NewEconoLab/NeoDun/驱动程序与钱包/neoHardWallet/driver_win/res/back.jpg

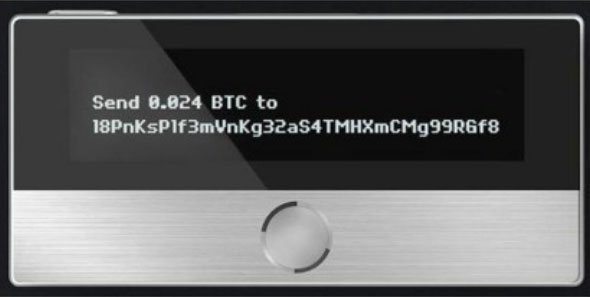
驱动程序与钱包/neoHardWallet/driver_win/res/back.jpg
