NewEconoLab/NeoDun/单片机程序/COIN/NEO/ATSHA204/readme.txt

/****************************************Copyright (c)**************************************************
**文   件   名: readme.txt
**创   建   人: hkh
**最后修改日期: 2018年01月29日
**要点记录：		

		***** 这个工程实现该芯片的普通读写，由于库版本不同，加密读写未实现 *****

一 调试
	①	调试IIC
	②	唤醒设备
	③	设置配置区
	④	写入和读取数据，看是否一致
二 芯片说明
	1  芯片有16个slot，每个slot存放32字节；在config区lock之后，data区（slot区和OTP区）lock之前，
	只能写slot区而不能读。在config区和data区都lock之后，按照config区对于slot区的访问权限进行读写。
	2  wake up成功会收到 04 11 33 43
		其它操作成功会收到 04 00 03 40
	3  锁定后，可以读取Config的0x15区(User Extra)，锁定的值会由0x55变成0x00，表示该区被锁定
	4  config配置区如下:
			0-5  0xCF4F  存放用户私钥和一个PIN码和标识共存的槽
			6-14 0x0000  随意读写区域
			15   0x8F8F  存放加密读写用的私钥			
**修改记录：	
	1、修改software_i2c_quarter_period的实际延时时间为4us
	2、修改初始化函数，加入IIC地址的初始化

/*******************************************************************************************************

				***** 进行加密读写移植记录 *****
时间：2018 03 04
记录：
	1 修改IIC

********************************************************************************************************/
