NewEconoLab/NeoDun/驱动程序与钱包/驱动接口文档.docx

host：127.0.0.1

port:50288

查询硬件钱包是否连接：

地址：http://127.0.0.1:50288/_api/state

请求方式：get

入参：无

出参：{tag:int,count:int,type:string}

tag是回复的消息码

count是连接上的钱包的个数

type是连接上的钱包的类型（现在固定为“hid”）

获取钱包地址列表：

地址：http://127.0.0.1:50288/_api/ HYPERLINK "http://127.0.0.1:50288/_api/listaddress"listaddress

请求方式：get

入参：无

出参：{tag:int,addresses:Array<{type:string,address:string}>}

参数说明： addresses是地址列表 是一个jsonArray

增加地址：

地址：http://127.0.0.1:50288/_api/ HYPERLINK "http://127.0.0.1:50288/_api/addaddress"addaddress

请求方式：post||get

入参：wif:string

出参：{tag:int,msg:string}

参数说明：wif是要加的地址的wif码 KyKvWLZsNwBJx5j9nurHYRwhYfdQUu9tTEDsLCUHDbYBL8cHxMiG

msg是回复的成功还是失败

删除地址：

地址：http://127.0.0.1:50288/_api/ HYPERLINK "http://127.0.0.1:50288/_api/deladdress"deladdress

请求方式：post||get

入参：addresstext:string

出参：{tag:int,msg:string}

参数说明：addresstext是要添加的地址 AVf4UGKevVrMR1j3UkPsuoYKSC4ocoAkKx

msg是回复的成功还是失败

~~获取地址的私钥：~~

~~地址：~~~~http://127.0.0.1:50288/_api/~~ ~~HYPERLINK "http://127.0.0.1:5028~~~~8/_api/addressinfo"add~~ ~~HYPERLINK "http://127.0.0.1:50288/_api/addressinfo"ressinfo~~

~~请求方式：~~~~post||get~~

~~入参：~~~~addresstext:string~~

~~出参：~~~~{tag:int,prikey:string}~~

~~参数说明：~~~~prikey~~~~是返回的私钥~~

签名：

地址：http://127.0.0.1:50288/_api/ HYPERLINK "http://127.0.0.1:50288/_api/sign"sign

请求方式：post||get

入参：data:string ； source:string

出参：{tag:int,srchash:string,signdata:string,pubkey:string}

参数说明：data是交易数据 source是交易发起的地址

srchash是hash过后的交易数据 signdata是签名后的数据

pubkey是公钥

~~密码验证：~~

~~地址：~~~~http://127.0.0.1:50288/_api/comfirmpassword~~

~~请求方式：~~~~post||get~~

~~入参：~~~~password:string~~

~~出参：~~~~{tag:int,msg:string}~~

~~参数说明：~~~~password:~~~~长度为~~~~6~~~~的密码位置~~ ~~msg~~~~是回复的成功还是失败~~

地址命名（暂时仅限英文）
