NewEconoLab/NeoDun/硬件设计/电路设计概览.docx

此文件夹中内容为电路设计与结构设计工程文件。专业性较强，请电子工程师与结构工程师阅读。

以下是一些重要部件型号：

电能计量芯片：CW2015

触摸按键：DS_AW9136

加密芯片：ATSHA204A
