NewEconoLab/NeoDun/硬件设计/电池/252038.pdf

252038

设备 | 1 | 通道 | 4
起始检测时间 | 2017.10.23 11:14:42 | 结束检测时间
检测数据文件名 | E:\分容数据\252038-150_0000_07_4.nda

单位方案
电流 | 电压 | 容量 | 比容量 | 能量 | 比能量 | 内阻 | 温度 | 时间
mA | mV | mAh | mAh/g | mWh | mWh/g | mΩ | ℃ | AUTO

测试信息
起始工步 | 1 上限电压 | - | 电池批号 | - 循环总数 | - | 下限电压 | - | 创建者 | - 记录条件 | 5sec / 0.上限电流 | - | 备注信息
电压量程 | 5V | 下限电流 | - | 上限温度 | - 电流量程 | +3000/-3000mA

工步方案
工步号 | 工步类型 时间(mm:s电压(V) 电流(mA) 容量(mAh)—△V(mV)功率(mW) 负载(mΩ)
1 搁置 | 1:00
2 恒流恒压充电 | 4.2 | 150
3 搁置 | 5:00
4 恒流放电 | 3 | 75
5 搁置 | 10:00
6 恒流恒压充电 | 4 | 150
7 停止

截止电流(mA)

3

3

Cycle
循环序号 | 充电容量 | 放电容量 | 充电比容量 | 放电比容量 | 效率
1 | 18.3 | 160.6 | 18331.6 | 160565.4 | 875.89
2 | 120 | 0 | 120025.3 | 0 | 0

充电能量 | 放电能量 | 中值电压 | 放电电容
76.9 | 610.8 | 3780 | 0
466.4 | 0 | 0 | 0

Step 循环序号 工步序号 工步类型 | 工步时间(H:M:容量 | 比容量 | 能量 1 | 1 搁置 | 0:01:00:000 | 0 | 0 | 0 1 | 2 恒流恒压充电 0:38:16:000 | 18.3 | 18331.6 | 76.9 1 | 3 搁置 | 0:05:00:000 | 0 | 0 | 0 1 | 4 恒流放电 | 2:08:41:000 | 160.6 | 160565.4 | 610.8 1 | 5 搁置 | 0:10:00:000 | 0 | 0 | 0 2 | 6 恒流恒压充电 1:24:13:000 | 120 | 120025.3 | 466.4

比能量 | 充电电容 | 起始电压 | 终止电压 | 起始温度 终止温度
0 | 0 | 4090.4 | 4090.4 | 0 | 0
76895.4 | 18.3 | 4141.5 | 4192 | 0 | 0
0 | 0 | 4191.7 | 4189.9 | 0 | 0
610752.2 | 160.6 | 4165.7 | 2994.7 | 0 | 0
0 | 0 | 3045.3 | 3301 | 0 | 0
466372.2 | 120 | 3365.5 | 3992.1 | 0 | 0

Record
循环序号 工步序号 记录序号 时间(H:M:S:ms) 电压 | 电流 | 温度 | 容量 | 比容量
1 | 1 | 1 0:00:00:000 | 4090.4 | 0 | 0 | 0 | 0
1 | 1 | 2 0:00:05:000 | 4090.4 | 0 | 0 | 0 | 0
1 | 1 | 3 0:00:10:000 | 4090.4 | 0 | 0 | 0 | 0
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
0:000 | 4100.3 | -74.9 | 0 | 7.7 | 7694.1

1 | 4 | 611 0:06:15:000 | 4100 | -74.7 | 0 | 7.8 | 7798.1 1 | 4 | 612 0:06:20:000 | 4099 | -74.9 | 0 | 7.9 | 7902.1 1 | 4 | 613 0:06:25:000 | 4098.7 | -74.9 | 0 | 8 | 8006 1 | 4 | 614 0:06:30:000 | 4098.1 | -74.9 | 0 | 8.1 | 8110.1 1 | 4 | 615 0:06:35:000 | 4097.5 | -74.9 | 0 | 8.2 | 8214 1 | 4 | 616 0:06:40:000 | 4096.9 | -74.9 | 0 | 8.3 | 8318 1 | 4 | 617 0:06:45:000 | 4096.2 | -74.9 | 0 | 8.4 | 8422 1 | 4 | 618 0:06:50:000 | 4095.6 | -74.7 | 0 | 8.5 | 8525.8 1 | 4 | 619 0:06:55:000 | 4095 | -74.9 | 0 | 8.6 | 8629.9 1 | 4 | 620 0:07:00:000 | 4094.4 | -74.9 | 0 | 8.7 | 8733.9 1 | 4 | 621 0:07:05:000 | 4093.8 | -74.9 | 0 | 8.8 | 8837.9 1 | 4 | 622 0:07:10:000 | 4093.1 | -74.9 | 0 | 8.9 | 8941.9 1 | 4 | 623 0:07:15:000 | 4092.5 | -74.9 | 0 | 9 | 9045.9 1 | 4 | 624 0:07:20:000 | 4091.9 | -74.7 | 0 | 9.1 | 9149.7 1 | 4 | 625 0:07:25:000 | 4091 | -74.9 | 0 | 9.3 | 9253.8 1 | 4 | 626 0:07:30:000 | 4090.4 | -74.9 | 0 | 9.4 | 9357.7 1 | 4 | 627 0:07:35:000 | 4090 | -74.9 | 0 | 9.5 | 9461.8 1 | 4 | 628 0:07:40:000 | 4089.1 | -74.9 | 0 | 9.6 | 9565.8 1 | 4 | 629 0:07:45:000 | 4088.5 | -74.7 | 0 | 9.7 | 9669.7 1 | 4 | 630 0:07:50:000 | 4087.9 | -74.9 | 0 | 9.8 | 9773.8 1 | 4 | 631 0:07:55:000 | 4087.6 | -74.9 | 0 | 9.9 | 9877.8 1 | 4 | 632 0:08:00:000 | 4086.9 | -74.9 | 0 | 10 | 9981.8 1 | 4 | 633 0:08:05:000 | 4086.3 | -74.9 | 0 | 10.1 10085.8 1 | 4 | 634 0:08:10:000 | 4085.7 | -74.7 | 0 | 10.2 10189.8 1 | 4 | 635 0:08:15:000 | 4085.1 | -74.9 | 0 | 10.3 10293.7 1 | 4 | 636 0:08:20:000 | 4084.5 | -74.9 | 0 | 10.4 10397.7 1 | 4 | 637 0:08:25:000 | 4084.2 | -74.9 | 0 | 10.5 10501.8 1 | 4 | 638 0:08:30:000 | 4083.5 | -74.9 | 0 | 10.6 10605.7 1 | 4 | 639 0:08:35:000 | 4082.9 | -74.9 | 0 | 10.7 10709.7 1 | 4 | 640 0:08:40:000 | 4082.3 | -74.7 | 0 | 10.8 10813.6 1 | 4 | 641 0:08:45:000 | 4081.7 | -74.9 | 0 | 10.9 10917.6 1 | 4 | 642 0:08:50:000 | 4081.1 | -74.9 | 0 | 11 11021.6 1 | 4 | 643 0:08:55:000 | 4080.4 | -74.9 | 0 | 11.1 11125.6 1 | 4 | 644 0:09:00:000 | 4079.8 | -74.9 | 0 | 11.2 11229.6 1 | 4 | 645 0:09:05:000 | 4079.5 | -74.9 | 0 | 11.3 11333.6 1 | 4 | 646 0:09:10:000 | 4078.9 | -74.7 | 0 | 11.4 11437.5 1 | 4 | 647 0:09:15:000 | 4078.3 | -74.7 | 0 | 11.5 11541.4 1 | 4 | 648 0:09:20:000 | 4077.6 | -74.9 | 0 | 11.6 11645.4 1 | 4 | 649 0:09:25:000 | 4077 | -74.9 | 0 | 11.7 11749.5 1 | 4 | 650 0:09:30:000 | 4076.4 | -74.7 | 0 | 11.9 11853.4 1 | 4 | 651 0:09:35:000 | 4076.1 | -74.7 | 0 | 12 11957.3 1 | 4 | 652 0:09:40:000 | 4075.2 | -74.9 | 0 | 12.1 12061.3 1 | 4 | 653 0:09:45:000 | 4074.5 | -74.9 | 0 | 12.2 12165.2 1 | 4 | 654 0:09:50:000 | 4074.2 | -74.9 | 0 | 12.3 12269.2 1 | 4 | 655 0:09:55:000 | 4073.6 | -74.9 | 0 | 12.4 12373.2 1 | 4 | 656 0:10:00:000 | 4073 | -74.9 | 0 | 12.5 12477.1 1 | 4 | 657 0:10:05:000 | 4072.4 | -74.9 | 0 | 12.6 | 12581 1 | 4 | 658 0:10:10:000 | 4071.4 | -74.9 | 0 | 12.7 12685.1 1 | 4 | 659 0:10:15:000 | 4070.8 | -74.9 | 0 | 12.8 12789.1 1 | 4 | 660 0:10:20:000 | 4070.2 | -74.9 | 0 | 12.9 12892.9 1 | 4 | 661 0:10:25:000 | 4069.6 | -74.9 | 0 | 13 | 12997

1 | 4 | 662 0:10:30:000 | 4069 | -74.7 | 0 | 13.1 13100.9 1 | 4 | 663 0:10:35:000 | 4068.7 | -74.9 | 0 | 13.2 13204.9 1 | 4 | 664 0:10:40:000 | 4068 | -74.9 | 0 | 13.3 13308.9 1 | 4 | 665 0:10:45:000 | 4067.4 | -74.9 | 0 | 13.4 13412.9 1 | 4 | 666 0:10:50:000 | 4066.8 | -74.9 | 0 | 13.5 13516.9 1 | 4 | 667 0:10:55:000 | 4066.2 | -74.7 | 0 | 13.6 13620.8 1 | 4 | 668 0:11:00:000 | 4065.6 | -74.9 | 0 | 13.7 13724.8 1 | 4 | 669 0:11:05:000 | 4065.2 | -74.7 | 0 | 13.8 13828.8 1 | 4 | 670 0:11:10:000 | 4064.6 | -74.9 | 0 | 13.9 13932.8 1 | 4 | 671 0:11:15:000 | 4064 | -74.9 | 0 | 14 14036.8 1 | 4 | 672 0:11:20:000 | 4063.4 | -74.9 | 0 | 14.1 14140.8 1 | 4 | 673 0:11:25:000 | 4062.8 | -74.9 | 0 | 14.2 14244.9 1 | 4 | 674 0:11:30:000 | 4062.1 | -74.9 | 0 | 14.3 14348.9 1 | 4 | 675 0:11:35:000 | 4061.5 | -74.7 | 0 | 14.5 14452.8 1 | 4 | 676 0:11:40:000 | 4060.9 | -74.9 | 0 | 14.6 14556.8 1 | 4 | 677 0:11:45:000 | 4060.6 | -74.9 | 0 | 14.7 14660.8 1 | 4 | 678 0:11:50:000 | 4060 | -74.9 | 0 | 14.8 14764.8 1 | 4 | 679 0:11:55:000 | 4059.3 | -74.9 | 0 | 14.9 14868.9 1 | 4 | 680 0:12:00:000 | 4058.7 | -74.9 | 0 | 15 14972.9 1 | 4 | 681 0:12:05:000 | 4058.1 | -74.9 | 0 | 15.1 15076.9 1 | 4 | 682 0:12:10:000 | 4057.5 | -74.9 | 0 | 15.2 15180.9 1 | 4 | 683 0:12:15:000 | 4057.2 | -74.9 | 0 | 15.3 15284.9 1 | 4 | 684 0:12:20:000 | 4056.6 | -74.9 | 0 | 15.4 15388.9 1 | 4 | 685 0:12:25:000 | 4055.9 | -74.9 | 0 | 15.5 15492.8 1 | 4 | 686 0:12:30:000 | 4055.3 | -74.9 | 0 | 15.6 15596.8 1 | 4 | 687 0:12:35:000 | 4054.7 | -74.9 | 0 | 15.7 15700.8 1 | 4 | 688 0:12:40:000 | 4054.1 | -74.9 | 0 | 15.8 15804.8 1 | 4 | 689 0:12:45:000 | 4053.5 | -74.7 | 0 | 15.9 15908.8 1 | 4 | 690 0:12:50:000 | 4052.8 | -74.9 | 0 | 16 16012.7 1 | 4 | 691 0:12:55:000 | 4052.5 | -74.9 | 0 | 16.1 16116.6 1 | 4 | 692 0:13:00:000 | 4051.6 | -74.7 | 0 | 16.2 16220.6 1 | 4 | 693 0:13:05:000 | 4051 | -74.9 | 0 | 16.3 16324.6 1 | 4 | 694 0:13:10:000 | 4050.4 | -74.9 | 0 | 16.4 16428.7 1 | 4 | 695 0:13:15:000 | 4050 | -74.9 | 0 | 16.5 16532.7 1 | 4 | 696 0:13:20:000 | 4049.4 | -74.9 | 0 | 16.6 16636.6 1 | 4 | 697 0:13:25:000 | 4048.8 | -74.9 | 0 | 16.7 16740.6 1 | 4 | 698 0:13:30:000 | 4048.2 | -74.9 | 0 | 16.8 16844.5 1 | 4 | 699 0:13:35:000 | 4047.6 | -74.7 | 0 | 16.9 16948.4 1 | 4 | 700 0:13:40:000 | 4046.9 | -74.9 | 0 | 17.1 17052.4 1 | 4 | 701 0:13:45:000 | 4046.3 | -74.9 | 0 | 17.2 17156.4 1 | 4 | 702 0:13:50:000 | 4045.7 | -74.9 | 0 | 17.3 17260.4 1 | 4 | 703 0:13:55:000 | 4045.4 | -74.9 | 0 | 17.4 17364.3 1 | 4 | 704 0:14:00:000 | 4044.8 | -74.7 | 0 | 17.5 17468.2 1 | 4 | 705 0:14:05:000 | 4044.2 | -74.9 | 0 | 17.6 17572.1 1 | 4 | 706 0:14:10:000 | 4043.5 | -74.7 | 0 | 17.7 | 17676 1 | 4 | 707 0:14:15:000 | 4042.9 | -74.9 | 0 | 17.8 | 17780 1 | 4 | 708 0:14:20:000 | 4042.6 | -74.9 | 0 | 17.9 | 17884 1 | 4 | 709 0:14:25:000 | 4042 | -74.9 | 0 | 18 17987.9 1 | 4 | 710 0:14:30:000 | 4041.4 | -74.9 | 0 | 18.1 18091.8 1 | 4 | 711 0:14:35:000 | 4040.7 | -74.9 | 0 | 18.2 18195.8 1 | 4 | 712 0:14:40:000 | 4040.1 | -74.9 | 0 | 18.3 18299.7

1 | 4 | 713 0:14:45:000 | 4039.5 | -74.9 | 0 | 18.4 18403.7 1 | 4 | 714 0:14:50:000 | 4039.2 | -74.7 | 0 | 18.5 18507.6 1 | 4 | 715 0:14:55:000 | 4038.6 | -74.7 | 0 | 18.6 18611.6 1 | 4 | 716 0:15:00:000 | 4038 | -74.9 | 0 | 18.7 18715.6 1 | 4 | 717 0:15:05:000 | 4037.3 | -74.9 | 0 | 18.8 18819.6 1 | 4 | 718 0:15:10:000 | 4036.7 | -74.7 | 0 | 18.9 18923.5 1 | 4 | 719 0:15:15:000 | 4036.4 | -74.7 | 0 | 19 19027.3 1 | 4 | 720 0:15:20:000 | 4035.8 | -74.9 | 0 | 19.1 19131.3 1 | 4 | 721 0:15:25:000 | 4035.2 | -74.9 | 0 | 19.2 19235.2 1 | 4 | 722 0:15:30:000 | 4034.5 | -74.9 | 0 | 19.3 19339.3 1 | 4 | 723 0:15:35:000 | 4033.9 | -74.9 | 0 | 19.4 19443.3 1 | 4 | 724 0:15:40:000 | 4033.3 | -74.9 | 0 | 19.5 19547.3 1 | 4 | 725 0:15:45:000 | 4033 | -74.9 | 0 | 19.7 19651.4 1 | 4 | 726 0:15:50:000 | 4032.4 | -74.9 | 0 | 19.8 19755.4 1 | 4 | 727 0:15:55:000 | 4031.8 | -74.9 | 0 | 19.9 19859.3 1 | 4 | 728 0:16:00:000 | 4031.1 | -74.9 | 0 | 20 19963.3 1 | 4 | 729 0:16:05:000 | 4030.5 | -74.9 | 0 | 20.1 20067.3 1 | 4 | 730 0:16:10:000 | 4029.9 | -74.7 | 0 | 20.2 20171.2 1 | 4 | 731 0:16:15:000 | 4029.6 | -74.7 | 0 | 20.3 20274.9 1 | 4 | 732 0:16:20:000 | 4029 | -74.9 | 0 | 20.4 20378.9 1 | 4 | 733 0:16:25:000 | 4028.3 | -74.9 | 0 | 20.5 20482.8 1 | 4 | 734 0:16:30:000 | 4027.7 | -74.7 | 0 | 20.6 20586.7 1 | 4 | 735 0:16:35:000 | 4027.4 | -74.7 | 0 | 20.7 20690.6 1 | 4 | 736 0:16:40:000 | 4026.8 | -74.9 | 0 | 20.8 20794.6 1 | 4 | 737 0:16:45:000 | 4026.2 | -74.9 | 0 | 20.9 20898.5 1 | 4 | 738 0:16:50:000 | 4025.6 | -74.9 | 0 | 21 21002.4 1 | 4 | 739 0:16:55:000 | 4025.2 | -74.9 | 0 | 21.1 21106.4 1 | 4 | 740 0:17:00:000 | 4024.9 | -74.9 | 0 | 21.2 21210.4 1 | 4 | 741 0:17:05:000 | 4024.3 | -74.9 | 0 | 21.3 21314.4 1 | 4 | 742 0:17:10:000 | 4023.7 | -74.9 | 0 | 21.4 21418.3 1 | 4 | 743 0:17:15:000 | 4023.1 | -74.9 | 0 | 21.5 21522.3 1 | 4 | 744 0:17:20:000 | 4022.8 | -74.9 | 0 | 21.6 21626.3 1 | 4 | 745 0:17:25:000 | 4022.1 | -74.9 | 0 | 21.7 21730.2 1 | 4 | 746 0:17:30:000 | 4021.8 | -74.9 | 0 | 21.8 21834.2 1 | 4 | 747 0:17:35:000 | 4021.2 | -74.9 | 0 | 21.9 21938.2 1 | 4 | 748 0:17:40:000 | 4020.6 | -74.9 | 0 | 22 22042.1 1 | 4 | 749 0:17:45:000 | 4020 | -74.7 | 0 | 22.1 22145.9 1 | 4 | 750 0:17:50:000 | 4019.7 | -74.9 | 0 | 22.2 22249.9 1 | 4 | 751 0:17:55:000 | 4019 | -74.7 | 0 | 22.4 22353.7 1 | 4 | 752 0:18:00:000 | 4018.7 | -74.9 | 0 | 22.5 22457.7 1 | 4 | 753 0:18:05:000 | 4018.1 | -74.9 | 0 | 22.6 22561.6 1 | 4 | 754 0:18:10:000 | 4017.5 | -74.9 | 0 | 22.7 22665.5 1 | 4 | 755 0:18:15:000 | 4017.2 | -74.7 | 0 | 22.8 22769.3 1 | 4 | 756 0:18:20:000 | 4016.6 | -74.9 | 0 | 22.9 22873.3 1 | 4 | 757 0:18:25:000 | 4016.3 | -74.7 | 0 | 23 22977.2 1 | 4 | 758 0:18:30:000 | 4015.6 | -74.9 | 0 | 23.1 23081.2 1 | 4 | 759 0:18:35:000 | 4015 | -74.9 | 0 | 23.2 23185.1 1 | 4 | 760 0:18:40:000 | 4014.4 | -74.9 | 0 | 23.3 23289.1 1 | 4 | 761 0:18:45:000 | 4014.1 | -74.9 | 0 | 23.4 | 23393 1 | 4 | 762 0:18:50:000 | 4013.5 | -74.9 | 0 | 23.5 23497.1 1 | 4 | 763 0:18:55:000 | 4013.2 | -74.9 | 0 | 23.6 23600.9

1 | 4 | 764 0:19:00:000 | 4012.5 | -74.7 | 0 | 23.7 23704.8 1 | 4 | 765 0:19:05:000 | 4011.6 | -74.9 | 0 | 23.8 23808.9 1 | 4 | 766 0:19:10:000 | 4011 | -74.9 | 0 | 23.9 23912.9 1 | 4 | 767 0:19:15:000 | 4010.7 | -74.9 | 0 | 24 24016.9 1 | 4 | 768 0:19:20:000 | 4010.1 | -74.7 | 0 | 24.1 24120.9 1 | 4 | 769 0:19:25:000 | 4009.7 | -74.9 | 0 | 24.2 24224.9 1 | 4 | 770 0:19:30:000 | 4009.1 | -74.9 | 0 | 24.3 24328.8 1 | 4 | 771 0:19:35:000 | 4008.5 | -74.9 | 0 | 24.4 24432.8 1 | 4 | 772 0:19:40:000 | 4007.9 | -74.9 | 0 | 24.5 24536.7 1 | 4 | 773 0:19:45:000 | 4007.6 | -74.9 | 0 | 24.6 24640.7 1 | 4 | 774 0:19:50:000 | 4007 | -74.7 | 0 | 24.7 24744.6 1 | 4 | 775 0:19:55:000 | 4006.3 | -74.9 | 0 | 24.8 24848.6 1 | 4 | 776 0:20:00:000 | 4006 | -74.9 | 0 | 25 24952.6 1 | 4 | 777 0:20:05:000 | 4005.4 | -74.9 | 0 | 25.1 25056.6 1 | 4 | 778 0:20:10:000 | 4004.8 | -74.9 | 0 | 25.2 25160.6 1 | 4 | 779 0:20:15:000 | 4004.2 | -74.9 | 0 | 25.3 25264.6 1 | 4 | 780 0:20:20:000 | 4003.5 | -74.7 | 0 | 25.4 25368.5 1 | 4 | 781 0:20:25:000 | 4002.9 | -74.7 | 0 | 25.5 25472.5 1 | 4 | 782 0:20:30:000 | 4002.6 | -74.9 | 0 | 25.6 25576.4 1 | 4 | 783 0:20:35:000 | 4002 | -74.9 | 0 | 25.7 25680.5 1 | 4 | 784 0:20:40:000 | 4001.4 | -74.9 | 0 | 25.8 25784.4 1 | 4 | 785 0:20:45:000 | 4000.8 | -74.9 | 0 | 25.9 25888.4 1 | 4 | 786 0:20:50:000 | 4000.1 | -74.7 | 0 | 26 25992.3 1 | 4 | 787 0:20:55:000 | 3999.8 | -74.7 | 0 | 26.1 26096.2 1 | 4 | 788 0:21:00:000 | 3999.2 | -74.7 | 0 | 26.2 | 26200 1 | 4 | 789 0:21:05:000 | 3998.6 | -74.9 | 0 | 26.3 | 26304 1 | 4 | 790 0:21:10:000 | 3998 | -74.9 | 0 | 26.4 | 26408 1 | 4 | 791 0:21:15:000 | 3997.3 | -74.7 | 0 | 26.5 26511.9 1 | 4 | 792 0:21:20:000 | 3996.7 | -74.9 | 0 | 26.6 26615.9 1 | 4 | 793 0:21:25:000 | 3996.1 | -74.9 | 0 | 26.7 26719.8 1 | 4 | 794 0:21:30:000 | 3995.5 | -74.9 | 0 | 26.8 26823.8 1 | 4 | 795 0:21:35:000 | 3994.9 | -74.9 | 0 | 26.9 26927.8 1 | 4 | 796 0:21:40:000 | 3994.2 | -74.7 | 0 | 27 27031.7 1 | 4 | 797 0:21:45:000 | 3993.6 | -74.9 | 0 | 27.1 27135.7 1 | 4 | 798 0:21:50:000 | 3993 | -74.9 | 0 | 27.2 27239.7 1 | 4 | 799 0:21:55:000 | 3992.1 | -74.9 | 0 | 27.3 27343.7 1 | 4 | 800 0:22:00:000 | 3991.5 | -74.9 | 0 | 27.4 27447.7 1 | 4 | 801 0:22:05:000 | 3990.8 | -74.9 | 0 | 27.6 27551.6 1 | 4 | 802 0:22:10:000 | 3990.5 | -74.9 | 0 | 27.7 27655.7 1 | 4 | 803 0:22:15:000 | 3989.9 | -74.9 | 0 | 27.8 27759.6 1 | 4 | 804 0:22:20:000 | 3989 | -74.9 | 0 | 27.9 27863.7 1 | 4 | 805 0:22:25:000 | 3988.4 | -74.7 | 0 | 28 27967.5 1 | 4 | 806 0:22:30:000 | 3987.7 | -74.7 | 0 | 28.1 28071.4 1 | 4 | 807 0:22:35:000 | 3987.4 | -74.9 | 0 | 28.2 28175.4 1 | 4 | 808 0:22:40:000 | 3986.5 | -74.9 | 0 | 28.3 28279.3 1 | 4 | 809 0:22:45:000 | 3985.9 | -74.9 | 0 | 28.4 28383.3 1 | 4 | 810 0:22:50:000 | 3985.6 | -74.9 | 0 | 28.5 28487.3 1 | 4 | 811 0:22:55:000 | 3984.9 | -74.7 | 0 | 28.6 28591.1 1 | 4 | 812 0:23:00:000 | 3984 | -74.9 | 0 | 28.7 28695.2 1 | 4 | 813 0:23:05:000 | 3983.4 | -74.9 | 0 | 28.8 28799.2 1 | 4 | 814 0:23:10:000 | 3982.8 | -74.9 | 0 | 28.9 28903.2

1 | 4 | 815 0:23:15:000 | 3982.5 | -74.9 | 0 | 29 29007.3 1 | 4 | 816 0:23:20:000 | 3981.5 | -74.9 | 0 | 29.1 29111.3 1 | 4 | 817 0:23:25:000 | 3980.9 | -74.9 | 0 | 29.2 29215.3 1 | 4 | 818 0:23:30:000 | 3980.3 | -74.9 | 0 | 29.3 29319.2 1 | 4 | 819 0:23:35:000 | 3979.7 | -74.9 | 0 | 29.4 29423.2 1 | 4 | 820 0:23:40:000 | 3979.1 | -74.7 | 0 | 29.5 29526.9 1 | 4 | 821 0:23:45:000 | 3978.4 | -74.7 | 0 | 29.6 29630.9 1 | 4 | 822 0:23:50:000 | 3977.8 | -74.7 | 0 | 29.7 29734.8 1 | 4 | 823 0:23:55:000 | 3977.2 | -74.7 | 0 | 29.8 29838.8 1 | 4 | 824 0:24:00:000 | 3976.6 | -74.7 | 0 | 29.9 29942.6 1 | 4 | 825 0:24:05:000 | 3976 | -74.9 | 0 | 30 30046.6 1 | 4 | 826 0:24:10:000 | 3975.3 | -74.7 | 0 | 30.2 30150.4 1 | 4 | 827 0:24:15:000 | 3974.7 | -74.9 | 0 | 30.3 30254.4 1 | 4 | 828 0:24:20:000 | 3974.1 | -74.7 | 0 | 30.4 30358.3 1 | 4 | 829 0:24:25:000 | 3973.5 | -74.9 | 0 | 30.5 30462.3 1 | 4 | 830 0:24:30:000 | 3973.2 | -74.7 | 0 | 30.6 30566.2 1 | 4 | 831 0:24:35:000 | 3971.9 | -74.7 | 0 | 30.7 30670.1 1 | 4 | 832 0:24:40:000 | 3971.3 | -74.7 | 0 | 30.8 30774.1 1 | 4 | 833 0:24:45:000 | 3971 | -74.9 | 0 | 30.9 30878.1 1 | 4 | 834 0:24:50:000 | 3970.4 | -74.9 | 0 | 31 30982.1 1 | 4 | 835 0:24:55:000 | 3969.8 | -74.9 | 0 | 31.1 | 31086 1 | 4 | 836 0:25:00:000 | 3968.8 | -74.9 | 0 | 31.2 31189.9 1 | 4 | 837 0:25:05:000 | 3968.5 | -74.9 | 0 | 31.3 31293.8 1 | 4 | 838 0:25:10:000 | 3967.9 | -74.9 | 0 | 31.4 31397.8 1 | 4 | 839 0:25:15:000 | 3967.3 | -74.9 | 0 | 31.5 31501.8 1 | 4 | 840 0:25:20:000 | 3966.7 | -74.7 | 0 | 31.6 31605.7 1 | 4 | 841 0:25:25:000 | 3966 | -74.9 | 0 | 31.7 31709.6 1 | 4 | 842 0:25:30:000 | 3965.7 | -74.9 | 0 | 31.8 31813.7 1 | 4 | 843 0:25:35:000 | 3965.1 | -74.9 | 0 | 31.9 31917.7 1 | 4 | 844 0:25:40:000 | 3964.5 | -74.9 | 0 | 32 32021.7 1 | 4 | 845 0:25:45:000 | 3963.9 | -74.9 | 0 | 32.1 32125.7 1 | 4 | 846 0:25:50:000 | 3963.2 | -74.9 | 0 | 32.2 32229.8 1 | 4 | 847 0:25:55:000 | 3962.6 | -74.7 | 0 | 32.3 32333.6 1 | 4 | 848 0:26:00:000 | 3962 | -74.9 | 0 | 32.4 32437.6 1 | 4 | 849 0:26:05:000 | 3961.4 | -74.7 | 0 | 32.5 32541.5 1 | 4 | 850 0:26:10:000 | 3961.1 | -74.7 | 0 | 32.6 32645.4 1 | 4 | 851 0:26:15:000 | 3960.5 | -74.7 | 0 | 32.7 32749.3 1 | 4 | 852 0:26:20:000 | 3959.8 | -74.7 | 0 | 32.9 32853.1 1 | 4 | 853 0:26:25:000 | 3959.2 | -74.9 | 0 | 33 32956.9 1 | 4 | 854 0:26:30:000 | 3958.6 | -74.9 | 0 | 33.1 33060.9 1 | 4 | 855 0:26:35:000 | 3958.3 | -74.7 | 0 | 33.2 33164.8 1 | 4 | 856 0:26:40:000 | 3957.7 | -74.7 | 0 | 33.3 33268.6 1 | 4 | 857 0:26:45:000 | 3957 | -74.9 | 0 | 33.4 33372.4 1 | 4 | 858 0:26:50:000 | 3956.4 | -74.9 | 0 | 33.5 33476.3 1 | 4 | 859 0:26:55:000 | 3956.1 | -74.7 | 0 | 33.6 33580.3 1 | 4 | 860 0:27:00:000 | 3955.5 | -74.9 | 0 | 33.7 33684.3 1 | 4 | 861 0:27:05:000 | 3954.9 | -74.9 | 0 | 33.8 33788.2 1 | 4 | 862 0:27:10:000 | 3954.3 | -74.7 | 0 | 33.9 | 33892 1 | 4 | 863 0:27:15:000 | 3953.9 | -74.7 | 0 | 34 33995.9 1 | 4 | 864 0:27:20:000 | 3953.3 | -74.7 | 0 | 34.1 34099.8 1 | 4 | 865 0:27:25:000 | 3952.4 | -74.9 | 0 | 34.2 34203.8

1 | 4 | 866 0:27:30:000 | 3951.8 | -74.7 | 0 | 34.3 34307.7 1 | 4 | 867 0:27:35:000 | 3951.2 | -74.9 | 0 | 34.4 34411.6 1 | 4 | 868 0:27:40:000 | 3951.2 | -74.7 | 0 | 34.5 34515.4 1 | 4 | 869 0:27:45:000 | 3950.5 | -74.9 | 0 | 34.6 34619.4 1 | 4 | 870 0:27:50:000 | 3949.9 | -74.9 | 0 | 34.7 34723.3 1 | 4 | 871 0:27:55:000 | 3949.3 | -74.9 | 0 | 34.8 34827.3 1 | 4 | 872 0:28:00:000 | 3949 | -74.7 | 0 | 34.9 34931.2 1 | 4 | 873 0:28:05:000 | 3948.4 | -74.9 | 0 | 35 35035.3 1 | 4 | 874 0:28:10:000 | 3948.1 | -74.7 | 0 | 35.1 35139.2 1 | 4 | 875 0:28:15:000 | 3947.4 | -74.9 | 0 | 35.2 35243.1 1 | 4 | 876 0:28:20:000 | 3946.8 | -74.9 | 0 | 35.3 35347.1 1 | 4 | 877 0:28:25:000 | 3946.5 | -74.7 | 0 | 35.5 | 35451 1 | 4 | 878 0:28:30:000 | 3945.9 | -74.7 | 0 | 35.6 35554.8 1 | 4 | 879 0:28:35:000 | 3945.6 | -74.7 | 0 | 35.7 35658.7 1 | 4 | 880 0:28:40:000 | 3945 | -74.9 | 0 | 35.8 35762.7 1 | 4 | 881 0:28:45:000 | 3944.6 | -74.9 | 0 | 35.9 35866.5 1 | 4 | 882 0:28:50:000 | 3943.7 | -74.7 | 0 | 36 35970.4 1 | 4 | 883 0:28:55:000 | 3943.4 | -74.9 | 0 | 36.1 36074.3 1 | 4 | 884 0:29:00:000 | 3943.1 | -74.7 | 0 | 36.2 36178.2 1 | 4 | 885 0:29:05:000 | 3942.5 | -74.9 | 0 | 36.3 36282.2 1 | 4 | 886 0:29:10:000 | 3941.9 | -74.9 | 0 | 36.4 36386.2 1 | 4 | 887 0:29:15:000 | 3941.5 | -74.9 | 0 | 36.5 36490.2 1 | 4 | 888 0:29:20:000 | 3941.2 | -74.9 | 0 | 36.6 36594.1 1 | 4 | 889 0:29:25:000 | 3940.6 | -74.7 | 0 | 36.7 | 36698 1 | 4 | 890 0:29:30:000 | 3940 | -74.9 | 0 | 36.8 | 36802 1 | 4 | 891 0:29:35:000 | 3939.7 | -74.9 | 0 | 36.9 | 36906 1 | 4 | 892 0:29:40:000 | 3939.4 | -74.9 | 0 | 37 | 37010 1 | 4 | 893 0:29:45:000 | 3938.8 | -74.9 | 0 | 37.1 37113.9 1 | 4 | 894 0:29:50:000 | 3938.1 | -74.9 | 0 | 37.2 37217.9 1 | 4 | 895 0:29:55:000 | 3937.8 | -74.9 | 0 | 37.3 37321.9 1 | 4 | 896 0:30:00:000 | 3937.5 | -74.9 | 0 | 37.4 37425.9 1 | 4 | 897 0:30:05:000 | 3936.9 | -74.9 | 0 | 37.5 | 37530 1 | 4 | 898 0:30:10:000 | 3936.3 | -74.9 | 0 | 37.6 37633.9 1 | 4 | 899 0:30:15:000 | 3935.7 | -74.9 | 0 | 37.7 | 37738 1 | 4 | 900 0:30:20:000 | 3935.3 | -74.7 | 0 | 37.8 37841.9 1 | 4 | 901 0:30:25:000 | 3935 | -74.9 | 0 | 37.9 37945.9 1 | 4 | 902 0:30:30:000 | 3934.4 | -74.7 | 0 | 38 38049.9 1 | 4 | 903 0:30:35:000 | 3933.8 | -74.9 | 0 | 38.2 38153.9 1 | 4 | 904 0:30:40:000 | 3933.5 | -74.9 | 0 | 38.3 38257.8 1 | 4 | 905 0:30:45:000 | 3932.9 | -74.9 | 0 | 38.4 38361.9 1 | 4 | 906 0:30:50:000 | 3932.2 | -74.9 | 0 | 38.5 38465.8 1 | 4 | 907 0:30:55:000 | 3931.6 | -74.9 | 0 | 38.6 38569.8 1 | 4 | 908 0:31:00:000 | 3931.3 | -74.7 | 0 | 38.7 38673.7 1 | 4 | 909 0:31:05:000 | 3931 | -74.9 | 0 | 38.8 38777.8 1 | 4 | 910 0:31:10:000 | 3930.4 | -74.7 | 0 | 38.9 38881.7 1 | 4 | 911 0:31:15:000 | 3929.8 | -74.9 | 0 | 39 38985.7 1 | 4 | 912 0:31:20:000 | 3929.5 | -74.9 | 0 | 39.1 39089.7 1 | 4 | 913 0:31:25:000 | 3929.1 | -74.9 | 0 | 39.2 39193.7 1 | 4 | 914 0:31:30:000 | 3928.5 | -74.9 | 0 | 39.3 39297.7 1 | 4 | 915 0:31:35:000 | 3927.9 | -74.9 | 0 | 39.4 39401.7 1 | 4 | 916 0:31:40:000 | 3927.6 | -74.9 | 0 | 39.5 39505.7

1 | 4 | 917 0:31:45:000 | 3927.3 | -74.9 | 0 | 39.6 39609.7 1 | 4 | 918 0:31:50:000 | 3926.7 | -74.9 | 0 | 39.7 39713.7 1 | 4 | 919 0:31:55:000 | 3926 | -74.9 | 0 | 39.8 39817.6 1 | 4 | 920 0:32:00:000 | 3925.7 | -74.9 | 0 | 39.9 39921.6 1 | 4 | 921 0:32:05:000 | 3925.4 | -74.9 | 0 | 40 40025.6 1 | 4 | 922 0:32:10:000 | 3924.8 | -74.9 | 0 | 40.1 40129.6 1 | 4 | 923 0:32:15:000 | 3924.5 | -74.9 | 0 | 40.2 40233.6 1 | 4 | 924 0:32:20:000 | 3923.9 | -74.9 | 0 | 40.3 40337.6 1 | 4 | 925 0:32:25:000 | 3923.3 | -74.9 | 0 | 40.4 40441.6 1 | 4 | 926 0:32:30:000 | 3922.9 | -74.9 | 0 | 40.5 40545.6 1 | 4 | 927 0:32:35:000 | 3922.3 | -74.9 | 0 | 40.6 40649.6 1 | 4 | 928 0:32:40:000 | 3922 | -74.7 | 0 | 40.8 40753.4 1 | 4 | 929 0:32:45:000 | 3921.4 | -74.9 | 0 | 40.9 40857.5 1 | 4 | 930 0:32:50:000 | 3921.1 | -74.9 | 0 | 41 40961.5 1 | 4 | 931 0:32:55:000 | 3920.5 | -74.9 | 0 | 41.1 41065.5 1 | 4 | 932 0:33:00:000 | 3920.2 | -74.9 | 0 | 41.2 41169.4 1 | 4 | 933 0:33:05:000 | 3919.8 | -74.9 | 0 | 41.3 41273.5 1 | 4 | 934 0:33:10:000 | 3919.2 | -74.9 | 0 | 41.4 41377.5 1 | 4 | 935 0:33:15:000 | 3918.9 | -74.7 | 0 | 41.5 41481.4 1 | 4 | 936 0:33:20:000 | 3918.3 | -74.9 | 0 | 41.6 41585.4 1 | 4 | 937 0:33:25:000 | 3918 | -74.9 | 0 | 41.7 41689.5 1 | 4 | 938 0:33:30:000 | 3917.4 | -74.9 | 0 | 41.8 41793.5 1 | 4 | 939 0:33:35:000 | 3916.7 | -74.9 | 0 | 41.9 41897.5 1 | 4 | 940 0:33:40:000 | 3916.1 | -74.9 | 0 | 42 42001.5 1 | 4 | 941 0:33:45:000 | 3915.8 | -74.9 | 0 | 42.1 42105.5 1 | 4 | 942 0:33:50:000 | 3915.5 | -74.9 | 0 | 42.2 42209.6 1 | 4 | 943 0:33:55:000 | 3914.9 | -74.9 | 0 | 42.3 42313.5 1 | 4 | 944 0:34:00:000 | 3914.6 | -74.7 | 0 | 42.4 42417.4 1 | 4 | 945 0:34:05:000 | 3914 | -74.9 | 0 | 42.5 42521.5 1 | 4 | 946 0:34:10:000 | 3913.6 | -74.9 | 0 | 42.6 42625.5 1 | 4 | 947 0:34:15:000 | 3912.7 | -74.9 | 0 | 42.7 42729.5 1 | 4 | 948 0:34:20:000 | 3912.4 | -74.9 | 0 | 42.8 42833.6 1 | 4 | 949 0:34:25:000 | 3911.8 | -74.9 | 0 | 42.9 42937.5 1 | 4 | 950 0:34:30:000 | 3911.5 | -74.9 | 0 | 43 43041.6 1 | 4 | 951 0:34:35:000 | 3910.9 | -74.7 | 0 | 43.1 43145.5 1 | 4 | 952 0:34:40:000 | 3910.2 | -74.9 | 0 | 43.2 43249.4 1 | 4 | 953 0:34:45:000 | 3910.2 | -74.9 | 0 | 43.4 43353.4 1 | 4 | 954 0:34:50:000 | 3909.6 | -74.9 | 0 | 43.5 43457.4 1 | 4 | 955 0:34:55:000 | 3909 | -74.7 | 0 | 43.6 43561.4 1 | 4 | 956 0:35:00:000 | 3908.7 | -74.9 | 0 | 43.7 43665.4 1 | 4 | 957 0:35:05:000 | 3908.1 | -74.9 | 0 | 43.8 43769.4 1 | 4 | 958 0:35:10:000 | 3907.8 | -74.9 | 0 | 43.9 43873.4 1 | 4 | 959 0:35:15:000 | 3907.1 | -74.9 | 0 | 44 43977.4 1 | 4 | 960 0:35:20:000 | 3906.8 | -74.9 | 0 | 44.1 44081.4 1 | 4 | 961 0:35:25:000 | 3906.2 | -74.9 | 0 | 44.2 44185.4 1 | 4 | 962 0:35:30:000 | 3905.9 | -74.9 | 0 | 44.3 44289.3 1 | 4 | 963 0:35:35:000 | 3905.3 | -74.9 | 0 | 44.4 44393.3 1 | 4 | 964 0:35:40:000 | 3905 | -74.9 | 0 | 44.5 44497.3 1 | 4 | 965 0:35:45:000 | 3904.3 | -74.7 | 0 | 44.6 44601.2 1 | 4 | 966 0:35:50:000 | 3904 | -74.9 | 0 | 44.7 44705.2 1 | 4 | 967 0:35:55:000 | 3903.4 | -74.7 | 0 | 44.8 44809.1

1 | 4 | 968 0:36:00:000 | 3903.1 | -74.9 | 0 | 44.9 44913.1 1 | 4 | 969 0:36:05:000 | 3902.8 | -74.9 | 0 | 45 45016.9 1 | 4 | 970 0:36:10:000 | 3902.2 | -74.7 | 0 | 45.1 45120.8 1 | 4 | 971 0:36:15:000 | 3901.5 | -74.9 | 0 | 45.2 45224.8 1 | 4 | 972 0:36:20:000 | 3901.2 | -74.9 | 0 | 45.3 45328.8 1 | 4 | 973 0:36:25:000 | 3900.6 | -74.9 | 0 | 45.4 45432.7 1 | 4 | 974 0:36:30:000 | 3900.3 | -74.9 | 0 | 45.5 45536.7 1 | 4 | 975 0:36:35:000 | 3899.7 | -74.9 | 0 | 45.6 45640.7 1 | 4 | 976 0:36:40:000 | 3899.4 | -74.9 | 0 | 45.7 45744.6 1 | 4 | 977 0:36:45:000 | 3898.8 | -74.7 | 0 | 45.8 45848.6 1 | 4 | 978 0:36:50:000 | 3898.4 | -74.9 | 0 | 46 45952.6 1 | 4 | 979 0:36:55:000 | 3897.8 | -74.9 | 0 | 46.1 46056.5 1 | 4 | 980 0:37:00:000 | 3897.5 | -74.9 | 0 | 46.2 46160.6 1 | 4 | 981 0:37:05:000 | 3897.2 | -74.9 | 0 | 46.3 46264.6 1 | 4 | 982 0:37:10:000 | 3896.6 | -74.9 | 0 | 46.4 46368.6 1 | 4 | 983 0:37:15:000 | 3896 | -74.9 | 0 | 46.5 46472.5 1 | 4 | 984 0:37:20:000 | 3895.7 | -74.9 | 0 | 46.6 46576.6 1 | 4 | 985 0:37:25:000 | 3895.3 | -74.9 | 0 | 46.7 46680.6 1 | 4 | 986 0:37:30:000 | 3894.7 | -74.9 | 0 | 46.8 46784.6 1 | 4 | 987 0:37:35:000 | 3894.1 | -74.9 | 0 | 46.9 46888.5 1 | 4 | 988 0:37:40:000 | 3893.8 | -74.9 | 0 | 47 46992.4 1 | 4 | 989 0:37:45:000 | 3893.2 | -74.9 | 0 | 47.1 47096.4 1 | 4 | 990 0:37:50:000 | 3892.6 | -74.7 | 0 | 47.2 47200.3 1 | 4 | 991 0:37:55:000 | 3891.9 | -74.9 | 0 | 47.3 47304.2 1 | 4 | 992 0:38:00:000 | 3891.6 | -74.9 | 0 | 47.4 47408.1 1 | 4 | 993 0:38:05:000 | 3891.3 | -74.9 | 0 | 47.5 47512.1 1 | 4 | 994 0:38:10:000 | 3890.7 | -74.9 | 0 | 47.6 47616.1 1 | 4 | 995 0:38:15:000 | 3890.1 | -74.9 | 0 | 47.7 | 47720 1 | 4 | 996 0:38:20:000 | 3889.8 | -74.7 | 0 | 47.8 47823.9 1 | 4 | 997 0:38:25:000 | 3889.5 | -74.9 | 0 | 47.9 47927.9 1 | 4 | 998 0:38:30:000 | 3888.8 | -74.7 | 0 | 48 48031.8 1 | 4 | 999 0:38:35:000 | 3888.5 | -74.9 | 0 | 48.1 48135.8 1 | 4 | 1000 0:38:40:000 | 3888.2 | -74.9 | 0 | 48.2 48239.7 1 | 4 | 1001 0:38:45:000 | 3887.6 | -74.9 | 0 | 48.3 48343.6 1 | 4 | 1002 0:38:50:000 | 3887.3 | -74.9 | 0 | 48.4 48447.6 1 | 4 | 1003 0:38:55:000 | 3886.7 | -74.9 | 0 | 48.6 48551.5 1 | 4 | 1004 0:39:00:000 | 3886.4 | -74.9 | 0 | 48.7 48655.3 1 | 4 | 1005 0:39:05:000 | 3885.7 | -74.7 | 0 | 48.8 48759.2 1 | 4 | 1006 0:39:10:000 | 3885.4 | -74.9 | 0 | 48.9 48863.2 1 | 4 | 1007 0:39:15:000 | 3885.1 | -74.9 | 0 | 49 48967.2 1 | 4 | 1008 0:39:20:000 | 3884.5 | -74.9 | 0 | 49.1 49071.2 1 | 4 | 1009 0:39:25:000 | 3884.2 | -74.9 | 0 | 49.2 49175.1 1 | 4 | 1010 0:39:30:000 | 3883.6 | -74.7 | 0 | 49.3 | 49279 1 | 4 | 1011 0:39:35:000 | 3883.3 | -74.9 | 0 | 49.4 49382.9 1 | 4 | 1012 0:39:40:000 | 3882.6 | -74.9 | 0 | 49.5 49486.9 1 | 4 | 1013 0:39:45:000 | 3882.3 | -74.9 | 0 | 49.6 49590.9 1 | 4 | 1014 0:39:50:000 | 3882 | -74.9 | 0 | 49.7 49694.8 1 | 4 | 1015 0:39:55:000 | 3881.4 | -74.7 | 0 | 49.8 49798.6 1 | 4 | 1016 0:40:00:000 | 3881.1 | -74.9 | 0 | 49.9 49902.6 1 | 4 | 1017 0:40:05:000 | 3880.8 | -74.9 | 0 | 50 50006.6 1 | 4 | 1018 0:40:10:000 | 3880.2 | -74.7 | 0 | 50.1 50110.4

1 | 4 | 1019 0:40:15:000 | 3879.8 | -74.9 | 0 | 50.2 50214.5 1 | 4 | 1020 0:40:20:000 | 3879.2 | -74.9 | 0 | 50.3 50318.4 1 | 4 | 1021 0:40:25:000 | 3878.9 | -74.9 | 0 | 50.4 50422.4 1 | 4 | 1022 0:40:30:000 | 3878.3 | -74.7 | 0 | 50.5 50526.2 1 | 4 | 1023 0:40:35:000 | 3878 | -74.9 | 0 | 50.6 50630.3 1 | 4 | 1024 0:40:40:000 | 3877.7 | -74.7 | 0 | 50.7 50734.1 1 | 4 | 1025 0:40:45:000 | 3877.1 | -74.9 | 0 | 50.8 50838.1 1 | 4 | 1026 0:40:50:000 | 3876.7 | -74.9 | 0 | 50.9 50942.1 1 | 4 | 1027 0:40:55:000 | 3876.4 | -74.9 | 0 | 51 51046.1 1 | 4 | 1028 0:41:00:000 | 3875.8 | -74.9 | 0 | 51.2 51150.1 1 | 4 | 1029 0:41:05:000 | 3875.5 | -74.9 | 0 | 51.3 51254.1 1 | 4 | 1030 0:41:10:000 | 3874.9 | -74.9 | 0 | 51.4 51358.1 1 | 4 | 1031 0:41:15:000 | 3874.6 | -74.9 | 0 | 51.5 51462.1 1 | 4 | 1032 0:41:20:000 | 3874.3 | -74.9 | 0 | 51.6 | 51566 1 | 4 | 1033 0:41:25:000 | 3874 | -74.9 | 0 | 51.7 | 51670 1 | 4 | 1034 0:41:30:000 | 3873 | -74.9 | 0 | 51.8 51773.9 1 | 4 | 1035 0:41:35:000 | 3872.4 | -74.9 | 0 | 51.9 | 51878 1 | 4 | 1036 0:41:40:000 | 3872.1 | -74.9 | 0 | 52 | 51982 1 | 4 | 1037 0:41:45:000 | 3871.8 | -74.9 | 0 | 52.1 | 52086 1 | 4 | 1038 0:41:50:000 | 3871.5 | -74.9 | 0 | 52.2 52190.1 1 | 4 | 1039 0:41:55:000 | 3870.9 | -74.7 | 0 | 52.3 | 52294 1 | 4 | 1040 0:42:00:000 | 3870.5 | -74.7 | 0 | 52.4 52397.9 1 | 4 | 1041 0:42:05:000 | 3869.9 | -74.9 | 0 | 52.5 52501.9 1 | 4 | 1042 0:42:10:000 | 3869.6 | -74.7 | 0 | 52.6 52605.8 1 | 4 | 1043 0:42:15:000 | 3869.3 | -74.9 | 0 | 52.7 52709.7 1 | 4 | 1044 0:42:20:000 | 3868.7 | -74.9 | 0 | 52.8 52813.7 1 | 4 | 1045 0:42:25:000 | 3868.4 | -74.9 | 0 | 52.9 52917.7 1 | 4 | 1046 0:42:30:000 | 3868.1 | -74.9 | 0 | 53 53021.7 1 | 4 | 1047 0:42:35:000 | 3867.4 | -74.7 | 0 | 53.1 53125.6 1 | 4 | 1048 0:42:40:000 | 3867.1 | -74.9 | 0 | 53.2 53229.7 1 | 4 | 1049 0:42:45:000 | 3866.8 | -74.9 | 0 | 53.3 53333.7 1 | 4 | 1050 0:42:50:000 | 3866.2 | -74.9 | 0 | 53.4 53437.7 1 | 4 | 1051 0:42:55:000 | 3865.9 | -74.9 | 0 | 53.5 53541.6 1 | 4 | 1052 0:43:00:000 | 3865.6 | -74.7 | 0 | 53.6 53645.5 1 | 4 | 1053 0:43:05:000 | 3865 | -74.9 | 0 | 53.7 53749.5 1 | 4 | 1054 0:43:10:000 | 3864.7 | -74.9 | 0 | 53.9 53853.6 1 | 4 | 1055 0:43:15:000 | 3864.3 | -74.9 | 0 | 54 53957.5 1 | 4 | 1056 0:43:20:000 | 3864 | -74.9 | 0 | 54.1 54061.6 1 | 4 | 1057 0:43:25:000 | 3863.4 | -74.9 | 0 | 54.2 54165.5 1 | 4 | 1058 0:43:30:000 | 3863.1 | -74.7 | 0 | 54.3 54269.5 1 | 4 | 1059 0:43:35:000 | 3862.5 | -74.7 | 0 | 54.4 54373.5 1 | 4 | 1060 0:43:40:000 | 3862.2 | -74.7 | 0 | 54.5 54477.4 1 | 4 | 1061 0:43:45:000 | 3861.9 | -74.9 | 0 | 54.6 54581.3 1 | 4 | 1062 0:43:50:000 | 3861.6 | -74.7 | 0 | 54.7 54685.2 1 | 4 | 1063 0:43:55:000 | 3861.2 | -74.9 | 0 | 54.8 54789.2 1 | 4 | 1064 0:44:00:000 | 3860.6 | -74.9 | 0 | 54.9 54893.1 1 | 4 | 1065 0:44:05:000 | 3860.3 | -74.9 | 0 | 55 | 54997 1 | 4 | 1066 0:44:10:000 | 3860 | -74.9 | 0 | 55.1 | 55101 1 | 4 | 1067 0:44:15:000 | 3859.4 | -74.9 | 0 | 55.2 | 55205 1 | 4 | 1068 0:44:20:000 | 3859.1 | -74.7 | 0 | 55.3 55308.8 1 | 4 | 1069 0:44:25:000 | 3858.8 | -74.9 | 0 | 55.4 55412.7

1 | 4 | 1070 0:44:30:000 | 3858.5 | -74.9 | 0 | 55.5 55516.7 1 | 4 | 1071 0:44:35:000 | 3858.1 | -74.9 | 0 | 55.6 55620.8 1 | 4 | 1072 0:44:40:000 | 3857.5 | -74.9 | 0 | 55.7 55724.7 1 | 4 | 1073 0:44:45:000 | 3857.2 | -74.9 | 0 | 55.8 55828.7 1 | 4 | 1074 0:44:50:000 | 3856.9 | -74.9 | 0 | 55.9 55932.7 1 | 4 | 1075 0:44:55:000 | 3856.3 | -74.7 | 0 | 56 56036.6 1 | 4 | 1076 0:45:00:000 | 3856 | -74.7 | 0 | 56.1 56140.4 1 | 4 | 1077 0:45:05:000 | 3855.7 | -74.9 | 0 | 56.2 56244.4 1 | 4 | 1078 0:45:10:000 | 3855.4 | -74.9 | 0 | 56.3 56348.3 1 | 4 | 1079 0:45:15:000 | 3854.7 | -74.9 | 0 | 56.5 56452.3 1 | 4 | 1080 0:45:20:000 | 3854.4 | -74.9 | 0 | 56.6 56556.3 1 | 4 | 1081 0:45:25:000 | 3854.1 | -74.7 | 0 | 56.7 56660.3 1 | 4 | 1082 0:45:30:000 | 3853.5 | -74.9 | 0 | 56.8 56764.2 1 | 4 | 1083 0:45:35:000 | 3852.9 | -74.7 | 0 | 56.9 56868.1 1 | 4 | 1084 0:45:40:000 | 3852.6 | -74.9 | 0 | 57 56972.2 1 | 4 | 1085 0:45:45:000 | 3852.3 | -74.7 | 0 | 57.1 57076.1 1 | 4 | 1086 0:45:50:000 | 3851.9 | -74.7 | 0 | 57.2 | 57180 1 | 4 | 1087 0:45:55:000 | 3851.6 | -74.9 | 0 | 57.3 | 57284 1 | 4 | 1088 0:46:00:000 | 3851 | -74.7 | 0 | 57.4 57387.9 1 | 4 | 1089 0:46:05:000 | 3850.7 | -74.9 | 0 | 57.5 57491.9 1 | 4 | 1090 0:46:10:000 | 3850.4 | -74.7 | 0 | 57.6 57595.9 1 | 4 | 1091 0:46:15:000 | 3850.1 | -74.7 | 0 | 57.7 57699.7 1 | 4 | 1092 0:46:20:000 | 3849.5 | -74.9 | 0 | 57.8 57803.7 1 | 4 | 1093 0:46:25:000 | 3849.2 | -74.9 | 0 | 57.9 57907.6 1 | 4 | 1094 0:46:30:000 | 3848.8 | -74.9 | 0 | 58 58011.6 1 | 4 | 1095 0:46:35:000 | 3848.5 | -74.9 | 0 | 58.1 58115.6 1 | 4 | 1096 0:46:40:000 | 3847.9 | -74.9 | 0 | 58.2 58219.5 1 | 4 | 1097 0:46:45:000 | 3847.6 | -74.9 | 0 | 58.3 58323.5 1 | 4 | 1098 0:46:50:000 | 3847.3 | -74.9 | 0 | 58.4 58427.4 1 | 4 | 1099 0:46:55:000 | 3847 | -74.9 | 0 | 58.5 58531.4 1 | 4 | 1100 0:47:00:000 | 3846.7 | -74.9 | 0 | 58.6 58635.4 1 | 4 | 1101 0:47:05:000 | 3846.1 | -74.9 | 0 | 58.7 58739.4 1 | 4 | 1102 0:47:10:000 | 3845.7 | -74.9 | 0 | 58.8 58843.2 1 | 4 | 1103 0:47:15:000 | 3845.4 | -74.7 | 0 | 58.9 58947.1 1 | 4 | 1104 0:47:20:000 | 3845.1 | -74.9 | 0 | 59.1 | 59051 1 | 4 | 1105 0:47:25:000 | 3844.8 | -74.9 | 0 | 59.2 | 59155 1 | 4 | 1106 0:47:30:000 | 3844.2 | -74.7 | 0 | 59.3 59258.9 1 | 4 | 1107 0:47:35:000 | 3844.2 | -74.9 | 0 | 59.4 59362.9 1 | 4 | 1108 0:47:40:000 | 3843.6 | -74.7 | 0 | 59.5 59466.8 1 | 4 | 1109 0:47:45:000 | 3843.3 | -74.9 | 0 | 59.6 59570.8 1 | 4 | 1110 0:47:50:000 | 3843 | -74.7 | 0 | 59.7 59674.6 1 | 4 | 1111 0:47:55:000 | 3842.3 | -74.7 | 0 | 59.8 59778.5 1 | 4 | 1112 0:48:00:000 | 3842 | -74.7 | 0 | 59.9 59882.4 1 | 4 | 1113 0:48:05:000 | 3841.7 | -74.9 | 0 | 60 59986.4 1 | 4 | 1114 0:48:10:000 | 3841.4 | -74.9 | 0 | 60.1 60090.3 1 | 4 | 1115 0:48:15:000 | 3841.1 | -74.9 | 0 | 60.2 60194.3 1 | 4 | 1116 0:48:20:000 | 3840.8 | -74.9 | 0 | 60.3 60298.2 1 | 4 | 1117 0:48:25:000 | 3840.5 | -74.9 | 0 | 60.4 60402.1 1 | 4 | 1118 0:48:30:000 | 3839.9 | -74.9 | 0 | 60.5 60506.2 1 | 4 | 1119 0:48:35:000 | 3839.5 | -74.9 | 0 | 60.6 60610.2 1 | 4 | 1120 0:48:40:000 | 3839.2 | -74.9 | 0 | 60.7 60714.2

1 | 4 | 1121 0:48:45:000 | 3838.9 | -74.7 | 0 | 60.8 60818.1 1 | 4 | 1122 0:48:50:000 | 3838.6 | -74.9 | 0 | 60.9 60922.1 1 | 4 | 1123 0:48:55:000 | 3838.3 | -74.9 | 0 | 61 61026.1 1 | 4 | 1124 0:49:00:000 | 3838 | -74.9 | 0 | 61.1 61130.1 1 | 4 | 1125 0:49:05:000 | 3837.4 | -74.9 | 0 | 61.2 61234.1 1 | 4 | 1126 0:49:10:000 | 3837.1 | -74.9 | 0 | 61.3 61338.1 1 | 4 | 1127 0:49:15:000 | 3836.8 | -74.9 | 0 | 61.4 61442.1 1 | 4 | 1128 0:49:20:000 | 3836.4 | -74.9 | 0 | 61.5 61546.1 1 | 4 | 1129 0:49:25:000 | 3836.1 | -74.7 | 0 | 61.7 | 61650 1 | 4 | 1130 0:49:30:000 | 3835.5 | -74.9 | 0 | 61.8 61753.9 1 | 4 | 1131 0:49:35:000 | 3835.5 | -74.9 | 0 | 61.9 61857.9 1 | 4 | 1132 0:49:40:000 | 3834.9 | -74.9 | 0 | 62 61961.9 1 | 4 | 1133 0:49:45:000 | 3834.9 | -74.9 | 0 | 62.1 62065.8 1 | 4 | 1134 0:49:50:000 | 3834.3 | -74.9 | 0 | 62.2 62169.8 1 | 4 | 1135 0:49:55:000 | 3833.7 | -74.9 | 0 | 62.3 62273.8 1 | 4 | 1136 0:50:00:000 | 3833.3 | -74.9 | 0 | 62.4 62377.7 1 | 4 | 1137 0:50:05:000 | 3833 | -74.9 | 0 | 62.5 62481.8 1 | 4 | 1138 0:50:10:000 | 3832.7 | -74.9 | 0 | 62.6 62585.8 1 | 4 | 1139 0:50:15:000 | 3832.1 | -74.7 | 0 | 62.7 62689.6 1 | 4 | 1140 0:50:20:000 | 3832.1 | -74.9 | 0 | 62.8 62793.7 1 | 4 | 1141 0:50:25:000 | 3831.5 | -74.9 | 0 | 62.9 62897.6 1 | 4 | 1142 0:50:30:000 | 3831.2 | -74.9 | 0 | 63 63001.7 1 | 4 | 1143 0:50:35:000 | 3830.9 | -74.9 | 0 | 63.1 63105.5 1 | 4 | 1144 0:50:40:000 | 3830.6 | -74.9 | 0 | 63.2 63209.4 1 | 4 | 1145 0:50:45:000 | 3830.2 | -74.9 | 0 | 63.3 63313.4 1 | 4 | 1146 0:50:50:000 | 3829.9 | -74.7 | 0 | 63.4 63417.3 1 | 4 | 1147 0:50:55:000 | 3829.6 | -74.7 | 0 | 63.5 63521.2 1 | 4 | 1148 0:51:00:000 | 3829 | -74.9 | 0 | 63.6 63625.2 1 | 4 | 1149 0:51:05:000 | 3829 | -74.9 | 0 | 63.7 63729.1 1 | 4 | 1150 0:51:10:000 | 3828.4 | -74.9 | 0 | 63.8 63833.1 1 | 4 | 1151 0:51:15:000 | 3828.4 | -74.7 | 0 | 63.9 | 63937 1 | 4 | 1152 0:51:20:000 | 3827.8 | -74.7 | 0 | 64 64040.9 1 | 4 | 1153 0:51:25:000 | 3827.5 | -74.9 | 0 | 64.1 64144.8 1 | 4 | 1154 0:51:30:000 | 3827.1 | -74.9 | 0 | 64.2 64248.8 1 | 4 | 1155 0:51:35:000 | 3826.8 | -74.7 | 0 | 64.4 64352.8 1 | 4 | 1156 0:51:40:000 | 3826.5 | -74.9 | 0 | 64.5 64456.7 1 | 4 | 1157 0:51:45:000 | 3826.2 | -74.7 | 0 | 64.6 64560.6 1 | 4 | 1158 0:51:50:000 | 3825.9 | -74.7 | 0 | 64.7 64664.4 1 | 4 | 1159 0:51:55:000 | 3825.3 | -74.9 | 0 | 64.8 64768.4 1 | 4 | 1160 0:52:00:000 | 3825.3 | -74.9 | 0 | 64.9 64872.4 1 | 4 | 1161 0:52:05:000 | 3824.7 | -74.7 | 0 | 65 64976.2 1 | 4 | 1162 0:52:10:000 | 3824.4 | -74.7 | 0 | 65.1 65080.1 1 | 4 | 1163 0:52:15:000 | 3824 | -74.9 | 0 | 65.2 65184.1 1 | 4 | 1164 0:52:20:000 | 3823.7 | -74.7 | 0 | 65.3 65287.9 1 | 4 | 1165 0:52:25:000 | 3823.4 | -74.9 | 0 | 65.4 65391.9 1 | 4 | 1166 0:52:30:000 | 3823.1 | -74.9 | 0 | 65.5 65495.8 1 | 4 | 1167 0:52:35:000 | 3822.8 | -74.7 | 0 | 65.6 65599.8 1 | 4 | 1168 0:52:40:000 | 3822.5 | -74.9 | 0 | 65.7 65703.7 1 | 4 | 1169 0:52:45:000 | 3822.2 | -74.9 | 0 | 65.8 65807.6 1 | 4 | 1170 0:52:50:000 | 3821.9 | -74.9 | 0 | 65.9 65911.6 1 | 4 | 1171 0:52:55:000 | 3821.6 | -74.7 | 0 | 66 66015.6

1 | 4 | 1172 0:53:00:000 | 3820.9 | -74.9 | 0 | 66.1 66119.6 1 | 4 | 1173 0:53:05:000 | 3820.9 | -74.9 | 0 | 66.2 66223.6 1 | 4 | 1174 0:53:10:000 | 3820.3 | -74.9 | 0 | 66.3 66327.6 1 | 4 | 1175 0:53:15:000 | 3820.3 | -74.7 | 0 | 66.4 66431.5 1 | 4 | 1176 0:53:20:000 | 3819.7 | -74.9 | 0 | 66.5 66535.4 1 | 4 | 1177 0:53:25:000 | 3819.7 | -74.9 | 0 | 66.6 66639.5 1 | 4 | 1178 0:53:30:000 | 3819.1 | -74.9 | 0 | 66.7 66743.5 1 | 4 | 1179 0:53:35:000 | 3818.8 | -74.9 | 0 | 66.8 66847.4 1 | 4 | 1180 0:53:40:000 | 3818.5 | -74.7 | 0 | 67 66951.3 1 | 4 | 1181 0:53:45:000 | 3818.2 | -74.9 | 0 | 67.1 67055.3 1 | 4 | 1182 0:53:50:000 | 3817.8 | -74.9 | 0 | 67.2 67159.3 1 | 4 | 1183 0:53:55:000 | 3817.5 | -74.9 | 0 | 67.3 67263.2 1 | 4 | 1184 0:54:00:000 | 3817.2 | -74.9 | 0 | 67.4 67367.1 1 | 4 | 1185 0:54:05:000 | 3816.9 | -74.9 | 0 | 67.5 67471.1 1 | 4 | 1186 0:54:10:000 | 3816.6 | -74.9 | 0 | 67.6 67575.1 1 | 4 | 1187 0:54:15:000 | 3816.3 | -74.9 | 0 | 67.7 67679.1 1 | 4 | 1188 0:54:20:000 | 3816 | -74.9 | 0 | 67.8 67783.1 1 | 4 | 1189 0:54:25:000 | 3815.7 | -74.7 | 0 | 67.9 67887.1 1 | 4 | 1190 0:54:30:000 | 3815.4 | -74.9 | 0 | 68 67991.1 1 | 4 | 1191 0:54:35:000 | 3815.1 | -74.9 | 0 | 68.1 | 68095 1 | 4 | 1192 0:54:40:000 | 3814.7 | -74.7 | 0 | 68.2 68198.9 1 | 4 | 1193 0:54:45:000 | 3813.8 | -74.9 | 0 | 68.3 | 68303 1 | 4 | 1194 0:54:50:000 | 3813.8 | -74.9 | 0 | 68.4 68406.9 1 | 4 | 1195 0:54:55:000 | 3813.2 | -74.9 | 0 | 68.5 | 68511 1 | 4 | 1196 0:55:00:000 | 3813.2 | -74.7 | 0 | 68.6 68614.9 1 | 4 | 1197 0:55:05:000 | 3812.9 | -74.7 | 0 | 68.7 68718.8 1 | 4 | 1198 0:55:10:000 | 3812.6 | -74.9 | 0 | 68.8 68822.7 1 | 4 | 1199 0:55:15:000 | 3812 | -74.7 | 0 | 68.9 68926.6 1 | 4 | 1200 0:55:20:000 | 3812 | -74.7 | 0 | 69 69030.6 1 | 4 | 1201 0:55:25:000 | 3811.6 | -74.9 | 0 | 69.1 69134.5 1 | 4 | 1202 0:55:30:000 | 3811.3 | -74.7 | 0 | 69.2 69238.4 1 | 4 | 1203 0:55:35:000 | 3811 | -74.9 | 0 | 69.3 69342.4 1 | 4 | 1204 0:55:40:000 | 3810.7 | -74.9 | 0 | 69.4 69446.3 1 | 4 | 1205 0:55:45:000 | 3810.4 | -74.7 | 0 | 69.6 69550.1 1 | 4 | 1206 0:55:50:000 | 3810.1 | -74.9 | 0 | 69.7 69654.2 1 | 4 | 1207 0:55:55:000 | 3809.5 | -74.9 | 0 | 69.8 69758.1 1 | 4 | 1208 0:56:00:000 | 3809.5 | -74.7 | 0 | 69.9 | 69862 1 | 4 | 1209 0:56:05:000 | 3809.2 | -74.9 | 0 | 70 | 69966 1 | 4 | 1210 0:56:10:000 | 3808.9 | -74.7 | 0 | 70.1 70069.9 1 | 4 | 1211 0:56:15:000 | 3808.5 | -74.9 | 0 | 70.2 70173.9 1 | 4 | 1212 0:56:20:000 | 3808.2 | -74.9 | 0 | 70.3 70277.9 1 | 4 | 1213 0:56:25:000 | 3807.6 | -74.9 | 0 | 70.4 70381.9 1 | 4 | 1214 0:56:30:000 | 3807.6 | -74.7 | 0 | 70.5 70485.8 1 | 4 | 1215 0:56:35:000 | 3807 | -74.9 | 0 | 70.6 70589.8 1 | 4 | 1216 0:56:40:000 | 3807 | -74.9 | 0 | 70.7 70693.7 1 | 4 | 1217 0:56:45:000 | 3806.7 | -74.7 | 0 | 70.8 70797.5 1 | 4 | 1218 0:56:50:000 | 3806.4 | -74.9 | 0 | 70.9 70901.5 1 | 4 | 1219 0:56:55:000 | 3806.1 | -74.9 | 0 | 71 71005.4 1 | 4 | 1220 0:57:00:000 | 3805.8 | -74.9 | 0 | 71.1 71109.4 1 | 4 | 1221 0:57:05:000 | 3805.4 | -74.9 | 0 | 71.2 71213.4 1 | 4 | 1222 0:57:10:000 | 3805.1 | -74.9 | 0 | 71.3 71317.4

1 | 4 | 1223 0:57:15:000 | 3804.8 | -74.9 | 0 | 71.4 71421.4 1 | 4 | 1224 0:57:20:000 | 3804.5 | -74.9 | 0 | 71.5 71525.3 1 | 4 | 1225 0:57:25:000 | 3804.2 | -74.7 | 0 | 71.6 71629.2 1 | 4 | 1226 0:57:30:000 | 3803.9 | -74.9 | 0 | 71.7 71733.2 1 | 4 | 1227 0:57:35:000 | 3803.6 | -74.7 | 0 | 71.8 71837.1 1 | 4 | 1228 0:57:40:000 | 3803.3 | -74.9 | 0 | 71.9 | 71941 1 | 4 | 1229 0:57:45:000 | 3803 | -74.7 | 0 | 72 | 72045 1 | 4 | 1230 0:57:50:000 | 3802.7 | -74.9 | 0 | 72.1 | 72149 1 | 4 | 1231 0:57:55:000 | 3802.3 | -74.9 | 0 | 72.3 | 72253 1 | 4 | 1232 0:58:00:000 | 3802 | -74.9 | 0 | 72.4 72356.9 1 | 4 | 1233 0:58:05:000 | 3801.7 | -74.9 | 0 | 72.5 | 72461 1 | 4 | 1234 0:58:10:000 | 3801.4 | -74.9 | 0 | 72.6 72564.9 1 | 4 | 1235 0:58:15:000 | 3801.1 | -74.7 | 0 | 72.7 72668.8 1 | 4 | 1236 0:58:20:000 | 3800.8 | -74.9 | 0 | 72.8 72772.8 1 | 4 | 1237 0:58:25:000 | 3800.5 | -74.7 | 0 | 72.9 72876.7 1 | 4 | 1238 0:58:30:000 | 3800.2 | -74.9 | 0 | 73 72980.7 1 | 4 | 1239 0:58:35:000 | 3800.2 | -74.9 | 0 | 73.1 73084.8 1 | 4 | 1240 0:58:40:000 | 3799.6 | -74.7 | 0 | 73.2 73188.6 1 | 4 | 1241 0:58:45:000 | 3799.6 | -74.9 | 0 | 73.3 73292.6 1 | 4 | 1242 0:58:50:000 | 3798.9 | -74.9 | 0 | 73.4 73396.6 1 | 4 | 1243 0:58:55:000 | 3798.9 | -74.9 | 0 | 73.5 73500.5 1 | 4 | 1244 0:59:00:000 | 3798.3 | -74.9 | 0 | 73.6 73604.6 1 | 4 | 1245 0:59:05:000 | 3798.3 | -74.9 | 0 | 73.7 73708.6 1 | 4 | 1246 0:59:10:000 | 3798 | -74.9 | 0 | 73.8 73812.5 1 | 4 | 1247 0:59:15:000 | 3797.7 | -74.9 | 0 | 73.9 73916.5 1 | 4 | 1248 0:59:20:000 | 3797.4 | -74.9 | 0 | 74 74020.4 1 | 4 | 1249 0:59:25:000 | 3797.1 | -74.9 | 0 | 74.1 74124.4 1 | 4 | 1250 0:59:30:000 | 3796.8 | -74.9 | 0 | 74.2 74228.4 1 | 4 | 1251 0:59:35:000 | 3796.5 | -74.9 | 0 | 74.3 74332.4 1 | 4 | 1252 0:59:40:000 | 3796.1 | -74.9 | 0 | 74.4 74436.4 1 | 4 | 1253 0:59:45:000 | 3795.8 | -74.9 | 0 | 74.5 74540.4 1 | 4 | 1254 0:59:50:000 | 3795.5 | -74.9 | 0 | 74.6 74644.4 1 | 4 | 1255 0:59:55:000 | 3795.2 | -74.9 | 0 | 74.7 74748.4 1 | 4 | 1256 1:00:00:000 | 3794.9 | -74.9 | 0 | 74.9 74852.3 1 | 4 | 1257 1:00:05:000 | 3794.3 | -74.9 | 0 | 75 74956.3 1 | 4 | 1258 1:00:10:000 | 3794.3 | -74.7 | 0 | 75.1 75060.2 1 | 4 | 1259 1:00:15:000 | 3793.7 | -74.7 | 0 | 75.2 75164.1 1 | 4 | 1260 1:00:20:000 | 3793.7 | -74.7 | 0 | 75.3 75268.1 1 | 4 | 1261 1:00:25:000 | 3793 | -74.9 | 0 | 75.4 75372.1 1 | 4 | 1262 1:00:30:000 | 3793 | -74.9 | 0 | 75.5 75476.2 1 | 4 | 1263 1:00:35:000 | 3792.7 | -74.9 | 0 | 75.6 75580.2 1 | 4 | 1264 1:00:40:000 | 3792.4 | -74.9 | 0 | 75.7 75684.2 1 | 4 | 1265 1:00:45:000 | 3792.1 | -74.9 | 0 | 75.8 75788.1 1 | 4 | 1266 1:00:50:000 | 3791.8 | -74.7 | 0 | 75.9 75891.9 1 | 4 | 1267 1:00:55:000 | 3791.5 | -74.9 | 0 | 76 75995.9 1 | 4 | 1268 1:01:00:000 | 3791.2 | -74.9 | 0 | 76.1 76099.9 1 | 4 | 1269 1:01:05:000 | 3790.9 | -74.9 | 0 | 76.2 76203.9 1 | 4 | 1270 1:01:10:000 | 3790.6 | -74.7 | 0 | 76.3 76307.8 1 | 4 | 1271 1:01:15:000 | 3790.6 | -74.7 | 0 | 76.4 76411.6 1 | 4 | 1272 1:01:20:000 | 3789.9 | -74.9 | 0 | 76.5 76515.6 1 | 4 | 1273 1:01:25:000 | 3789.9 | -74.7 | 0 | 76.6 76619.5

1 | 4 | 1274 1:01:30:000 | 3789.3 | -74.7 | 0 | 76.7 76723.4 1 | 4 | 1275 1:01:35:000 | 3789.3 | -74.9 | 0 | 76.8 76827.3 1 | 4 | 1276 1:01:40:000 | 3789 | -74.9 | 0 | 76.9 76931.3 1 | 4 | 1277 1:01:45:000 | 3788.7 | -74.9 | 0 | 77 77035.3 1 | 4 | 1278 1:01:50:000 | 3788.4 | -74.9 | 0 | 77.1 77139.2 1 | 4 | 1279 1:01:55:000 | 3788.1 | -74.9 | 0 | 77.2 77243.1 1 | 4 | 1280 1:02:00:000 | 3788.1 | -74.9 | 0 | 77.3 77347.1 1 | 4 | 1281 1:02:05:000 | 3787.5 | -74.9 | 0 | 77.5 | 77451 1 | 4 | 1282 1:02:10:000 | 3787.2 | -74.7 | 0 | 77.6 77554.9 1 | 4 | 1283 1:02:15:000 | 3786.8 | -74.7 | 0 | 77.7 77658.8 1 | 4 | 1284 1:02:20:000 | 3786.8 | -74.9 | 0 | 77.8 77762.8 1 | 4 | 1285 1:02:25:000 | 3786.5 | -74.9 | 0 | 77.9 77866.8 1 | 4 | 1286 1:02:30:000 | 3786.2 | -74.7 | 0 | 78 77970.7 1 | 4 | 1287 1:02:35:000 | 3785.9 | -74.9 | 0 | 78.1 78074.7 1 | 4 | 1288 1:02:40:000 | 3785.6 | -74.9 | 0 | 78.2 78178.7 1 | 4 | 1289 1:02:45:000 | 3785.6 | -74.9 | 0 | 78.3 78282.6 1 | 4 | 1290 1:02:50:000 | 3785 | -74.9 | 0 | 78.4 78386.6 1 | 4 | 1291 1:02:55:000 | 3784.7 | -74.9 | 0 | 78.5 78490.5 1 | 4 | 1292 1:03:00:000 | 3784.4 | -74.9 | 0 | 78.6 78594.5 1 | 4 | 1293 1:03:05:000 | 3784.4 | -74.9 | 0 | 78.7 78698.5 1 | 4 | 1294 1:03:10:000 | 3783.7 | -74.9 | 0 | 78.8 78802.5 1 | 4 | 1295 1:03:15:000 | 3783.7 | -74.9 | 0 | 78.9 78906.4 1 | 4 | 1296 1:03:20:000 | 3783.4 | -74.9 | 0 | 79 79010.4 1 | 4 | 1297 1:03:25:000 | 3783.1 | -74.9 | 0 | 79.1 79114.5 1 | 4 | 1298 1:03:30:000 | 3782.8 | -74.9 | 0 | 79.2 79218.5 1 | 4 | 1299 1:03:35:000 | 3782.5 | -74.7 | 0 | 79.3 79322.4 1 | 4 | 1300 1:03:40:000 | 3782.2 | -74.9 | 0 | 79.4 79426.4 1 | 4 | 1301 1:03:45:000 | 3781.9 | -74.9 | 0 | 79.5 79530.5 1 | 4 | 1302 1:03:50:000 | 3781.9 | -74.9 | 0 | 79.6 79634.5 1 | 4 | 1303 1:03:55:000 | 3781.6 | -74.7 | 0 | 79.7 79738.4 1 | 4 | 1304 1:04:00:000 | 3781.3 | -74.9 | 0 | 79.8 79842.4 1 | 4 | 1305 1:04:05:000 | 3781 | -74.9 | 0 | 79.9 79946.4 1 | 4 | 1306 1:04:10:000 | 3780.6 | -74.7 | 0 | 80.1 80050.3 1 | 4 | 1307 1:04:15:000 | 3780.3 | -74.9 | 0 | 80.2 80154.3 1 | 4 | 1308 1:04:20:000 | 3780 | -74.9 | 0 | 80.3 80258.3 1 | 4 | 1309 1:04:25:000 | 3780 | -74.9 | 0 | 80.4 80362.2 1 | 4 | 1310 1:04:30:000 | 3779.7 | -74.9 | 0 | 80.5 80466.3 1 | 4 | 1311 1:04:35:000 | 3779.4 | -74.9 | 0 | 80.6 80570.3 1 | 4 | 1312 1:04:40:000 | 3779.1 | -74.9 | 0 | 80.7 80674.2 1 | 4 | 1313 1:04:45:000 | 3778.8 | -74.7 | 0 | 80.8 80778.1 1 | 4 | 1314 1:04:50:000 | 3778.5 | -74.9 | 0 | 80.9 80882.1 1 | 4 | 1315 1:04:55:000 | 3778.2 | -74.9 | 0 | 81 80986.1 1 | 4 | 1316 1:05:00:000 | 3778.2 | -74.9 | 0 | 81.1 81090.1 1 | 4 | 1317 1:05:05:000 | 3777.9 | -74.9 | 0 | 81.2 81194.1 1 | 4 | 1318 1:05:10:000 | 3777.5 | -74.9 | 0 | 81.3 81298.1 1 | 4 | 1319 1:05:15:000 | 3777.2 | -74.9 | 0 | 81.4 81402.1 1 | 4 | 1320 1:05:20:000 | 3776.9 | -74.7 | 0 | 81.5 | 81506 1 | 4 | 1321 1:05:25:000 | 3776.9 | -74.9 | 0 | 81.6 | 81610 1 | 4 | 1322 1:05:30:000 | 3776.3 | -74.9 | 0 | 81.7 81713.9 1 | 4 | 1323 1:05:35:000 | 3776.3 | -74.9 | 0 | 81.8 81817.9 1 | 4 | 1324 1:05:40:000 | 3775.7 | -74.7 | 0 | 81.9 81921.8

1 | 4 | 1325 1:05:45:000 | 3775.7 | -74.7 | 0 | 82 82025.7 1 | 4 | 1326 1:05:50:000 | 3775.4 | -74.9 | 0 | 82.1 82129.7 1 | 4 | 1327 1:05:55:000 | 3775.1 | -74.9 | 0 | 82.2 82233.6 1 | 4 | 1328 1:06:00:000 | 3774.4 | -74.9 | 0 | 82.3 82337.6 1 | 4 | 1329 1:06:05:000 | 3774.1 | -74.9 | 0 | 82.4 82441.5 1 | 4 | 1330 1:06:10:000 | 3774.1 | -74.9 | 0 | 82.5 82545.6 1 | 4 | 1331 1:06:15:000 | 3773.8 | -74.9 | 0 | 82.6 82649.5 1 | 4 | 1332 1:06:20:000 | 3773.5 | -74.9 | 0 | 82.8 82753.5 1 | 4 | 1333 1:06:25:000 | 3773.2 | -74.9 | 0 | 82.9 82857.4 1 | 4 | 1334 1:06:30:000 | 3772.9 | -74.9 | 0 | 83 82961.4 1 | 4 | 1335 1:06:35:000 | 3772.6 | -74.9 | 0 | 83.1 83065.4 1 | 4 | 1336 1:06:40:000 | 3772.3 | -74.7 | 0 | 83.2 83169.3 1 | 4 | 1337 1:06:45:000 | 3772.3 | -74.9 | 0 | 83.3 83273.3 1 | 4 | 1338 1:06:50:000 | 3772 | -74.7 | 0 | 83.4 83377.2 1 | 4 | 1339 1:06:55:000 | 3771.7 | -74.9 | 0 | 83.5 83481.1 1 | 4 | 1340 1:07:00:000 | 3771.3 | -74.9 | 0 | 83.6 83585.2 1 | 4 | 1341 1:07:05:000 | 3771 | -74.9 | 0 | 83.7 83689.2 1 | 4 | 1342 1:07:10:000 | 3771 | -74.9 | 0 | 83.8 83793.2 1 | 4 | 1343 1:07:15:000 | 3770.7 | -74.9 | 0 | 83.9 | 83897 1 | 4 | 1344 1:07:20:000 | 3770.4 | -74.7 | 0 | 84 84000.9 1 | 4 | 1345 1:07:25:000 | 3770.1 | -74.9 | 0 | 84.1 84104.9 1 | 4 | 1346 1:07:30:000 | 3769.8 | -74.7 | 0 | 84.2 84208.8 1 | 4 | 1347 1:07:35:000 | 3769.8 | -74.9 | 0 | 84.3 84312.9 1 | 4 | 1348 1:07:40:000 | 3769.2 | -74.9 | 0 | 84.4 84416.9 1 | 4 | 1349 1:07:45:000 | 3769.2 | -74.9 | 0 | 84.5 84520.9 1 | 4 | 1350 1:07:50:000 | 3768.9 | -74.9 | 0 | 84.6 84624.9 1 | 4 | 1351 1:07:55:000 | 3768.6 | -74.9 | 0 | 84.7 84728.9 1 | 4 | 1352 1:08:00:000 | 3768.6 | -74.9 | 0 | 84.8 84832.9 1 | 4 | 1353 1:08:05:000 | 3767.9 | -74.9 | 0 | 84.9 | 84937 1 | 4 | 1354 1:08:10:000 | 3767.9 | -74.9 | 0 | 85 85040.9 1 | 4 | 1355 1:08:15:000 | 3767.3 | -74.7 | 0 | 85.1 85144.9 1 | 4 | 1356 1:08:20:000 | 3767.3 | -74.9 | 0 | 85.2 85248.9 1 | 4 | 1357 1:08:25:000 | 3767 | -74.9 | 0 | 85.4 85352.9 1 | 4 | 1358 1:08:30:000 | 3766.7 | -74.9 | 0 | 85.5 85456.9 1 | 4 | 1359 1:08:35:000 | 3766.7 | -74.9 | 0 | 85.6 | 85561 1 | 4 | 1360 1:08:40:000 | 3766.1 | -74.9 | 0 | 85.7 | 85665 1 | 4 | 1361 1:08:45:000 | 3766.1 | -74.9 | 0 | 85.8 | 85769 1 | 4 | 1362 1:08:50:000 | 3765.8 | -74.9 | 0 | 85.9 85873.1 1 | 4 | 1363 1:08:55:000 | 3765.5 | -74.9 | 0 | 86 | 85977 1 | 4 | 1364 1:09:00:000 | 3765.5 | -74.9 | 0 | 86.1 86081.1 1 | 4 | 1365 1:09:05:000 | 3765.1 | -74.9 | 0 | 86.2 86185.1 1 | 4 | 1366 1:09:10:000 | 3764.8 | -74.9 | 0 | 86.3 86289.1 1 | 4 | 1367 1:09:15:000 | 3764.5 | -74.7 | 0 | 86.4 | 86393 1 | 4 | 1368 1:09:20:000 | 3764.2 | -74.7 | 0 | 86.5 | 86497 1 | 4 | 1369 1:09:25:000 | 3764.2 | -74.9 | 0 | 86.6 | 86601 1 | 4 | 1370 1:09:30:000 | 3763.9 | -74.9 | 0 | 86.7 86705.1 1 | 4 | 1371 1:09:35:000 | 3763.6 | -74.9 | 0 | 86.8 | 86809 1 | 4 | 1372 1:09:40:000 | 3763.3 | -74.9 | 0 | 86.9 86913.1 1 | 4 | 1373 1:09:45:000 | 3763 | -74.9 | 0 | 87 87017.1 1 | 4 | 1374 1:09:50:000 | 3763 | -74.9 | 0 | 87.1 87121.1 1 | 4 | 1375 1:09:55:000 | 3762.4 | -74.9 | 0 | 87.2 87225.1

1 | 4 | 1376 1:10:00:000 | 3762.4 | -74.9 | 0 | 87.3 87329.2 1 | 4 | 1377 1:10:05:000 | 3762 | -74.9 | 0 | 87.4 87433.2 1 | 4 | 1378 1:10:10:000 | 3761.7 | -74.9 | 0 | 87.5 87537.2 1 | 4 | 1379 1:10:15:000 | 3761.7 | -74.9 | 0 | 87.6 87641.3 1 | 4 | 1380 1:10:20:000 | 3761.1 | -74.9 | 0 | 87.7 87745.3 1 | 4 | 1381 1:10:25:000 | 3761.1 | -74.9 | 0 | 87.8 87849.3 1 | 4 | 1382 1:10:30:000 | 3760.8 | -74.7 | 0 | 88 87953.2 1 | 4 | 1383 1:10:35:000 | 3760.5 | -74.9 | 0 | 88.1 88057.2 1 | 4 | 1384 1:10:40:000 | 3760.2 | -74.7 | 0 | 88.2 88161.1 1 | 4 | 1385 1:10:45:000 | 3760.2 | -74.9 | 0 | 88.3 88264.9 1 | 4 | 1386 1:10:50:000 | 3759.9 | -74.9 | 0 | 88.4 88368.9 1 | 4 | 1387 1:10:55:000 | 3759.6 | -74.7 | 0 | 88.5 88472.9 1 | 4 | 1388 1:11:00:000 | 3759.3 | -74.7 | 0 | 88.6 88576.8 1 | 4 | 1389 1:11:05:000 | 3758.9 | -74.9 | 0 | 88.7 88680.8 1 | 4 | 1390 1:11:10:000 | 3758.9 | -74.9 | 0 | 88.8 88784.7 1 | 4 | 1391 1:11:15:000 | 3758.6 | -74.9 | 0 | 88.9 88888.8 1 | 4 | 1392 1:11:20:000 | 3758.3 | -74.9 | 0 | 89 88992.8 1 | 4 | 1393 1:11:25:000 | 3758 | -74.7 | 0 | 89.1 89096.7 1 | 4 | 1394 1:11:30:000 | 3758 | -74.9 | 0 | 89.2 89200.7 1 | 4 | 1395 1:11:35:000 | 3757.7 | -74.9 | 0 | 89.3 89304.8 1 | 4 | 1396 1:11:40:000 | 3757.4 | -74.9 | 0 | 89.4 89408.8 1 | 4 | 1397 1:11:45:000 | 3757.1 | -74.9 | 0 | 89.5 89512.8 1 | 4 | 1398 1:11:50:000 | 3756.8 | -74.9 | 0 | 89.6 89616.8 1 | 4 | 1399 1:11:55:000 | 3756.8 | -74.9 | 0 | 89.7 89720.9 1 | 4 | 1400 1:12:00:000 | 3756.5 | -74.9 | 0 | 89.8 89824.9 1 | 4 | 1401 1:12:05:000 | 3756.2 | -74.9 | 0 | 89.9 89928.9 1 | 4 | 1402 1:12:10:000 | 3755.8 | -74.9 | 0 | 90 90032.9 1 | 4 | 1403 1:12:15:000 | 3755.5 | -74.9 | 0 | 90.1 90136.9 1 | 4 | 1404 1:12:20:000 | 3755.5 | -74.9 | 0 | 90.2 90240.9 1 | 4 | 1405 1:12:25:000 | 3755.2 | -74.9 | 0 | 90.3 90344.9 1 | 4 | 1406 1:12:30:000 | 3754.6 | -74.9 | 0 | 90.4 90448.9 1 | 4 | 1407 1:12:35:000 | 3754.6 | -74.9 | 0 | 90.6 90552.9 1 | 4 | 1408 1:12:40:000 | 3754.3 | -74.9 | 0 | 90.7 90656.9 1 | 4 | 1409 1:12:45:000 | 3754 | -74.9 | 0 | 90.8 90760.9 1 | 4 | 1410 1:12:50:000 | 3753.7 | -74.9 | 0 | 90.9 90864.9 1 | 4 | 1411 1:12:55:000 | 3753.4 | -74.9 | 0 | 91 | 90969 1 | 4 | 1412 1:13:00:000 | 3753.4 | -74.9 | 0 | 91.1 | 91073 1 | 4 | 1413 1:13:05:000 | 3753.1 | -74.9 | 0 | 91.2 | 91177 1 | 4 | 1414 1:13:10:000 | 3752.7 | -74.9 | 0 | 91.3 91281.1 1 | 4 | 1415 1:13:15:000 | 3752.4 | -74.7 | 0 | 91.4 | 91385 1 | 4 | 1416 1:13:20:000 | 3752.4 | -74.9 | 0 | 91.5 | 91489 1 | 4 | 1417 1:13:25:000 | 3752.1 | -74.9 | 0 | 91.6 91592.9 1 | 4 | 1418 1:13:30:000 | 3751.8 | -74.9 | 0 | 91.7 91696.9 1 | 4 | 1419 1:13:35:000 | 3751.5 | -74.9 | 0 | 91.8 91800.9 1 | 4 | 1420 1:13:40:000 | 3751.5 | -74.9 | 0 | 91.9 91904.9 1 | 4 | 1421 1:13:45:000 | 3751.2 | -74.9 | 0 | 92 92008.9 1 | 4 | 1422 1:13:50:000 | 3750.9 | -74.9 | 0 | 92.1 92112.9 1 | 4 | 1423 1:13:55:000 | 3750.9 | -74.7 | 0 | 92.2 92216.9 1 | 4 | 1424 1:14:00:000 | 3750.3 | -74.9 | 0 | 92.3 92320.9 1 | 4 | 1425 1:14:05:000 | 3750.3 | -74.9 | 0 | 92.4 92424.9 1 | 4 | 1426 1:14:10:000 | 3750 | -74.9 | 0 | 92.5 92528.8

1 | 4 | 1427 1:14:15:000 | 3749.6 | -74.7 | 0 | 92.6 92632.7 1 | 4 | 1428 1:14:20:000 | 3749.6 | -74.9 | 0 | 92.7 92736.7 1 | 4 | 1429 1:14:25:000 | 3749.3 | -74.9 | 0 | 92.8 92840.7 1 | 4 | 1430 1:14:30:000 | 3749 | -74.9 | 0 | 92.9 92944.7 1 | 4 | 1431 1:14:35:000 | 3748.7 | -74.7 | 0 | 93 93048.6 1 | 4 | 1432 1:14:40:000 | 3748.4 | -74.9 | 0 | 93.2 93152.6 1 | 4 | 1433 1:14:45:000 | 3748.4 | -74.9 | 0 | 93.3 93256.6 1 | 4 | 1434 1:14:50:000 | 3748.1 | -74.9 | 0 | 93.4 93360.7 1 | 4 | 1435 1:14:55:000 | 3747.8 | -74.9 | 0 | 93.5 93464.7 1 | 4 | 1436 1:15:00:000 | 3747.8 | -74.9 | 0 | 93.6 93568.6 1 | 4 | 1437 1:15:05:000 | 3747.5 | -74.9 | 0 | 93.7 93672.6 1 | 4 | 1438 1:15:10:000 | 3747.2 | -74.9 | 0 | 93.8 93776.7 1 | 4 | 1439 1:15:15:000 | 3746.8 | -74.9 | 0 | 93.9 93880.7 1 | 4 | 1440 1:15:20:000 | 3746.5 | -74.9 | 0 | 94 93984.7 1 | 4 | 1441 1:15:25:000 | 3746.5 | -74.9 | 0 | 94.1 94088.8 1 | 4 | 1442 1:15:30:000 | 3746.2 | -74.9 | 0 | 94.2 94192.8 1 | 4 | 1443 1:15:35:000 | 3745.9 | -74.9 | 0 | 94.3 94296.8 1 | 4 | 1444 1:15:40:000 | 3745.9 | -74.9 | 0 | 94.4 94400.8 1 | 4 | 1445 1:15:45:000 | 3745.6 | -74.9 | 0 | 94.5 94504.8 1 | 4 | 1446 1:15:50:000 | 3745.3 | -74.9 | 0 | 94.6 94608.8 1 | 4 | 1447 1:15:55:000 | 3745 | -74.9 | 0 | 94.7 94712.8 1 | 4 | 1448 1:16:00:000 | 3744.7 | -74.9 | 0 | 94.8 94816.8 1 | 4 | 1449 1:16:05:000 | 3744.7 | -74.9 | 0 | 94.9 94920.9 1 | 4 | 1450 1:16:10:000 | 3744.4 | -74.9 | 0 | 95 95024.9 1 | 4 | 1451 1:16:15:000 | 3744.1 | -74.9 | 0 | 95.1 95128.9 1 | 4 | 1452 1:16:20:000 | 3744.1 | -74.7 | 0 | 95.2 95232.9 1 | 4 | 1453 1:16:25:000 | 3743.7 | -74.9 | 0 | 95.3 95336.9 1 | 4 | 1454 1:16:30:000 | 3743.4 | -74.9 | 0 | 95.4 95440.9 1 | 4 | 1455 1:16:35:000 | 3743.1 | -74.9 | 0 | 95.5 95544.9 1 | 4 | 1456 1:16:40:000 | 3743.1 | -74.9 | 0 | 95.6 95648.8 1 | 4 | 1457 1:16:45:000 | 3742.8 | -74.9 | 0 | 95.8 95752.7 1 | 4 | 1458 1:16:50:000 | 3742.5 | -74.7 | 0 | 95.9 95856.7 1 | 4 | 1459 1:16:55:000 | 3742.2 | -74.9 | 0 | 96 95960.7 1 | 4 | 1460 1:17:00:000 | 3742.2 | -74.9 | 0 | 96.1 96064.7 1 | 4 | 1461 1:17:05:000 | 3741.9 | -74.9 | 0 | 96.2 96168.6 1 | 4 | 1462 1:17:10:000 | 3741.6 | -74.9 | 0 | 96.3 96272.7 1 | 4 | 1463 1:17:15:000 | 3741.6 | -74.9 | 0 | 96.4 96376.7 1 | 4 | 1464 1:17:20:000 | 3741.3 | -74.9 | 0 | 96.5 96480.7 1 | 4 | 1465 1:17:25:000 | 3741 | -74.9 | 0 | 96.6 96584.7 1 | 4 | 1466 1:17:30:000 | 3741 | -74.9 | 0 | 96.7 96688.7 1 | 4 | 1467 1:17:35:000 | 3740.6 | -74.9 | 0 | 96.8 96792.7 1 | 4 | 1468 1:17:40:000 | 3740.3 | -74.9 | 0 | 96.9 96896.7 1 | 4 | 1469 1:17:45:000 | 3740 | -74.9 | 0 | 97 97000.6 1 | 4 | 1470 1:17:50:000 | 3740 | -74.9 | 0 | 97.1 97104.6 1 | 4 | 1471 1:17:55:000 | 3739.7 | -74.7 | 0 | 97.2 97208.5 1 | 4 | 1472 1:18:00:000 | 3739.4 | -74.9 | 0 | 97.3 97312.4 1 | 4 | 1473 1:18:05:000 | 3739.1 | -74.9 | 0 | 97.4 97416.3 1 | 4 | 1474 1:18:10:000 | 3739.1 | -74.9 | 0 | 97.5 97520.3 1 | 4 | 1475 1:18:15:000 | 3738.8 | -74.9 | 0 | 97.6 97624.4 1 | 4 | 1476 1:18:20:000 | 3738.5 | -74.9 | 0 | 97.7 97728.3 1 | 4 | 1477 1:18:25:000 | 3738.5 | -74.9 | 0 | 97.8 97832.3

1 | 4 | 1478 1:18:30:000 | 3738.2 | -74.7 | 0 | 97.9 97936.2 1 | 4 | 1479 1:18:35:000 | 3737.9 | -74.9 | 0 | 98 98040.2 1 | 4 | 1480 1:18:40:000 | 3737.5 | -74.9 | 0 | 98.1 98144.2 1 | 4 | 1481 1:18:45:000 | 3737.5 | -74.9 | 0 | 98.2 98248.2 1 | 4 | 1482 1:18:50:000 | 3737.2 | -74.9 | 0 | 98.4 98352.2 1 | 4 | 1483 1:18:55:000 | 3736.9 | -74.9 | 0 | 98.5 98456.2 1 | 4 | 1484 1:19:00:000 | 3736.6 | -74.9 | 0 | 98.6 98560.1 1 | 4 | 1485 1:19:05:000 | 3736.6 | -74.7 | 0 | 98.7 | 98664 1 | 4 | 1486 1:19:10:000 | 3736.3 | -74.9 | 0 | 98.8 | 98768 1 | 4 | 1487 1:19:15:000 | 3736 | -74.9 | 0 | 98.9 | 98872 1 | 4 | 1488 1:19:20:000 | 3736 | -74.9 | 0 | 99 98975.9 1 | 4 | 1489 1:19:25:000 | 3735.7 | -74.7 | 0 | 99.1 99079.8 1 | 4 | 1490 1:19:30:000 | 3735.4 | -74.9 | 0 | 99.2 99183.8 1 | 4 | 1491 1:19:35:000 | 3735.4 | -74.9 | 0 | 99.3 99287.8 1 | 4 | 1492 1:19:40:000 | 3734.8 | -74.9 | 0 | 99.4 99391.8 1 | 4 | 1493 1:19:45:000 | 3734.4 | -74.9 | 0 | 99.5 99495.9 1 | 4 | 1494 1:19:50:000 | 3734.1 | -74.9 | 0 | 99.6 99599.7 1 | 4 | 1495 1:19:55:000 | 3734.1 | -74.9 | 0 | 99.7 99703.8 1 | 4 | 1496 1:20:00:000 | 3733.8 | -74.9 | 0 | 99.8 99807.8 1 | 4 | 1497 1:20:05:000 | 3733.5 | -74.9 | 0 | 99.9 99911.8 1 | 4 | 1498 1:20:10:000 | 3733.5 | -74.9 | 0 | 100 | 100016 1 | 4 | 1499 1:20:15:000 | 3733.2 | -74.7 | 0 | 100.1 | 100120 1 | 4 | 1500 1:20:20:000 | 3732.9 | -74.9 | 0 | 100.2 | 100224 1 | 4 | 1501 1:20:25:000 | 3732.6 | -74.9 | 0 | 100.3 | 100328 1 | 4 | 1502 1:20:30:000 | 3732.6 | -74.9 | 0 | 100.4 | 100432 1 | 4 | 1503 1:20:35:000 | 3732.3 | -74.9 | 0 | 100.5 | 100536 1 | 4 | 1504 1:20:40:000 | 3732 | -74.9 | 0 | 100.6 | 100640 1 | 4 | 1505 1:20:45:000 | 3731.7 | -74.9 | 0 | 100.7 | 100744 1 | 4 | 1506 1:20:50:000 | 3731.7 | -74.9 | 0 | 100.8 | 100848 1 | 4 | 1507 1:20:55:000 | 3731.3 | -74.9 | 0 | 101 | 100952 1 | 4 | 1508 1:21:00:000 | 3731.3 | -74.9 | 0 | 101.1 | 101056 1 | 4 | 1509 1:21:05:000 | 3731 | -74.9 | 0 | 101.2 | 101160 1 | 4 | 1510 1:21:10:000 | 3730.7 | -74.9 | 0 | 101.3 | 101264 1 | 4 | 1511 1:21:15:000 | 3730.7 | -74.9 | 0 | 101.4 | 101368 1 | 4 | 1512 1:21:20:000 | 3730.4 | -74.9 | 0 | 101.5 | 101472 1 | 4 | 1513 1:21:25:000 | 3730.1 | -74.9 | 0 | 101.6 | 101576 1 | 4 | 1514 1:21:30:000 | 3729.8 | -74.9 | 0 | 101.7 | 101680 1 | 4 | 1515 1:21:35:000 | 3729.8 | -74.9 | 0 | 101.8 | 101784 1 | 4 | 1516 1:21:40:000 | 3729.5 | -74.9 | 0 | 101.9 | 101888 1 | 4 | 1517 1:21:45:000 | 3729.5 | -74.9 | 0 | 102 | 101992 1 | 4 | 1518 1:21:50:000 | 3728.9 | -74.9 | 0 | 102.1 | 102096 1 | 4 | 1519 1:21:55:000 | 3728.9 | -74.9 | 0 | 102.2 | 102200 1 | 4 | 1520 1:22:00:000 | 3728.6 | -74.9 | 0 | 102.3 | 102304 1 | 4 | 1521 1:22:05:000 | 3728.6 | -74.9 | 0 | 102.4 | 102408 1 | 4 | 1522 1:22:10:000 | 3728.2 | -74.9 | 0 | 102.5 | 102512 1 | 4 | 1523 1:22:15:000 | 3728.2 | -74.9 | 0 | 102.6 | 102616 1 | 4 | 1524 1:22:20:000 | 3727.6 | -74.9 | 0 | 102.7 | 102720 1 | 4 | 1525 1:22:25:000 | 3727.6 | -74.9 | 0 | 102.8 | 102824 1 | 4 | 1526 1:22:30:000 | 3727.3 | -74.9 | 0 | 102.9 | 102928 1 | 4 | 1527 1:22:35:000 | 3727 | -74.9 | 0 | 103 | 103032 1 | 4 | 1528 1:22:40:000 | 3727 | -74.9 | 0 | 103.1 | 103136

1 | 4 | 1529 1:22:45:000 | 3726.7 | -74.9 | 0 | 103.2 | 103240 1 | 4 | 1530 1:22:50:000 | 3726.4 | -74.9 | 0 | 103.3 | 103344 1 | 4 | 1531 1:22:55:000 | 3726.4 | -74.9 | 0 | 103.4 | 103448 1 | 4 | 1532 1:23:00:000 | 3726.1 | -74.9 | 0 | 103.6 | 103552 1 | 4 | 1533 1:23:05:000 | 3725.8 | -74.9 | 0 | 103.7 | 103656 1 | 4 | 1534 1:23:10:000 | 3725.5 | -74.9 | 0 | 103.8 | 103760 1 | 4 | 1535 1:23:15:000 | 3725.5 | -74.9 | 0 | 103.9 | 103864 1 | 4 | 1536 1:23:20:000 | 3725.5 | -74.9 | 0 | 104 | 103968 1 | 4 | 1537 1:23:25:000 | 3725.1 | -74.9 | 0 | 104.1 | 104072 1 | 4 | 1538 1:23:30:000 | 3724.8 | -74.9 | 0 | 104.2 | 104176 1 | 4 | 1539 1:23:35:000 | 3724.5 | -74.9 | 0 | 104.3 | 104280 1 | 4 | 1540 1:23:40:000 | 3724.5 | -74.9 | 0 | 104.4 | 104384 1 | 4 | 1541 1:23:45:000 | 3723.9 | -74.9 | 0 | 104.5 | 104488 1 | 4 | 1542 1:23:50:000 | 3723.9 | -74.9 | 0 | 104.6 | 104592 1 | 4 | 1543 1:23:55:000 | 3723.9 | -74.9 | 0 | 104.7 | 104696 1 | 4 | 1544 1:24:00:000 | 3723.6 | -74.9 | 0 | 104.8 | 104800 1 | 4 | 1545 1:24:05:000 | 3723.3 | -74.9 | 0 | 104.9 | 104904 1 | 4 | 1546 1:24:10:000 | 3723.3 | -74.9 | 0 | 105 | 105008 1 | 4 | 1547 1:24:15:000 | 3723 | -74.9 | 0 | 105.1 | 105112 1 | 4 | 1548 1:24:20:000 | 3722.7 | -74.9 | 0 | 105.2 | 105216 1 | 4 | 1549 1:24:25:000 | 3722.7 | -74.9 | 0 | 105.3 | 105320 1 | 4 | 1550 1:24:30:000 | 3722.4 | -74.7 | 0 | 105.4 | 105424 1 | 4 | 1551 1:24:35:000 | 3722 | -74.9 | 0 | 105.5 | 105528 1 | 4 | 1552 1:24:40:000 | 3722 | -74.9 | 0 | 105.6 | 105632 1 | 4 | 1553 1:24:45:000 | 3721.7 | -74.7 | 0 | 105.7 | 105736 1 | 4 | 1554 1:24:50:000 | 3721.4 | -74.7 | 0 | 105.8 | 105840 1 | 4 | 1555 1:24:55:000 | 3721.1 | -74.9 | 0 | 105.9 | 105944 1 | 4 | 1556 1:25:00:000 | 3721.1 | -74.9 | 0 | 106 | 106048 1 | 4 | 1557 1:25:05:000 | 3720.8 | -74.9 | 0 | 106.2 | 106152 1 | 4 | 1558 1:25:10:000 | 3720.8 | -74.9 | 0 | 106.3 | 106256 1 | 4 | 1559 1:25:15:000 | 3720.5 | -74.9 | 0 | 106.4 | 106360 1 | 4 | 1560 1:25:20:000 | 3720.2 | -74.9 | 0 | 106.5 | 106464 1 | 4 | 1561 1:25:25:000 | 3720.2 | -74.9 | 0 | 106.6 | 106568 1 | 4 | 1562 1:25:30:000 | 3719.9 | -74.9 | 0 | 106.7 | 106672 1 | 4 | 1563 1:25:35:000 | 3719.6 | -74.9 | 0 | 106.8 | 106776 1 | 4 | 1564 1:25:40:000 | 3719.6 | -74.9 | 0 | 106.9 | 106880 1 | 4 | 1565 1:25:45:000 | 3719.3 | -74.9 | 0 | 107 | 106984 1 | 4 | 1566 1:25:50:000 | 3718.9 | -74.9 | 0 | 107.1 | 107088 1 | 4 | 1567 1:25:55:000 | 3718.9 | -74.9 | 0 | 107.2 | 107192 1 | 4 | 1568 1:26:00:000 | 3718.6 | -74.9 | 0 | 107.3 | 107296 1 | 4 | 1569 1:26:05:000 | 3718.3 | -74.9 | 0 | 107.4 | 107400 1 | 4 | 1570 1:26:10:000 | 3718.3 | -74.9 | 0 | 107.5 | 107504 1 | 4 | 1571 1:26:15:000 | 3718 | -74.9 | 0 | 107.6 | 107608 1 | 4 | 1572 1:26:20:000 | 3717.7 | -74.9 | 0 | 107.7 | 107712 1 | 4 | 1573 1:26:25:000 | 3717.7 | -74.9 | 0 | 107.8 | 107816 1 | 4 | 1574 1:26:30:000 | 3717.4 | -74.9 | 0 | 107.9 | 107920 1 | 4 | 1575 1:26:35:000 | 3717.1 | -74.9 | 0 | 108 | 108024 1 | 4 | 1576 1:26:40:000 | 3717.1 | -74.9 | 0 | 108.1 | 108128 1 | 4 | 1577 1:26:45:000 | 3716.8 | -74.9 | 0 | 108.2 | 108232 1 | 4 | 1578 1:26:50:000 | 3716.5 | -74.9 | 0 | 108.3 | 108336 1 | 4 | 1579 1:26:55:000 | 3716.5 | -74.9 | 0 | 108.4 | 108440

1 | 4 | 1580 1:27:00:000 | 3716.2 | -74.9 | 0 | 108.5 | 108544 1 | 4 | 1581 1:27:05:000 | 3715.8 | -74.9 | 0 | 108.6 | 108648 1 | 4 | 1582 1:27:10:000 | 3715.8 | -74.9 | 0 | 108.8 | 108752 1 | 4 | 1583 1:27:15:000 | 3715.5 | -74.9 | 0 | 108.9 | 108856 1 | 4 | 1584 1:27:20:000 | 3714.9 | -74.9 | 0 | 109 | 108960 1 | 4 | 1585 1:27:25:000 | 3714.9 | -74.9 | 0 | 109.1 | 109064 1 | 4 | 1586 1:27:30:000 | 3714.6 | -74.9 | 0 | 109.2 | 109168 1 | 4 | 1587 1:27:35:000 | 3714.3 | -74.9 | 0 | 109.3 | 109272 1 | 4 | 1588 1:27:40:000 | 3714.3 | -74.9 | 0 | 109.4 | 109376 1 | 4 | 1589 1:27:45:000 | 3714 | -74.9 | 0 | 109.5 | 109480 1 | 4 | 1590 1:27:50:000 | 3713.7 | -74.9 | 0 | 109.6 | 109584 1 | 4 | 1591 1:27:55:000 | 3713.7 | -74.9 | 0 | 109.7 | 109688 1 | 4 | 1592 1:28:00:000 | 3713.4 | -74.9 | 0 | 109.8 | 109792 1 | 4 | 1593 1:28:05:000 | 3713.1 | -74.9 | 0 | 109.9 | 109896 1 | 4 | 1594 1:28:10:000 | 3713.1 | -74.9 | 0 | 110 | 110000 1 | 4 | 1595 1:28:15:000 | 3712.7 | -74.9 | 0 | 110.1 | 110104 1 | 4 | 1596 1:28:20:000 | 3712.4 | -74.9 | 0 | 110.2 | 110208 1 | 4 | 1597 1:28:25:000 | 3712.4 | -74.9 | 0 | 110.3 | 110312 1 | 4 | 1598 1:28:30:000 | 3712.1 | -74.7 | 0 | 110.4 | 110416 1 | 4 | 1599 1:28:35:000 | 3712.1 | -74.9 | 0 | 110.5 | 110520 1 | 4 | 1600 1:28:40:000 | 3711.8 | -74.9 | 0 | 110.6 | 110624 1 | 4 | 1601 1:28:45:000 | 3711.5 | -74.9 | 0 | 110.7 | 110728 1 | 4 | 1602 1:28:50:000 | 3711.2 | -74.9 | 0 | 110.8 | 110832 1 | 4 | 1603 1:28:55:000 | 3711.2 | -74.9 | 0 | 110.9 | 110936 1 | 4 | 1604 1:29:00:000 | 3710.9 | -74.9 | 0 | 111 | 111040 1 | 4 | 1605 1:29:05:000 | 3710.9 | -74.9 | 0 | 111.1 | 111144 1 | 4 | 1606 1:29:10:000 | 3710.6 | -74.9 | 0 | 111.2 | 111248 1 | 4 | 1607 1:29:15:000 | 3710.3 | -74.9 | 0 | 111.4 | 111352 1 | 4 | 1608 1:29:20:000 | 3710 | -74.9 | 0 | 111.5 | 111456 1 | 4 | 1609 1:29:25:000 | 3710 | -74.9 | 0 | 111.6 | 111560 1 | 4 | 1610 1:29:30:000 | 3709.6 | -74.7 | 0 | 111.7 | 111664 1 | 4 | 1611 1:29:35:000 | 3709.3 | -74.9 | 0 | 111.8 | 111768 1 | 4 | 1612 1:29:40:000 | 3709.3 | -74.9 | 0 | 111.9 | 111872 1 | 4 | 1613 1:29:45:000 | 3709 | -74.7 | 0 | 112 | 111976 1 | 4 | 1614 1:29:50:000 | 3708.7 | -74.9 | 0 | 112.1 | 112080 1 | 4 | 1615 1:29:55:000 | 3708.7 | -74.9 | 0 | 112.2 | 112184 1 | 4 | 1616 1:30:00:000 | 3708.7 | -74.9 | 0 | 112.3 | 112288 1 | 4 | 1617 1:30:05:000 | 3708.4 | -74.9 | 0 | 112.4 | 112392 1 | 4 | 1618 1:30:10:000 | 3708.1 | -74.9 | 0 | 112.5 | 112496 1 | 4 | 1619 1:30:15:000 | 3708.1 | -74.7 | 0 | 112.6 | 112600 1 | 4 | 1620 1:30:20:000 | 3707.8 | -74.9 | 0 | 112.7 | 112704 1 | 4 | 1621 1:30:25:000 | 3707.5 | -74.9 | 0 | 112.8 | 112808 1 | 4 | 1622 1:30:30:000 | 3707.5 | -74.9 | 0 | 112.9 | 112912 1 | 4 | 1623 1:30:35:000 | 3707.2 | -74.9 | 0 | 113 | 113016 1 | 4 | 1624 1:30:40:000 | 3706.9 | -74.7 | 0 | 113.1 | 113120 1 | 4 | 1625 1:30:45:000 | 3706.9 | -74.9 | 0 | 113.2 | 113224 1 | 4 | 1626 1:30:50:000 | 3706.5 | -74.9 | 0 | 113.3 | 113328 1 | 4 | 1627 1:30:55:000 | 3706.2 | -74.9 | 0 | 113.4 | 113432 1 | 4 | 1628 1:31:00:000 | 3706.2 | -74.7 | 0 | 113.5 | 113536 1 | 4 | 1629 1:31:05:000 | 3705.9 | -74.9 | 0 | 113.6 | 113640 1 | 4 | 1630 1:31:10:000 | 3705.6 | -74.9 | 0 | 113.7 | 113744

1 | 4 | 1631 1:31:15:000 | 3705.6 | -74.7 | 0 | 113.8 | 113847 1 | 4 | 1632 1:31:20:000 | 3705.3 | -74.7 | 0 | 114 | 113951 1 | 4 | 1633 1:31:25:000 | 3705 | -74.9 | 0 | 114.1 | 114055 1 | 4 | 1634 1:31:30:000 | 3705 | -74.9 | 0 | 114.2 | 114159 1 | 4 | 1635 1:31:35:000 | 3705 | -74.9 | 0 | 114.3 | 114264 1 | 4 | 1636 1:31:40:000 | 3704.7 | -74.9 | 0 | 114.4 | 114368 1 | 4 | 1637 1:31:45:000 | 3704.4 | -74.7 | 0 | 114.5 | 114471 1 | 4 | 1638 1:31:50:000 | 3704.4 | -74.9 | 0 | 114.6 | 114575 1 | 4 | 1639 1:31:55:000 | 3704.1 | -74.9 | 0 | 114.7 | 114679 1 | 4 | 1640 1:32:00:000 | 3703.8 | -74.7 | 0 | 114.8 | 114783 1 | 4 | 1641 1:32:05:000 | 3703.8 | -74.9 | 0 | 114.9 | 114887 1 | 4 | 1642 1:32:10:000 | 3703.4 | -74.9 | 0 | 115 | 114991 1 | 4 | 1643 1:32:15:000 | 3703.1 | -74.7 | 0 | 115.1 | 115095 1 | 4 | 1644 1:32:20:000 | 3703.1 | -74.9 | 0 | 115.2 | 115199 1 | 4 | 1645 1:32:25:000 | 3702.8 | -74.9 | 0 | 115.3 | 115303 1 | 4 | 1646 1:32:30:000 | 3702.5 | -74.7 | 0 | 115.4 | 115407 1 | 4 | 1647 1:32:35:000 | 3702.5 | -74.7 | 0 | 115.5 | 115511 1 | 4 | 1648 1:32:40:000 | 3702.2 | -74.9 | 0 | 115.6 | 115615 1 | 4 | 1649 1:32:45:000 | 3701.9 | -74.9 | 0 | 115.7 | 115719 1 | 4 | 1650 1:32:50:000 | 3701.9 | -74.9 | 0 | 115.8 | 115823 1 | 4 | 1651 1:32:55:000 | 3701.6 | -74.9 | 0 | 115.9 | 115927 1 | 4 | 1652 1:33:00:000 | 3701.3 | -74.9 | 0 | 116 | 116031 1 | 4 | 1653 1:33:05:000 | 3701.3 | -74.9 | 0 | 116.1 | 116135 1 | 4 | 1654 1:33:10:000 | 3701 | -74.9 | 0 | 116.2 | 116239 1 | 4 | 1655 1:33:15:000 | 3700.7 | -74.7 | 0 | 116.3 | 116343 1 | 4 | 1656 1:33:20:000 | 3700.7 | -74.9 | 0 | 116.4 | 116447 1 | 4 | 1657 1:33:25:000 | 3700.3 | -74.9 | 0 | 116.6 | 116551 1 | 4 | 1658 1:33:30:000 | 3700 | -74.9 | 0 | 116.7 | 116655 1 | 4 | 1659 1:33:35:000 | 3700 | -74.7 | 0 | 116.8 | 116759 1 | 4 | 1660 1:33:40:000 | 3699.7 | -74.9 | 0 | 116.9 | 116863 1 | 4 | 1661 1:33:45:000 | 3699.7 | -74.9 | 0 | 117 | 116967 1 | 4 | 1662 1:33:50:000 | 3699.4 | -74.9 | 0 | 117.1 | 117071 1 | 4 | 1663 1:33:55:000 | 3699.4 | -74.9 | 0 | 117.2 | 117175 1 | 4 | 1664 1:34:00:000 | 3699.1 | -74.9 | 0 | 117.3 | 117279 1 | 4 | 1665 1:34:05:000 | 3698.8 | -74.9 | 0 | 117.4 | 117383 1 | 4 | 1666 1:34:10:000 | 3698.8 | -74.9 | 0 | 117.5 | 117487 1 | 4 | 1667 1:34:15:000 | 3698.5 | -74.9 | 0 | 117.6 | 117591 1 | 4 | 1668 1:34:20:000 | 3698.2 | -74.9 | 0 | 117.7 | 117695 1 | 4 | 1669 1:34:25:000 | 3697.9 | -74.9 | 0 | 117.8 | 117799 1 | 4 | 1670 1:34:30:000 | 3697.9 | -74.9 | 0 | 117.9 | 117903 1 | 4 | 1671 1:34:35:000 | 3697.6 | -74.9 | 0 | 118 | 118007 1 | 4 | 1672 1:34:40:000 | 3697.6 | -74.7 | 0 | 118.1 | 118111 1 | 4 | 1673 1:34:45:000 | 3697.2 | -74.9 | 0 | 118.2 | 118215 1 | 4 | 1674 1:34:50:000 | 3696.9 | -74.9 | 0 | 118.3 | 118319 1 | 4 | 1675 1:34:55:000 | 3696.9 | -74.9 | 0 | 118.4 | 118423 1 | 4 | 1676 1:35:00:000 | 3696.6 | -74.9 | 0 | 118.5 | 118527 1 | 4 | 1677 1:35:05:000 | 3696.3 | -74.9 | 0 | 118.6 | 118631 1 | 4 | 1678 1:35:10:000 | 3696.3 | -74.9 | 0 | 118.7 | 118735 1 | 4 | 1679 1:35:15:000 | 3696 | -74.9 | 0 | 118.8 | 118839 1 | 4 | 1680 1:35:20:000 | 3695.7 | -74.9 | 0 | 118.9 | 118943 1 | 4 | 1681 1:35:25:000 | 3695.7 | -74.9 | 0 | 119 | 119047

1 | 4 | 1682 1:35:30:000 | 3695.1 | -74.9 | 0 | 119.2 | 119151 1 | 4 | 1683 1:35:35:000 | 3694.8 | -74.9 | 0 | 119.3 | 119255 1 | 4 | 1684 1:35:40:000 | 3694.5 | -74.9 | 0 | 119.4 | 119359 1 | 4 | 1685 1:35:45:000 | 3694.5 | -74.9 | 0 | 119.5 | 119463 1 | 4 | 1686 1:35:50:000 | 3694.1 | -74.9 | 0 | 119.6 | 119567 1 | 4 | 1687 1:35:55:000 | 3693.8 | -74.9 | 0 | 119.7 | 119671 1 | 4 | 1688 1:36:00:000 | 3693.8 | -74.7 | 0 | 119.8 | 119775 1 | 4 | 1689 1:36:05:000 | 3693.5 | -74.9 | 0 | 119.9 | 119879 1 | 4 | 1690 1:36:10:000 | 3693.2 | -74.9 | 0 | 120 | 119983 1 | 4 | 1691 1:36:15:000 | 3692.9 | -74.7 | 0 | 120.1 | 120087 1 | 4 | 1692 1:36:20:000 | 3692.9 | -74.9 | 0 | 120.2 | 120191 1 | 4 | 1693 1:36:25:000 | 3692.6 | -74.9 | 0 | 120.3 | 120295 1 | 4 | 1694 1:36:30:000 | 3692.3 | -74.9 | 0 | 120.4 | 120399 1 | 4 | 1695 1:36:35:000 | 3692.3 | -74.7 | 0 | 120.5 | 120503 1 | 4 | 1696 1:36:40:000 | 3692 | -74.9 | 0 | 120.6 | 120607 1 | 4 | 1697 1:36:45:000 | 3691.7 | -74.9 | 0 | 120.7 | 120711 1 | 4 | 1698 1:36:50:000 | 3691.7 | -74.9 | 0 | 120.8 | 120815 1 | 4 | 1699 1:36:55:000 | 3691.4 | -74.9 | 0 | 120.9 | 120919 1 | 4 | 1700 1:37:00:000 | 3691 | -74.9 | 0 | 121 | 121023 1 | 4 | 1701 1:37:05:000 | 3691 | -74.9 | 0 | 121.1 | 121127 1 | 4 | 1702 1:37:10:000 | 3690.7 | -74.7 | 0 | 121.2 | 121231 1 | 4 | 1703 1:37:15:000 | 3690.4 | -74.7 | 0 | 121.3 | 121335 1 | 4 | 1704 1:37:20:000 | 3690.4 | -74.7 | 0 | 121.4 | 121439 1 | 4 | 1705 1:37:25:000 | 3690.1 | -74.9 | 0 | 121.5 | 121543 1 | 4 | 1706 1:37:30:000 | 3689.8 | -74.9 | 0 | 121.6 | 121647 1 | 4 | 1707 1:37:35:000 | 3689.5 | -74.9 | 0 | 121.8 | 121751 1 | 4 | 1708 1:37:40:000 | 3689.2 | -74.9 | 0 | 121.9 | 121855 1 | 4 | 1709 1:37:45:000 | 3689.2 | -74.9 | 0 | 122 | 121959 1 | 4 | 1710 1:37:50:000 | 3688.9 | -74.9 | 0 | 122.1 | 122063 1 | 4 | 1711 1:37:55:000 | 3688.6 | -74.9 | 0 | 122.2 | 122167 1 | 4 | 1712 1:38:00:000 | 3688.6 | -74.9 | 0 | 122.3 | 122271 1 | 4 | 1713 1:38:05:000 | 3688.3 | -74.9 | 0 | 122.4 | 122375 1 | 4 | 1714 1:38:10:000 | 3687.9 | -74.9 | 0 | 122.5 | 122479 1 | 4 | 1715 1:38:15:000 | 3687.9 | -74.9 | 0 | 122.6 | 122583 1 | 4 | 1716 1:38:20:000 | 3687.6 | -74.9 | 0 | 122.7 | 122687 1 | 4 | 1717 1:38:25:000 | 3687.3 | -74.9 | 0 | 122.8 | 122791 1 | 4 | 1718 1:38:30:000 | 3687.3 | -74.9 | 0 | 122.9 | 122895 1 | 4 | 1719 1:38:35:000 | 3686.7 | -74.9 | 0 | 123 | 122999 1 | 4 | 1720 1:38:40:000 | 3686.7 | -74.9 | 0 | 123.1 | 123103 1 | 4 | 1721 1:38:45:000 | 3686.4 | -74.9 | 0 | 123.2 | 123207 1 | 4 | 1722 1:38:50:000 | 3686.1 | -74.9 | 0 | 123.3 | 123311 1 | 4 | 1723 1:38:55:000 | 3686.1 | -74.9 | 0 | 123.4 | 123415 1 | 4 | 1724 1:39:00:000 | 3685.8 | -74.9 | 0 | 123.5 | 123519 1 | 4 | 1725 1:39:05:000 | 3685.5 | -74.7 | 0 | 123.6 | 123623 1 | 4 | 1726 1:39:10:000 | 3685.5 | -74.7 | 0 | 123.7 | 123727 1 | 4 | 1727 1:39:15:000 | 3684.8 | -74.9 | 0 | 123.8 | 123831 1 | 4 | 1728 1:39:20:000 | 3684.8 | -74.9 | 0 | 123.9 | 123935 1 | 4 | 1729 1:39:25:000 | 3684.5 | -74.9 | 0 | 124 | 124039 1 | 4 | 1730 1:39:30:000 | 3684.2 | -74.9 | 0 | 124.1 | 124143 1 | 4 | 1731 1:39:35:000 | 3684.2 | -74.9 | 0 | 124.2 | 124247 1 | 4 | 1732 1:39:40:000 | 3683.9 | -74.9 | 0 | 124.4 | 124351

1 | 4 | 1733 1:39:45:000 | 3683.6 | -74.9 | 0 | 124.5 | 124455 1 | 4 | 1734 1:39:50:000 | 3683.3 | -74.9 | 0 | 124.6 | 124559 1 | 4 | 1735 1:39:55:000 | 3683.3 | -74.9 | 0 | 124.7 | 124663 1 | 4 | 1736 1:40:00:000 | 3683 | -74.9 | 0 | 124.8 | 124767 1 | 4 | 1737 1:40:05:000 | 3682.7 | -74.9 | 0 | 124.9 | 124871 1 | 4 | 1738 1:40:10:000 | 3682.4 | -74.9 | 0 | 125 | 124975 1 | 4 | 1739 1:40:15:000 | 3682.4 | -74.9 | 0 | 125.1 | 125079 1 | 4 | 1740 1:40:20:000 | 3681.7 | -74.9 | 0 | 125.2 | 125183 1 | 4 | 1741 1:40:25:000 | 3681.7 | -74.9 | 0 | 125.3 | 125287 1 | 4 | 1742 1:40:30:000 | 3681.4 | -74.9 | 0 | 125.4 | 125391 1 | 4 | 1743 1:40:35:000 | 3681.1 | -74.9 | 0 | 125.5 | 125495 1 | 4 | 1744 1:40:40:000 | 3680.8 | -74.9 | 0 | 125.6 | 125599 1 | 4 | 1745 1:40:45:000 | 3680.8 | -74.9 | 0 | 125.7 | 125703 1 | 4 | 1746 1:40:50:000 | 3680.5 | -74.9 | 0 | 125.8 | 125807 1 | 4 | 1747 1:40:55:000 | 3680.2 | -74.9 | 0 | 125.9 | 125911 1 | 4 | 1748 1:41:00:000 | 3679.9 | -74.9 | 0 | 126 | 126015 1 | 4 | 1749 1:41:05:000 | 3679.9 | -74.9 | 0 | 126.1 | 126119 1 | 4 | 1750 1:41:10:000 | 3679.6 | -74.9 | 0 | 126.2 | 126223 1 | 4 | 1751 1:41:15:000 | 3679.3 | -74.9 | 0 | 126.3 | 126327 1 | 4 | 1752 1:41:20:000 | 3679 | -74.9 | 0 | 126.4 | 126431 1 | 4 | 1753 1:41:25:000 | 3678.6 | -74.9 | 0 | 126.5 | 126535 1 | 4 | 1754 1:41:30:000 | 3678.6 | -74.9 | 0 | 126.6 | 126639 1 | 4 | 1755 1:41:35:000 | 3678.3 | -74.9 | 0 | 126.7 | 126743 1 | 4 | 1756 1:41:40:000 | 3678 | -74.7 | 0 | 126.8 | 126847 1 | 4 | 1757 1:41:45:000 | 3677.7 | -74.9 | 0 | 127 | 126951 1 | 4 | 1758 1:41:50:000 | 3677.4 | -74.9 | 0 | 127.1 | 127055 1 | 4 | 1759 1:41:55:000 | 3677.4 | -74.9 | 0 | 127.2 | 127159 1 | 4 | 1760 1:42:00:000 | 3676.8 | -74.7 | 0 | 127.3 | 127263 1 | 4 | 1761 1:42:05:000 | 3676.8 | -74.9 | 0 | 127.4 | 127367 1 | 4 | 1762 1:42:10:000 | 3676.5 | -74.9 | 0 | 127.5 | 127471 1 | 4 | 1763 1:42:15:000 | 3676.2 | -74.7 | 0 | 127.6 | 127575 1 | 4 | 1764 1:42:20:000 | 3675.9 | -74.9 | 0 | 127.7 | 127679 1 | 4 | 1765 1:42:25:000 | 3675.2 | -74.9 | 0 | 127.8 | 127783 1 | 4 | 1766 1:42:30:000 | 3674.9 | -74.9 | 0 | 127.9 | 127887 1 | 4 | 1767 1:42:35:000 | 3674.6 | -74.9 | 0 | 128 | 127991 1 | 4 | 1768 1:42:40:000 | 3674.6 | -74.9 | 0 | 128.1 | 128095 1 | 4 | 1769 1:42:45:000 | 3674.3 | -74.9 | 0 | 128.2 | 128199 1 | 4 | 1770 1:42:50:000 | 3674 | -74.9 | 0 | 128.3 | 128303 1 | 4 | 1771 1:42:55:000 | 3673.7 | -74.9 | 0 | 128.4 | 128407 1 | 4 | 1772 1:43:00:000 | 3673.4 | -74.9 | 0 | 128.5 | 128511 1 | 4 | 1773 1:43:05:000 | 3673.1 | -74.9 | 0 | 128.6 | 128615 1 | 4 | 1774 1:43:10:000 | 3672.8 | -74.9 | 0 | 128.7 | 128719 1 | 4 | 1775 1:43:15:000 | 3672.8 | -74.9 | 0 | 128.8 | 128823 1 | 4 | 1776 1:43:20:000 | 3672.1 | -74.9 | 0 | 128.9 | 128927 1 | 4 | 1777 1:43:25:000 | 3672.1 | -74.7 | 0 | 129 | 129031 1 | 4 | 1778 1:43:30:000 | 3671.8 | -74.9 | 0 | 129.1 | 129135 1 | 4 | 1779 1:43:35:000 | 3671.5 | -74.9 | 0 | 129.2 | 129239 1 | 4 | 1780 1:43:40:000 | 3671.2 | -74.9 | 0 | 129.3 | 129343 1 | 4 | 1781 1:43:45:000 | 3670.9 | -74.9 | 0 | 129.4 | 129447 1 | 4 | 1782 1:43:50:000 | 3670.6 | -74.9 | 0 | 129.6 | 129551 1 | 4 | 1783 1:43:55:000 | 3670.3 | -74.7 | 0 | 129.7 | 129655

1 | 4 | 1784 1:44:00:000 | 3670 | -74.9 | 0 | 129.8 | 129759 1 | 4 | 1785 1:44:05:000 | 3669.7 | -74.9 | 0 | 129.9 | 129863 1 | 4 | 1786 1:44:10:000 | 3669.3 | -74.9 | 0 | 130 | 129967 1 | 4 | 1787 1:44:15:000 | 3669 | -74.9 | 0 | 130.1 | 130071 1 | 4 | 1788 1:44:20:000 | 3668.7 | -74.9 | 0 | 130.2 | 130175 1 | 4 | 1789 1:44:25:000 | 3668.4 | -74.7 | 0 | 130.3 | 130279 1 | 4 | 1790 1:44:30:000 | 3668.4 | -74.9 | 0 | 130.4 | 130383 1 | 4 | 1791 1:44:35:000 | 3668.1 | -74.9 | 0 | 130.5 | 130487 1 | 4 | 1792 1:44:40:000 | 3667.8 | -74.9 | 0 | 130.6 | 130591 1 | 4 | 1793 1:44:45:000 | 3667.5 | -74.9 | 0 | 130.7 | 130695 1 | 4 | 1794 1:44:50:000 | 3667.2 | -74.7 | 0 | 130.8 | 130799 1 | 4 | 1795 1:44:55:000 | 3666.6 | -74.9 | 0 | 130.9 | 130903 1 | 4 | 1796 1:45:00:000 | 3666.6 | -74.7 | 0 | 131 | 131006 1 | 4 | 1797 1:45:05:000 | 3666.2 | -74.9 | 0 | 131.1 | 131111 1 | 4 | 1798 1:45:10:000 | 3665.9 | -74.9 | 0 | 131.2 | 131215 1 | 4 | 1799 1:45:15:000 | 3665.6 | -74.9 | 0 | 131.3 | 131319 1 | 4 | 1800 1:45:20:000 | 3665.3 | -74.9 | 0 | 131.4 | 131422 1 | 4 | 1801 1:45:25:000 | 3665 | -74.9 | 0 | 131.5 | 131527 1 | 4 | 1802 1:45:30:000 | 3664.7 | -74.9 | 0 | 131.6 | 131631 1 | 4 | 1803 1:45:35:000 | 3664.4 | -74.9 | 0 | 131.7 | 131735 1 | 4 | 1804 1:45:40:000 | 3664.1 | -74.9 | 0 | 131.8 | 131839 1 | 4 | 1805 1:45:45:000 | 3663.8 | -74.7 | 0 | 131.9 | 131942 1 | 4 | 1806 1:45:50:000 | 3663.5 | -74.7 | 0 | 132 | 132046 1 | 4 | 1807 1:45:55:000 | 3663.1 | -74.9 | 0 | 132.2 | 132150 1 | 4 | 1808 1:46:00:000 | 3662.8 | -74.7 | 0 | 132.3 | 132254 1 | 4 | 1809 1:46:05:000 | 3662.5 | -74.9 | 0 | 132.4 | 132358 1 | 4 | 1810 1:46:10:000 | 3662.2 | -74.9 | 0 | 132.5 | 132462 1 | 4 | 1811 1:46:15:000 | 3661.9 | -74.9 | 0 | 132.6 | 132566 1 | 4 | 1812 1:46:20:000 | 3661.6 | -74.9 | 0 | 132.7 | 132670 1 | 4 | 1813 1:46:25:000 | 3661.6 | -74.9 | 0 | 132.8 | 132774 1 | 4 | 1814 1:46:30:000 | 3661 | -74.9 | 0 | 132.9 | 132878 1 | 4 | 1815 1:46:35:000 | 3660.7 | -74.9 | 0 | 133 | 132982 1 | 4 | 1816 1:46:40:000 | 3660.4 | -74.9 | 0 | 133.1 | 133086 1 | 4 | 1817 1:46:45:000 | 3660.4 | -74.9 | 0 | 133.2 | 133190 1 | 4 | 1818 1:46:50:000 | 3659.7 | -74.9 | 0 | 133.3 | 133294 1 | 4 | 1819 1:46:55:000 | 3659.7 | -74.9 | 0 | 133.4 | 133398 1 | 4 | 1820 1:47:00:000 | 3659.4 | -74.9 | 0 | 133.5 | 133502 1 | 4 | 1821 1:47:05:000 | 3659.1 | -74.9 | 0 | 133.6 | 133606 1 | 4 | 1822 1:47:10:000 | 3658.8 | -74.9 | 0 | 133.7 | 133710 1 | 4 | 1823 1:47:15:000 | 3658.5 | -74.9 | 0 | 133.8 | 133814 1 | 4 | 1824 1:47:20:000 | 3658.2 | -74.9 | 0 | 133.9 | 133918 1 | 4 | 1825 1:47:25:000 | 3657.9 | -74.9 | 0 | 134 | 134022 1 | 4 | 1826 1:47:30:000 | 3657.9 | -74.9 | 0 | 134.1 | 134126 1 | 4 | 1827 1:47:35:000 | 3657.6 | -74.9 | 0 | 134.2 | 134231 1 | 4 | 1828 1:47:40:000 | 3657.3 | -74.9 | 0 | 134.3 | 134335 1 | 4 | 1829 1:47:45:000 | 3656.9 | -74.9 | 0 | 134.4 | 134439 1 | 4 | 1830 1:47:50:000 | 3656.6 | -74.9 | 0 | 134.5 | 134543 1 | 4 | 1831 1:47:55:000 | 3656.6 | -74.9 | 0 | 134.6 | 134647 1 | 4 | 1832 1:48:00:000 | 3656.3 | -74.9 | 0 | 134.8 | 134751 1 | 4 | 1833 1:48:05:000 | 3655.7 | -74.9 | 0 | 134.9 | 134855 1 | 4 | 1834 1:48:10:000 | 3655.4 | -74.9 | 0 | 135 | 134958

1 | 4 | 1835 1:48:15:000 | 3655.4 | -74.9 | 0 | 135.1 | 135063 1 | 4 | 1836 1:48:20:000 | 3655.1 | -74.9 | 0 | 135.2 | 135167 1 | 4 | 1837 1:48:25:000 | 3654.8 | -74.9 | 0 | 135.3 | 135271 1 | 4 | 1838 1:48:30:000 | 3654.5 | -74.9 | 0 | 135.4 | 135375 1 | 4 | 1839 1:48:35:000 | 3654.5 | -74.9 | 0 | 135.5 | 135479 1 | 4 | 1840 1:48:40:000 | 3654.2 | -74.9 | 0 | 135.6 | 135583 1 | 4 | 1841 1:48:45:000 | 3653.8 | -74.9 | 0 | 135.7 | 135687 1 | 4 | 1842 1:48:50:000 | 3653.8 | -74.9 | 0 | 135.8 | 135791 1 | 4 | 1843 1:48:55:000 | 3653.5 | -74.9 | 0 | 135.9 | 135895 1 | 4 | 1844 1:49:00:000 | 3653.2 | -74.9 | 0 | 136 | 135999 1 | 4 | 1845 1:49:05:000 | 3653.2 | -74.9 | 0 | 136.1 | 136103 1 | 4 | 1846 1:49:10:000 | 3652.9 | -74.9 | 0 | 136.2 | 136207 1 | 4 | 1847 1:49:15:000 | 3652.6 | -74.9 | 0 | 136.3 | 136311 1 | 4 | 1848 1:49:20:000 | 3652.6 | -74.9 | 0 | 136.4 | 136415 1 | 4 | 1849 1:49:25:000 | 3652.3 | -74.9 | 0 | 136.5 | 136519 1 | 4 | 1850 1:49:30:000 | 3652 | -74.9 | 0 | 136.6 | 136623 1 | 4 | 1851 1:49:35:000 | 3651.7 | -74.9 | 0 | 136.7 | 136727 1 | 4 | 1852 1:49:40:000 | 3651.7 | -74.9 | 0 | 136.8 | 136831 1 | 4 | 1853 1:49:45:000 | 3651.4 | -74.9 | 0 | 136.9 | 136935 1 | 4 | 1854 1:49:50:000 | 3651.1 | -74.9 | 0 | 137 | 137039 1 | 4 | 1855 1:49:55:000 | 3651.1 | -74.9 | 0 | 137.1 | 137143 1 | 4 | 1856 1:50:00:000 | 3650.7 | -74.9 | 0 | 137.2 | 137247 1 | 4 | 1857 1:50:05:000 | 3650.7 | -74.9 | 0 | 137.4 | 137351 1 | 4 | 1858 1:50:10:000 | 3650.4 | -74.9 | 0 | 137.5 | 137455 1 | 4 | 1859 1:50:15:000 | 3650.1 | -74.9 | 0 | 137.6 | 137559 1 | 4 | 1860 1:50:20:000 | 3650.1 | -74.9 | 0 | 137.7 | 137663 1 | 4 | 1861 1:50:25:000 | 3649.8 | -74.9 | 0 | 137.8 | 137767 1 | 4 | 1862 1:50:30:000 | 3649.5 | -74.9 | 0 | 137.9 | 137871 1 | 4 | 1863 1:50:35:000 | 3649.5 | -74.7 | 0 | 138 | 137975 1 | 4 | 1864 1:50:40:000 | 3649.2 | -74.9 | 0 | 138.1 | 138079 1 | 4 | 1865 1:50:45:000 | 3648.9 | -74.7 | 0 | 138.2 | 138183 1 | 4 | 1866 1:50:50:000 | 3648.9 | -74.9 | 0 | 138.3 | 138287 1 | 4 | 1867 1:50:55:000 | 3648.6 | -74.7 | 0 | 138.4 | 138391 1 | 4 | 1868 1:51:00:000 | 3648.3 | -74.9 | 0 | 138.5 | 138495 1 | 4 | 1869 1:51:05:000 | 3648.3 | -74.9 | 0 | 138.6 | 138599 1 | 4 | 1870 1:51:10:000 | 3648 | -74.9 | 0 | 138.7 | 138703 1 | 4 | 1871 1:51:15:000 | 3647.6 | -74.9 | 0 | 138.8 | 138807 1 | 4 | 1872 1:51:20:000 | 3647.6 | -74.9 | 0 | 138.9 | 138911 1 | 4 | 1873 1:51:25:000 | 3647.3 | -74.9 | 0 | 139 | 139015 1 | 4 | 1874 1:51:30:000 | 3647 | -74.9 | 0 | 139.1 | 139119 1 | 4 | 1875 1:51:35:000 | 3647 | -74.9 | 0 | 139.2 | 139223 1 | 4 | 1876 1:51:40:000 | 3646.7 | -74.9 | 0 | 139.3 | 139327 1 | 4 | 1877 1:51:45:000 | 3646.4 | -74.9 | 0 | 139.4 | 139431 1 | 4 | 1878 1:51:50:000 | 3646.4 | -74.9 | 0 | 139.5 | 139535 1 | 4 | 1879 1:51:55:000 | 3646.1 | -74.9 | 0 | 139.6 | 139639 1 | 4 | 1880 1:52:00:000 | 3645.8 | -74.9 | 0 | 139.7 | 139743 1 | 4 | 1881 1:52:05:000 | 3645.8 | -74.7 | 0 | 139.8 | 139847 1 | 4 | 1882 1:52:10:000 | 3645.5 | -74.9 | 0 | 140 | 139951 1 | 4 | 1883 1:52:15:000 | 3645.2 | -74.9 | 0 | 140.1 | 140055 1 | 4 | 1884 1:52:20:000 | 3645.2 | -74.7 | 0 | 140.2 | 140159 1 | 4 | 1885 1:52:25:000 | 3644.9 | -74.9 | 0 | 140.3 | 140263

1 | 4 | 1886 1:52:30:000 | 3644.5 | -74.9 | 0 | 140.4 | 140367 1 | 4 | 1887 1:52:35:000 | 3644.5 | -74.9 | 0 | 140.5 | 140471 1 | 4 | 1888 1:52:40:000 | 3644.2 | -74.9 | 0 | 140.6 | 140575 1 | 4 | 1889 1:52:45:000 | 3643.9 | -74.9 | 0 | 140.7 | 140679 1 | 4 | 1890 1:52:50:000 | 3643.9 | -74.9 | 0 | 140.8 | 140783 1 | 4 | 1891 1:52:55:000 | 3643.6 | -74.7 | 0 | 140.9 | 140887 1 | 4 | 1892 1:53:00:000 | 3643.3 | -74.9 | 0 | 141 | 140991 1 | 4 | 1893 1:53:05:000 | 3643 | -74.9 | 0 | 141.1 | 141095 1 | 4 | 1894 1:53:10:000 | 3642.7 | -74.9 | 0 | 141.2 | 141199 1 | 4 | 1895 1:53:15:000 | 3642.7 | -74.9 | 0 | 141.3 | 141303 1 | 4 | 1896 1:53:20:000 | 3642.4 | -74.7 | 0 | 141.4 | 141407 1 | 4 | 1897 1:53:25:000 | 3642.1 | -74.9 | 0 | 141.5 | 141511 1 | 4 | 1898 1:53:30:000 | 3641.8 | -74.9 | 0 | 141.6 | 141615 1 | 4 | 1899 1:53:35:000 | 3641.4 | -74.9 | 0 | 141.7 | 141719 1 | 4 | 1900 1:53:40:000 | 3641.4 | -74.9 | 0 | 141.8 | 141823 1 | 4 | 1901 1:53:45:000 | 3641.1 | -74.9 | 0 | 141.9 | 141927 1 | 4 | 1902 1:53:50:000 | 3640.8 | -74.9 | 0 | 142 | 142031 1 | 4 | 1903 1:53:55:000 | 3640.5 | -74.9 | 0 | 142.1 | 142135 1 | 4 | 1904 1:54:00:000 | 3640.2 | -74.9 | 0 | 142.2 | 142239 1 | 4 | 1905 1:54:05:000 | 3640.2 | -74.9 | 0 | 142.3 | 142343 1 | 4 | 1906 1:54:10:000 | 3639.6 | -74.9 | 0 | 142.4 | 142447 1 | 4 | 1907 1:54:15:000 | 3639.6 | -74.7 | 0 | 142.6 | 142551 1 | 4 | 1908 1:54:20:000 | 3639.3 | -74.9 | 0 | 142.7 | 142655 1 | 4 | 1909 1:54:25:000 | 3639 | -74.9 | 0 | 142.8 | 142759 1 | 4 | 1910 1:54:30:000 | 3638.7 | -74.9 | 0 | 142.9 | 142863 1 | 4 | 1911 1:54:35:000 | 3638.3 | -74.9 | 0 | 143 | 142967 1 | 4 | 1912 1:54:40:000 | 3638 | -74.9 | 0 | 143.1 | 143071 1 | 4 | 1913 1:54:45:000 | 3637.7 | -74.9 | 0 | 143.2 | 143175 1 | 4 | 1914 1:54:50:000 | 3637.1 | -74.9 | 0 | 143.3 | 143279 1 | 4 | 1915 1:54:55:000 | 3637.1 | -74.9 | 0 | 143.4 | 143383 1 | 4 | 1916 1:55:00:000 | 3636.5 | -74.9 | 0 | 143.5 | 143487 1 | 4 | 1917 1:55:05:000 | 3636.5 | -74.9 | 0 | 143.6 | 143591 1 | 4 | 1918 1:55:10:000 | 3635.6 | -74.9 | 0 | 143.7 | 143695 1 | 4 | 1919 1:55:15:000 | 3635.2 | -74.9 | 0 | 143.8 | 143799 1 | 4 | 1920 1:55:20:000 | 3634.9 | -74.9 | 0 | 143.9 | 143903 1 | 4 | 1921 1:55:25:000 | 3634.6 | -74.9 | 0 | 144 | 144007 1 | 4 | 1922 1:55:30:000 | 3634.3 | -74.9 | 0 | 144.1 | 144111 1 | 4 | 1923 1:55:35:000 | 3633.7 | -74.9 | 0 | 144.2 | 144215 1 | 4 | 1924 1:55:40:000 | 3633.7 | -74.9 | 0 | 144.3 | 144319 1 | 4 | 1925 1:55:45:000 | 3633.1 | -74.9 | 0 | 144.4 | 144423 1 | 4 | 1926 1:55:50:000 | 3632.8 | -74.9 | 0 | 144.5 | 144527 1 | 4 | 1927 1:55:55:000 | 3632.5 | -74.9 | 0 | 144.6 | 144631 1 | 4 | 1928 1:56:00:000 | 3631.8 | -74.9 | 0 | 144.7 | 144735 1 | 4 | 1929 1:56:05:000 | 3631.5 | -74.9 | 0 | 144.8 | 144839 1 | 4 | 1930 1:56:10:000 | 3631.2 | -74.9 | 0 | 144.9 | 144943 1 | 4 | 1931 1:56:15:000 | 3630.6 | -74.9 | 0 | 145 | 145047 1 | 4 | 1932 1:56:20:000 | 3630.3 | -74.9 | 0 | 145.2 | 145151 1 | 4 | 1933 1:56:25:000 | 3629.7 | -74.9 | 0 | 145.3 | 145255 1 | 4 | 1934 1:56:30:000 | 3629.4 | -74.9 | 0 | 145.4 | 145359 1 | 4 | 1935 1:56:35:000 | 3628.7 | -74.9 | 0 | 145.5 | 145463 1 | 4 | 1936 1:56:40:000 | 3628.1 | -74.9 | 0 | 145.6 | 145567

1 | 4 | 1937 1:56:45:000 | 3627.8 | -74.9 | 0 | 145.7 | 145671 1 | 4 | 1938 1:56:50:000 | 3627.2 | -74.9 | 0 | 145.8 | 145775 1 | 4 | 1939 1:56:55:000 | 3626.6 | -74.9 | 0 | 145.9 | 145879 1 | 4 | 1940 1:57:00:000 | 3626.3 | -74.9 | 0 | 146 | 145983 1 | 4 | 1941 1:57:05:000 | 3625.6 | -74.9 | 0 | 146.1 | 146087 1 | 4 | 1942 1:57:10:000 | 3625 | -74.9 | 0 | 146.2 | 146191 1 | 4 | 1943 1:57:15:000 | 3624.4 | -74.9 | 0 | 146.3 | 146295 1 | 4 | 1944 1:57:20:000 | 3623.8 | -74.9 | 0 | 146.4 | 146399 1 | 4 | 1945 1:57:25:000 | 3623.2 | -74.9 | 0 | 146.5 | 146503 1 | 4 | 1946 1:57:30:000 | 3622.5 | -74.9 | 0 | 146.6 | 146607 1 | 4 | 1947 1:57:35:000 | 3621.9 | -74.9 | 0 | 146.7 | 146711 1 | 4 | 1948 1:57:40:000 | 3621.3 | -74.9 | 0 | 146.8 | 146815 1 | 4 | 1949 1:57:45:000 | 3620.7 | -74.9 | 0 | 146.9 | 146919 1 | 4 | 1950 1:57:50:000 | 3619.7 | -74.9 | 0 | 147 | 147023 1 | 4 | 1951 1:57:55:000 | 3619.1 | -74.9 | 0 | 147.1 | 147127 1 | 4 | 1952 1:58:00:000 | 3618.2 | -74.9 | 0 | 147.2 | 147231 1 | 4 | 1953 1:58:05:000 | 3617.6 | -74.9 | 0 | 147.3 | 147335 1 | 4 | 1954 1:58:10:000 | 3617 | -74.9 | 0 | 147.4 | 147439 1 | 4 | 1955 1:58:15:000 | 3615.7 | -74.9 | 0 | 147.5 | 147543 1 | 4 | 1956 1:58:20:000 | 3614.8 | -74.9 | 0 | 147.6 | 147647 1 | 4 | 1957 1:58:25:000 | 3613.9 | -74.9 | 0 | 147.8 | 147751 1 | 4 | 1958 1:58:30:000 | 3613.2 | -74.9 | 0 | 147.9 | 147855 1 | 4 | 1959 1:58:35:000 | 3612.3 | -74.9 | 0 | 148 | 147960 1 | 4 | 1960 1:58:40:000 | 3611.1 | -74.9 | 0 | 148.1 | 148063 1 | 4 | 1961 1:58:45:000 | 3610.1 | -74.9 | 0 | 148.2 | 148167 1 | 4 | 1962 1:58:50:000 | 3609.2 | -74.9 | 0 | 148.3 | 148271 1 | 4 | 1963 1:58:55:000 | 3608.3 | -74.9 | 0 | 148.4 | 148375 1 | 4 | 1964 1:59:00:000 | 3607.3 | -74.9 | 0 | 148.5 | 148479 1 | 4 | 1965 1:59:05:000 | 3606.1 | -74.9 | 0 | 148.6 | 148584 1 | 4 | 1966 1:59:10:000 | 3604.9 | -74.9 | 0 | 148.7 | 148688 1 | 4 | 1967 1:59:15:000 | 3604.2 | -74.9 | 0 | 148.8 | 148792 1 | 4 | 1968 1:59:20:000 | 3602.7 | -74.9 | 0 | 148.9 | 148896 1 | 4 | 1969 1:59:25:000 | 3601.8 | -74.9 | 0 | 149 | 149000 1 | 4 | 1970 1:59:30:000 | 3600.2 | -74.9 | 0 | 149.1 | 149104 1 | 4 | 1971 1:59:35:000 | 3599.3 | -74.9 | 0 | 149.2 | 149208 1 | 4 | 1972 1:59:40:000 | 3598 | -74.9 | 0 | 149.3 | 149312 1 | 4 | 1973 1:59:45:000 | 3596.2 | -74.9 | 0 | 149.4 | 149416 1 | 4 | 1974 1:59:50:000 | 3594.9 | -74.9 | 0 | 149.5 | 149520 1 | 4 | 1975 1:59:55:000 | 3593.7 | -74.9 | 0 | 149.6 | 149624 1 | 4 | 1976 2:00:00:000 | 3592.5 | -74.9 | 0 | 149.7 | 149728 1 | 4 | 1977 2:00:05:000 | 3590.9 | -74.9 | 0 | 149.8 | 149832 1 | 4 | 1978 2:00:10:000 | 3589.4 | -74.7 | 0 | 149.9 | 149936 1 | 4 | 1979 2:00:15:000 | 3587.8 | -74.9 | 0 | 150 | 150040 1 | 4 | 1980 2:00:20:000 | 3586.6 | -74.9 | 0 | 150.1 | 150144 1 | 4 | 1981 2:00:25:000 | 3585 | -74.9 | 0 | 150.2 | 150248 1 | 4 | 1982 2:00:30:000 | 3583.5 | -74.7 | 0 | 150.4 | 150352 1 | 4 | 1983 2:00:35:000 | 3581.6 | -74.9 | 0 | 150.5 | 150456 1 | 4 | 1984 2:00:40:000 | 3580.1 | -74.9 | 0 | 150.6 | 150560 1 | 4 | 1985 2:00:45:000 | 3578.5 | -74.9 | 0 | 150.7 | 150664 1 | 4 | 1986 2:00:50:000 | 3576.3 | -74.9 | 0 | 150.8 | 150768 1 | 4 | 1987 2:00:55:000 | 3574.8 | -74.9 | 0 | 150.9 | 150872

1 | 4 | 1988 2:01:00:000 | 3572.9 | -74.9 | 0 | 151 | 150976 1 | 4 | 1989 2:01:05:000 | 3571.4 | -74.9 | 0 | 151.1 | 151080 1 | 4 | 1990 2:01:10:000 | 3569.5 | -74.9 | 0 | 151.2 | 151184 1 | 4 | 1991 2:01:15:000 | 3567.3 | -74.9 | 0 | 151.3 | 151288 1 | 4 | 1992 2:01:20:000 | 3565.5 | -74.9 | 0 | 151.4 | 151392 1 | 4 | 1993 2:01:25:000 | 3563.3 | -74.9 | 0 | 151.5 | 151496 1 | 4 | 1994 2:01:30:000 | 3561.8 | -74.9 | 0 | 151.6 | 151600 1 | 4 | 1995 2:01:35:000 | 3559.6 | -74.9 | 0 | 151.7 | 151704 1 | 4 | 1996 2:01:40:000 | 3557.7 | -74.9 | 0 | 151.8 | 151808 1 | 4 | 1997 2:01:45:000 | 3554.9 | -74.9 | 0 | 151.9 | 151912 1 | 4 | 1998 2:01:50:000 | 3553.1 | -74.9 | 0 | 152 | 152016 1 | 4 | 1999 2:01:55:000 | 3550.9 | -74.9 | 0 | 152.1 | 152120 1 | 4 | 2000 2:02:00:000 | 3548.7 | -74.9 | 0 | 152.2 | 152224 1 | 4 | 2001 2:02:05:000 | 3546.3 | -74.9 | 0 | 152.3 | 152328 1 | 4 | 2002 2:02:10:000 | 3544.1 | -74.9 | 0 | 152.4 | 152432 1 | 4 | 2003 2:02:15:000 | 3541.9 | -74.9 | 0 | 152.5 | 152536 1 | 4 | 2004 2:02:20:000 | 3539.4 | -74.9 | 0 | 152.6 | 152640 1 | 4 | 2005 2:02:25:000 | 3536.7 | -74.9 | 0 | 152.7 | 152744 1 | 4 | 2006 2:02:30:000 | 3534.2 | -74.9 | 0 | 152.8 | 152848 1 | 4 | 2007 2:02:35:000 | 3532 | -74.9 | 0 | 153 | 152952 1 | 4 | 2008 2:02:40:000 | 3529.5 | -74.9 | 0 | 153.1 | 153056 1 | 4 | 2009 2:02:45:000 | 3526.7 | -74.9 | 0 | 153.2 | 153160 1 | 4 | 2010 2:02:50:000 | 3524.3 | -74.9 | 0 | 153.3 | 153264 1 | 4 | 2011 2:02:55:000 | 3521.2 | -74.9 | 0 | 153.4 | 153368 1 | 4 | 2012 2:03:00:000 | 3518.7 | -74.9 | 0 | 153.5 | 153472 1 | 4 | 2013 2:03:05:000 | 3515.9 | -74.7 | 0 | 153.6 | 153576 1 | 4 | 2014 2:03:10:000 | 3512.8 | -74.9 | 0 | 153.7 | 153680 1 | 4 | 2015 2:03:15:000 | 3510 | -74.9 | 0 | 153.8 | 153784 1 | 4 | 2016 2:03:20:000 | 3507.2 | -74.9 | 0 | 153.9 | 153888 1 | 4 | 2017 2:03:25:000 | 3504.4 | -74.9 | 0 | 154 | 153992 1 | 4 | 2018 2:03:30:000 | 3501 | -74.9 | 0 | 154.1 | 154096 1 | 4 | 2019 2:03:35:000 | 3498.2 | -74.9 | 0 | 154.2 | 154200 1 | 4 | 2020 2:03:40:000 | 3494.5 | -74.9 | 0 | 154.3 | 154304 1 | 4 | 2021 2:03:45:000 | 3491.7 | -74.9 | 0 | 154.4 | 154408 1 | 4 | 2022 2:03:50:000 | 3488.3 | -74.9 | 0 | 154.5 | 154512 1 | 4 | 2023 2:03:55:000 | 3485.2 | -74.9 | 0 | 154.6 | 154616 1 | 4 | 2024 2:04:00:000 | 3481.5 | -74.9 | 0 | 154.7 | 154720 1 | 4 | 2025 2:04:05:000 | 3478.4 | -74.9 | 0 | 154.8 | 154824 1 | 4 | 2026 2:04:10:000 | 3474.7 | -74.9 | 0 | 154.9 | 154928 1 | 4 | 2027 2:04:15:000 | 3471.2 | -74.9 | 0 | 155 | 155032 1 | 4 | 2028 2:04:20:000 | 3467.5 | -74.9 | 0 | 155.1 | 155136 1 | 4 | 2029 2:04:25:000 | 3463.8 | -74.9 | 0 | 155.2 | 155240 1 | 4 | 2030 2:04:30:000 | 3460.4 | -74.9 | 0 | 155.3 | 155344 1 | 4 | 2031 2:04:35:000 | 3456.1 | -74.9 | 0 | 155.4 | 155448 1 | 4 | 2032 2:04:40:000 | 3452.3 | -74.9 | 0 | 155.6 | 155552 1 | 4 | 2033 2:04:45:000 | 3448 | -74.9 | 0 | 155.7 | 155656 1 | 4 | 2034 2:04:50:000 | 3444.6 | -74.9 | 0 | 155.8 | 155760 1 | 4 | 2035 2:04:55:000 | 3440.6 | -74.9 | 0 | 155.9 | 155864 1 | 4 | 2036 2:05:00:000 | 3435.9 | -74.9 | 0 | 156 | 155968 1 | 4 | 2037 2:05:05:000 | 3431.6 | -74.9 | 0 | 156.1 | 156072 1 | 4 | 2038 2:05:10:000 | 3427.2 | -74.9 | 0 | 156.2 | 156176

1 | 4 | 2039 2:05:15:000 | 3423.2 | -74.7 | 0 | 156.3 | 156280 1 | 4 | 2040 2:05:20:000 | 3418.5 | -74.9 | 0 | 156.4 | 156384 1 | 4 | 2041 2:05:25:000 | 3413.9 | -74.9 | 0 | 156.5 | 156488 1 | 4 | 2042 2:05:30:000 | 3408.9 | -74.9 | 0 | 156.6 | 156592 1 | 4 | 2043 2:05:35:000 | 3404.6 | -74.9 | 0 | 156.7 | 156696 1 | 4 | 2044 2:05:40:000 | 3399.6 | -74.9 | 0 | 156.8 | 156800 1 | 4 | 2045 2:05:45:000 | 3394.4 | -74.9 | 0 | 156.9 | 156904 1 | 4 | 2046 2:05:50:000 | 3388.8 | -74.9 | 0 | 157 | 157008 1 | 4 | 2047 2:05:55:000 | 3383.8 | -74.9 | 0 | 157.1 | 157112 1 | 4 | 2048 2:06:00:000 | 3378.5 | -74.9 | 0 | 157.2 | 157216 1 | 4 | 2049 2:06:05:000 | 3373 | -74.9 | 0 | 157.3 | 157320 1 | 4 | 2050 2:06:10:000 | 3367.4 | -74.9 | 0 | 157.4 | 157424 1 | 4 | 2051 2:06:15:000 | 3361.2 | -74.9 | 0 | 157.5 | 157528 1 | 4 | 2052 2:06:20:000 | 3355.9 | -74.9 | 0 | 157.6 | 157632 1 | 4 | 2053 2:06:25:000 | 3349.7 | -74.9 | 0 | 157.7 | 157736 1 | 4 | 2054 2:06:30:000 | 3343.2 | -74.9 | 0 | 157.8 | 157840 1 | 4 | 2055 2:06:35:000 | 3336.1 | -74.9 | 0 | 157.9 | 157944 1 | 4 | 2056 2:06:40:000 | 3329.6 | -74.9 | 0 | 158 | 158048 1 | 4 | 2057 2:06:45:000 | 3323.4 | -74.9 | 0 | 158.2 | 158152 1 | 4 | 2058 2:06:50:000 | 3315.9 | -74.9 | 0 | 158.3 | 158256 1 | 4 | 2059 2:06:55:000 | 3308.5 | -74.9 | 0 | 158.4 | 158360 1 | 4 | 2060 2:07:00:000 | 3300.7 | -74.9 | 0 | 158.5 | 158464 1 | 4 | 2061 2:07:05:000 | 3294.5 | -74.9 | 0 | 158.6 | 158568 1 | 4 | 2062 2:07:10:000 | 3285.9 | -74.9 | 0 | 158.7 | 1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
2.7 | 149.9 | 0 | 18.5 18528.1 2 | 6 | 2293 0:07:30:000 | 3793.7 | 149.9 | 0 | 18.7 18736.3

2 | 6 | 2294 0:07:35:000 | 3794.3 | 149.9 | 0 | 18.9 18944.4 2 | 6 | 2295 0:07:40:000 | 3795.2 | 149.9 | 0 | 19.2 19152.6 2 | 6 | 2296 0:07:45:000 | 3795.8 | 149.9 | 0 | 19.4 19360.8 2 | 6 | 2297 0:07:50:000 | 3796.5 | 149.9 | 0 | 19.6 | 19569 2 | 6 | 2298 0:07:55:000 | 3797.4 | 149.9 | 0 | 19.8 19777.1 2 | 6 | 2299 0:08:00:000 | 3798 | 149.9 | 0 | 20 19985.2 2 | 6 | 2300 0:08:05:000 | 3798.9 | 149.9 | 0 | 20.2 20193.4 2 | 6 | 2301 0:08:10:000 | 3799.6 | 149.9 | 0 | 20.4 20401.6 2 | 6 | 2302 0:08:15:000 | 3800.5 | 149.9 | 0 | 20.6 20609.8 2 | 6 | 2303 0:08:20:000 | 3801.1 | 149.9 | 0 | 20.8 | 20818 2 | 6 | 2304 0:08:25:000 | 3802 | 149.9 | 0 | 21 21026.2 2 | 6 | 2305 0:08:30:000 | 3802.7 | 149.9 | 0 | 21.2 21234.4 2 | 6 | 2306 0:08:35:000 | 3803.3 | 149.7 | 0 | 21.4 21442.6 2 | 6 | 2307 0:08:40:000 | 3804.2 | 149.9 | 0 | 21.7 21650.8 2 | 6 | 2308 0:08:45:000 | 3805.4 | 149.9 | 0 | 21.9 21858.9 2 | 6 | 2309 0:08:50:000 | 3806.1 | 149.7 | 0 | 22.1 | 22067 2 | 6 | 2310 0:08:55:000 | 3806.7 | 149.9 | 0 | 22.3 22275.2 2 | 6 | 2311 0:09:00:000 | 3807.6 | 149.9 | 0 | 22.5 22483.4 2 | 6 | 2312 0:09:05:000 | 3808.5 | 149.9 | 0 | 22.7 22691.5 2 | 6 | 2313 0:09:10:000 | 3809.2 | 149.9 | 0 | 22.9 22899.6 2 | 6 | 2314 0:09:15:000 | 3809.8 | 149.9 | 0 | 23.1 23107.8 2 | 6 | 2315 0:09:20:000 | 3810.7 | 149.9 | 0 | 23.3 | 23316 2 | 6 | 2316 0:09:25:000 | 3811.6 | 149.9 | 0 | 23.5 23524.2 2 | 6 | 2317 0:09:30:000 | 3812.3 | 149.9 | 0 | 23.7 23732.4 2 | 6 | 2318 0:09:35:000 | 3812.9 | 149.9 | 0 | 23.9 23940.6 2 | 6 | 2319 0:09:40:000 | 3813.8 | 149.9 | 0 | 24.1 24148.8 2 | 6 | 2320 0:09:45:000 | 3814.4 | 149.9 | 0 | 24.4 24356.9 2 | 6 | 2321 0:09:50:000 | 3815.4 | 149.9 | 0 | 24.6 24565.1 2 | 6 | 2322 0:09:55:000 | 3816 | 149.9 | 0 | 24.8 24773.3 2 | 6 | 2323 0:10:00:000 | 3816.6 | 149.7 | 0 | 25 24981.4 2 | 6 | 2324 0:10:05:000 | 3817.5 | 149.9 | 0 | 25.2 25189.5 2 | 6 | 2325 0:10:10:000 | 3818.5 | 149.9 | 0 | 25.4 25397.6 2 | 6 | 2326 0:10:15:000 | 3819.1 | 149.9 | 0 | 25.6 25605.8 2 | 6 | 2327 0:10:20:000 | 3819.7 | 149.9 | 0 | 25.8 | 25814 2 | 6 | 2328 0:10:25:000 | 3820.6 | 149.7 | 0 | 26 26022.2 2 | 6 | 2329 0:10:30:000 | 3821.6 | 149.9 | 0 | 26.2 26230.2 2 | 6 | 2330 0:10:35:000 | 3822.2 | 149.9 | 0 | 26.4 26438.4 2 | 6 | 2331 0:10:40:000 | 3822.8 | 149.7 | 0 | 26.6 26646.5 2 | 6 | 2332 0:10:45:000 | 3823.4 | 149.9 | 0 | 26.9 26854.7 2 | 6 | 2333 0:10:50:000 | 3824.4 | 149.9 | 0 | 27.1 27062.9 2 | 6 | 2334 0:10:55:000 | 3825.6 | 149.9 | 0 | 27.3 | 27271 2 | 6 | 2335 0:11:00:000 | 3826.2 | 149.9 | 0 | 27.5 27479.2 2 | 6 | 2336 0:11:05:000 | 3826.8 | 149.9 | 0 | 27.7 27687.3 2 | 6 | 2337 0:11:10:000 | 3827.5 | 149.9 | 0 | 27.9 27895.5 2 | 6 | 2338 0:11:15:000 | 3828.4 | 149.7 | 0 | 28.1 28103.5 2 | 6 | 2339 0:11:20:000 | 3829.3 | 149.9 | 0 | 28.3 28311.6 2 | 6 | 2340 0:11:25:000 | 3829.9 | 149.7 | 0 | 28.5 28519.7 2 | 6 | 2341 0:11:30:000 | 3830.6 | 149.9 | 0 | 28.7 28727.8 2 | 6 | 2342 0:11:35:000 | 3831.2 | 149.7 | 0 | 28.9 28935.8 2 | 6 | 2343 0:11:40:000 | 3831.8 | 149.9 | 0 | 29.1 29143.9 2 | 6 | 2344 0:11:45:000 | 3832.4 | 149.7 | 0 | 29.4 29351.9

2 | 6 | 2345 0:11:50:000 | 3833.3 | 149.9 | 0 | 29.6 | 29560 2 | 6 | 2346 0:11:55:000 | 3834 | 149.7 | 0 | 29.8 29767.9 2 | 6 | 2347 0:12:00:000 | 3834.9 | 149.9 | 0 | 30 | 29976 2 | 6 | 2348 0:12:05:000 | 3835.5 | 149.9 | 0 | 30.2 | 30184 2 | 6 | 2349 0:12:10:000 | 3836.1 | 149.9 | 0 | 30.4 30392.1 2 | 6 | 2350 0:12:15:000 | 3836.8 | 149.9 | 0 | 30.6 30600.3 2 | 6 | 2351 0:12:20:000 | 3837.4 | 149.7 | 0 | 30.8 30808.3 2 | 6 | 2352 0:12:25:000 | 3838 | 149.9 | 0 | 31 31016.3 2 | 6 | 2353 0:12:30:000 | 3838.6 | 149.7 | 0 | 31.2 31224.2 2 | 6 | 2354 0:12:35:000 | 3839.5 | 149.3 | 0 | 31.4 31431.7 2 | 6 | 2355 0:12:40:000 | 3839.9 | 149.7 | 0 | 31.6 31639.7 2 | 6 | 2356 0:12:45:000 | 3840.8 | 149.7 | 0 | 31.8 31847.2 2 | 6 | 2357 0:12:50:000 | 3841.4 | 149.5 | 0 | 32.1 32054.7 2 | 6 | 2358 0:12:55:000 | 3842 | 149.3 | 0 | 32.3 32262.1 2 | 6 | 2359 0:13:00:000 | 3842.6 | 149.7 | 0 | 32.5 32469.8 2 | 6 | 2360 0:13:05:000 | 3843.3 | 149.7 | 0 | 32.7 32677.8 2 | 6 | 2361 0:13:10:000 | 3844.5 | 149.7 | 0 | 32.9 32885.8 2 | 6 | 2362 0:13:15:000 | 3844.8 | 149.3 | 0 | 33.1 33093.2 2 | 6 | 2363 0:13:20:000 | 3845.4 | 149.3 | 0 | 33.3 33300.6 2 | 6 | 2364 0:13:25:000 | 3846.1 | 149.5 | 0 | 33.5 33508.2 2 | 6 | 2365 0:13:30:000 | 3846.7 | 149.7 | 0 | 33.7 33716.1 2 | 6 | 2366 0:13:35:000 | 3847 | 149.5 | 0 | 33.9 33923.7 2 | 6 | 2367 0:13:40:000 | 3847.9 | 149.7 | 0 | 34.1 34131.5 2 | 6 | 2368 0:13:45:000 | 3848.2 | 149.5 | 0 | 34.3 34339.2 2 | 6 | 2369 0:13:50:000 | 3848.5 | 149.3 | 0 | 34.5 34546.6 2 | 6 | 2370 0:13:55:000 | 3849.5 | 149.7 | 0 | 34.8 34754.2 2 | 6 | 2371 0:14:00:000 | 3850.1 | 149.7 | 0 | 35 34961.8 2 | 6 | 2372 0:14:05:000 | 3850.4 | 149.3 | 0 | 35.2 35169.2 2 | 6 | 2373 0:14:10:000 | 3851 | 149.3 | 0 | 35.4 35376.6 2 | 6 | 2374 0:14:15:000 | 3851.3 | 149.7 | 0 | 35.6 35584.1 2 | 6 | 2375 0:14:20:000 | 3851.9 | 149.3 | 0 | 35.8 35791.5 2 | 6 | 2376 0:14:25:000 | 3852.6 | 149.3 | 0 | 36 35998.9 2 | 6 | 2377 0:14:30:000 | 3853.2 | 149.3 | 0 | 36.2 36206.4 2 | 6 | 2378 0:14:35:000 | 3853.8 | 149.3 | 0 | 36.4 36413.7 2 | 6 | 2379 0:14:40:000 | 3854.1 | 149.3 | 0 | 36.6 36621.1 2 | 6 | 2380 0:14:45:000 | 3854.7 | 149.5 | 0 | 36.8 36828.6 2 | 6 | 2381 0:14:50:000 | 3855 | 149.3 | 0 | 37 | 37036 2 | 6 | 2382 0:14:55:000 | 3855.7 | 149.7 | 0 | 37.2 37243.6 2 | 6 | 2383 0:15:00:000 | 3856 | 149.5 | 0 | 37.5 37451.1 2 | 6 | 2384 0:15:05:000 | 3856.6 | 149.3 | 0 | 37.7 37658.7 2 | 6 | 2385 0:15:10:000 | 3856.9 | 149.3 | 0 | 37.9 37866.3 2 | 6 | 2386 0:15:15:000 | 3857.2 | 149.3 | 0 | 38.1 38073.6 2 | 6 | 2387 0:15:20:000 | 3857.5 | 149.3 | 0 | 38.3 | 38281 2 | 6 | 2388 0:15:25:000 | 3857.2 | 149.5 | 0 | 38.5 38488.4 2 | 6 | 2389 0:15:30:000 | 3858.1 | 149.7 | 0 | 38.7 38696.2 2 | 6 | 2390 0:15:35:000 | 3858.8 | 149.5 | 0 | 38.9 38903.8 2 | 6 | 2391 0:15:40:000 | 3858.1 | 149.5 | 0 | 39.1 39111.5 2 | 6 | 2392 0:15:45:000 | 3858.8 | 149.7 | 0 | 39.3 39319.2 2 | 6 | 2393 0:15:50:000 | 3859.1 | 149.7 | 0 | 39.5 39526.9 2 | 6 | 2394 0:15:55:000 | 3859.1 | 149.7 | 0 | 39.7 | 39735 2 | 6 | 2395 0:16:00:000 | 3860.6 | 149.3 | 0 | 39.9 39942.7

2 | 6 | 2396 0:16:05:000 | 3860.9 | 149.5 | 0 | 40.2 40150.4 2 | 6 | 2397 0:16:10:000 | 3860.6 | 149.9 | 0 | 40.4 40358.3 2 | 6 | 2398 0:16:15:000 | 3862.2 | 149.7 | 0 | 40.6 40566.1 2 | 6 | 2399 0:16:20:000 | 3861.9 | 149.3 | 0 | 40.8 40773.8 2 | 6 | 2400 0:16:25:000 | 3861.2 | 149.5 | 0 | 41 40981.5 2 | 6 | 2401 0:16:30:000 | 3861.9 | 149.7 | 0 | 41.2 41189.4 2 | 6 | 2402 0:16:35:000 | 3863.1 | 149.5 | 0 | 41.4 41397.1 2 | 6 | 2403 0:16:40:000 | 3862.5 | 149.7 | 0 | 41.6 41605.1 2 | 6 | 2404 0:16:45:000 | 3863.4 | 149.5 | 0 | 41.8 41812.9 2 | 6 | 2405 0:16:50:000 | 3865 | 149.3 | 0 | 42 42020.5 2 | 6 | 2406 0:16:55:000 | 3864 | 149.3 | 0 | 42.2 42228.2 2 | 6 | 2407 0:17:00:000 | 3864 | 149.5 | 0 | 42.4 42435.9 2 | 6 | 2408 0:17:05:000 | 3864.7 | 149.7 | 0 | 42.6 42643.9 2 | 6 | 2409 0:17:10:000 | 3865 | 150.4 | 0 | 42.9 42852.6 2 | 6 | 2410 0:17:15:000 | 3865.6 | 150.2 | 0 | 43.1 43061.3 2 | 6 | 2411 0:17:20:000 | 3866.2 | 150.2 | 0 | 43.3 43269.9 2 | 6 | 2412 0:17:25:000 | 3866.5 | 150.4 | 0 | 43.5 43478.6 2 | 6 | 2413 0:17:30:000 | 3866.5 | 150.2 | 0 | 43.7 43687.3 2 | 6 | 2414 0:17:35:000 | 3866.5 | 150.2 | 0 | 43.9 | 43896 2 | 6 | 2415 0:17:40:000 | 3867.1 | 150.2 | 0 | 44.1 44104.6 2 | 6 | 2416 0:17:45:000 | 3867.4 | 150.4 | 0 | 44.3 44313.3 2 | 6 | 2417 0:17:50:000 | 3868.1 | 150.4 | 0 | 44.5 | 44522 2 | 6 | 2418 0:17:55:000 | 3868.1 | 150.2 | 0 | 44.7 44730.6 2 | 6 | 2419 0:18:00:000 | 3868.4 | 150.2 | 0 | 44.9 44939.3 2 | 6 | 2420 0:18:05:000 | 3868.7 | 150.4 | 0 | 45.1 45147.9 2 | 6 | 2421 0:18:10:000 | 3869.6 | 150.2 | 0 | 45.4 45356.6 2 | 6 | 2422 0:18:15:000 | 3869.3 | 150.4 | 0 | 45.6 45565.3 2 | 6 | 2423 0:18:20:000 | 3869.6 | 150.2 | 0 | 45.8 45773.9 2 | 6 | 2424 0:18:25:000 | 3870.2 | 150.2 | 0 | 46 45982.5 2 | 6 | 2425 0:18:30:000 | 3870.9 | 150.2 | 0 | 46.2 46191.2 2 | 6 | 2426 0:18:35:000 | 3871.2 | 150.2 | 0 | 46.4 46399.9 2 | 6 | 2427 0:18:40:000 | 3871.2 | 150.2 | 0 | 46.6 46608.5 2 | 6 | 2428 0:18:45:000 | 3872.1 | 150.2 | 0 | 46.8 46817.1 2 | 6 | 2429 0:18:50:000 | 3872.1 | 150.2 | 0 | 47 47025.7 2 | 6 | 2430 0:18:55:000 | 3872.1 | 150.2 | 0 | 47.2 47234.3 2 | 6 | 2431 0:19:00:000 | 3872.7 | 150.2 | 0 | 47.4 | 47443 2 | 6 | 2432 0:19:05:000 | 3873.3 | 150.2 | 0 | 47.7 47651.6 2 | 6 | 2433 0:19:10:000 | 3873.3 | 150.2 | 0 | 47.9 47860.1 2 | 6 | 2434 0:19:15:000 | 3873.6 | 150.2 | 0 | 48.1 48068.7 2 | 6 | 2435 0:19:20:000 | 3874 | 150.2 | 0 | 48.3 48277.1 2 | 6 | 2436 0:19:25:000 | 3874.6 | 150.2 | 0 | 48.5 48485.5 2 | 6 | 2437 0:19:30:000 | 3874.6 | 150.2 | 0 | 48.7 48693.9 2 | 6 | 2438 0:19:35:000 | 3874.9 | 150.2 | 0 | 48.9 48902.6 2 | 6 | 2439 0:19:40:000 | 3875.8 | 150.2 | 0 | 49.1 49111.1 2 | 6 | 2440 0:19:45:000 | 3875.2 | 150.2 | 0 | 49.3 49319.7 2 | 6 | 2441 0:19:50:000 | 3876.4 | 150.2 | 0 | 49.5 49528.3 2 | 6 | 2442 0:19:55:000 | 3877.4 | 149.9 | 0 | 49.7 49736.7 2 | 6 | 2443 0:20:00:000 | 3877.1 | 149.9 | 0 | 49.9 49945.2 2 | 6 | 2444 0:20:05:000 | 3877.1 | 150.2 | 0 | 50.2 50153.7 2 | 6 | 2445 0:20:10:000 | 3877.7 | 150.2 | 0 | 50.4 50362.3 2 | 6 | 2446 0:20:15:000 | 3878 | 149.9 | 0 | 50.6 50570.8

2 | 6 | 2447 0:20:20:000 | 3878.9 | 149.9 | 0 | 50.8 50779.3 2 | 6 | 2448 0:20:25:000 | 3878 | 150.2 | 0 | 51 50987.9 2 | 6 | 2449 0:20:30:000 | 3878.6 | 150.2 | 0 | 51.2 51196.4 2 | 6 | 2450 0:20:35:000 | 3878.9 | 150.2 | 0 | 51.4 51404.9 2 | 6 | 2451 0:20:40:000 | 3878.9 | 150.2 | 0 | 51.6 51613.4 2 | 6 | 2452 0:20:45:000 | 3880.2 | 149.9 | 0 | 51.8 51821.8 2 | 6 | 2453 0:20:50:000 | 3880.2 | 150.2 | 0 | 52 52030.4 2 | 6 | 2454 0:20:55:000 | 3880.2 | 150.2 | 0 | 52.2 52238.9 2 | 6 | 2455 0:21:00:000 | 3880.8 | 150.2 | 0 | 52.4 52447.5 2 | 6 | 2456 0:21:05:000 | 3881.7 | 149.9 | 0 | 52.7 52655.8 2 | 6 | 2457 0:21:10:000 | 3882 | 149.9 | 0 | 52.9 | 52864 2 | 6 | 2458 0:21:15:000 | 3882.3 | 149.9 | 0 | 53.1 53072.5 2 | 6 | 2459 0:21:20:000 | 3882.6 | 150.2 | 0 | 53.3 | 53281 2 | 6 | 2460 0:21:25:000 | 3883.3 | 149.9 | 0 | 53.5 53489.3 2 | 6 | 2461 0:21:30:000 | 3883.3 | 150.2 | 0 | 53.7 53697.6 2 | 6 | 2462 0:21:35:000 | 3883.9 | 149.9 | 0 | 53.9 | 53906 2 | 6 | 2463 0:21:40:000 | 3884.2 | 149.9 | 0 | 54.1 54114.4 2 | 6 | 2464 0:21:45:000 | 3884.8 | 149.9 | 0 | 54.3 54322.7 2 | 6 | 2465 0:21:50:000 | 3885.1 | 149.9 | 0 | 54.5 | 54531 2 | 6 | 2466 0:21:55:000 | 3885.4 | 149.9 | 0 | 54.7 54739.4 2 | 6 | 2467 0:22:00:000 | 3885.7 | 149.9 | 0 | 54.9 54947.8 2 | 6 | 2468 0:22:05:000 | 3885.4 | 149.9 | 0 | 55.2 55156.3 2 | 6 | 2469 0:22:10:000 | 3885.4 | 150.2 | 0 | 55.4 55364.9 2 | 6 | 2470 0:22:15:000 | 3886.4 | 150.2 | 0 | 55.6 55573.5 2 | 6 | 2471 0:22:20:000 | 3887.3 | 150.2 | 0 | 55.8 55782.1 2 | 6 | 2472 0:22:25:000 | 3887.3 | 149.9 | 0 | 56 55990.4 2 | 6 | 2473 0:22:30:000 | 3887.9 | 150.2 | 0 | 56.2 56198.9 2 | 6 | 2474 0:22:35:000 | 3888.2 | 149.9 | 0 | 56.4 56407.2 2 | 6 | 2475 0:22:40:000 | 3888.5 | 149.9 | 0 | 56.6 56615.4 2 | 6 | 2476 0:22:45:000 | 3888.8 | 150.2 | 0 | 56.8 56823.7 2 | 6 | 2477 0:22:50:000 | 3889.1 | 150.2 | 0 | 57 57032.2 2 | 6 | 2478 0:22:55:000 | 3889.8 | 150.2 | 0 | 57.2 57240.7 2 | 6 | 2479 0:23:00:000 | 3889.8 | 149.9 | 0 | 57.4 57448.9 2 | 6 | 2480 0:23:05:000 | 3890.4 | 149.9 | 0 | 57.7 57657.1 2 | 6 | 2481 0:23:10:000 | 3890.4 | 150.2 | 0 | 57.9 57865.4 2 | 6 | 2482 0:23:15:000 | 3891 | 150.2 | 0 | 58.1 58073.9 2 | 6 | 2483 0:23:20:000 | 3891.6 | 150.2 | 0 | 58.3 58282.3 2 | 6 | 2484 0:23:25:000 | 3891.6 | 149.9 | 0 | 58.5 58490.6 2 | 6 | 2485 0:23:30:000 | 3892.2 | 150.2 | 0 | 58.7 | 58699 2 | 6 | 2486 0:23:35:000 | 3892.6 | 149.9 | 0 | 58.9 58907.3 2 | 6 | 2487 0:23:40:000 | 3892.9 | 150.2 | 0 | 59.1 59115.8 2 | 6 | 2488 0:23:45:000 | 3893.5 | 150.2 | 0 | 59.3 59324.2 2 | 6 | 2489 0:23:50:000 | 3893.8 | 149.9 | 0 | 59.5 59532.5 2 | 6 | 2490 0:23:55:000 | 3894.1 | 149.9 | 0 | 59.7 59740.7 2 | 6 | 2491 0:24:00:000 | 3894.4 | 149.9 | 0 | 59.9 59949.1 2 | 6 | 2492 0:24:05:000 | 3894.7 | 150.2 | 0 | 60.2 60157.4 2 | 6 | 2493 0:24:10:000 | 3895.3 | 149.9 | 0 | 60.4 60365.6 2 | 6 | 2494 0:24:15:000 | 3895.7 | 149.9 | 0 | 60.6 60573.9 2 | 6 | 2495 0:24:20:000 | 3896 | 150.2 | 0 | 60.8 60782.3 2 | 6 | 2496 0:24:25:000 | 3896.6 | 149.9 | 0 | 61 60990.7 2 | 6 | 2497 0:24:30:000 | 3896.6 | 149.9 | 0 | 61.2 61198.9

2 | 6 | 2498 0:24:35:000 | 3897.2 | 149.9 | 0 | 61.4 61407.3 2 | 6 | 2499 0:24:40:000 | 3897.5 | 150.2 | 0 | 61.6 61615.6 2 | 6 | 2500 0:24:45:000 | 3898.1 | 150.2 | 0 | 61.8 61823.9 2 | 6 | 2501 0:24:50:000 | 3898.4 | 149.9 | 0 | 62 62032.3 2 | 6 | 2502 0:24:55:000 | 3898.8 | 149.9 | 0 | 62.2 62240.6 2 | 6 | 2503 0:25:00:000 | 3899.1 | 149.9 | 0 | 62.4 62448.9 2 | 6 | 2504 0:25:05:000 | 3899.7 | 149.9 | 0 | 62.7 62657.1 2 | 6 | 2505 0:25:10:000 | 3900 | 149.9 | 0 | 62.9 62865.5 2 | 6 | 2506 0:25:15:000 | 3900.3 | 149.9 | 0 | 63.1 63073.8 2 | 6 | 2507 0:25:20:000 | 3900.9 | 149.9 | 0 | 63.3 | 63282 2 | 6 | 2508 0:25:25:000 | 3901.2 | 149.9 | 0 | 63.5 63490.3 2 | 6 | 2509 0:25:30:000 | 3901.9 | 149.9 | 0 | 63.7 63698.6 2 | 6 | 2510 0:25:35:000 | 3902.2 | 149.9 | 0 | 63.9 63906.7 2 | 6 | 2511 0:25:40:000 | 3902.8 | 150.2 | 0 | 64.1 64115.2 2 | 6 | 2512 0:25:45:000 | 3903.4 | 149.9 | 0 | 64.3 64323.5 2 | 6 | 2513 0:25:50:000 | 3903.7 | 149.9 | 0 | 64.5 64531.8 2 | 6 | 2514 0:25:55:000 | 3904.3 | 149.9 | 0 | 64.7 64739.9 2 | 6 | 2515 0:26:00:000 | 3904.6 | 150.2 | 0 | 64.9 64948.3 2 | 6 | 2516 0:26:05:000 | 3905 | 149.9 | 0 | 65.2 65156.5 2 | 6 | 2517 0:26:10:000 | 3905.6 | 149.9 | 0 | 65.4 65364.7 2 | 6 | 2518 0:26:15:000 | 3905.9 | 149.9 | 0 | 65.6 65572.9 2 | 6 | 2519 0:26:20:000 | 3906.5 | 150.2 | 0 | 65.8 65781.3 2 | 6 | 2520 0:26:25:000 | 3906.8 | 150.2 | 0 | 66 65989.7 2 | 6 | 2521 0:26:30:000 | 3907.4 | 149.9 | 0 | 66.2 66197.9 2 | 6 | 2522 0:26:35:000 | 3907.8 | 149.9 | 0 | 66.4 66406.1 2 | 6 | 2523 0:26:40:000 | 3908.4 | 149.9 | 0 | 66.6 66614.3 2 | 6 | 2524 0:26:45:000 | 3908.7 | 149.9 | 0 | 66.8 66822.5 2 | 6 | 2525 0:26:50:000 | 3909 | 150.2 | 0 | 67 67030.9 2 | 6 | 2526 0:26:55:000 | 3909.6 | 149.9 | 0 | 67.2 67239.1 2 | 6 | 2527 0:27:00:000 | 3909.9 | 149.9 | 0 | 67.4 67447.6 2 | 6 | 2528 0:27:05:000 | 3910.5 | 149.9 | 0 | 67.7 67655.8 2 | 6 | 2529 0:27:10:000 | 3910.9 | 149.9 | 0 | 67.9 | 67864 2 | 6 | 2530 0:27:15:000 | 3911.5 | 150.2 | 0 | 68.1 68072.5 2 | 6 | 2531 0:27:20:000 | 3911.8 | 149.9 | 0 | 68.3 68280.8 2 | 6 | 2532 0:27:25:000 | 3912.4 | 149.9 | 0 | 68.5 68489.1 2 | 6 | 2533 0:27:30:000 | 3912.7 | 149.9 | 0 | 68.7 68697.3 2 | 6 | 2534 0:27:35:000 | 3913.3 | 149.9 | 0 | 68.9 68905.6 2 | 6 | 2535 0:27:40:000 | 3913.6 | 149.9 | 0 | 69.1 69113.8 2 | 6 | 2536 0:27:45:000 | 3914.3 | 149.9 | 0 | 69.3 | 69322 2 | 6 | 2537 0:27:50:000 | 3914.9 | 150.2 | 0 | 69.5 69530.5 2 | 6 | 2538 0:27:55:000 | 3915.2 | 149.9 | 0 | 69.7 69738.8 2 | 6 | 2539 0:28:00:000 | 3915.8 | 149.9 | 0 | 69.9 | 69947 2 | 6 | 2540 0:28:05:000 | 3916.1 | 150.2 | 0 | 70.2 70155.3 2 | 6 | 2541 0:28:10:000 | 3916.7 | 150.2 | 0 | 70.4 70363.9 2 | 6 | 2542 0:28:15:000 | 3917.4 | 150.2 | 0 | 70.6 70572.2 2 | 6 | 2543 0:28:20:000 | 3918 | 149.9 | 0 | 70.8 70780.5 2 | 6 | 2544 0:28:25:000 | 3918.3 | 149.9 | 0 | 71 70988.9 2 | 6 | 2545 0:28:30:000 | 3918.6 | 150.2 | 0 | 71.2 71197.1 2 | 6 | 2546 0:28:35:000 | 3919.2 | 149.9 | 0 | 71.4 71405.6 2 | 6 | 2547 0:28:40:000 | 3919.8 | 149.9 | 0 | 71.6 71613.9 2 | 6 | 2548 0:28:45:000 | 3920.5 | 149.9 | 0 | 71.8 71822.1

2 | 6 | 2549 0:28:50:000 | 3921.1 | 149.9 | 0 | 72 72030.3 2 | 6 | 2550 0:28:55:000 | 3921.4 | 150.2 | 0 | 72.2 72238.6 2 | 6 | 2551 0:29:00:000 | 3921.7 | 149.9 | 0 | 72.4 72446.8 2 | 6 | 2552 0:29:05:000 | 3922.6 | 149.9 | 0 | 72.7 72655.2 2 | 6 | 2553 0:29:10:000 | 3923.3 | 149.9 | 0 | 72.9 72863.4 2 | 6 | 2554 0:29:15:000 | 3923.9 | 149.9 | 0 | 73.1 73071.7 2 | 6 | 2555 0:29:20:000 | 3924.2 | 149.9 | 0 | 73.3 | 73280 2 | 6 | 2556 0:29:25:000 | 3924.8 | 149.9 | 0 | 73.5 73488.2 2 | 6 | 2557 0:29:30:000 | 3925.1 | 149.9 | 0 | 73.7 73696.4 2 | 6 | 2558 0:29:35:000 | 3926.4 | 149.9 | 0 | 73.9 73904.6 2 | 6 | 2559 0:29:40:000 | 3926.4 | 149.9 | 0 | 74.1 74112.9 2 | 6 | 2560 0:29:45:000 | 3927 | 149.9 | 0 | 74.3 74321.3 2 | 6 | 2561 0:29:50:000 | 3927.6 | 150.2 | 0 | 74.5 74529.8 2 | 6 | 2562 0:29:55:000 | 3928.2 | 150.2 | 0 | 74.7 74738.4 2 | 6 | 2563 0:30:00:000 | 3928.5 | 150.2 | 0 | 74.9 74946.9 2 | 6 | 2564 0:30:05:000 | 3929.1 | 149.9 | 0 | 75.2 75155.3 2 | 6 | 2565 0:30:10:000 | 3929.5 | 150.2 | 0 | 75.4 75363.6 2 | 6 | 2566 0:30:15:000 | 3930.1 | 149.9 | 0 | 75.6 75571.8 2 | 6 | 2567 0:30:20:000 | 3930.7 | 149.9 | 0 | 75.8 75780.3 2 | 6 | 2568 0:30:25:000 | 3931.3 | 150.2 | 0 | 76 75988.6 2 | 6 | 2569 0:30:30:000 | 3931.9 | 150.2 | 0 | 76.2 76197.1 2 | 6 | 2570 0:30:35:000 | 3932.6 | 149.9 | 0 | 76.4 76405.3 2 | 6 | 2571 0:30:40:000 | 3932.9 | 149.9 | 0 | 76.6 76613.7 2 | 6 | 2572 0:30:45:000 | 3933.8 | 149.9 | 0 | 76.8 76822.1 2 | 6 | 2573 0:30:50:000 | 3934.1 | 149.9 | 0 | 77 77030.3 2 | 6 | 2574 0:30:55:000 | 3934.7 | 149.9 | 0 | 77.2 77238.5 2 | 6 | 2575 0:31:00:000 | 3935.3 | 149.9 | 0 | 77.4 77446.7 2 | 6 | 2576 0:31:05:000 | 3935.7 | 149.9 | 0 | 77.7 77655.1 2 | 6 | 2577 0:31:10:000 | 3936.3 | 150.2 | 0 | 77.9 77863.4 2 | 6 | 2578 0:31:15:000 | 3936.9 | 149.9 | 0 | 78.1 78071.7 2 | 6 | 2579 0:31:20:000 | 3937.5 | 149.9 | 0 | 78.3 78279.9 2 | 6 | 2580 0:31:25:000 | 3938.1 | 149.9 | 0 | 78.5 78488.4 2 | 6 | 2581 0:31:30:000 | 3938.8 | 149.9 | 0 | 78.7 78696.7 2 | 6 | 2582 0:31:35:000 | 3939.4 | 149.9 | 0 | 78.9 | 78905 2 | 6 | 2583 0:31:40:000 | 3940 | 150.2 | 0 | 79.1 79113.4 2 | 6 | 2584 0:31:45:000 | 3940.3 | 149.9 | 0 | 79.3 79321.7 2 | 6 | 2585 0:31:50:000 | 3941.2 | 150.2 | 0 | 79.5 79530.3 2 | 6 | 2586 0:31:55:000 | 3940.6 | 150.2 | 0 | 79.7 79738.8 2 | 6 | 2587 0:32:00:000 | 3942.2 | 150.2 | 0 | 79.9 79947.3 2 | 6 | 2588 0:32:05:000 | 3942.2 | 150.2 | 0 | 80.2 80155.9 2 | 6 | 2589 0:32:10:000 | 3943.4 | 150.2 | 0 | 80.4 80364.4 2 | 6 | 2590 0:32:15:000 | 3943.1 | 150.2 | 0 | 80.6 80573.1 2 | 6 | 2591 0:32:20:000 | 3944.3 | 150.2 | 0 | 80.8 80781.7 2 | 6 | 2592 0:32:25:000 | 3945.3 | 150.2 | 0 | 81 80990.1 2 | 6 | 2593 0:32:30:000 | 3945.9 | 149.9 | 0 | 81.2 81198.6 2 | 6 | 2594 0:32:35:000 | 3946.5 | 150.2 | 0 | 81.4 81407.1 2 | 6 | 2595 0:32:40:000 | 3947.1 | 150.2 | 0 | 81.6 81615.5 2 | 6 | 2596 0:32:45:000 | 3947.1 | 150.2 | 0 | 81.8 81824.1 2 | 6 | 2597 0:32:50:000 | 3948.7 | 149.9 | 0 | 82 82032.5 2 | 6 | 2598 0:32:55:000 | 3948.7 | 150.2 | 0 | 82.2 82241.1 2 | 6 | 2599 0:33:00:000 | 3949.3 | 150.2 | 0 | 82.4 82449.8

2 | 6 | 2600 0:33:05:000 | 3949 | 150.2 | 0 | 82.7 82658.4 2 | 6 | 2601 0:33:10:000 | 3949.6 | 150.4 | 0 | 82.9 82867.1 2 | 6 | 2602 0:33:15:000 | 3951.2 | 150.2 | 0 | 83.1 83075.7 2 | 6 | 2603 0:33:20:000 | 3951.8 | 150.2 | 0 | 83.3 83284.3 2 | 6 | 2604 0:33:25:000 | 3952.7 | 150.2 | 0 | 83.5 83492.9 2 | 6 | 2605 0:33:30:000 | 3953.6 | 149.9 | 0 | 83.7 83701.2 2 | 6 | 2606 0:33:35:000 | 3953.9 | 149.9 | 0 | 83.9 83909.7 2 | 6 | 2607 0:33:40:000 | 3954.6 | 149.9 | 0 | 84.1 84118.1 2 | 6 | 2608 0:33:45:000 | 3955.2 | 149.9 | 0 | 84.3 84326.6 2 | 6 | 2609 0:33:50:000 | 3956.1 | 150.2 | 0 | 84.5 84535.3 2 | 6 | 2610 0:33:55:000 | 3956.7 | 150.2 | 0 | 84.7 84743.8 2 | 6 | 2611 0:34:00:000 | 3957 | 150.2 | 0 | 85 84952.3 2 | 6 | 2612 0:34:05:000 | 3957.7 | 150.2 | 0 | 85.2 85160.7 2 | 6 | 2613 0:34:10:000 | 3958.6 | 149.9 | 0 | 85.4 | 85369 2 | 6 | 2614 0:34:15:000 | 3959.2 | 149.9 | 0 | 85.6 85577.4 2 | 6 | 2615 0:34:20:000 | 3958.3 | 150.2 | 0 | 85.8 | 85786 2 | 6 | 2616 0:34:25:000 | 3959.2 | 150.4 | 0 | 86 85994.7 2 | 6 | 2617 0:34:30:000 | 3959.8 | 150.2 | 0 | 86.2 86203.3 2 | 6 | 2618 0:34:35:000 | 3961.4 | 150.2 | 0 | 86.4 86411.9 2 | 6 | 2619 0:34:40:000 | 3961.7 | 150.2 | 0 | 86.6 86620.5 2 | 6 | 2620 0:34:45:000 | 3962.3 | 150.2 | 0 | 86.8 86829.1 2 | 6 | 2621 0:34:50:000 | 3963.6 | 150.4 | 0 | 87 87037.8 2 | 6 | 2622 0:34:55:000 | 3964.8 | 150.2 | 0 | 87.2 87246.4 2 | 6 | 2623 0:35:00:000 | 3964.5 | 150.2 | 0 | 87.5 | 87455 2 | 6 | 2624 0:35:05:000 | 3964.5 | 150.2 | 0 | 87.7 87663.6 2 | 6 | 2625 0:35:10:000 | 3965.1 | 150.4 | 0 | 87.9 87872.4 2 | 6 | 2626 0:35:15:000 | 3966 | 150.2 | 0 | 88.1 88080.8 2 | 6 | 2627 0:35:20:000 | 3966.3 | 150.2 | 0 | 88.3 88289.4 2 | 6 | 2628 0:35:25:000 | 3966.7 | 150.4 | 0 | 88.5 | 88498 2 | 6 | 2629 0:35:30:000 | 3967.9 | 149.9 | 0 | 88.7 88706.3 2 | 6 | 2630 0:35:35:000 | 3968.2 | 150.2 | 0 | 88.9 88914.7 2 | 6 | 2631 0:35:40:000 | 3968.8 | 150.2 | 0 | 89.1 89123.3 2 | 6 | 2632 0:35:45:000 | 3969.4 | 150.2 | 0 | 89.3 89331.8 2 | 6 | 2633 0:35:50:000 | 3970.4 | 150.2 | 0 | 89.5 89540.3 2 | 6 | 2634 0:35:55:000 | 3971.3 | 150.2 | 0 | 89.7 89748.8 2 | 6 | 2635 0:36:00:000 | 3971.6 | 149.9 | 0 | 90 89956.8 2 | 6 | 2636 0:36:05:000 | 3972.5 | 150.2 | 0 | 90.2 90165.1 2 | 6 | 2637 0:36:10:000 | 3972.9 | 149.5 | 0 | 90.4 90372.9 2 | 6 | 2638 0:36:15:000 | 3973.8 | 149.5 | 0 | 90.6 90580.7 2 | 6 | 2639 0:36:20:000 | 3974.7 | 149.5 | 0 | 90.8 90788.7 2 | 6 | 2640 0:36:25:000 | 3975.6 | 149.7 | 0 | 91 90996.7 2 | 6 | 2641 0:36:30:000 | 3976.6 | 149.3 | 0 | 91.2 91204.2 2 | 6 | 2642 0:36:35:000 | 3977.5 | 149.5 | 0 | 91.4 91411.7 2 | 6 | 2643 0:36:40:000 | 3977.8 | 149.5 | 0 | 91.6 91619.4 2 | 6 | 2644 0:36:45:000 | 3977.8 | 149.7 | 0 | 91.8 91827.3 2 | 6 | 2645 0:36:50:000 | 3979.7 | 149.3 | 0 | 92 92034.8 2 | 6 | 2646 0:36:55:000 | 3980.6 | 149.5 | 0 | 92.2 92242.4 2 | 6 | 2647 0:37:00:000 | 3979.7 | 149.5 | 0 | 92.4 | 92450 2 | 6 | 2648 0:37:05:000 | 3980.6 | 149.5 | 0 | 92.7 92657.6 2 | 6 | 2649 0:37:10:000 | 3982.5 | 149.3 | 0 | 92.9 92865.2 2 | 6 | 2650 0:37:15:000 | 3982.2 | 149.3 | 0 | 93.1 93072.8

2 | 6 | 2651 0:37:20:000 | 3982.8 | 149.7 | 0 | 93.3 93280.9 2 | 6 | 2652 0:37:25:000 | 3984.3 | 150.2 | 0 | 93.5 | 93489 2 | 6 | 2653 0:37:30:000 | 3984.3 | 149.9 | 0 | 93.7 93696.9 2 | 6 | 2654 0:37:35:000 | 3985.9 | 149.5 | 0 | 93.9 | 93905 2 | 6 | 2655 0:37:40:000 | 3985.6 | 149.7 | 0 | 94.1 | 94113 2 | 6 | 2656 0:37:45:000 | 3987.1 | 149.7 | 0 | 94.3 94320.7 2 | 6 | 2657 0:37:50:000 | 3987.1 | 149.7 | 0 | 94.5 94528.6 2 | 6 | 2658 0:37:55:000 | 3988.4 | 149.7 | 0 | 94.7 94736.6 2 | 6 | 2659 0:38:00:000 | 3989.6 | 149.3 | 0 | 94.9 94944.3 2 | 6 | 2660 0:38:05:000 | 3989.9 | 149.9 | 0 | 95.2 95152.4 2 | 6 | 2661 0:38:10:000 | 3989.9 | 149.7 | 0 | 95.4 95360.2 2 | 6 | 2662 0:38:15:000 | 3990.5 | 149.7 | 0 | 95.6 | 95568 2 | 6 | 2663 0:38:20:000 | 3991.5 | 149.7 | 0 | 95.8 | 95776 2 | 6 | 2664 0:38:25:000 | 3990.5 | 145.4 | 0 | 96 95980.6 2 | 6 | 2665 0:38:30:000 | 3991.8 | 143.9 | 0 | 96.2 96181.1 2 | 6 | 2666 0:38:35:000 | 3990.5 | 142.8 | 0 | 96.4 96379.8 2 | 6 | 2667 0:38:40:000 | 3991.5 | 141.1 | 0 | 96.6 96576.2 2 | 6 | 2668 0:38:45:000 | 3991.1 | 140 | 0 | 96.8 96770.9 2 | 6 | 2669 0:38:50:000 | 3990.8 | 138.7 | 0 | 97 96963.9 2 | 6 | 2670 0:38:55:000 | 3992.1 | 137.2 | 0 | 97.2 97154.8 2 | 6 | 2671 0:39:00:000 | 3991.8 | 135.7 | 0 | 97.3 97343.8 2 | 6 | 2672 0:39:05:000 | 3991.5 | 134.6 | 0 | 97.5 97531.4 2 | 6 | 2673 0:39:10:000 | 3991.8 | 133.1 | 0 | 97.7 97716.9 2 | 6 | 2674 0:39:15:000 | 3991.8 | 132.4 | 0 | 97.9 | 97901 2 | 6 | 2675 0:39:20:000 | 3991.5 | 131.1 | 0 | 98.1 98083.5 2 | 6 | 2676 0:39:25:000 | 3991.8 | 129.4 | 0 | 98.3 98264.3 2 | 6 | 2677 0:39:30:000 | 3991.8 | 128.5 | 0 | 98.4 98443.2 2 | 6 | 2678 0:39:35:000 | 3991.8 | 127.6 | 0 | 98.6 98620.6 2 | 6 | 2679 0:39:40:000 | 3991.8 | 126.4 | 0 | 98.8 98796.9 2 | 6 | 2680 0:39:45:000 | 3991.1 | 125.1 | 0 | 99 98971.1 2 | 6 | 2681 0:39:50:000 | 3991.1 | 124.4 | 0 | 99.1 | 99144 2 | 6 | 2682 0:39:55:000 | 3991.8 | 122.9 | 0 | 99.3 99315.3 2 | 6 | 2683 0:40:00:000 | 3992.1 | 122 | 0 | 99.5 | 99485 2 | 6 | 2684 0:40:05:000 | 3992.1 | 120.7 | 0 | 99.7 99653.3 2 | 6 | 2685 0:40:10:000 | 3992.1 | 119.7 | 0 | 99.8 | 99820 2 | 6 | 2686 0:40:15:000 | 3992.1 | 118.8 | 0 | 100 99985.4 2 | 6 | 2687 0:40:20:000 | 3991.8 | 117.9 | 0 | 100.1 | 100150 2 | 6 | 2688 0:40:25:000 | 3992.1 | 116.8 | 0 | 100.3 | 100312 2 | 6 | 2689 0:40:30:000 | 3991.8 | 115.6 | 0 | 100.5 | 100473 2 | 6 | 2690 0:40:35:000 | 3992.1 | 114.7 | 0 | 100.6 | 100633 2 | 6 | 2691 0:40:40:000 | 3992.1 | 114 | 0 | 100.8 | 100791 2 | 6 | 2692 0:40:45:000 | 3992.1 | 112.7 | 0 | 100.9 | 100948 2 | 6 | 2693 0:40:50:000 | 3992.1 | 111.9 | 0 | 101.1 | 101104 2 | 6 | 2694 0:40:55:000 | 3992.1 | 110.8 | 0 | 101.3 | 101258 2 | 6 | 2695 0:41:00:000 | 3992.1 | 109.9 | 0 | 101.4 | 101411 2 | 6 | 2696 0:41:05:000 | 3992.1 | 108.8 | 0 | 101.6 | 101563 2 | 6 | 2697 0:41:10:000 | 3992.1 | 107.8 | 0 | 101.7 | 101713 2 | 6 | 2698 0:41:15:000 | 3991.8 | 107.1 | 0 | 101.9 | 101862 2 | 6 | 2699 0:41:20:000 | 3992.1 | 106 | 0 | 102 | 102009 2 | 6 | 2700 0:41:25:000 | 3992.1 | 105 | 0 | 102.2 | 102156 2 | 6 | 2701 0:41:30:000 | 3992.1 | 104.1 | 0 | 102.3 | 102301

2 | 6 | 2702 0:41:35:000 | 3992.1 | 103.4 | 0 | 102.4 | 102445 2 | 6 | 2703 0:41:40:000 | 3992.1 | 102.3 | 0 | 102.6 | 102587 2 | 6 | 2704 0:41:45:000 | 3992.1 | 101.5 | 0 | 102.7 | 102729 2 | 6 | 2705 0:41:50:000 | 3992.1 | 100.6 | 0 | 102.9 | 102869 2 | 6 | 2706 0:41:55:000 | 3991.8 | 99.8 | 0 | 103 | 103007 2 | 6 | 2707 0:42:00:000 | 3992.1 | 98.9 | 0 | 103.1 | 103145 2 | 6 | 2708 0:42:05:000 | 3992.1 | 98 | 0 | 103.3 | 103282 2 | 6 | 2709 0:42:10:000 | 3992.1 | 97 | 0 | 103.4 | 103417 2 | 6 | 2710 0:42:15:000 | 3992.1 | 96.3 | 0 | 103.6 | 103551 2 | 6 | 2711 0:42:20:000 | 3992.1 | 95.4 | 0 | 103.7 | 103684 2 | 6 | 2712 0:42:25:000 | 3991.8 | 94.6 | 0 | 103.8 | 103816 2 | 6 | 2713 0:42:30:000 | 3992.1 | 93.9 | 0 | 103.9 | 103946 2 | 6 | 2714 0:42:35:000 | 3992.1 | 93.1 | 0 | 104.1 | 104076 2 | 6 | 2715 0:42:40:000 | 3992.1 | 92 | 0 | 104.2 | 104204 2 | 6 | 2716 0:42:45:000 | 3992.1 | 91.3 | 0 | 104.3 | 104331 2 | 6 | 2717 0:42:50:000 | 3992.1 | 90.5 | 0 | 104.5 | 104458 2 | 6 | 2718 0:42:55:000 | 3992.1 | 89.8 | 0 | 104.6 | 104583 2 | 6 | 2719 0:43:00:000 | 3992.1 | 89 | 0 | 104.7 | 104707 2 | 6 | 2720 0:43:05:000 | 3991.8 | 88.1 | 0 | 104.8 | 104829 2 | 6 | 2721 0:43:10:000 | 3991.8 | 87.4 | 0 | 105 | 104951 2 | 6 | 2722 0:43:15:000 | 3992.1 | 86.6 | 0 | 105.1 | 105072 2 | 6 | 2723 0:43:20:000 | 3992.1 | 86.1 | 0 | 105.2 | 105192 2 | 6 | 2724 0:43:25:000 | 3992.1 | 85 | 0 | 105.3 | 105310 2 | 6 | 2725 0:43:30:000 | 3992.1 | 84.6 | 0 | 105.4 | 105428 2 | 6 | 2726 0:43:35:000 | 3992.1 | 83.7 | 0 | 105.5 | 105544 2 | 6 | 2727 0:43:40:000 | 3992.1 | 83.1 | 0 | 105.7 | 105660 2 | 6 | 2728 0:43:45:000 | 3992.1 | 82.4 | 0 | 105.8 | 105775 2 | 6 | 2729 0:43:50:000 | 3992.1 | 81.8 | 0 | 105.9 | 105888 2 | 6 | 2730 0:43:55:000 | 3992.1 | 80.9 | 0 | 106 | 106001 2 | 6 | 2731 0:44:00:000 | 3992.1 | 80.3 | 0 | 106.1 | 106113 2 | 6 | 2732 0:44:05:000 | 3991.8 | 79.6 | 0 | 106.2 | 106224 2 | 6 | 2733 0:44:10:000 | 3992.1 | 78.8 | 0 | 106.3 | 106333 2 | 6 | 2734 0:44:15:000 | 3992.1 | 78.3 | 0 | 106.4 | 106442 2 | 6 | 2735 0:44:20:000 | 3992.1 | 77.5 | 0 | 106.6 | 106550 2 | 6 | 2736 0:44:25:000 | 3992.1 | 76.8 | 0 | 106.7 | 106657 2 | 6 | 2737 0:44:30:000 | 3992.1 | 76.2 | 0 | 106.8 | 106763 2 | 6 | 2738 0:44:35:000 | 3992.1 | 75.5 | 0 | 106.9 | 106869 2 | 6 | 2739 0:44:40:000 | 3991.8 | 74.9 | 0 | 107 | 106973 2 | 6 | 2740 0:44:45:000 | 3992.1 | 74.4 | 0 | 107.1 | 107076 2 | 6 | 2741 0:44:50:000 | 3992.1 | 73.8 | 0 | 107.2 | 107179 2 | 6 | 2742 0:44:55:000 | 3992.1 | 72.9 | 0 | 107.3 | 107281 2 | 6 | 2743 0:45:00:000 | 3992.1 | 72.3 | 0 | 107.4 | 107381 2 | 6 | 2744 0:45:05:000 | 3992.1 | 71.6 | 0 | 107.5 | 107481 2 | 6 | 2745 0:45:10:000 | 3992.1 | 71 | 0 | 107.6 | 107580 2 | 6 | 2746 0:45:15:000 | 3992.1 | 70.6 | 0 | 107.7 | 107678 2 | 6 | 2747 0:45:20:000 | 3992.1 | 69.9 | 0 | 107.8 | 107776 2 | 6 | 2748 0:45:25:000 | 3992.1 | 69.3 | 0 | 107.9 | 107872 2 | 6 | 2749 0:45:30:000 | 3992.1 | 68.6 | 0 | 108 | 107968 2 | 6 | 2750 0:45:35:000 | 3992.1 | 68 | 0 | 108.1 | 108063 2 | 6 | 2751 0:45:40:000 | 3992.1 | 67.5 | 0 | 108.2 | 108157 2 | 6 | 2752 0:45:45:000 | 3992.1 | 66.9 | 0 | 108.2 | 108250

2 | 6 | 2753 0:45:50:000 | 3992.1 | 66.4 | 0 | 108.3 | 108342 2 | 6 | 2754 0:45:55:000 | 3992.1 | 66 | 0 | 108.4 | 108434 2 | 6 | 2755 0:46:00:000 | 3992.1 | 65.4 | 0 | 108.5 | 108525 2 | 6 | 2756 0:46:05:000 | 3992.1 | 64.7 | 0 | 108.6 | 108615 2 | 6 | 2757 0:46:10:000 | 3992.1 | 64.1 | 0 | 108.7 | 108704 2 | 6 | 2758 0:46:15:000 | 3992.1 | 63.6 | 0 | 108.8 | 108793 2 | 6 | 2759 0:46:20:000 | 3992.1 | 63 | 0 | 108.9 | 108881 2 | 6 | 2760 0:46:25:000 | 3992.1 | 62.5 | 0 | 109 | 108968 2 | 6 | 2761 0:46:30:000 | 3992.1 | 62.1 | 0 | 109.1 | 109054 2 | 6 | 2762 0:46:35:000 | 3992.1 | 61.5 | 0 | 109.1 | 109140 2 | 6 | 2763 0:46:40:000 | 3992.1 | 61 | 0 | 109.2 | 109225 2 | 6 | 2764 0:46:45:000 | 3992.1 | 60.4 | 0 | 109.3 | 109309 2 | 6 | 2765 0:46:50:000 | 3992.1 | 60 | 0 | 109.4 | 109392 2 | 6 | 2766 0:46:55:000 | 3992.1 | 59.5 | 0 | 109.5 | 109475 2 | 6 | 2767 0:47:00:000 | 3992.1 | 59.1 | 0 | 109.6 | 109557 2 | 6 | 2768 0:47:05:000 | 3992.1 | 58.5 | 0 | 109.6 | 109639 2 | 6 | 2769 0:47:10:000 | 3992.1 | 58 | 0 | 109.7 | 109719 2 | 6 | 2770 0:47:15:000 | 3992.1 | 57.6 | 0 | 109.8 | 109800 2 | 6 | 2771 0:47:20:000 | 3992.1 | 57.1 | 0 | 109.9 | 109879 2 | 6 | 2772 0:47:25:000 | 3992.1 | 56.5 | 0 | 110 | 109958 2 | 6 | 2773 0:47:30:000 | 3992.1 | 56.1 | 0 | 110 | 110036 2 | 6 | 2774 0:47:35:000 | 3992.1 | 55.4 | 0 | 110.1 | 110113 2 | 6 | 2775 0:47:40:000 | 3992.1 | 55 | 0 | 110.2 | 110190 2 | 6 | 2776 0:47:45:000 | 3992.1 | 54.6 | 0 | 110.3 | 110266 2 | 6 | 2777 0:47:50:000 | 3991.8 | 54.3 | 0 | 110.3 | 110342 2 | 6 | 2778 0:47:55:000 | 3992.1 | 53.7 | 0 | 110.4 | 110417 2 | 6 | 2779 0:48:00:000 | 3992.1 | 53.3 | 0 | 110.5 | 110491 2 | 6 | 2780 0:48:05:000 | 3992.1 | 53 | 0 | 110.6 | 110565 2 | 6 | 2781 0:48:10:000 | 3992.1 | 52.2 | 0 | 110.6 | 110637 2 | 6 | 2782 0:48:15:000 | 3992.1 | 51.8 | 0 | 110.7 | 110710 2 | 6 | 2783 0:48:20:000 | 3992.1 | 51.7 | 0 | 110.8 | 110781 2 | 6 | 2784 0:48:25:000 | 3992.1 | 51.1 | 0 | 110.9 | 110853 2 | 6 | 2785 0:48:30:000 | 3992.1 | 50.7 | 0 | 110.9 | 110923 2 | 6 | 2786 0:48:35:000 | 3992.1 | 50.4 | 0 | 111 | 110993 2 | 6 | 2787 0:48:40:000 | 3992.1 | 50 | 0 | 111.1 | 111063 2 | 6 | 2788 0:48:45:000 | 3992.1 | 49.4 | 0 | 111.1 | 111132 2 | 6 | 2789 0:48:50:000 | 3992.1 | 49.1 | 0 | 111.2 | 111200 2 | 6 | 2790 0:48:55:000 | 3992.1 | 48.9 | 0 | 111.3 | 111268 2 | 6 | 2791 0:49:00:000 | 3992.1 | 48.1 | 0 | 111.3 | 111335 2 | 6 | 2792 0:49:05:000 | 3992.1 | 47.8 | 0 | 111.4 | 111401 2 | 6 | 2793 0:49:10:000 | 3992.1 | 47.4 | 0 | 111.5 | 111467 2 | 6 | 2794 0:49:15:000 | 3992.1 | 47 | 0 | 111.5 | 111533 2 | 6 | 2795 0:49:20:000 | 3992.1 | 46.6 | 0 | 111.6 | 111598 2 | 6 | 2796 0:49:25:000 | 3992.1 | 46.3 | 0 | 111.7 | 111662 2 | 6 | 2797 0:49:30:000 | 3992.1 | 46.1 | 0 | 111.7 | 111727 2 | 6 | 2798 0:49:35:000 | 3992.1 | 45.7 | 0 | 111.8 | 111790 2 | 6 | 2799 0:49:40:000 | 3992.1 | 45.3 | 0 | 111.9 | 111853 2 | 6 | 2800 0:49:45:000 | 3992.1 | 45 | 0 | 111.9 | 111916 2 | 6 | 2801 0:49:50:000 | 3992.1 | 44.4 | 0 | 112 | 111978 2 | 6 | 2802 0:49:55:000 | 3991.8 | 44 | 0 | 112 | 112039 2 | 6 | 2803 0:50:00:000 | 3992.1 | 43.8 | 0 | 112.1 | 112100

2 | 6 | 2804 0:50:05:000 | 3992.1 | 43.5 | 0 | 112.2 | 112160 2 | 6 | 2805 0:50:10:000 | 3992.1 | 43.1 | 0 | 112.2 | 112220 2 | 6 | 2806 0:50:15:000 | 3991.8 | 42.7 | 0 | 112.3 | 112280 2 | 6 | 2807 0:50:20:000 | 3992.1 | 42.4 | 0 | 112.3 | 112339 2 | 6 | 2808 0:50:25:000 | 3992.1 | 42 | 0 | 112.4 | 112397 2 | 6 | 2809 0:50:30:000 | 3992.1 | 41.8 | 0 | 112.5 | 112455 2 | 6 | 2810 0:50:35:000 | 3992.1 | 41.4 | 0 | 112.5 | 112513 2 | 6 | 2811 0:50:40:000 | 3992.1 | 41.1 | 0 | 112.6 | 112570 2 | 6 | 2812 0:50:45:000 | 3991.8 | 40.7 | 0 | 112.6 | 112627 2 | 6 | 2813 0:50:50:000 | 3991.8 | 40.3 | 0 | 112.7 | 112683 2 | 6 | 2814 0:50:55:000 | 3992.1 | 39.9 | 0 | 112.7 | 112739 2 | 6 | 2815 0:51:00:000 | 3992.1 | 39.6 | 0 | 112.8 | 112794 2 | 6 | 2816 0:51:05:000 | 3992.1 | 39.2 | 0 | 112.8 | 112849 2 | 6 | 2817 0:51:10:000 | 3992.1 | 39 | 0 | 112.9 | 112903 2 | 6 | 2818 0:51:15:000 | 3992.1 | 38.6 | 0 | 113 | 112957 2 | 6 | 2819 0:51:20:000 | 3992.1 | 38.5 | 0 | 113 | 113010 2 | 6 | 2820 0:51:25:000 | 3992.1 | 38.1 | 0 | 113.1 | 113063 2 | 6 | 2821 0:51:30:000 | 3992.1 | 37.9 | 0 | 113.1 | 113116 2 | 6 | 2822 0:51:35:000 | 3992.1 | 37.5 | 0 | 113.2 | 113168 2 | 6 | 2823 0:51:40:000 | 3992.1 | 37.3 | 0 | 113.2 | 113220 2 | 6 | 2824 0:51:45:000 | 3992.1 | 37 | 0 | 113.3 | 113272 2 | 6 | 2825 0:51:50:000 | 3992.1 | 36.8 | 0 | 113.3 | 113323 2 | 6 | 2826 0:51:55:000 | 3992.1 | 36.2 | 0 | 113.4 | 113374 2 | 6 | 2827 0:52:00:000 | 3992.1 | 35.9 | 0 | 113.4 | 113424 2 | 6 | 2828 0:52:05:000 | 3992.1 | 35.7 | 0 | 113.5 | 113473 2 | 6 | 2829 0:52:10:000 | 3992.1 | 35.5 | 0 | 113.5 | 113523 2 | 6 | 2830 0:52:15:000 | 3992.1 | 35.1 | 0 | 113.6 | 113572 2 | 6 | 2831 0:52:20:000 | 3992.1 | 34.7 | 0 | 113.6 | 113620 2 | 6 | 2832 0:52:25:000 | 3992.1 | 34.7 | 0 | 113.7 | 113668 2 | 6 | 2833 0:52:30:000 | 3992.1 | 34.4 | 0 | 113.7 | 113716 2 | 6 | 2834 0:52:35:000 | 3991.8 | 34.2 | 0 | 113.8 | 113764 2 | 6 | 2835 0:52:40:000 | 3992.1 | 33.8 | 0 | 113.8 | 113811 2 | 6 | 2836 0:52:45:000 | 3992.1 | 33.6 | 0 | 113.9 | 113858 2 | 6 | 2837 0:52:50:000 | 3992.1 | 33.4 | 0 | 113.9 | 113904 2 | 6 | 2838 0:52:55:000 | 3992.1 | 33.2 | 0 | 114 | 113950 2 | 6 | 2839 0:53:00:000 | 3992.1 | 32.9 | 0 | 114 | 113996 2 | 6 | 2840 0:53:05:000 | 3992.1 | 32.7 | 0 | 114 | 114042 2 | 6 | 2841 0:53:10:000 | 3992.1 | 32.5 | 0 | 114.1 | 114087 2 | 6 | 2842 0:53:15:000 | 3992.1 | 31.9 | 0 | 114.1 | 114131 2 | 6 | 2843 0:53:20:000 | 3991.8 | 31.6 | 0 | 114.2 | 114175 2 | 6 | 2844 0:53:25:000 | 3991.8 | 31.4 | 0 | 114.2 | 114219 2 | 6 | 2845 0:53:30:000 | 3992.1 | 31.2 | 0 | 114.3 | 114263 2 | 6 | 2846 0:53:35:000 | 3992.1 | 31 | 0 | 114.3 | 114306 2 | 6 | 2847 0:53:40:000 | 3992.1 | 30.6 | 0 | 114.3 | 114348 2 | 6 | 2848 0:53:45:000 | 3992.1 | 30.5 | 0 | 114.4 | 114391 2 | 6 | 2849 0:53:50:000 | 3992.1 | 30.5 | 0 | 114.4 | 114433 2 | 6 | 2850 0:53:55:000 | 3992.1 | 30.1 | 0 | 114.5 | 114475 2 | 6 | 2851 0:54:00:000 | 3992.1 | 29.9 | 0 | 114.5 | 114517 2 | 6 | 2852 0:54:05:000 | 3992.1 | 29.7 | 0 | 114.6 | 114558 2 | 6 | 2853 0:54:10:000 | 3992.1 | 29.3 | 0 | 114.6 | 114599 2 | 6 | 2854 0:54:15:000 | 3992.1 | 29.2 | 0 | 114.6 | 114640

2 | 6 | 2855 0:54:20:000 | 3992.1 | 29 | 0 | 114.7 | 114680 2 | 6 | 2856 0:54:25:000 | 3992.1 | 28.8 | 0 | 114.7 | 114720 2 | 6 | 2857 0:54:30:000 | 3992.1 | 28.6 | 0 | 114.8 | 114760 2 | 6 | 2858 0:54:35:000 | 3992.1 | 28 | 0 | 114.8 | 114799 2 | 6 | 2859 0:54:40:000 | 3992.1 | 28 | 0 | 114.8 | 114838 2 | 6 | 2860 0:54:45:000 | 3992.1 | 27.9 | 0 | 114.9 | 114877 2 | 6 | 2861 0:54:50:000 | 3992.1 | 27.7 | 0 | 114.9 | 114915 2 | 6 | 2862 0:54:55:000 | 3991.8 | 27.3 | 0 | 115 | 114953 2 | 6 | 2863 0:55:00:000 | 3992.1 | 27.1 | 0 | 115 | 114991 2 | 6 | 2864 0:55:05:000 | 3992.1 | 26.9 | 0 | 115 | 115029 2 | 6 | 2865 0:55:10:000 | 3992.1 | 26.9 | 0 | 115.1 | 115066 2 | 6 | 2866 0:55:15:000 | 3991.8 | 26.5 | 0 | 115.1 | 115103 2 | 6 | 2867 0:55:20:000 | 3992.1 | 26.4 | 0 | 115.1 | 115139 2 | 6 | 2868 0:55:25:000 | 3992.1 | 26.2 | 0 | 115.2 | 115176 2 | 6 | 2869 0:55:30:000 | 3992.1 | 26 | 0 | 115.2 | 115212 2 | 6 | 2870 0:55:35:000 | 3992.1 | 25.8 | 0 | 115.2 | 115248 2 | 6 | 2871 0:55:40:000 | 3992.1 | 25.6 | 0 | 115.3 | 115284 2 | 6 | 2872 0:55:45:000 | 3992.1 | 25.4 | 0 | 115.3 | 115319 2 | 6 | 2873 0:55:50:000 | 3992.1 | 25.4 | 0 | 115.4 | 115355 2 | 6 | 2874 0:55:55:000 | 3992.1 | 25.1 | 0 | 115.4 | 115390 2 | 6 | 2875 0:56:00:000 | 3992.1 | 25.1 | 0 | 115.4 | 115424 2 | 6 | 2876 0:56:05:000 | 3992.1 | 24.9 | 0 | 115.5 | 115459 2 | 6 | 2877 0:56:10:000 | 3991.8 | 24.7 | 0 | 115.5 | 115493 2 | 6 | 2878 0:56:15:000 | 3992.1 | 24.5 | 0 | 115.5 | 115527 2 | 6 | 2879 0:56:20:000 | 3992.1 | 24.1 | 0 | 115.6 | 115561 2 | 6 | 2880 0:56:25:000 | 3992.1 | 23.8 | 0 | 115.6 | 115594 2 | 6 | 2881 0:56:30:000 | 3992.1 | 23.8 | 0 | 115.6 | 115627 2 | 6 | 2882 0:56:35:000 | 3992.1 | 23.6 | 0 | 115.7 | 115660 2 | 6 | 2883 0:56:40:000 | 3992.1 | 23.4 | 0 | 115.7 | 115693 2 | 6 | 2884 0:56:45:000 | 3992.1 | 23.2 | 0 | 115.7 | 115725 2 | 6 | 2885 0:56:50:000 | 3992.1 | 23 | 0 | 115.8 | 115757 2 | 6 | 2886 0:56:55:000 | 3992.1 | 22.8 | 0 | 115.8 | 115789 2 | 6 | 2887 0:57:00:000 | 3991.8 | 22.6 | 0 | 115.8 | 115820 2 | 6 | 2888 0:57:05:000 | 3992.1 | 22.6 | 0 | 115.9 | 115852 2 | 6 | 2889 0:57:10:000 | 3992.1 | 22.3 | 0 | 115.9 | 115883 2 | 6 | 2890 0:57:15:000 | 3992.1 | 22.3 | 0 | 115.9 | 115914 2 | 6 | 2891 0:57:20:000 | 3992.1 | 22.1 | 0 | 115.9 | 115945 2 | 6 | 2892 0:57:25:000 | 3992.1 | 21.9 | 0 | 116 | 115975 2 | 6 | 2893 0:57:30:000 | 3992.1 | 21.7 | 0 | 116 | 116005 2 | 6 | 2894 0:57:35:000 | 3992.1 | 21.5 | 0 | 116 | 116035 2 | 6 | 2895 0:57:40:000 | 3992.1 | 21.3 | 0 | 116.1 | 116065 2 | 6 | 2896 0:57:45:000 | 3992.1 | 21.3 | 0 | 116.1 | 116095 2 | 6 | 2897 0:57:50:000 | 3992.1 | 21.2 | 0 | 116.1 | 116124 2 | 6 | 2898 0:57:55:000 | 3992.1 | 20.8 | 0 | 116.2 | 116153 2 | 6 | 2899 0:58:00:000 | 3992.1 | 20.8 | 0 | 116.2 | 116183 2 | 6 | 2900 0:58:05:000 | 3992.1 | 20.8 | 0 | 116.2 | 116211 2 | 6 | 2901 0:58:10:000 | 3992.1 | 20.6 | 0 | 116.2 | 116240 2 | 6 | 2902 0:58:15:000 | 3992.1 | 20.4 | 0 | 116.3 | 116269 2 | 6 | 2903 0:58:20:000 | 3991.8 | 20 | 0 | 116.3 | 116297 2 | 6 | 2904 0:58:25:000 | 3992.1 | 19.9 | 0 | 116.3 | 116324 2 | 6 | 2905 0:58:30:000 | 3992.1 | 19.9 | 0 | 116.4 | 116352

2 | 6 | 2906 0:58:35:000 | 3992.1 | 19.9 | 0 | 116.4 | 116380 2 | 6 | 2907 0:58:40:000 | 3992.1 | 19.5 | 0 | 116.4 | 116407 2 | 6 | 2908 0:58:45:000 | 3992.1 | 19.5 | 0 | 116.4 | 116434 2 | 6 | 2909 0:58:50:000 | 3992.1 | 19.3 | 0 | 116.5 | 116461 2 | 6 | 2910 0:58:55:000 | 3992.1 | 19.1 | 0 | 116.5 | 116488 2 | 6 | 2911 0:59:00:000 | 3992.1 | 19.1 | 0 | 116.5 | 116514 2 | 6 | 2912 0:59:05:000 | 3992.1 | 18.9 | 0 | 116.5 | 116540 2 | 6 | 2913 0:59:10:000 | 3992.1 | 18.9 | 0 | 116.6 | 116567 2 | 6 | 2914 0:59:15:000 | 3992.1 | 18.7 | 0 | 116.6 | 116593 2 | 6 | 2915 0:59:20:000 | 3992.1 | 18.6 | 0 | 116.6 | 116618 2 | 6 | 2916 0:59:25:000 | 3992.1 | 18.4 | 0 | 116.6 | 116644 2 | 6 | 2917 0:59:30:000 | 3992.1 | 18.4 | 0 | 116.7 | 116670 2 | 6 | 2918 0:59:35:000 | 3991.8 | 18.2 | 0 | 116.7 | 116695 2 | 6 | 2919 0:59:40:000 | 3992.1 | 18 | 0 | 116.7 | 116720 2 | 6 | 2920 0:59:45:000 | 3992.1 | 18 | 0 | 116.7 | 116745 2 | 6 | 2921 0:59:50:000 | 3992.1 | 17.8 | 0 | 116.8 | 116770 2 | 6 | 2922 0:59:55:000 | 3992.1 | 17.8 | 0 | 116.8 | 116795 2 | 6 | 2923 1:00:00:000 | 3992.1 | 17.6 | 0 | 116.8 | 116819 2 | 6 | 2924 1:00:05:000 | 3992.1 | 17.6 | 0 | 116.8 | 116843 2 | 6 | 2925 1:00:10:000 | 3992.1 | 17.2 | 0 | 116.9 | 116867 2 | 6 | 2926 1:00:15:000 | 3992.1 | 17.2 | 0 | 116.9 | 116891 2 | 6 | 2927 1:00:20:000 | 3992.1 | 17.1 | 0 | 116.9 | 116915 2 | 6 | 2928 1:00:25:000 | 3992.1 | 17.1 | 0 | 116.9 | 116939 2 | 6 | 2929 1:00:30:000 | 3992.1 | 16.9 | 0 | 117 | 116962 2 | 6 | 2930 1:00:35:000 | 3992.1 | 16.9 | 0 | 117 | 116986 2 | 6 | 2931 1:00:40:000 | 3992.1 | 16.7 | 0 | 117 | 117009 2 | 6 | 2932 1:00:45:000 | 3992.1 | 16.5 | 0 | 117 | 117032 2 | 6 | 2933 1:00:50:000 | 3992.1 | 16.5 | 0 | 117.1 | 117055 2 | 6 | 2934 1:00:55:000 | 3991.8 | 16.3 | 0 | 117.1 | 117077 2 | 6 | 2935 1:01:00:000 | 3992.1 | 15.9 | 0 | 117.1 | 117099 2 | 6 | 2936 1:01:05:000 | 3992.1 | 15.9 | 0 | 117.1 | 117122 2 | 6 | 2937 1:01:10:000 | 3992.1 | 15.8 | 0 | 117.1 | 117144 2 | 6 | 2938 1:01:15:000 | 3992.1 | 15.8 | 0 | 117.2 | 117165 2 | 6 | 2939 1:01:20:000 | 3992.1 | 15.6 | 0 | 117.2 | 117187 2 | 6 | 2940 1:01:25:000 | 3992.1 | 15.6 | 0 | 117.2 | 117209 2 | 6 | 2941 1:01:30:000 | 3992.1 | 15.4 | 0 | 117.2 | 117230 2 | 6 | 2942 1:01:35:000 | 3992.1 | 15.4 | 0 | 117.3 | 117252 2 | 6 | 2943 1:01:40:000 | 3992.1 | 15.2 | 0 | 117.3 | 117273 2 | 6 | 2944 1:01:45:000 | 3992.1 | 15 | 0 | 117.3 | 117294 2 | 6 | 2945 1:01:50:000 | 3992.1 | 15 | 0 | 117.3 | 117314 2 | 6 | 2946 1:01:55:000 | 3992.1 | 15 | 0 | 117.3 | 117335 2 | 6 | 2947 1:02:00:000 | 3992.1 | 14.8 | 0 | 117.4 | 117356 2 | 6 | 2948 1:02:05:000 | 3992.1 | 14.6 | 0 | 117.4 | 117376 2 | 6 | 2949 1:02:10:000 | 3992.1 | 14.6 | 0 | 117.4 | 117396 2 | 6 | 2950 1:02:15:000 | 3992.1 | 14.5 | 0 | 117.4 | 117416 2 | 6 | 2951 1:02:20:000 | 3992.1 | 14.5 | 0 | 117.4 | 117437 2 | 6 | 2952 1:02:25:000 | 3992.1 | 14.5 | 0 | 117.5 | 117457 2 | 6 | 2953 1:02:30:000 | 3992.1 | 14.3 | 0 | 117.5 | 117477 2 | 6 | 2954 1:02:35:000 | 3992.1 | 14.1 | 0 | 117.5 | 117496 2 | 6 | 2955 1:02:40:000 | 3992.1 | 14.1 | 0 | 117.5 | 117516 2 | 6 | 2956 1:02:45:000 | 3992.1 | 13.9 | 0 | 117.5 | 117535

2 | 6 | 2957 1:02:50:000 | 3992.1 | 13.7 | 0 | 117.6 | 117554 2 | 6 | 2958 1:02:55:000 | 3992.1 | 13.7 | 0 | 117.6 | 117573 2 | 6 | 2959 1:03:00:000 | 3992.1 | 13.7 | 0 | 117.6 | 117592 2 | 6 | 2960 1:03:05:000 | 3992.1 | 13.5 | 0 | 117.6 | 117611 2 | 6 | 2961 1:03:10:000 | 3992.1 | 13.3 | 0 | 117.6 | 117630 2 | 6 | 2962 1:03:15:000 | 3992.1 | 13.3 | 0 | 117.6 | 117648 2 | 6 | 2963 1:03:20:000 | 3992.1 | 13.3 | 0 | 117.7 | 117667 2 | 6 | 2964 1:03:25:000 | 3992.1 | 13.2 | 0 | 117.7 | 117685 2 | 6 | 2965 1:03:30:000 | 3992.1 | 13.2 | 0 | 117.7 | 117704 2 | 6 | 2966 1:03:35:000 | 3992.1 | 13.2 | 0 | 117.7 | 117722 2 | 6 | 2967 1:03:40:000 | 3992.1 | 13 | 0 | 117.7 | 117740 2 | 6 | 2968 1:03:45:000 | 3992.1 | 13 | 0 | 117.8 | 117758 2 | 6 | 2969 1:03:50:000 | 3992.1 | 12.8 | 0 | 117.8 | 117776 2 | 6 | 2970 1:03:55:000 | 3992.1 | 12.6 | 0 | 117.8 | 117793 2 | 6 | 2971 1:04:00:000 | 3991.8 | 12.6 | 0 | 117.8 | 117811 2 | 6 | 2972 1:04:05:000 | 3992.1 | 12.6 | 0 | 117.8 | 117828 2 | 6 | 2973 1:04:10:000 | 3992.1 | 12.6 | 0 | 117.8 | 117846 2 | 6 | 2974 1:04:15:000 | 3992.1 | 12.4 | 0 | 117.9 | 117863 2 | 6 | 2975 1:04:20:000 | 3992.1 | 12.4 | 0 | 117.9 | 117880 2 | 6 | 2976 1:04:25:000 | 3992.1 | 12.2 | 0 | 117.9 | 117897 2 | 6 | 2977 1:04:30:000 | 3992.1 | 12.2 | 0 | 117.9 | 117914 2 | 6 | 2978 1:04:35:000 | 3992.1 | 12.2 | 0 | 117.9 | 117931 2 | 6 | 2979 1:04:40:000 | 3992.1 | 11.9 | 0 | 117.9 | 117948 2 | 6 | 2980 1:04:45:000 | 3992.1 | 11.9 | 0 | 118 | 117964 2 | 6 | 2981 1:04:50:000 | 3992.1 | 11.7 | 0 | 118 | 117980 2 | 6 | 2982 1:04:55:000 | 3992.1 | 11.7 | 0 | 118 | 117997 2 | 6 | 2983 1:05:00:000 | 3992.1 | 11.5 | 0 | 118 | 118013 2 | 6 | 2984 1:05:05:000 | 3992.1 | 11.7 | 0 | 118 | 118029 2 | 6 | 2985 1:05:10:000 | 3992.1 | 11.3 | 0 | 118 | 118045 2 | 6 | 2986 1:05:15:000 | 3992.1 | 11.3 | 0 | 118.1 | 118061 2 | 6 | 2987 1:05:20:000 | 3992.1 | 11.3 | 0 | 118.1 | 118076 2 | 6 | 2988 1:05:25:000 | 3992.1 | 11.3 | 0 | 118.1 | 118092 2 | 6 | 2989 1:05:30:000 | 3992.1 | 11.1 | 0 | 118.1 | 118108 2 | 6 | 2990 1:05:35:000 | 3992.1 | 11.1 | 0 | 118.1 | 118123 2 | 6 | 2991 1:05:40:000 | 3992.1 | 10.9 | 0 | 118.1 | 118138 2 | 6 | 2992 1:05:45:000 | 3992.1 | 10.9 | 0 | 118.2 | 118153 2 | 6 | 2993 1:05:50:000 | 3992.1 | 10.9 | 0 | 118.2 | 118168 2 | 6 | 2994 1:05:55:000 | 3992.1 | 10.9 | 0 | 118.2 | 118184 2 | 6 | 2995 1:06:00:000 | 3992.1 | 10.9 | 0 | 118.2 | 118199 2 | 6 | 2996 1:06:05:000 | 3992.1 | 10.7 | 0 | 118.2 | 118214 2 | 6 | 2997 1:06:10:000 | 3992.1 | 10.7 | 0 | 118.2 | 118228 2 | 6 | 2998 1:06:15:000 | 3992.1 | 10.6 | 0 | 118.2 | 118243 2 | 6 | 2999 1:06:20:000 | 3992.1 | 10.6 | 0 | 118.3 | 118258 2 | 6 | 3000 1:06:25:000 | 3992.1 | 10.6 | 0 | 118.3 | 118272 2 | 6 | 3001 1:06:30:000 | 3992.1 | 10.4 | 0 | 118.3 | 118287 2 | 6 | 3002 1:06:35:000 | 3992.1 | 10.4 | 0 | 118.3 | 118301 2 | 6 | 3003 1:06:40:000 | 3992.1 | 10.4 | 0 | 118.3 | 118316 2 | 6 | 3004 1:06:45:000 | 3992.1 | 10.2 | 0 | 118.3 | 118330 2 | 6 | 3005 1:06:50:000 | 3992.1 | 10.2 | 0 | 118.3 | 118344 2 | 6 | 3006 1:06:55:000 | 3992.1 | 10 | 0 | 118.4 | 118358 2 | 6 | 3007 1:07:00:000 | 3992.1 | 10 | 0 | 118.4 | 118372

2 | 6 | 3008 1:07:05:000 | 3992.1 | 10 | 0 | 118.4 | 118386 2 | 6 | 3009 1:07:10:000 | 3992.1 | 9.8 | 0 | 118.4 | 118400 2 | 6 | 3010 1:07:15:000 | 3992.1 | 9.8 | 0 | 118.4 | 118413 2 | 6 | 3011 1:07:20:000 | 3992.1 | 9.8 | 0 | 118.4 | 118427 2 | 6 | 3012 1:07:25:000 | 3992.1 | 9.8 | 0 | 118.4 | 118441 2 | 6 | 3013 1:07:30:000 | 3992.1 | 9.8 | 0 | 118.5 | 118454 2 | 6 | 3014 1:07:35:000 | 3992.1 | 9.6 | 0 | 118.5 | 118467 2 | 6 | 3015 1:07:40:000 | 3992.1 | 9.4 | 0 | 118.5 | 118481 2 | 6 | 3016 1:07:45:000 | 3992.1 | 9.4 | 0 | 118.5 | 118494 2 | 6 | 3017 1:07:50:000 | 3992.1 | 9.4 | 0 | 118.5 | 118507 2 | 6 | 3018 1:07:55:000 | 3992.1 | 9.4 | 0 | 118.5 | 118520 2 | 6 | 3019 1:08:00:000 | 3992.1 | 9.3 | 0 | 118.5 | 118533 2 | 6 | 3020 1:08:05:000 | 3992.1 | 9.3 | 0 | 118.5 | 118546 2 | 6 | 3021 1:08:10:000 | 3992.1 | 9.1 | 0 | 118.6 | 118558 2 | 6 | 3022 1:08:15:000 | 3992.1 | 9.3 | 0 | 118.6 | 118571 2 | 6 | 3023 1:08:20:000 | 3992.1 | 9.1 | 0 | 118.6 | 118584 2 | 6 | 3024 1:08:25:000 | 3992.1 | 9.1 | 0 | 118.6 | 118596 2 | 6 | 3025 1:08:30:000 | 3992.1 | 9.1 | 0 | 118.6 | 118609 2 | 6 | 3026 1:08:35:000 | 3992.1 | 8.9 | 0 | 118.6 | 118621 2 | 6 | 3027 1:08:40:000 | 3992.1 | 8.9 | 0 | 118.6 | 118634 2 | 6 | 3028 1:08:45:000 | 3992.1 | 8.9 | 0 | 118.6 | 118646 2 | 6 | 3029 1:08:50:000 | 3992.1 | 8.7 | 0 | 118.7 | 118658 2 | 6 | 3030 1:08:55:000 | 3992.1 | 8.7 | 0 | 118.7 | 118670 2 | 6 | 3031 1:09:00:000 | 3992.1 | 8.7 | 0 | 118.7 | 118683 2 | 6 | 3032 1:09:05:000 | 3992.1 | 8.7 | 0 | 118.7 | 118695 2 | 6 | 3033 1:09:10:000 | 3992.1 | 8.5 | 0 | 118.7 | 118706 2 | 6 | 3034 1:09:15:000 | 3992.1 | 8.5 | 0 | 118.7 | 118718 2 | 6 | 3035 1:09:20:000 | 3992.1 | 8.5 | 0 | 118.7 | 118730 2 | 6 | 3036 1:09:25:000 | 3992.1 | 8.3 | 0 | 118.7 | 118742 2 | 6 | 3037 1:09:30:000 | 3992.1 | 8.3 | 0 | 118.8 | 118753 2 | 6 | 3038 1:09:35:000 | 3992.1 | 8.5 | 0 | 118.8 | 118765 2 | 6 | 3039 1:09:40:000 | 3992.1 | 8.3 | 0 | 118.8 | 118776 2 | 6 | 3040 1:09:45:000 | 3992.1 | 8.3 | 0 | 118.8 | 118788 2 | 6 | 3041 1:09:50:000 | 3992.1 | 8.3 | 0 | 118.8 | 118799 2 | 6 | 3042 1:09:55:000 | 3992.1 | 7.9 | 0 | 118.8 | 118811 2 | 6 | 3043 1:10:00:000 | 3992.1 | 7.9 | 0 | 118.8 | 118822 2 | 6 | 3044 1:10:05:000 | 3992.1 | 7.8 | 0 | 118.8 | 118833 2 | 6 | 3045 1:10:10:000 | 3992.1 | 7.8 | 0 | 118.8 | 118843 2 | 6 | 3046 1:10:15:000 | 3992.1 | 7.8 | 0 | 118.9 | 118854 2 | 6 | 3047 1:10:20:000 | 3992.1 | 7.8 | 0 | 118.9 | 118865 2 | 6 | 3048 1:10:25:000 | 3992.1 | 7.8 | 0 | 118.9 | 118876 2 | 6 | 3049 1:10:30:000 | 3992.1 | 7.6 | 0 | 118.9 | 118887 2 | 6 | 3050 1:10:35:000 | 3992.1 | 7.6 | 0 | 118.9 | 118897 2 | 6 | 3051 1:10:40:000 | 3992.1 | 7.8 | 0 | 118.9 | 118908 2 | 6 | 3052 1:10:45:000 | 3992.1 | 7.6 | 0 | 118.9 | 118918 2 | 6 | 3053 1:10:50:000 | 3992.1 | 7.4 | 0 | 118.9 | 118929 2 | 6 | 3054 1:10:55:000 | 3992.1 | 7.4 | 0 | 118.9 | 118939 2 | 6 | 3055 1:11:00:000 | 3992.1 | 7.4 | 0 | 118.9 | 118949 2 | 6 | 3056 1:11:05:000 | 3992.1 | 7.4 | 0 | 119 | 118960 2 | 6 | 3057 1:11:10:000 | 3992.1 | 7.4 | 0 | 119 | 118970 2 | 6 | 3058 1:11:15:000 | 3992.1 | 7.2 | 0 | 119 | 118980

2 | 6 | 3059 1:11:20:000 | 3992.1 | 7.2 | 0 | 119 | 118990 2 | 6 | 3060 1:11:25:000 | 3992.1 | 7.2 | 0 | 119 | 119000 2 | 6 | 3061 1:11:30:000 | 3992.1 | 7 | 0 | 119 | 119010 2 | 6 | 3062 1:11:35:000 | 3992.1 | 7 | 0 | 119 | 119019 2 | 6 | 3063 1:11:40:000 | 3992.1 | 7 | 0 | 119 | 119029 2 | 6 | 306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

2 | 6 | 3110 1:15:35:000 | 3992.1 | 5.5 | 0 | 119.4 | 119431 2 | 6 | 3111 1:15:40:000 | 3992.1 | 5.5 | 0 | 119.4 | 119439 2 | 6 | 3112 1:15:45:000 | 3992.1 | 5.5 | 0 | 119.4 | 119446 2 | 6 | 3113 1:15:50:000 | 3992.1 | 5.3 | 0 | 119.5 | 119454 2 | 6 | 3114 1:15:55:000 | 3992.1 | 5.2 | 0 | 119.5 | 119461 2 | 6 | 3115 1:16:00:000 | 3992.1 | 5.3 | 0 | 119.5 | 119468 2 | 6 | 3116 1:16:05:000 | 3992.1 | 5.3 | 0 | 119.5 | 119476 2 | 6 | 3117 1:16:10:000 | 3992.1 | 5.2 | 0 | 119.5 | 119483 2 | 6 | 3118 1:16:15:000 | 3992.1 | 5.2 | 0 | 119.5 | 119490 2 | 6 | 3119 1:16:20:000 | 3992.1 | 5.2 | 0 | 119.5 | 119497 2 | 6 | 3120 1:16:25:000 | 3992.1 | 5.2 | 0 | 119.5 | 119505 2 | 6 | 3121 1:16:30:000 | 3992.1 | 5.2 | 0 | 119.5 | 119512 2 | 6 | 3122 1:16:35:000 | 3992.1 | 5.2 | 0 | 119.5 | 119519 2 | 6 | 3123 1:16:40:000 | 3992.1 | 5.2 | 0 | 119.5 | 119526 2 | 6 | 3124 1:16:45:000 | 3992.1 | 5.2 | 0 | 119.5 | 119533 2 | 6 | 3125 1:16:50:000 | 3992.1 | 5 | 0 | 119.5 | 119540 2 | 6 | 3126 1:16:55:000 | 3992.1 | 5.2 | 0 | 119.5 | 119547 2 | 6 | 3127 1:17:00:000 | 3992.1 | 5.2 | 0 | 119.6 | 119554 2 | 6 | 3128 1:17:05:000 | 3992.1 | 5 | 0 | 119.6 | 119561 2 | 6 | 3129 1:17:10:000 | 3992.1 | 5 | 0 | 119.6 | 119568 2 | 6 | 3130 1:17:15:000 | 3992.1 | 5 | 0 | 119.6 | 119575 2 | 6 | 3131 1:17:20:000 | 3992.1 | 5 | 0 | 119.6 | 119582 2 | 6 | 3132 1:17:25:000 | 3992.1 | 4.8 | 0 | 119.6 | 119589 2 | 6 | 3133 1:17:30:000 | 3992.1 | 4.8 | 0 | 119.6 | 119595 2 | 6 | 3134 1:17:35:000 | 3992.1 | 4.8 | 0 | 119.6 | 119602 2 | 6 | 3135 1:17:40:000 | 3991.8 | 4.8 | 0 | 119.6 | 119609 2 | 6 | 3136 1:17:45:000 | 3992.1 | 4.8 | 0 | 119.6 | 119615 2 | 6 | 3137 1:17:50:000 | 3992.1 | 4.8 | 0 | 119.6 | 119622 2 | 6 | 3138 1:17:55:000 | 3992.1 | 4.6 | 0 | 119.6 | 119629 2 | 6 | 3139 1:18:00:000 | 3992.1 | 4.6 | 0 | 119.6 | 119635 2 | 6 | 3140 1:18:05:000 | 3992.1 | 4.6 | 0 | 119.6 | 119641 2 | 6 | 3141 1:18:10:000 | 3992.1 | 4.6 | 0 | 119.6 | 119648 2 | 6 | 3142 1:18:15:000 | 3992.1 | 4.4 | 0 | 119.7 | 119654 2 | 6 | 3143 1:18:20:000 | 3992.1 | 4.6 | 0 | 119.7 | 119660 2 | 6 | 3144 1:18:25:000 | 3992.1 | 4.6 | 0 | 119.7 | 119666 2 | 6 | 3145 1:18:30:000 | 3992.1 | 4.4 | 0 | 119.7 | 119673 2 | 6 | 3146 1:18:35:000 | 3992.1 | 4.4 | 0 | 119.7 | 119679 2 | 6 | 3147 1:18:40:000 | 3992.1 | 4.4 | 0 | 119.7 | 119685 2 | 6 | 3148 1:18:45:000 | 3992.1 | 4.4 | 0 | 119.7 | 119691 2 | 6 | 3149 1:18:50:000 | 3992.1 | 4.4 | 0 | 119.7 | 119697 2 | 6 | 3150 1:18:55:000 | 3992.1 | 4.4 | 0 | 119.7 | 119703 2 | 6 | 3151 1:19:00:000 | 3992.1 | 4.4 | 0 | 119.7 | 119709 2 | 6 | 3152 1:19:05:000 | 3992.1 | 4.4 | 0 | 119.7 | 119715 2 | 6 | 3153 1:19:10:000 | 3992.1 | 4.4 | 0 | 119.7 | 119722 2 | 6 | 3154 1:19:15:000 | 3992.1 | 4.2 | 0 | 119.7 | 119728 2 | 6 | 3155 1:19:20:000 | 3992.1 | 4.4 | 0 | 119.7 | 119734 2 | 6 | 3156 1:19:25:000 | 3992.1 | 4.4 | 0 | 119.7 | 119740 2 | 6 | 3157 1:19:30:000 | 3992.1 | 4.2 | 0 | 119.7 | 119746 2 | 6 | 3158 1:19:35:000 | 3992.1 | 4.2 | 0 | 119.8 | 119752 2 | 6 | 3159 1:19:40:000 | 3992.1 | 4.2 | 0 | 119.8 | 119757 2 | 6 | 3160 1:19:45:000 | 3992.1 | 4.2 | 0 | 119.8 | 119763

2 | 6 | 3161 1:19:50:000 | 3992.1 | 4.2 | 0 | 119.8 | 119769 2 | 6 | 3162 1:19:55:000 | 3992.1 | 4.2 | 0 | 119.8 | 119775 2 | 6 | 3163 1:20:00:000 | 3992.1 | 4.2 | 0 | 119.8 | 119780 2 | 6 | 3164 1:20:05:000 | 3992.1 | 4.2 | 0 | 119.8 | 119786 2 | 6 | 3165 1:20:10:000 | 3991.8 | 3.9 | 0 | 119.8 | 119792 2 | 6 | 3166 1:20:15:000 | 3992.1 | 3.9 | 0 | 119.8 | 119797 2 | 6 | 3167 1:20:20:000 | 3992.1 | 3.9 | 0 | 119.8 | 119803 2 | 6 | 3168 1:20:25:000 | 3992.1 | 3.9 | 0 | 119.8 | 119808 2 | 6 | 3169 1:20:30:000 | 3992.1 | 3.9 | 0 | 119.8 | 119813 2 | 6 | 3170 1:20:35:000 | 3992.1 | 3.9 | 0 | 119.8 | 119819 2 | 6 | 3171 1:20:40:000 | 3992.1 | 3.9 | 0 | 119.8 | 119824 2 | 6 | 3172 1:20:45:000 | 3992.1 | 3.7 | 0 | 119.8 | 119830 2 | 6 | 3173 1:20:50:000 | 3992.1 | 3.7 | 0 | 119.8 | 119835 2 | 6 | 3174 1:20:55:000 | 3992.1 | 3.7 | 0 | 119.8 | 119840 2 | 6 | 3175 1:21:00:000 | 3992.1 | 3.7 | 0 | 119.8 | 119845 2 | 6 | 3176 1:21:05:000 | 3992.1 | 3.7 | 0 | 119.9 | 119850 2 | 6 | 3177 1:21:10:000 | 3992.1 | 3.7 | 0 | 119.9 | 119856 2 | 6 | 3178 1:21:15:000 | 3992.1 | 3.7 | 0 | 119.9 | 119861 2 | 6 | 3179 1:21:20:000 | 3992.1 | 3.7 | 0 | 119.9 | 119866 2 | 6 | 3180 1:21:25:000 | 3992.1 | 3.5 | 0 | 119.9 | 119871 2 | 6 | 3181 1:21:30:000 | 3992.1 | 3.5 | 0 | 119.9 | 119876 2 | 6 | 3182 1:21:35:000 | 3992.1 | 3.7 | 0 | 119.9 | 119881 2 | 6 | 3183 1:21:40:000 | 3992.1 | 3.5 | 0 | 119.9 | 119886 2 | 6 | 3184 1:21:45:000 | 3992.1 | 3.5 | 0 | 119.9 | 119891 2 | 6 | 3185 1:21:50:000 | 3992.1 | 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
466.3 | 466257 2017-10-23 15:41:19
466.3 | 466274 2017-10-23 15:41:24
466.3 | 466292 2017-10-23 15:41:29
466.3 | 466309 2017-10-23 15:41:34
466.3 | 466327 2017-10-23 15:41:39

466.3 | 466344 2017-10-23 15:41:44 466.4 | 466362 2017-10-23 15:41:49 466.4 | 466372 2017-10-23 15:41:52

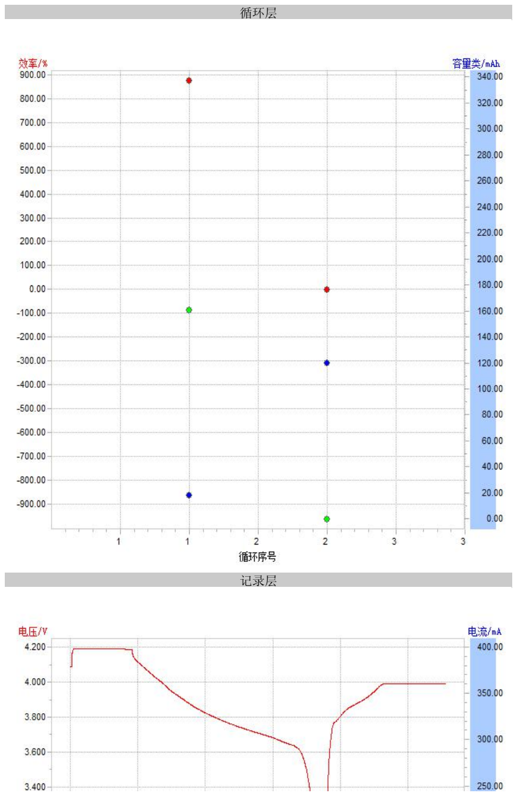
[picture p38: page 135]

循环层

记录层

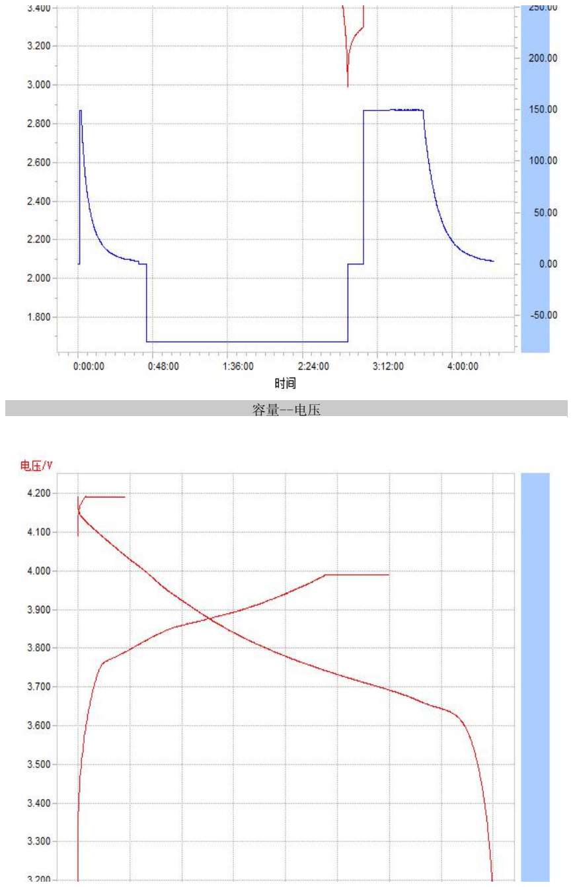
[picture p39: page 136]

容量--电压

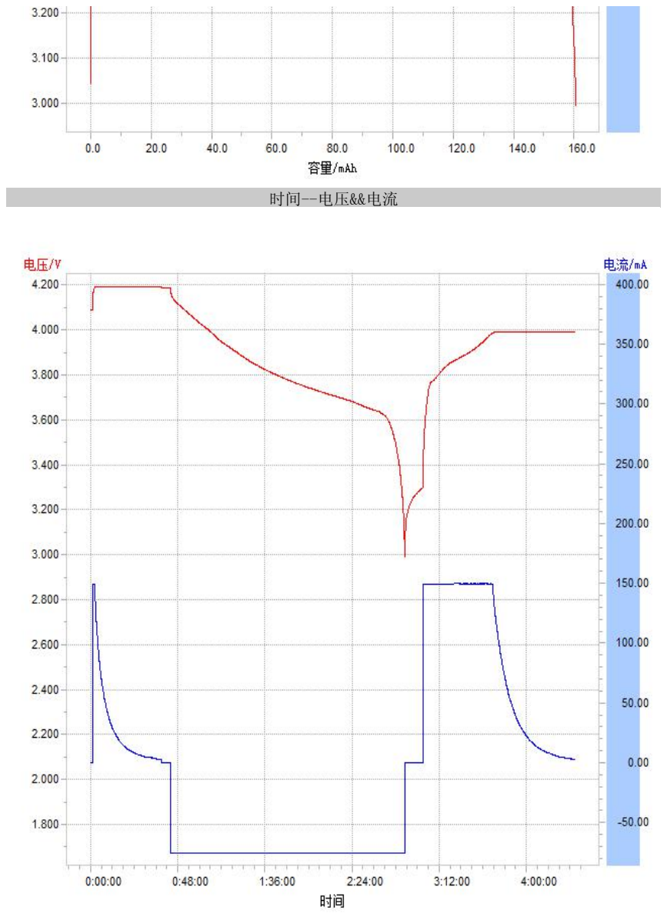
[picture p40: page 137]

时间--电压&&电流
