NewEconoLab/NeoDun/产品/外观设计/外观 (4).jpg

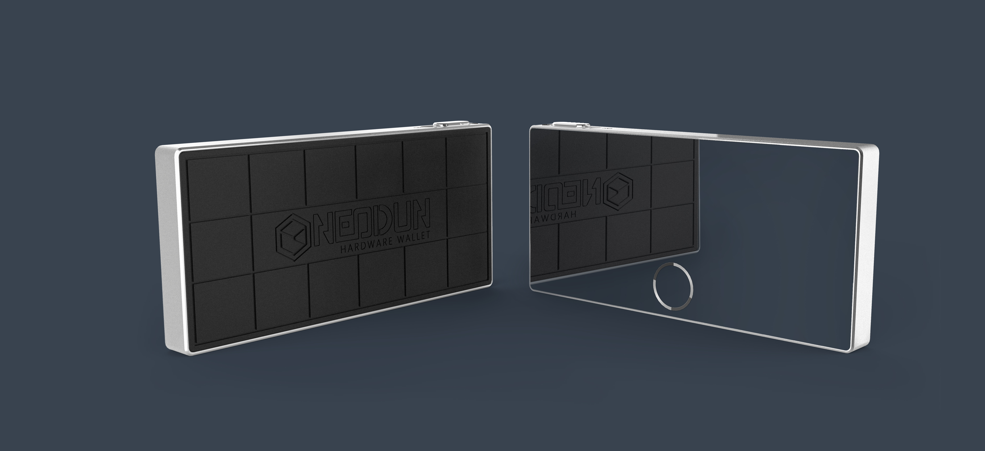
产品/外观设计/外观 (4).jpg
