NewEconoLab/NeoDun/驱动程序与钱包/neoHardWallet/driver/TIM图片20170711212508.png

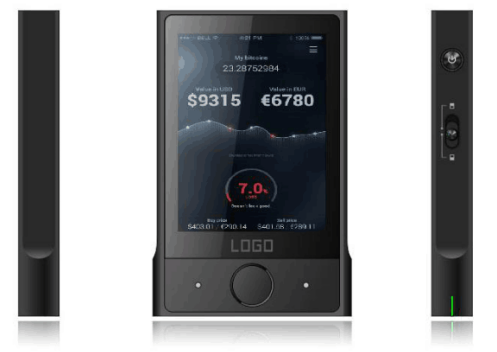
驱动程序与钱包/neoHardWallet/driver/TIM图片20170711212508.png
