NewEconoLab/NeoDun/驱动程序与钱包/neoHardWallet/driver_win/res/Group.png

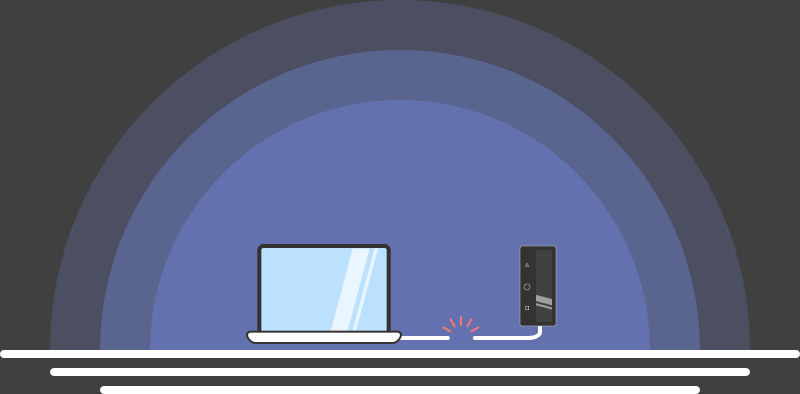
驱动程序与钱包/neoHardWallet/driver_win/res/Group.png
