NewEconoLab/NeoDun/驱动程序与钱包/neoHardWallet/driver_win/res/底1.png

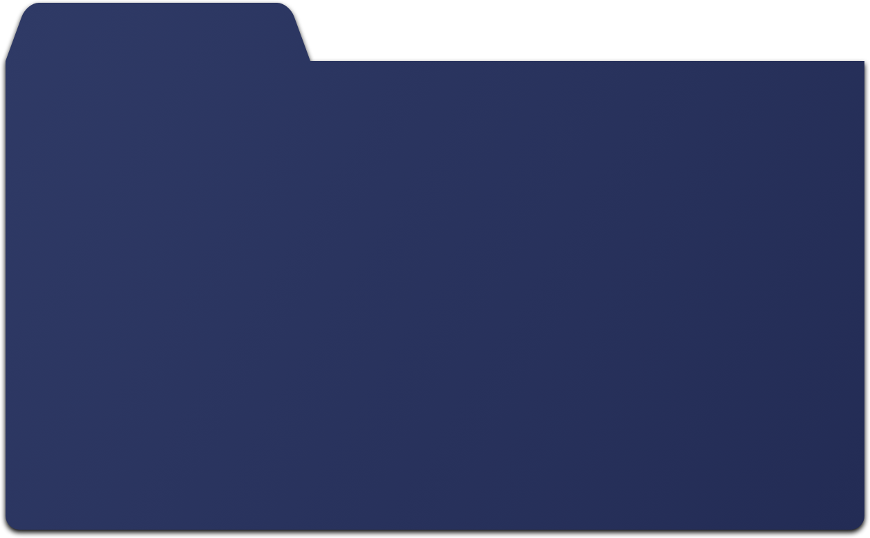
驱动程序与钱包/neoHardWallet/driver_win/res/底1.png
