NewEconoLab/NeoDun/驱动程序与钱包/neoHardWallet/driver_win/res/无钱包.png

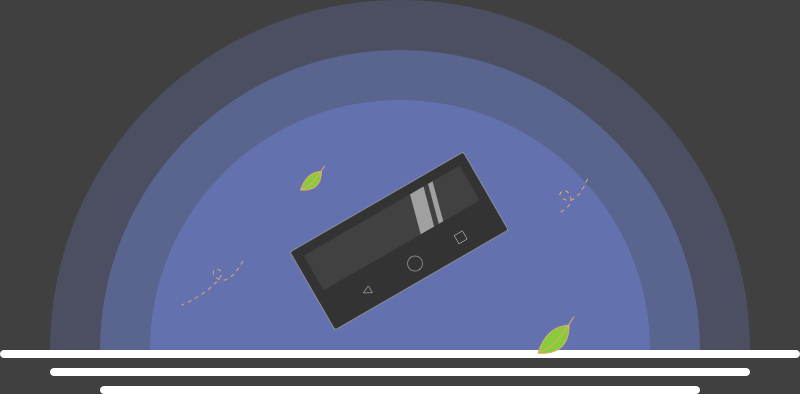
驱动程序与钱包/neoHardWallet/driver_win/res/无钱包.png
