NewEconoLab/NeoDun/驱动程序与钱包/驱动签名机通讯流程图.jpg

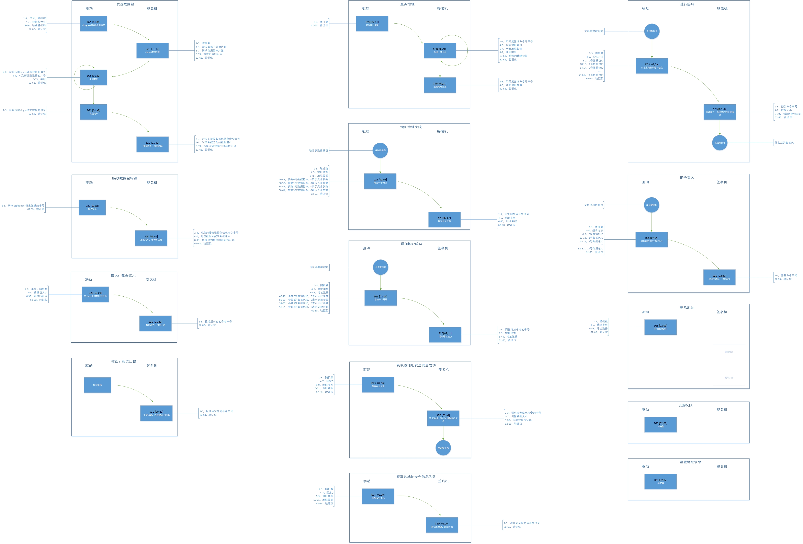
驱动程序与钱包/驱动签名机通讯流程图.jpg
