NewEconoLab/NeoDun/硬件设计/BOM/NEO_FPC_V1.0_0925.xls

Sheet: 封面&变更记录
BOM LIST
BOM编号：
BOM 类型：
项目全称：
PCB版本：
发行日期：
制 作 |  |  | 相关 部门 确认 | 硬件基带 | 结构部
审 核 |  |  |  | 硬件射频 | 采购部
PM会签 |  |  |  | 硬件主管 | 生产部
变更记录
BOM版本 | 日期 | 序号 | 变更内容 |  |  | 变更原因 | 负责人

Sheet: XX-MB-PCBA-BOM
项目全称：TOY_MB_V1.1 |  |  |  |  | PCB版本/料号： |  |  |  | 编写人员：
客户名称： |  |  |  |  | PCBA料号： |  |  |  | 审核人员：
BOM名称：
元件分类 | 湿敏元件 | 序号 | 物料名称 | 物料描述 | 参考标记 (贴片位置) | 料号 | 用量 | 制造商 | 制造商产品 规格型号 | 代理商 | 联系人 | 联系电话 | 备注
 |  |  | 白色LED正发光灯 | 白色LED,3V,LH0603,0.45mm | LED1 LED3 |  | 2 | LITEON | LTW-C193SN5
 |  |  |  |  |  |  |  | 奥伦德 | ORH-W46G
 |  |  | BTB连接器 插头 | 10pin BTB，female，窄体，mate=0.9mm | J4 |  | 1 | 京瓷 | 14 5804 010 000 829+
 |  |  | 轻触开关 | 松下 轻触开关 EVPAWCD2A 贴片2脚 3*2*0.6MM 小按键 手机按键 | S01 |  | 1 | 松下 | 贴片 轻触开关 3*2*0.6MM
