NewEconoLab/NeoDun/硬件设计/BOM/NEO_MB_V1.0_1104.xls

Sheet: 封面&变更记录
BOM LIST
BOM编号：
BOM 类型：
项目全称：
PCB版本：
发行日期：
制 作 |  |  | 相关 部门 确认 | 硬件基带 | 结构部
审 核 |  |  |  | 硬件射频 | 采购部
PM会签 |  |  |  | 硬件主管 | 生产部
变更记录
BOM版本 | 日期 | 序号 | 变更内容 |  |  | 变更原因 | 负责人

Sheet: XX-MB-PCBA-BOM
项目全称：TOY_MB_V1.1 |  |  |  |  | PCB版本/料号： |  |  |  | 编写人员：
客户名称： |  |  |  |  | PCBA料号： |  |  |  | 审核人员：
BOM名称：
元件分类 | 湿敏元件 | 序号 | 物料名称 | 物料描述 | 参考标记 (贴片位置) | 料号 | 用量 | 制造商 | 制造商产品 规格型号 | 代理商 | 联系人 | 联系电话 | 备注
 |  |  | MCU芯片 | ARM Cortex-M4 32b MCU+FPU, 210DMIPS, up to 1MB Flash/192+4KB RAM, USB OTG HS/FS, Ethernet, 17 TIMs, 3 ADCs, 15 comm. interfaces & camera；LQFP100封装 | U6 |  | 1 | ST | STM32F407VGT6
 |  |  | 2.4G陶瓷天线 | BT CHIP ANT 5.2*3.7*0.7mm | ANT701 |  | 1 | INPAQ | ACA-5036-A2-CC-S
 |  |  | 加密芯片 | 加密芯片;8-lead SOIC封装 | U18 |  | 1 | Atmel | ATSHA204A
 |  |  | 触控IC | 集成 6 路智能呼吸灯驱动、 3 路电容式触摸按键控制器, QFN3X3_20L, H=0.8mm | U604 |  | 1 | AWINIC | AW9136QNR
 |  |  | 背光LED | 升压型 LED 恒流驱动器；SOT23-6 | U601 |  | 1 | 立锜 | RT9284A-20GJ6E
 |  |  | 电量计 | Low-Cost Fuel Gauge IC with Low-SOC Alert；TDFN8 | U22 |  | 1 | CELLWISE | CW2015CSAD
 |  |  | BLE | 藍牙低功耗和 2.4GHz 專利 SoC;QFN48 | U11 |  | 1 | NORDIC | NRF51822
 |  |  | 线性充电IC | 1A 线性锂电池充电管理集成电路；SOP-PP | U5 |  | 1 | 如韵电子 | CN3152
 |  |  |  |  |  |  |  | 南京拓微集成 | TP4056
 |  |  | NPN 三极管 | NPN 三极管，Ic=500mA;SOT-23封装 | Q2 |  | 1 | BL | S9013
 |  |  | N MOS管 | N-CHANNEL ENHANCEMENT MODE FIELD EFFECT TRANSISTOR；SOT-23 | Q5 |  | 1 | PANJIT | 2N7002
 |  |  | P MOS管 | 20V P-Channel MOSFET; SOT-23 | Q04 |  | 1 | Alpha & Omega | AO3415
 |  |  | 二极管 | SMALL SIGNAL DIODES； SOD-323封装 | D2 D3 |  | 2 | General SEM | 1N4148WS
 |  |  | 二极管 | 耐压40V肖特基二极管； SOD-323封装 | D601 |  | 1 | 长电科技 | B5819WS
 |  |  | LDO | Ultra Low Dropout 1.5A Linear Regulator ;330mV Dropout @ 1.5A;SOT-223封装 | U4 |  | 1 | RICHTEK | RT9183-33GG
 |  |  | 32.768K晶振 | 无源贴片晶振 FC-135 3.2x1.5mm 2脚 3215 32.768K | X09 X602 |  | 2 | Epson | FC-135
 |  |  | 16MHz无源贴片晶振 | 16MHz,9pF,10ppm,2520 | X01 |  | 1 | NDK | NX2520SA-16MHz
 |  |  | 8M晶振 | KDS 无源贴片晶振 3225 4脚 8M 8MHZ 8.000MHZ | X08 |  | 1 | KDS | DSX321G_8MHz
 |  |  | 功率电感 | 贴片线绕电感器10uH，0.59A,DCR=1.520R,2520(2.5*2.0*1.2) | L14 |  | 1 | SUNLORD | SWPA252012S220MT
 |  |  | 贴片磁珠 1000Ω | Bead 800mA 1000Ω,DC 0.25Ω,0603 | L4 L5 |  | 2 | CHILISIN | PBY160808T-102Y-N
 |  |  |  | Bead 600mA 1000Ω,DC 0.25Ω,0603 |  |  |  | Sunlord | HPZ1608D102-R60TF
C | 否 |  | 电感，3.3nH | IND，3.3nH±0.3nH 0402 | L2 |  | 1 | Sunlord | SDCL1005C3N3STDF
 |  |  |  | IND，3.3nH±0.3nH 0402 |  |  |  | Murata | LQG15HS3N3J02D
 |  |  |  | IND，3.3nH±0.3nH 0402 |  |  |  | CHILISIN | CLH1005T-3N3S-S-NP
C | 否 |  | 电感，4.7nH | IND,4.7nH±0.3nH,280mΩ,300mA 0402 | L6 |  | 1 | Sunlord | SDCL1005C4N7STDF
 |  |  |  |  |  |  |  | Murata | LQG15HS4N7J020D
 |  |  |  |  |  |  |  | CHILISIN | CLH1005T-4N7S-S-NP
C | 否 |  | 电感，10nH | IND，10nH ±0.3nH 300MA 0402 | L3 |  | 1 | Sunlord | SDCL1005C10NJTDF
 |  |  |  |  |  |  |  | Murata | LQG15HS10NJ02D
 |  |  |  |  |  |  |  | CHILISIN | CLH1005T-10NJ-S-NP
 |  |  | 电容，1.0pF | Cap，1pF ±0.25pF C0402 50V | C26 |  | 1 | YAGEO | CC0402CRNPO9BN1R0
 |  |  |  |  |  |  |  | Murata | GRM1555C1H1R0C
 |  |  |  |  |  |  |  | EYANG | C0402C0G1R0C500NY
 |  |  |  |  |  |  |  | Darfon | C1005NPO109CGT
 |  |  | 电容，1.5pF | Cap，1.5pF ±0.25pF C0402 50V | C27 |  | 1 | YAGEO | CC0402CRNP09BN1R5
 |  |  |  |  |  |  |  | Murata | GRM1555C1H1R5C
 |  |  |  |  |  |  |  | EYANG | C0402C0G1R5C500NY
 |  |  |  |  |  |  |  | WALSIN | 0402N1R5C500CT
 |  |  |  |  |  |  |  | Darfon | C1005NPO159CGT
 |  |  | 电容，2.2pF | Cap，2.2pF ±0.25pF C0402 50V | C25 |  | 1 | YAGEO | CC0402CRNPO9BN2R2
 |  |  |  |  |  |  |  | Murata | GRM1555C1H2R2C
 |  |  |  |  |  |  |  | EYANG | C0402C0G2R2C500NY
 |  |  |  |  |  |  |  | Darfon | C1005NPO229CGT
 |  |  | 电容，6.8pF | Cap，6.8pF ±5% C0402 50V | C63 C68 |  | 2 | YAGEO | CC0402DRNPO9BN6R8
 |  |  | 电容，10pF | Cap，10pF ±5% C0402 50V | C15 C17 |  | 2 | YAGEO | CC0402JRNPO9BN100
 |  |  |  |  |  |  |  | Murata | GRM1555C1H100K
 |  |  |  |  |  |  |  | EYANG | C0402C0G100D500NY
 |  |  |  |  |  |  |  | Darfon | C1005NPO100DGT
 |  |  | 电容，12pF | Cap，12pF ±5% C0402 50V | C1 C16 C22 C37 |  | 4 | YAGEO | CC0402DRNPO9BN12R
 |  |  | 电容，33pF | Cap，33pF ±5% C0402 50V | C67 |  | 1 | YAGEO | CC0402JRNPO9BN330
 |  |  |  | Cap，33pF ±5% C0402 50V |  |  |  | Murata | GRM1555C1H330J
 |  |  |  |  |  |  |  | EYANG | C0402C0G330J500NY
 |  |  |  |  |  |  |  | Darfon | C1005NPO330JGT
 |  |  | 电容，1nF | Cap，1nF ±10% C0402 50V | C23 |  | 1 | YAGEO | CC0402KRX7R9BB102
 |  |  |  |  |  |  |  | Murata | GRM155R71H102K
 |  |  |  |  |  |  |  | EYANG | C0402X7R102K500NY
 |  |  |  |  |  |  |  | Darfon | C1005X7R102KGT
 |  |  | 电容，4.7nF | Cap，4.7nF ±10% C0402 50V |  |  |  | YAGEO | CC0402KRX7R9BB472
 |  |  | 电容，10nF | Cap，10nF ±10% C0402 25V | C9 |  | 1 | YAGEO | CC0402KRX7R9BB103
 |  |  |  |  |  |  |  | Murata | GRM155R71E103K
 |  |  |  |  |  |  |  | EYANG | C0402X7R103K250NY
 |  |  |  |  |  |  |  | WALSIN | 0402B103K250CT
 |  |  |  |  |  |  |  | Darfon | C1005X7R103KFT(25v)
 |  |  | 电容，100nF | Cap，100nF ±10% C0402 50V | C12 C13 C14 C44 C18 |  | 5 | YAGEO | CC0402KRX5R7BB104
 |  |  |  |  |  |  |  | Murata | GRM155R61A104K
 |  |  |  |  |  |  |  | EYANG | C0402X5R104K100NY
 |  |  |  |  |  |  |  | WALSIN | 0402B104K100CT
 |  |  |  |  |  |  |  | Darfon | C1005X5R104KET(16v)
C | 否 | 31 | 电容，1uF | Cap，1uF ±10% C0402 10V | C8 C39 C40 C41 C64 |  | 5 | YAGEO | CC0402KRX5R6BB105
 |  |  |  |  |  |  |  | Murata | GRM155R61A105K
 |  |  |  |  |  |  |  | EYANG | C0402X5R105K100NT
 |  |  |  |  |  |  |  | Darfon | C1005X5R105KDT
 |  |  | 电容，100nF | Cap，100nF ±10% C0603 16V | C2 C3 C4 C5 C6 C11 C19 C28 C31 C32 C33 C34 C35 C42 C53 C58 C59 C7 |  | 18 | YAGEO | CC0603KRX5R7BB104
 |  |  | 电容，1uF | CAP 0603 1uF 25V ±10% 注意电压 | C29 C36 C38 C45 C52 C54 C57 C65 C66 |  | 9 | YAGEO | CC0603KRX5R8BB105
 |  |  | 电容，2.2uF | Cap，2.2uF ±10% C0603 6.3V | C61 C62 C55 |  | 3 | YAGEO | CC0603KRX5R5BB225
 |  |  |  |  |  |  |  | Murata | GRM188R60J225KE26
 |  |  |  |  |  |  |  | EYANG | C0603X5R225K6R3NT
 |  |  |  |  |  |  |  | WALSIN | 0603X225K6R3CT
 |  |  |  |  |  |  |  | Darfon | C1608X5R225KCT
 |  |  | 电容，4.7uF | Cap，4.7uF +/-10% 0603 6.3V | C48 |  | 1 | YAGEO | CC0603KRX5R5BB475
 |  |  |  | Cap，4.7uF +/-10% 0603 6.3V |  |  |  | Murata | GRM188R60J475K
 |  |  |  |  |  |  |  | EYANG | C0603X5R475K6R3NT
 |  |  |  |  |  |  |  | Darfon | C1608X5R475KCT
C | 否 | 34 | 电容，10uF | Cap，10uF ±20% 0603 6.3V X5R | C46 C56 C60 C149 C156 |  | 5 | YAGEO | CC0603MRX5R5BB106
 |  |  |  |  |  |  |  | Murata | GRM188R60J106M
 |  |  |  |  |  |  |  | EYANG | C0603X5R106M6R3NT
 |  |  |  |  |  |  |  | WALSIN | 0603X106K6R3
 |  |  |  |  |  |  |  | Darfon | C1608X5R106MCT
 |  |  | 电容，4.7uF | Cap，4.7uF ±10% 0805 6.3V X5R | C10 C43 |  | 2 | YAGEO | CC0805KRX5R5BB475
 |  |  | 电容，22uF | Cap，22uF ±20% 1206 25V 注意电压 | C20 C21 |  | 2 | YAGEO | CC1206MKX7R5BB226
 |  |  | 电阻，0Ω | Res 0Ω ±5% 0402 1/16W | R11 R26 R15 |  | 3 | YAGEO | RC0402JR-070RL
 |  |  | 电阻，100Ω | Res 100Ω ±5% 0402 1/16W | R25 |  | 1 | YAGEO | RC0402JR-07100RL
 |  |  | 电阻，470Ω | Res 470Ω ±5% 0402 1/16W | R38 R44 R20 R52 R53 R54 |  | 6 | YAGEO | RC0402JR-07470RL
 |  |  | 电阻，1KΩ | Res 1KΩ ±5% 0402 1/16W | R36 R37 R39 R40 R49 |  | 5 | YAGEO | RC0402JR-071KL
 |  |  | 电阻，3.9KΩ | Res 3.9KΩ ±5% 0402 1/16W | R12 |  | 1 | YAGEO | RC0402JR-073K9L
 |  |  | 电阻，4.7KΩ | Res 4.7KΩ ±5% 0402 1/16W | R50 |  | 1 | YAGEO | RC0402JR-074K7L
 |  |  | 电阻，10KΩ | Res 10KΩ ±5% 0402 1/16W | R34 R41 R51 R55 R1 R50 R51 |  | 7 | YAGEO | RC0402JR-0710KL
 |  |  | 电阻，15KΩ | Res 15KΩ ±5% 0402 1/16W | R47 |  | 1 | YAGEO | RC0402JR-0715KL
 |  |  | 电阻，24KΩ | Res 24KΩ ±5% 0402 1/16W | R13 |  | 1 | YAGEO | RC0402JR-0724KL
 |  |  | 电阻，100KΩ | Res 100KΩ ±5% 0402 1/16W | R45 |  | 1 | YAGEO | RC0402JR-07100KL
 |  |  | 电阻，130KΩ | Res 130KΩ ±5% 0402 1/16W | R46 |  | 1 | YAGEO | RC0402JR-07130KL
 |  |  | 电阻，0Ω | RES 0Ω 0603 ±5% 1/10W | R7 R14 R28 R29 R65 R23 R31 R32 R106 R21 |  | 10 | YAGEO | RC0603JR-070RL
 |  |  | 电阻，500Ω | RES 50Ω 0603 ±1% 1/10W | R6 |  | 1 | YAGEO | RC0603FR-0750RL
 |  |  | 电阻，1.5KΩ | RES1.5KΩ 0603 ±5% 1/10W | R27 |  | 1 | YAGEO | RC0603JR-071K5L
 |  |  | 电阻，3.6KΩ | RES3.6KΩ 0603 ±5% 1/10W | R22 |  | 1 | YAGEO | RC0603JR-073K6L
 |  |  | 电阻，4.7KΩ | RES4.7KΩ 0603 ±5% 1/10W | R9 R17 R18 R19 R33 |  | 5 | YAGEO | RC0603JR-074K7L
 |  |  | 电阻，10KΩ | RES 10KΩ 0603 ±5% 1/10W | R2 R4 R16 |  | 3 | YAGEO | RC0603JR-0710KL
 |  |  | 电阻，680KΩ | RES 680KΩ 0603 ±5% 1/10W | R8 |  | 1 | YAGEO | RC0603JR-07680KL
 |  |  | TYPE C USB 母座 | 3.1母座单排16P SMT沉板1.6 | J6 |  | 1 | 铭森威 | 014101010-040
 |  |  | BTB连接器 插座 | 10pin BTB，female，窄体，mate=0.9mm | J4 J6207 |  | 2 | 京瓷 | 24 5804 010 000 829+
 |  |  | ZIF FPC连接器 | 30pin 0.5mm ZIF FPC连接器 | J5 |  | 1 | HRS | FH19SC-30S-0.5SH(05)
 |  |  | 拨动开关 | 进口日本SM --K贴片表贴侧拨 3脚2档 拨动开关 微型 波动滑动开关；2.5*7 | J3 |  | 1 |  | 贴片 轻触开关 3*4*2.5mm
