NewEconoLab/NeoDun/硬件设计/NEODUN结构/请购单0924-加工件.xls

条目名称 | 描述/规格/型号/说明/要求/备注 | 数量（台） | 用途 | 要求到货日期 | 备注 | 链接 (如适用）
框架 | NEO-01 | 1 |  |  | 材质：6061 阳极氧化
背板 | NEO-02 | 1 |  |  | PC、黑色，丝印（见丝印图）
玻璃面板 | NEO-03 | 1 |  |  | 材质：钢化玻璃、丝印（见丝图）
挡板 | NEO-04 | 1 |  |  | 材质：304、钣金
 |  |  |  |  | 2017 年 月 日
 |  |  |  |  | 2017 年 月 日
