NewEconoLab/NeoDun/硬件设计/NEODUN结构/NEO装配体_1.sldasm

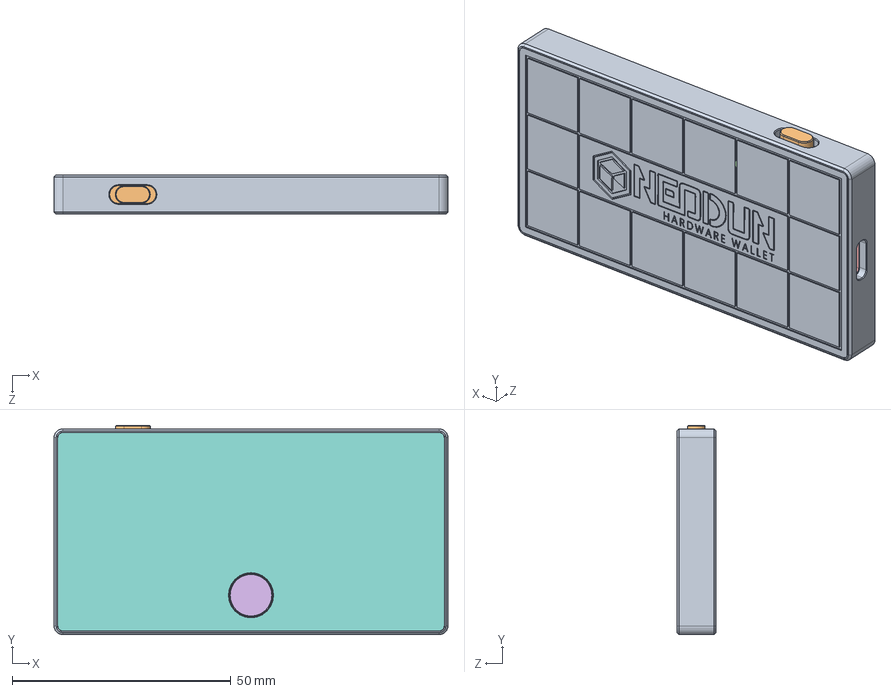
[picture p57: CAD file, 2017-12-01]
硬件设计/NEODUN结构/NEO装配体_1.sldasm
90.0 x 47.8 x 9.00 mm
NEO-01
屏幕_1
MB-PCB_1
FH19C-30S-0.5SH_1
Type-C_1
SS-1290_1
NEO-03 x 2
NEO-02
拨动开关_1
NEO-04
cross recessed cheese head screws type a gb_GB M1.6X2.5-S x 6
触摸按键
指纹识别按键
gb_GB M1.6X1.6 大头 x 3
