NewEconoLab/NeoDun/硬件设计/NEODUN结构/MB-PCB_1.sldasm

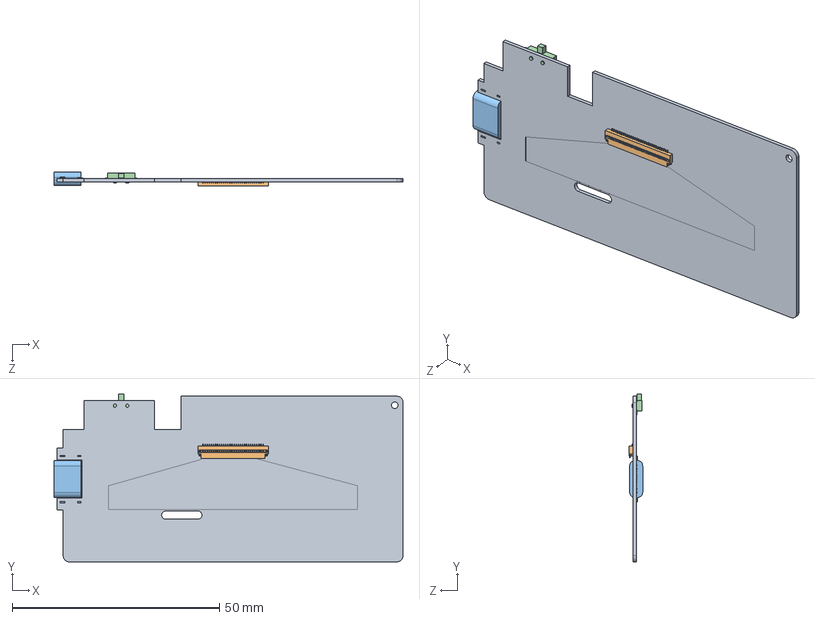
[picture p58: CAD file, 2017-12-01]
硬件设计/NEODUN结构/MB-PCB_1.sldasm
84.2 x 40.5 x 3.26 mm
MB-PCB_1
FH19C-30S-0.5SH_1
Type-C_1
SS-1290_1
