NewEconoLab/NeoDun/产品/NEO发图12.26/NEO-05.STEP

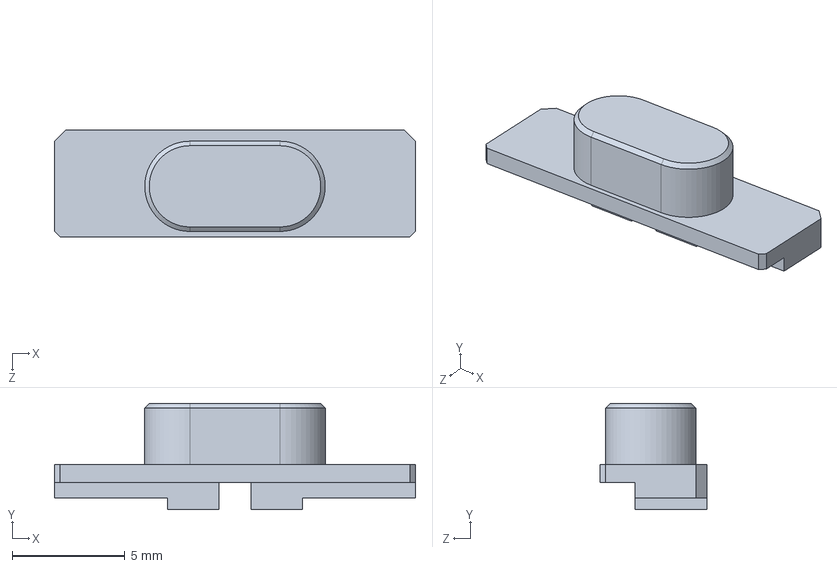
[picture p59: CAD file, 2018-06-04]
产品/NEO发图12.26/NEO-05.STEP
16.0 x 4.70 x 4.75 mm
