NewEconoLab/NeoDun/硬件设计/NEODUN结构/NEO触摸按键.dxf

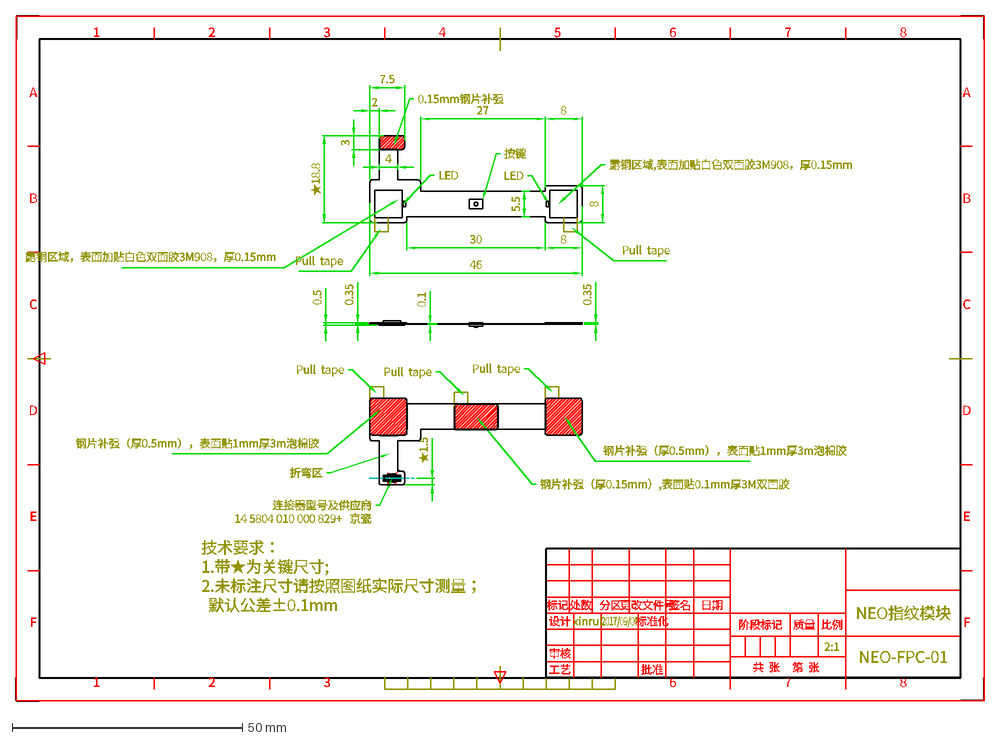
[picture p60: CAD file, 2018-06-04]
硬件设计/NEODUN结构/NEO触摸按键.dxf
A
B
C
D
E
F
2
1
3
4
5
6
7
8
NEO-FPC-01
NEO指纹模块
2:1
xinrui
2017/09/06
阶段标记
质量
比例
分区
处数
标记
签名
日期
更改文件号
工艺
设计
审核
批准
标准化
第 张
共 张
技术要求： 1.带★为关键尺寸; 2.未标注尺寸请按照图纸实际尺寸测量； 默认公差±0.1mm
折弯区
0.15mm钢片补强
Pull tape
46
5.5
30
7.5
10
连接器型号及供应商 14 5804 010 000 829+ 京瓷
★1.5
LED
按键
0.35
0.1
0.5
★18.8
27
钢片补强（厚0.15mm）,表面贴0.1mm厚3M双面胶
钢片补强（厚0.5mm），表面贴1mm厚3m泡棉胶
露铜区域,表面加贴白色双面胶3M908，厚0.15mm
露铜区域，表面加贴白色双面胶3M908，厚0.15mm
