NewEconoLab/NeoDun/产品/NEO发图12.26/NEO-01.STEP

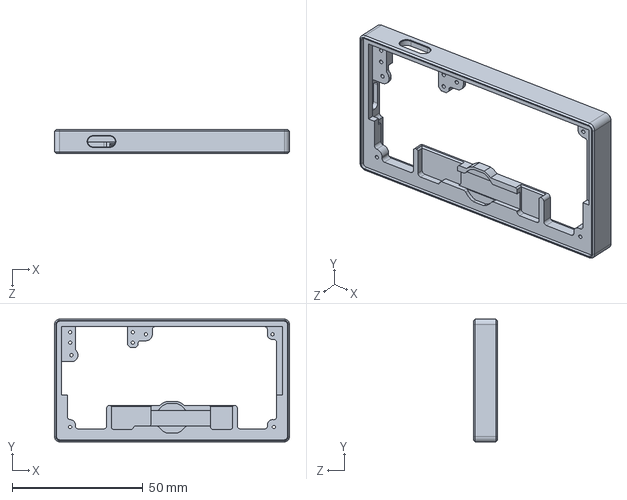
[picture p61: CAD file, 2018-05-02]
产品/NEO发图12.26/NEO-01.STEP
90.0 x 47.0 x 9.00 mm
