NewEconoLab/NeoDun/产品/NEO发图12.26/NEO-02.STEP

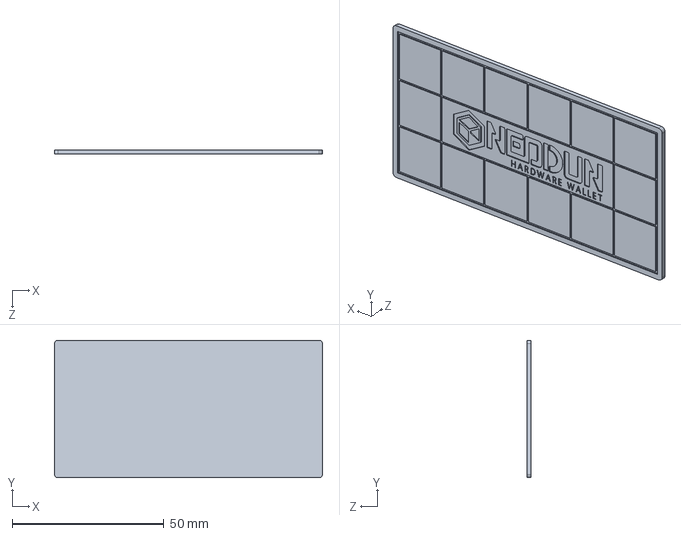
[picture p62: CAD file, 2018-05-02]
产品/NEO发图12.26/NEO-02.STEP
88.3 x 45.3 x 1.20 mm
