NewEconoLab/NeoDun/硬件设计/NEODUN结构/gb_GB M1.6X1.6 大头.SLDPRT

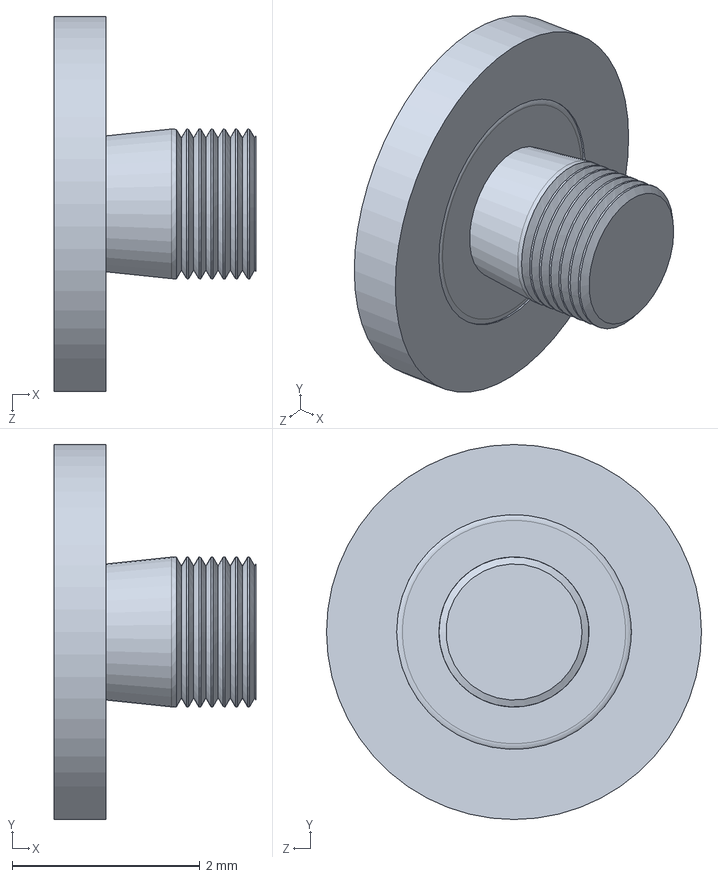
[picture p63: CAD file, 2017-12-01]
硬件设计/NEODUN结构/gb_GB M1.6X1.6 大头.SLDPRT
2.15 x 4.00 x 4.00 mm
