NewEconoLab/NeoDun/产品/NEO发图12.26/NEO-04.STEP

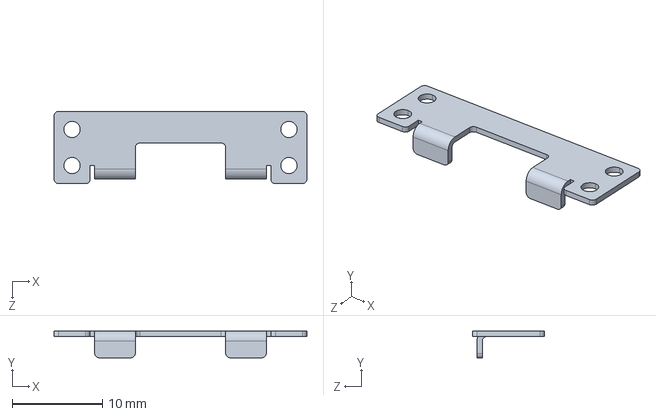
[picture p65: CAD file, 2018-05-02]
产品/NEO发图12.26/NEO-04.STEP
28.0 x 2.95 x 8.00 mm
