NewEconoLab/NeoDun/硬件设计/NEODUN结构/指纹识别按键.SLDPRT

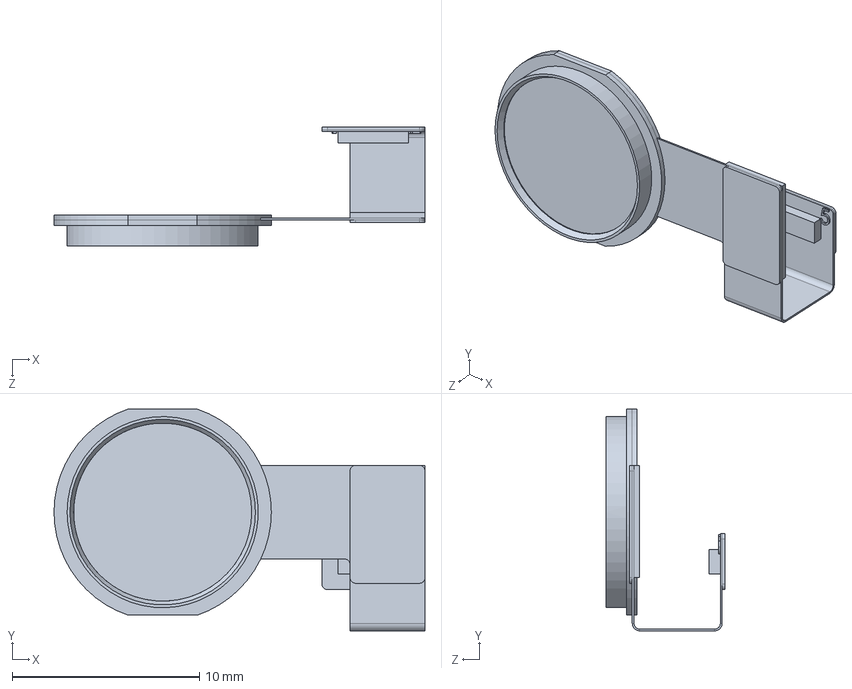
[picture p66: CAD file, 2017-12-01]
硬件设计/NEODUN结构/指纹识别按键.SLDPRT
19.8 x 11.8 x 6.35 mm
