NewEconoLab/NeoDun/硬件设计/NEODUN结构/触摸按键.SLDPRT

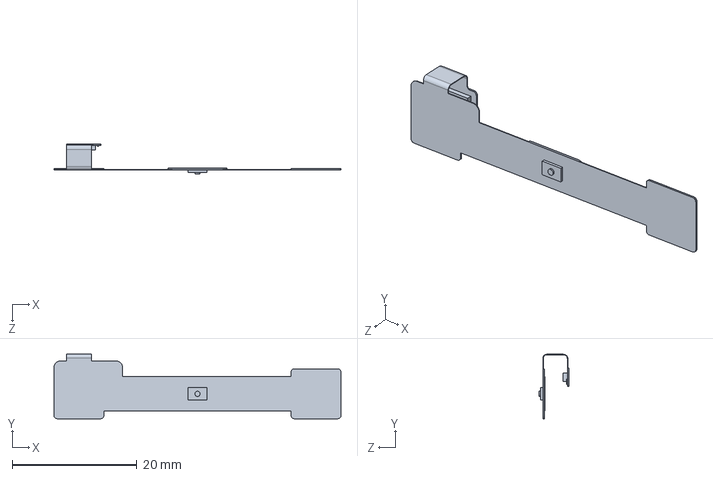
[picture p68: CAD file, 2017-12-01]
硬件设计/NEODUN结构/触摸按键.SLDPRT
46.0 x 10.3 x 4.75 mm
