NewEconoLab/NeoDun/硬件设计/NEODUN结构/NEO-02.SLDPRT

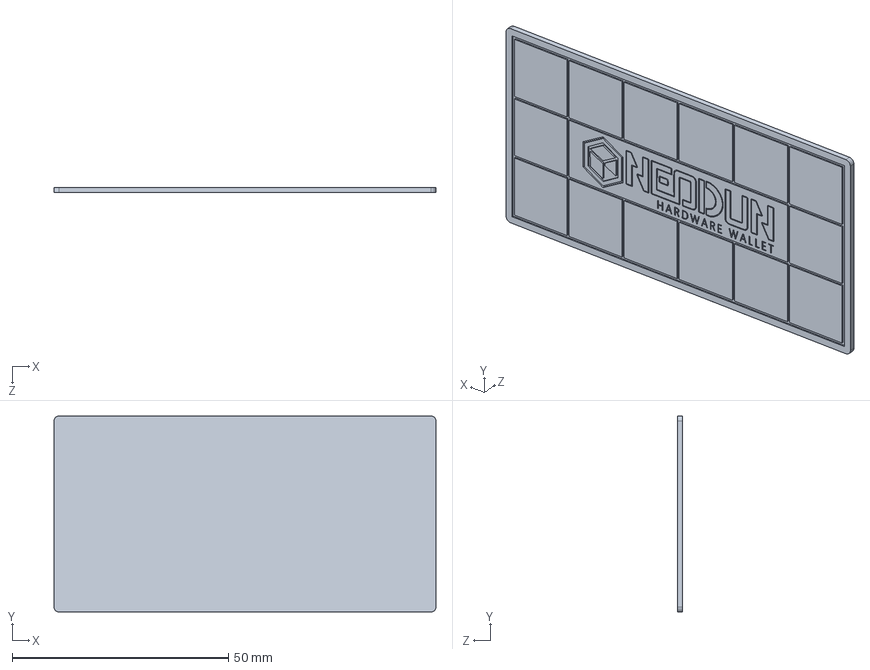
[picture p69: CAD file, 2017-12-01]
硬件设计/NEODUN结构/NEO-02.SLDPRT
88.3 x 45.3 x 1.20 mm
