NewEconoLab/NeoDun/硬件设计/NEODUN结构/NEO指纹识别0921.dxf

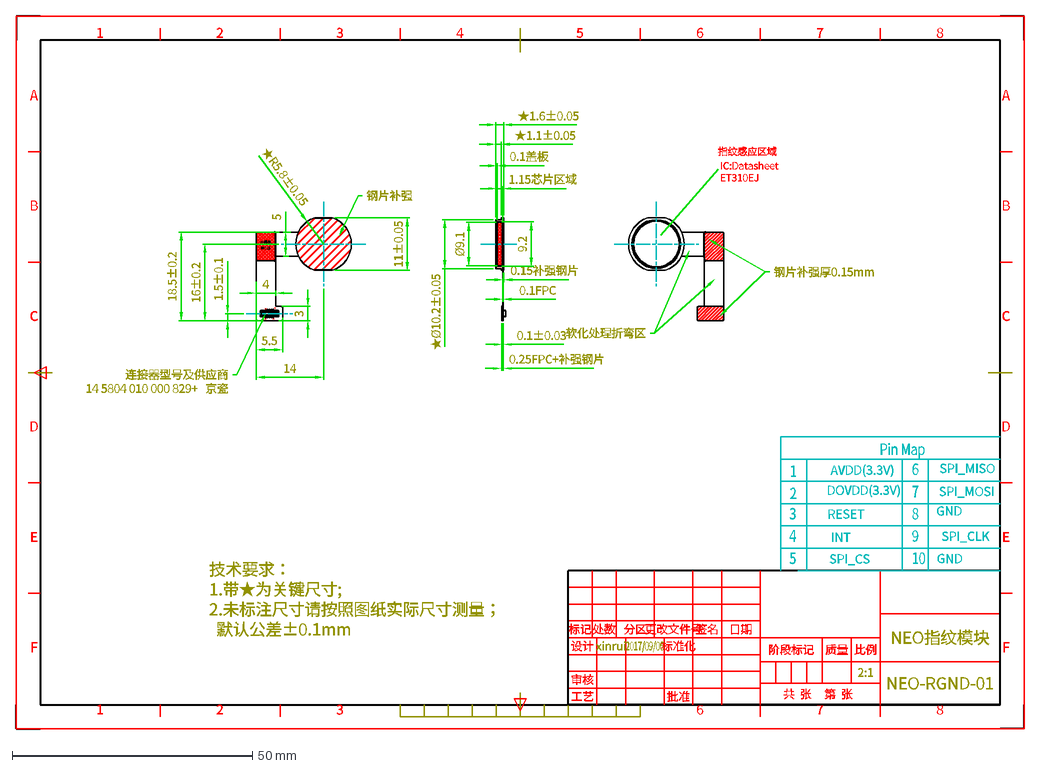
[picture p70: CAD file, 2017-12-01]
硬件设计/NEODUN结构/NEO指纹识别0921.dxf
A
B
C
D
E
F
2
1
3
4
5
6
7
8
NEO-RGND-01
NEO指纹模块
2:1
xinrui
2017/09/06
阶段标记
质量
比例
分区
处数
标记
签名
日期
更改文件号
工艺
设计
审核
批准
标准化
第 张
共 张
Pin Map
AVDD(3.3V)
DOVDD(3.3V)
RESET
INT
SPI_CS
10
9
SPI_MOSI
SPI_MISO
GND
SPI_CLK
★1.1±0.05
★1.6±0.05
器件区
H<0.5
16±0.2
18.5±0.2
IC:Datasheet ET310EJ
指纹感应区域
1.5±0.1
14
5.5
★Ø10.2±0.05
连接器型号及供应商 14 5804 010 000 829+ 京瓷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
