NewEconoLab/NeoDun/(list of files, cad)

Other CAD files:
硬件设计/NEODUN结构/NEO-01.SLDPRT
硬件设计/NEODUN结构/FH19C-30S-0.5SH_1.sldprt
硬件设计/NEODUN结构/NEO-03.SLDPRT
硬件设计/NEODUN结构/拨动开关_1.sldprt
硬件设计/NEODUN结构/NEO-04.SLDPRT
硬件设计/NEODUN结构/屏幕_1.sldprt
硬件设计/NEODUN结构/Type-C_1.sldprt
硬件设计/NEODUN结构/SS-1290_1.sldprt
硬件设计/NEODUN结构/223242-300_1.sldprt
硬件设计/NEODUN结构/MB-PCB_1.sldprt
硬件设计/NEODUN结构/NEO-01.SLDDRW
硬件设计/NEODUN结构/NEO-03.SLDDRW
硬件设计/NEODUN结构/NEO-04.SLDDRW
硬件设计/NEODUN结构/cross recessed cheese head screws type a gb_GB M1.6X2.5-S.sldprt
