NewEconoLab/NeoDun/产品/生产组装概览.docx

## 主要物料型号

屏幕：M00160_VGM256064A0B01_A04

加密芯片：ATSHA204A

电池：252038，150mAh

其他见BOM表

## 生产流程

## 成本估算

项目 | 样品数量 | 样品均价 | 100套估算 | 1000套估算 | 说明
FPC板制版+贴片 | 20 | 25 | 25 | 21 | 1000套按15%off算
主板制版 | 31 | 30 | 30 | 25 | 1000套按15%off算
主板贴片 | 15 | 233 | 35 | 30 | 1000套按15%off算
物料备料*套 | 20 | 117 | 117 | 100 | 1000套按15%off算
显示屏 | 5 | 100 | 80 | 70 | 厂商报价70~80
电池 | 5 | 4.5 | 135 | 18 | 10000pic起订，需提前一个月下单，预付30%，提货按70%价格算
指纹模块 | 0 | 0 | 0 | 0 | 指纹订制需要10K以上产量，研发周期3个月以上
外壳 | 10 | 1030 | 200 | 100 | 赖总估计量产100~200
总计 | | 1539.5 | 622 | 364
