NewEconoLab/NeoDun/驱动程序与钱包/NEODUN-testapp/README.md

#vue-neodun-wallet
基于neowallet 进行钱包页面开发，前端语言使用vue
