NewEconoLab/NeoDun/驱动程序与钱包/neoHardWallet/testsign.txt

协议1 state 检查钱包是否连接
参数：无参数
http://localhost:50288/_api/state

协议2 listaddress
参数：无参数
http://localhost:50288/_api/listaddress

协议3 签名数据
地址
sign
参数
type   neo
source 签名者地址
data   签名数据

http://localhost:50288/_api/sign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
