NewEconoLab/NeoDun/驱动程序与钱包/NEODUN-testapp/img/wallet.png

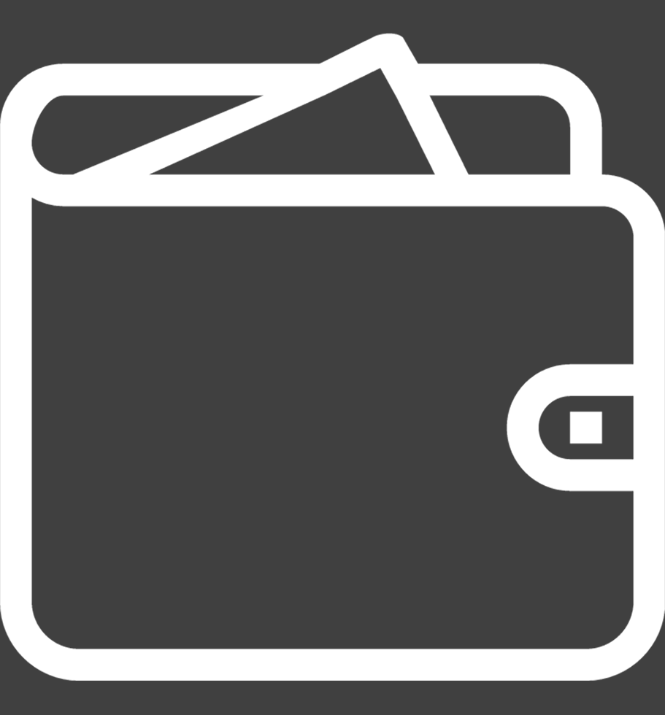
驱动程序与钱包/NEODUN-testapp/img/wallet.png
