NewEconoLab/NeoDun/硬件设计/NEO_MB_V1.pdf

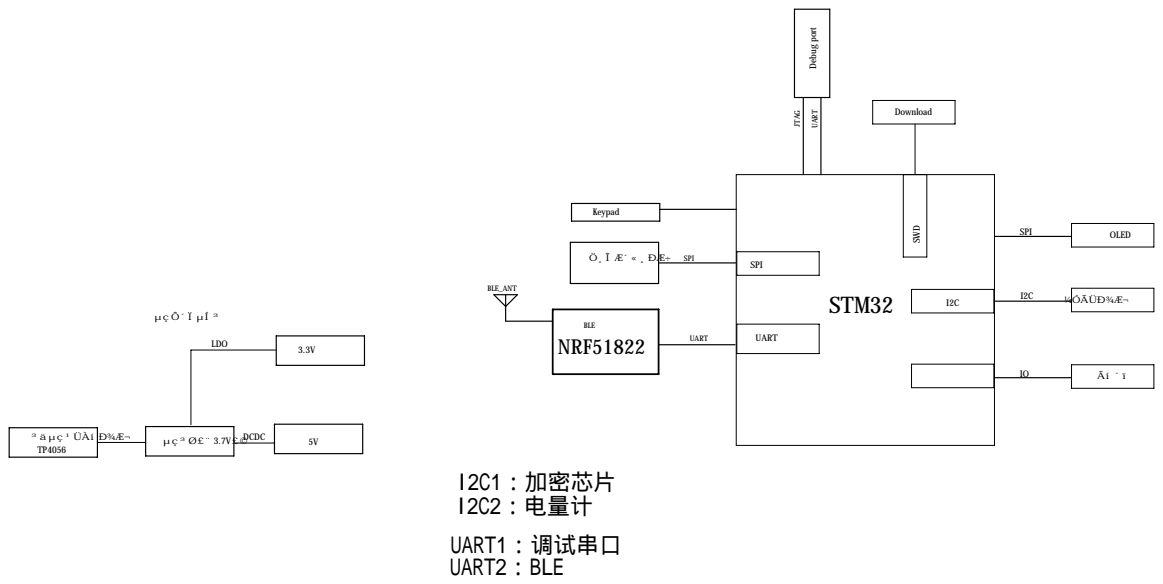
[picture p73: page 1]
松江区; Title; <SCHEMATIC>; SPI; NRF51822; BLE_ANT; UART; STM32; SWD; Download; JTAG; Keypad; BLE; ³äµç¹ÜÀíÐ¾Æ¬; µç³Ø£¨3.7V£©; LDO; DCDC; µçÔ´ÏµÍ³; UART1：调试串口; I2C1：加密芯片; UART2：BLE; ¼ÓÃÜÐ¾Æ¬; OLED; I2C2：电量计

UART Debug port

上海沃手通讯科技有限公司
Shanghai Wal-hand Communication Technology Co., Ltd.

NOT TO BE USED, COPIED, REPRODUCED IN WHOLE OR IN PART, NOR

ITS CONTENTS REVEALED IN ANY MANNER TO OTHERS WITHOUT THE

Wal-hand communication Confidential
and Proprietary

EXPRESS WRITTEN PERMISSION OF Wal-hand communication.

THIS TECHNICAL DATA MAY BE SUBJECT TO CHINA AND INTERNATIONAL

EXPORT, RE-EXPORT OR TRANSFER ("EXPORT") LAWS. DIVERSION

CONTRARY TO CHINA AND INTERNATIONAL LAW IS STRICTLY PROHIBITED

Size | Sheet Name | Rev <A>

Copyright (C) 2016 Wal-hand communication Incorporated

All rights reserved

Date: | Sheet of

# 充电电路

# Gas Gauge

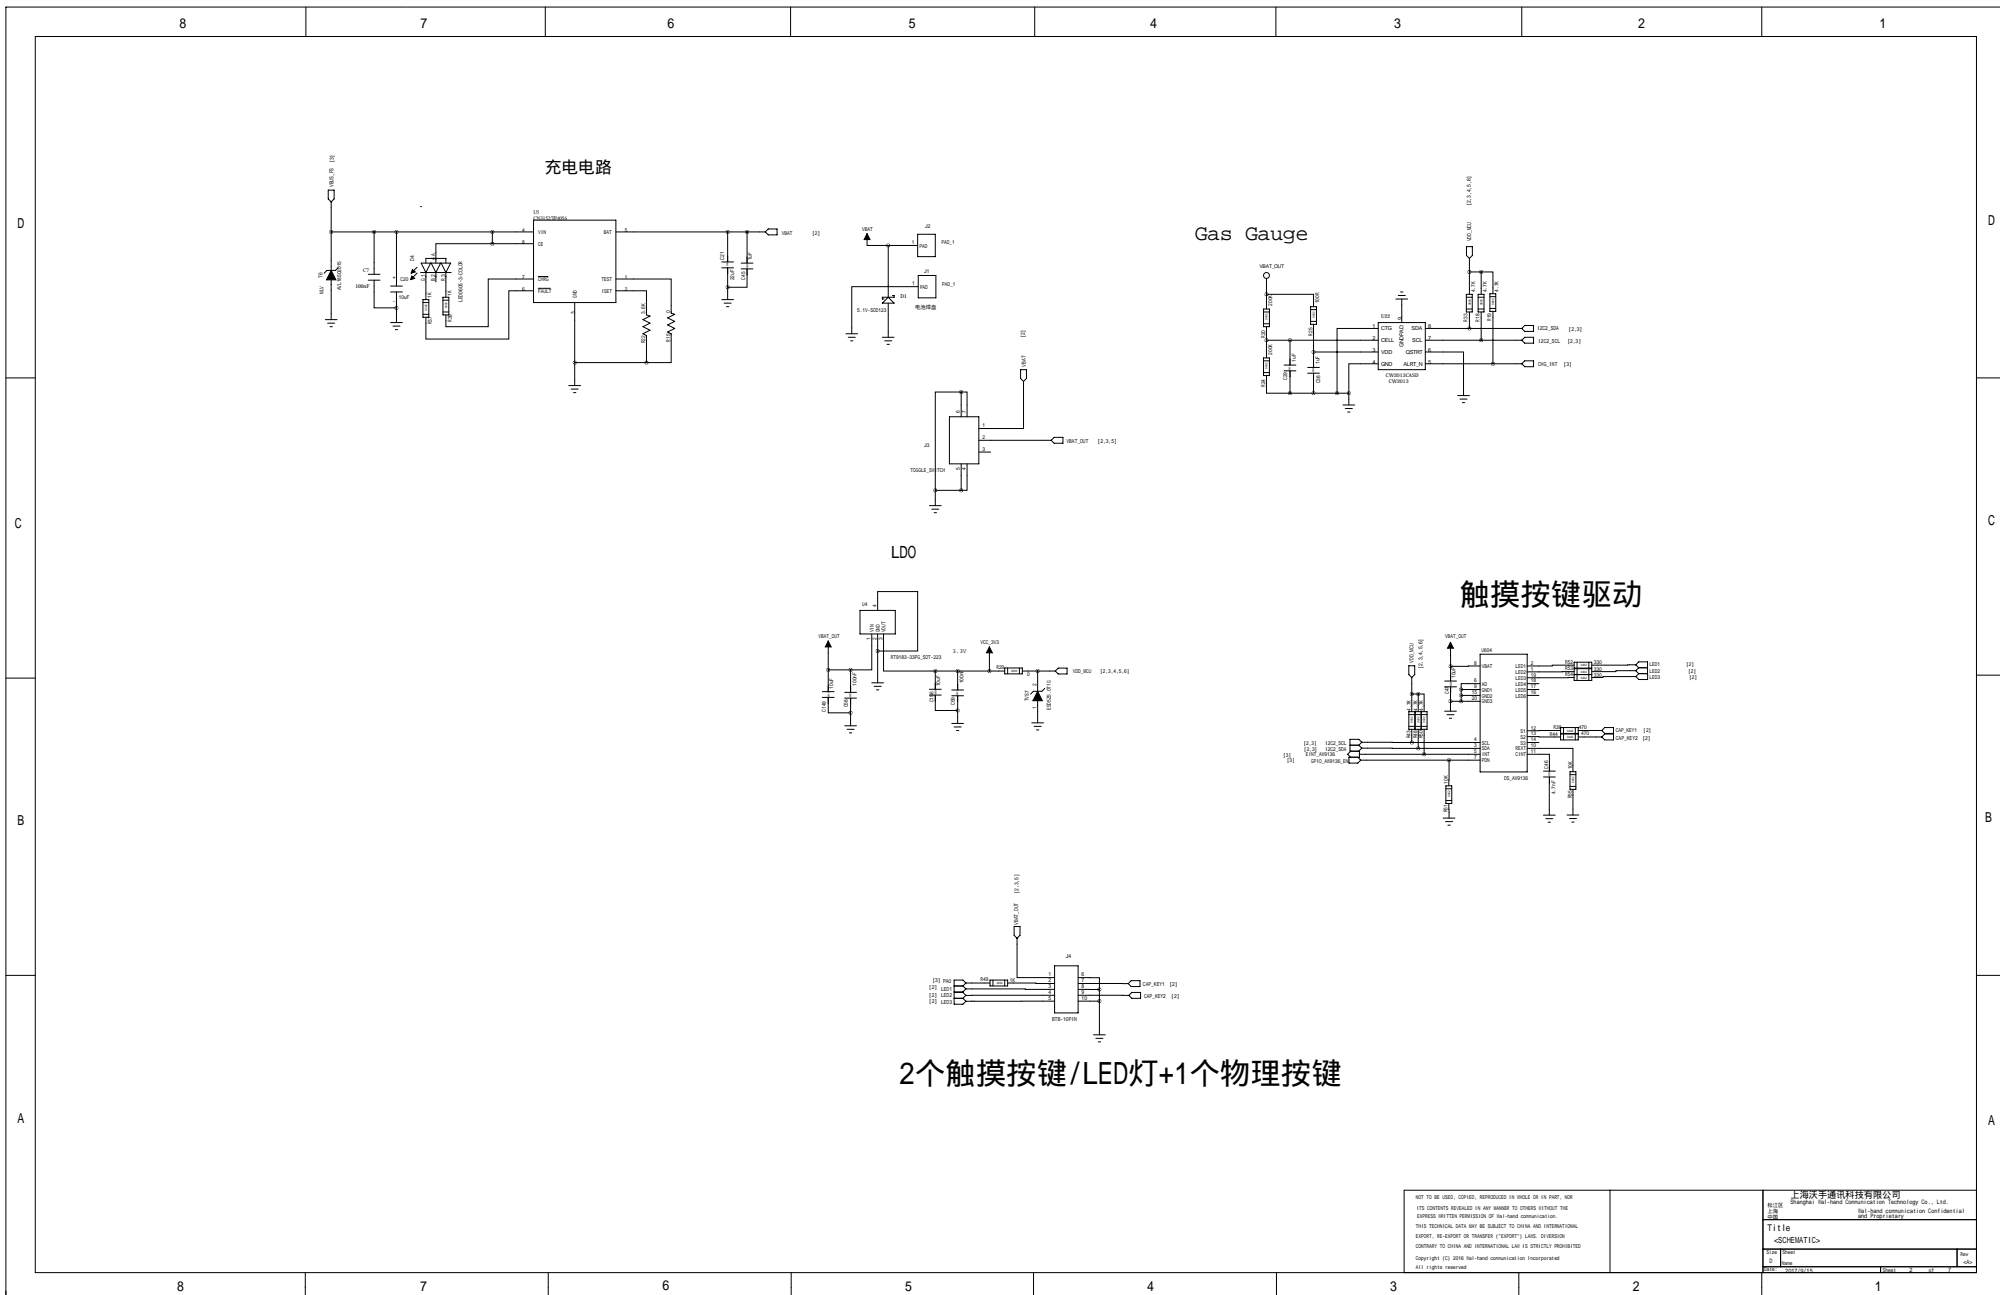
[picture p74: page 2]

STM32_SWD下载接口 | USB_OTG_FS接口

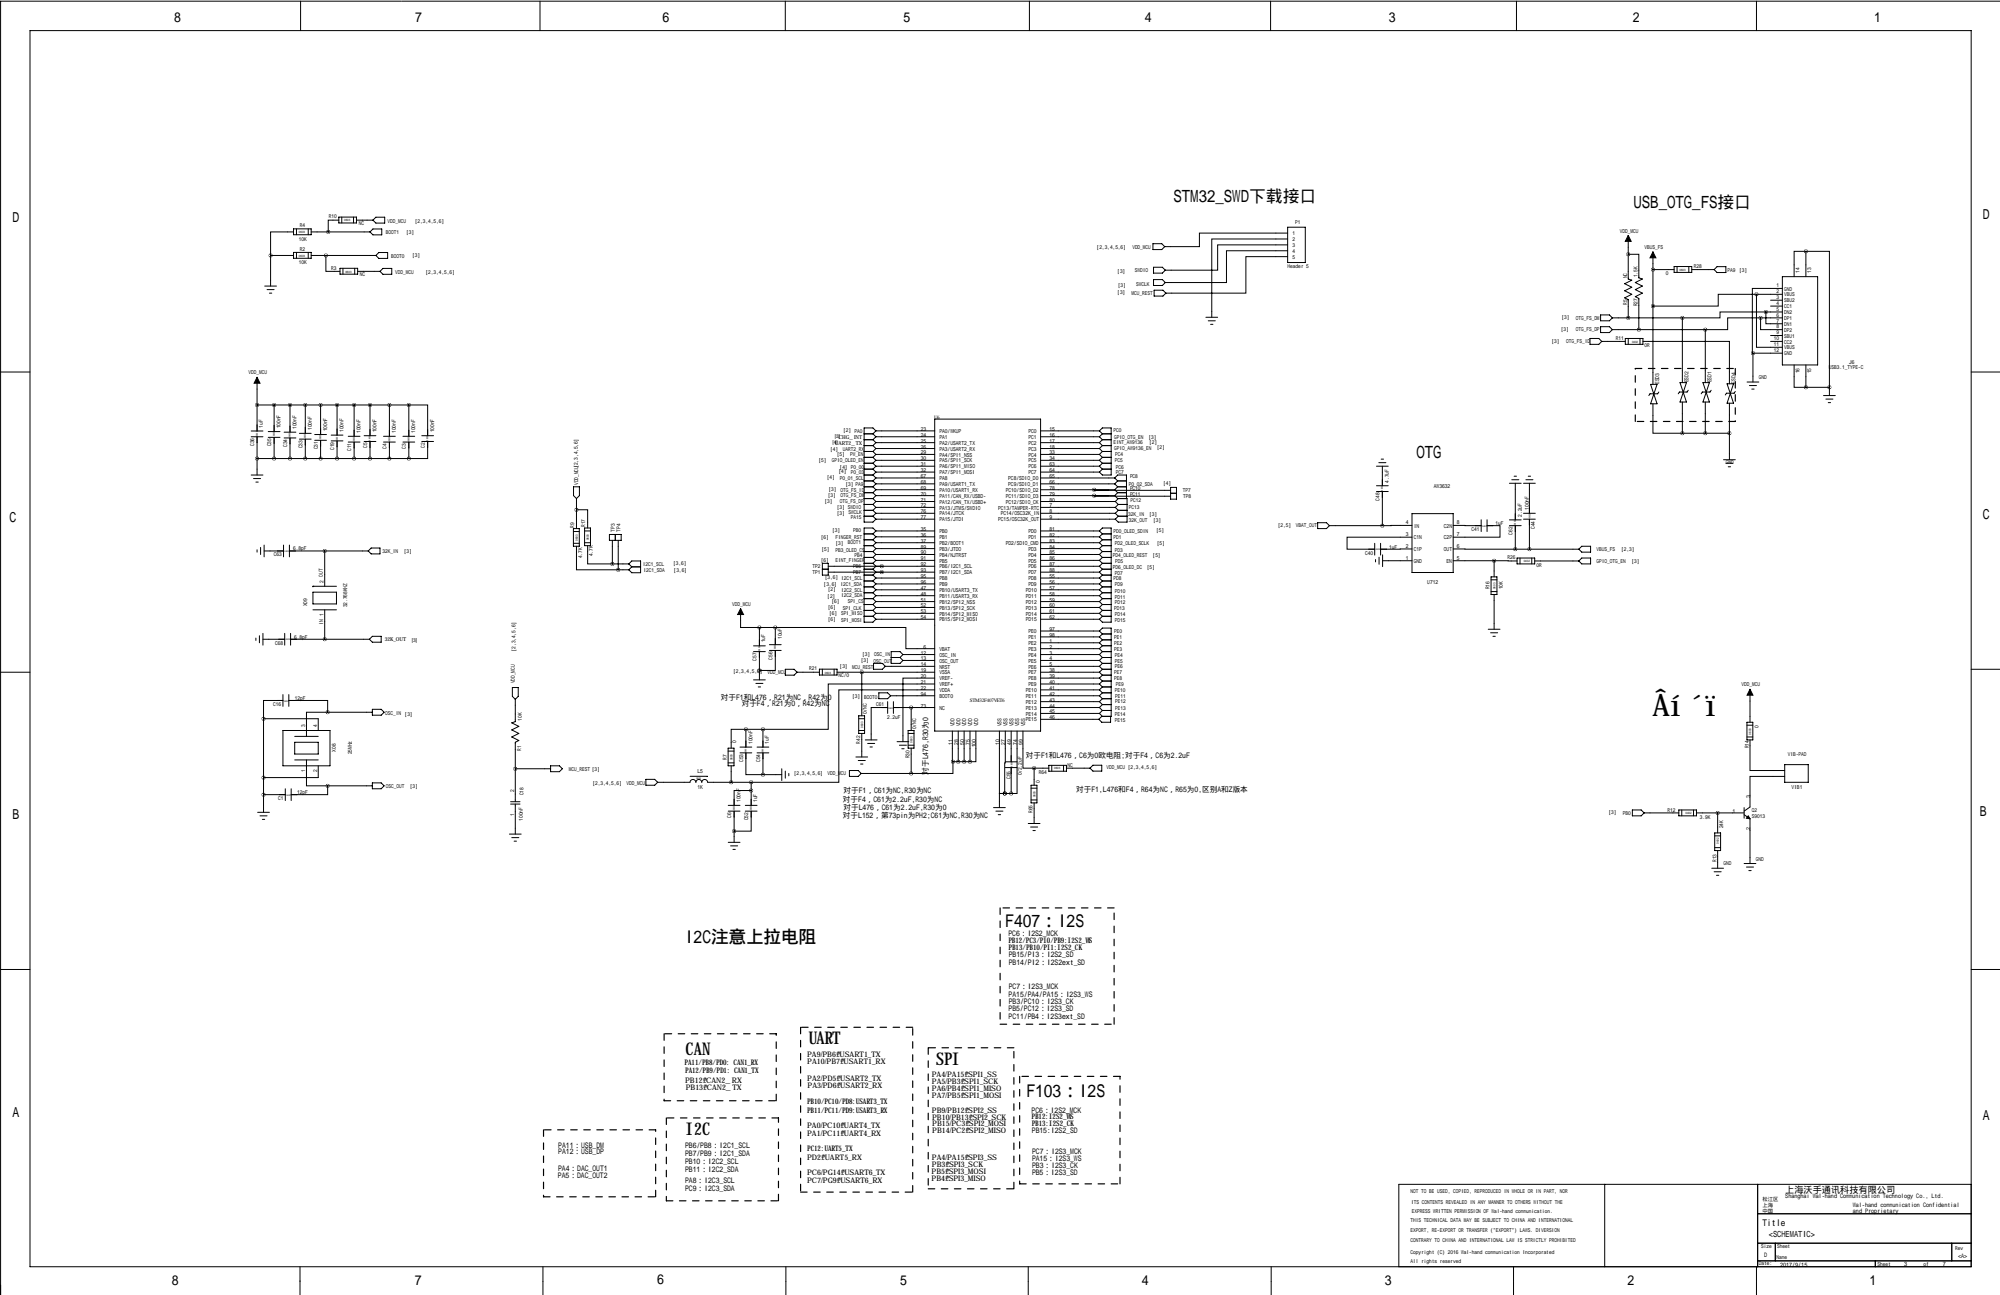
[picture p75: page 3]

BT

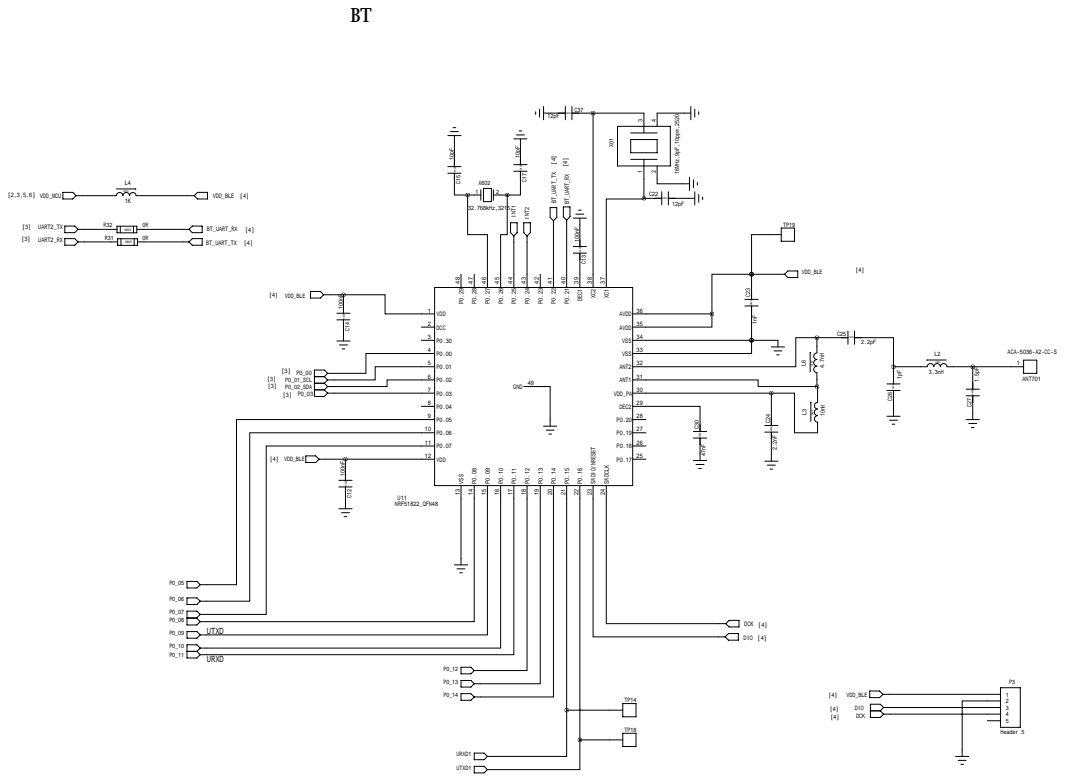
[picture p76: page 4]

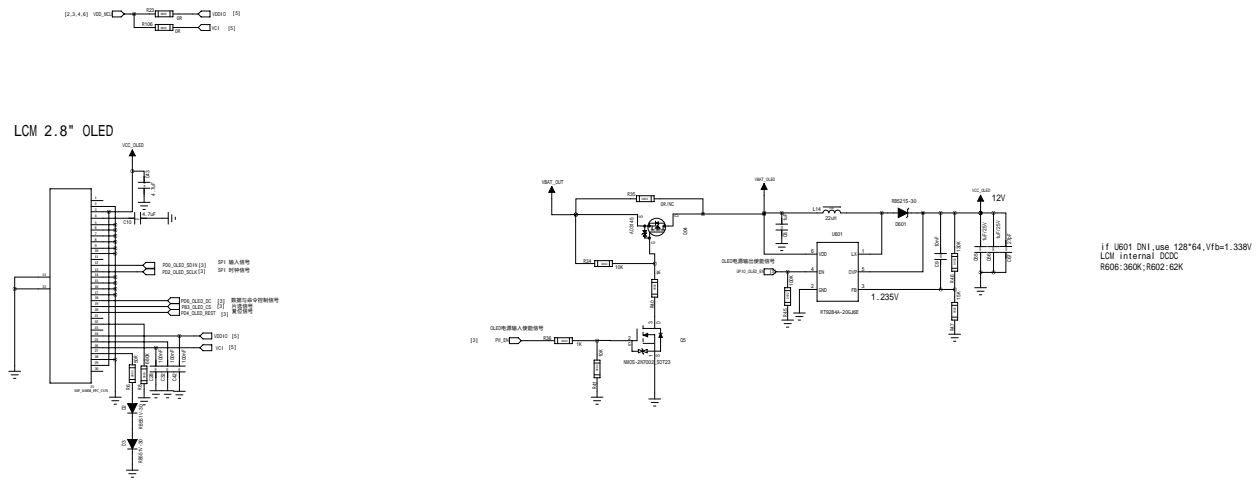
[picture p77: page 5]

if U601 DNI,use 128*64,Vfb=1.338V
LCM internal DCDC

10
11 12

13
14

16
17
18 19 20 21 22

28
29

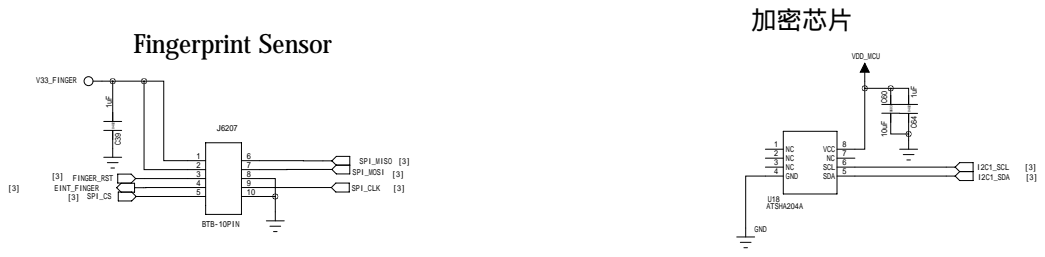
[picture p78: page 6]
Fingerprint Sensor; 加密芯片; BTB-10PIN; GND; SDA; SCL; VCC; U18 ATSHA204A; V33_FINGER; SPI_MOSI [3]; SPI_CLK; SPI_MISO [3]; [3] SPI_CS; [3] EINT_FINGER; FINGER_RST; I2C1_SDA; I2C1_SCL; VDD_MCU

# CHANGE NOTES

NO. | CR NO.

1

V1.0.1 2345678

10

11

12
