NewEconoLab/NeoDun/驱动程序与钱包/驱动签名机通讯时序图.pdf

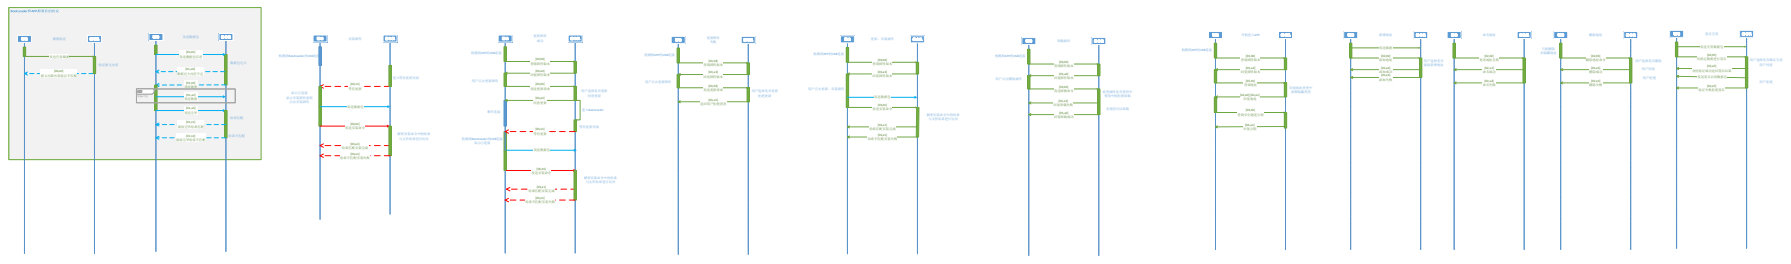
[picture p79: page 1]
签名机; 检测到BootLoader; 的USB连接 显示已连接; 检测到APP; 的USB连接; [03,04] 查询固件版本; [03,a4] 回复固件版本; 用户点击更新固件; [03,02] 发送更新请求; 用户选择是否更新 同意更新; 进入BootLoader; 等待更新页面 [03,11]; 等待更新; [03,11] 等待更新; 进入等待更新页面; 显示已连接 显示安装固件按钮 点击安装固件; 断开连接; [03,01] 发送安装命令; 发送数据包; [03,a1] 哈希匹配安装完成; 安装固件; 更新固件 成功; 解密安装命令中的哈希 与文件哈希进行比对; 发送更新请求; 用户选择是否更新; 拒绝更新; 更新固件 失败; [03,e2] 返回用户拒绝消息; 用户点击更新; 、安装插件; 用户点击删除插件; 回复固件版本; 卸载插件; 发送卸载命令; 检查插件是否使用中; 使用中则拒绝卸载; 未使用可以卸载; [03,e3] 回复卸载失败; [03,a3] 回复卸载成功; 开机进入APP; [02,01] 查询地址; [02,a0];[02,a1] 回复地址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
