NewEconoLab/NeoDun/产品/NEO发图12.26/NEO-05.PDF

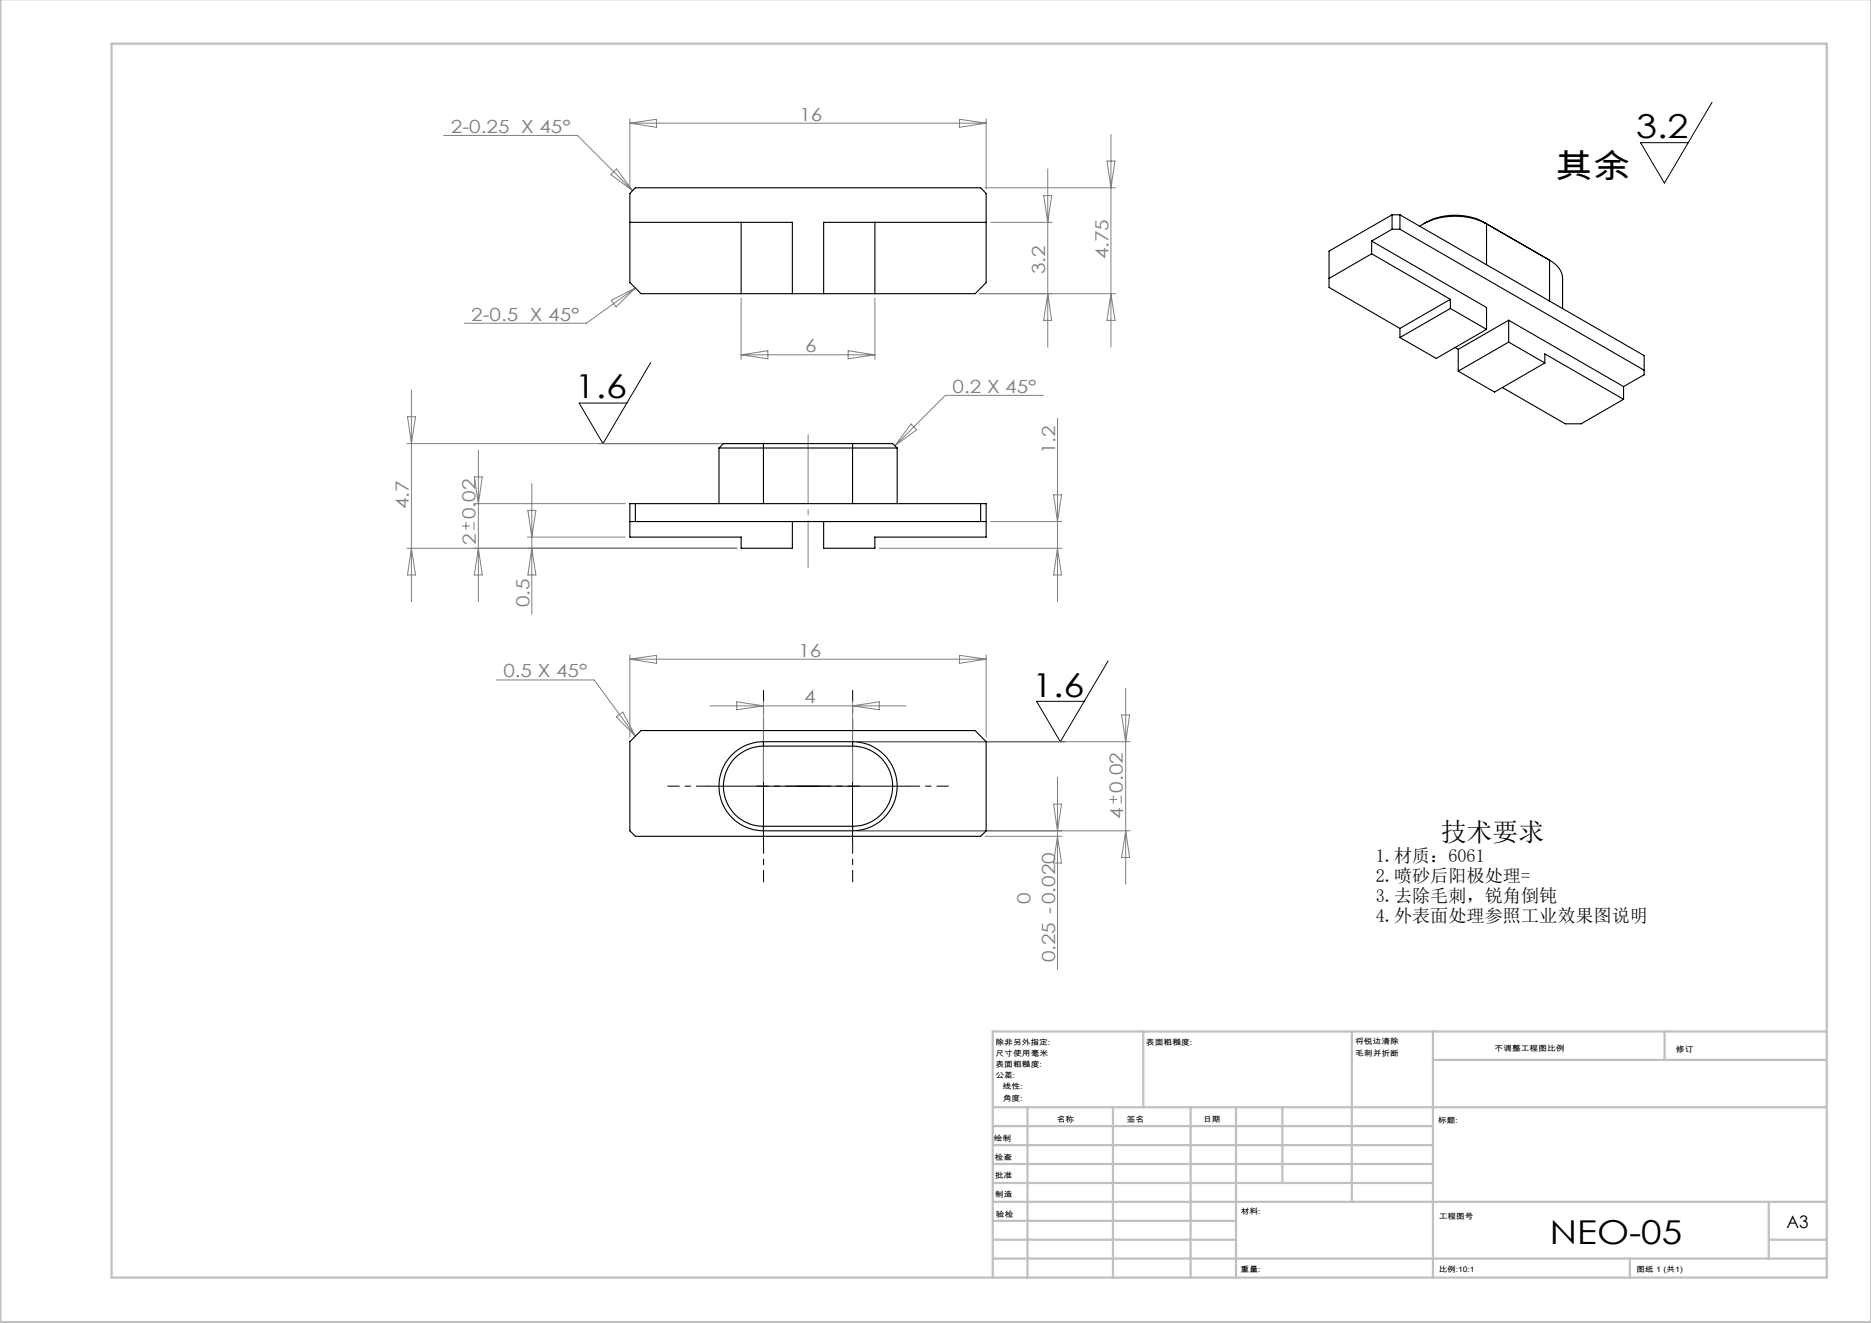
[picture p80: page 1]

绘制
检查
批准
制造
验检 | | | | 材料: | 工程图号 NEO-05 重量: | A3
