NewEconoLab/NeoDun/产品/NEO发图12.26/NEO-02.PDF

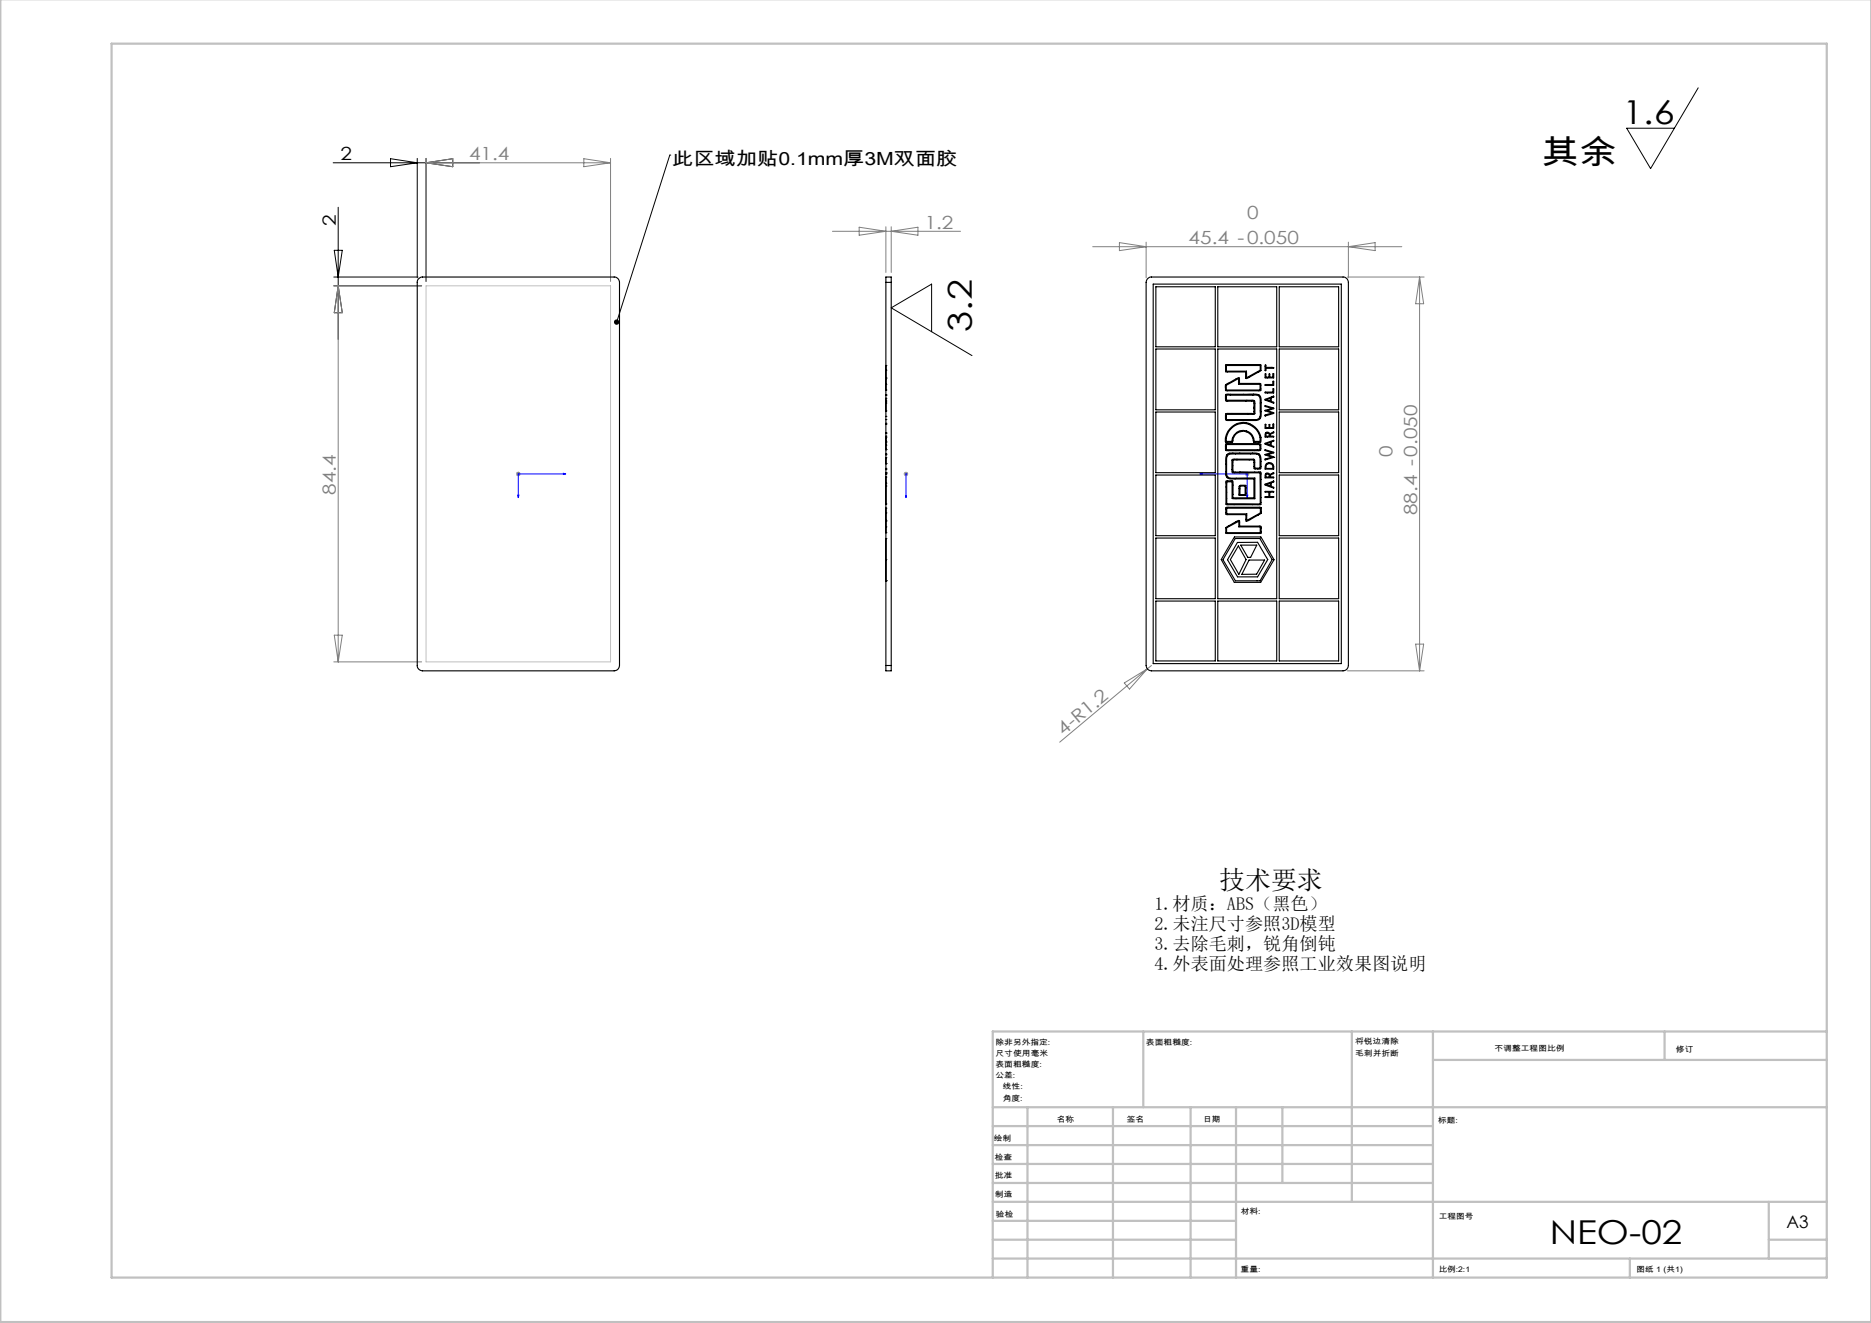
[picture p82: page 1]

1.材质：ABS（黑色）
2.未注尺寸参照3D模型
3.去除毛刺，锐角倒钝
4.外表面处理参照工业效果图说明

绘制
检查
批准
制造
验检 | | | | 材料: | 工程图号 NEO-02 重量: | A3
