NewEconoLab/NeoDun/产品/NEO发图12.26/NEO-04.PDF

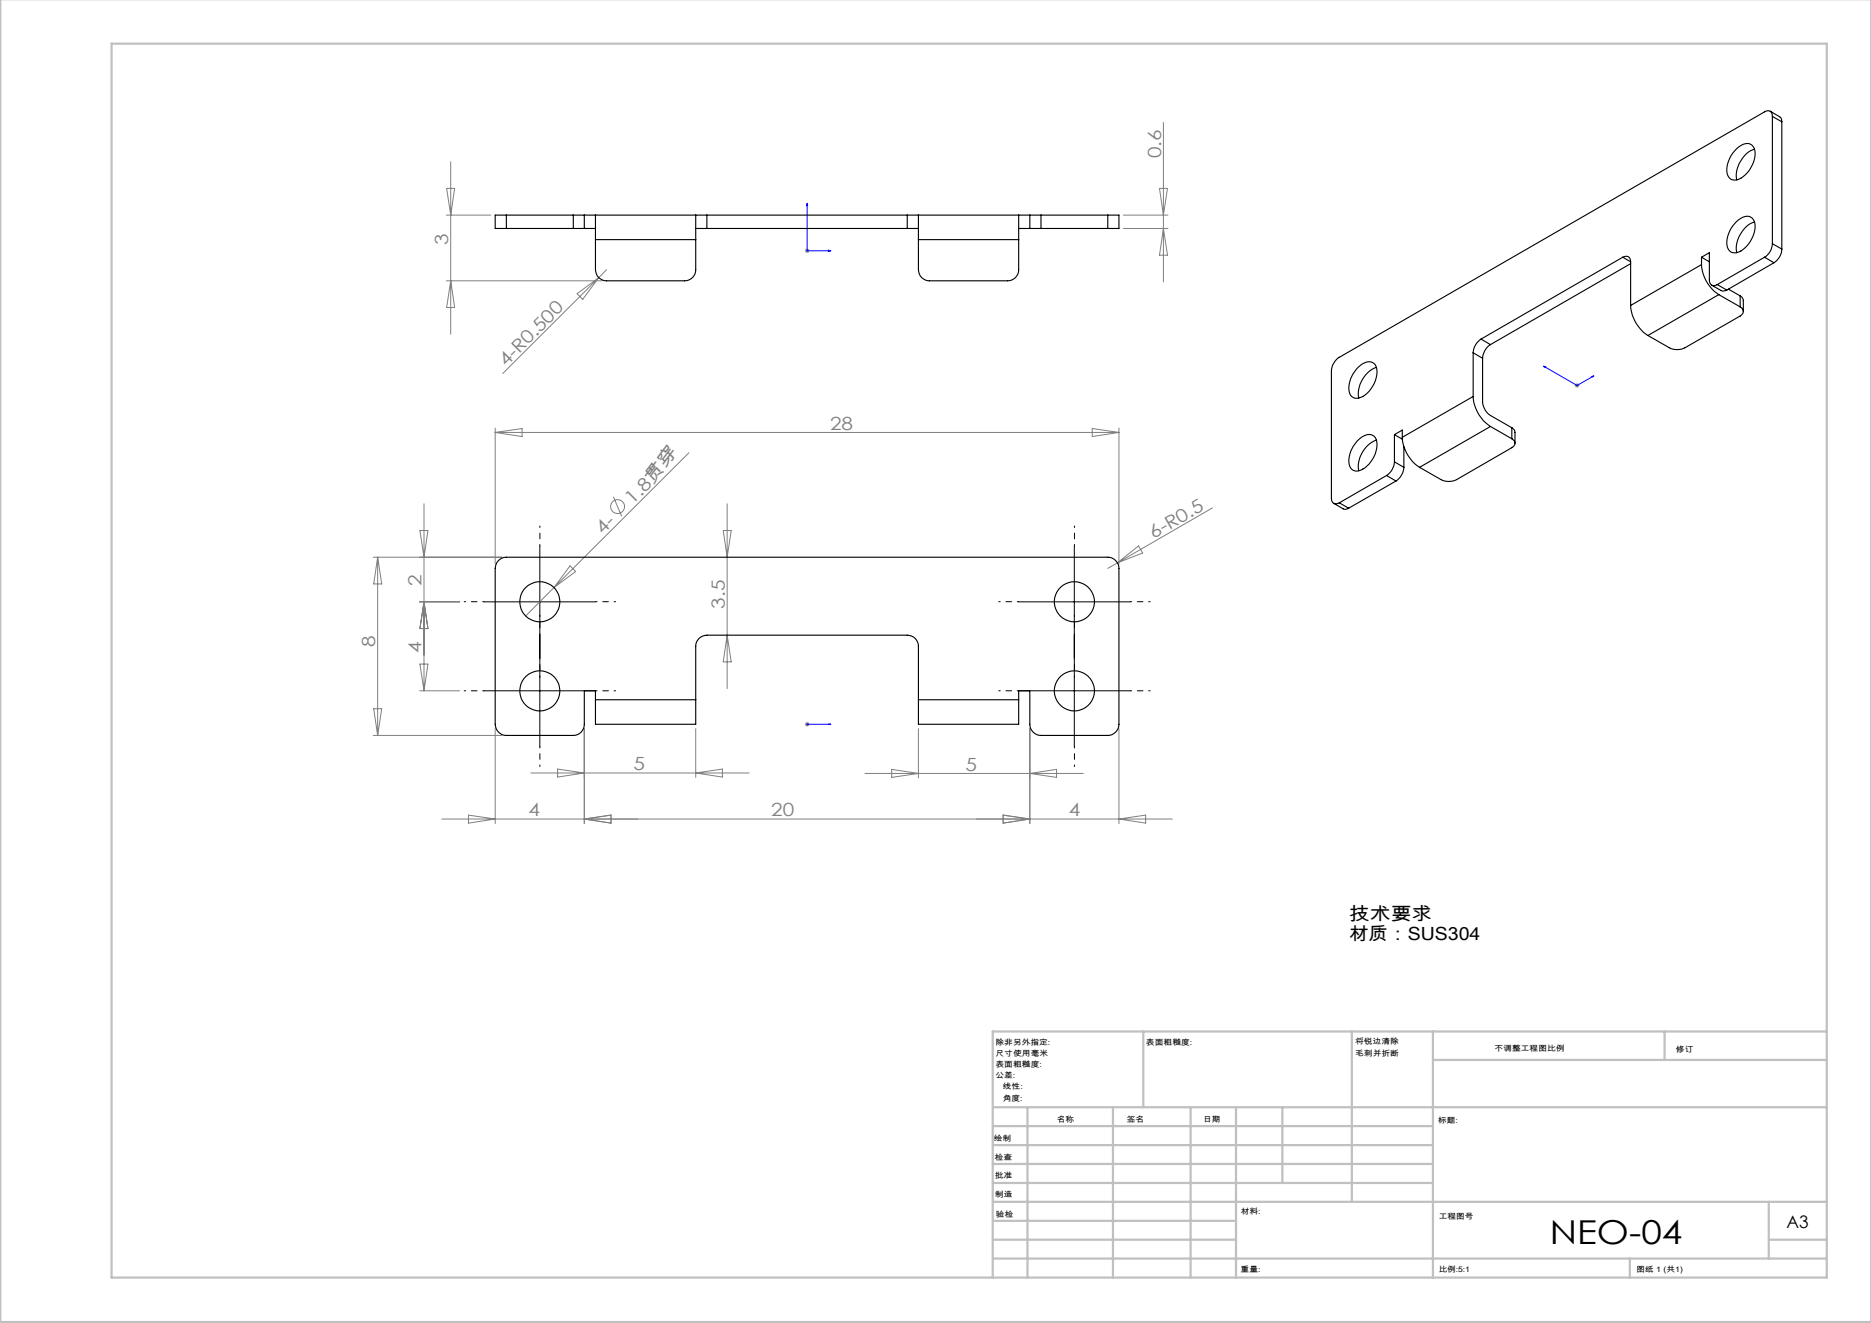
[picture p84: page 1]

绘制
检查
批准
制造
验检 | | | | 材料: | 工程图号 NEO-04 重量: | A3
