NewEconoLab/NeoDun/产品/NEO发图12.26/NEO-07  20180305更新.PDF

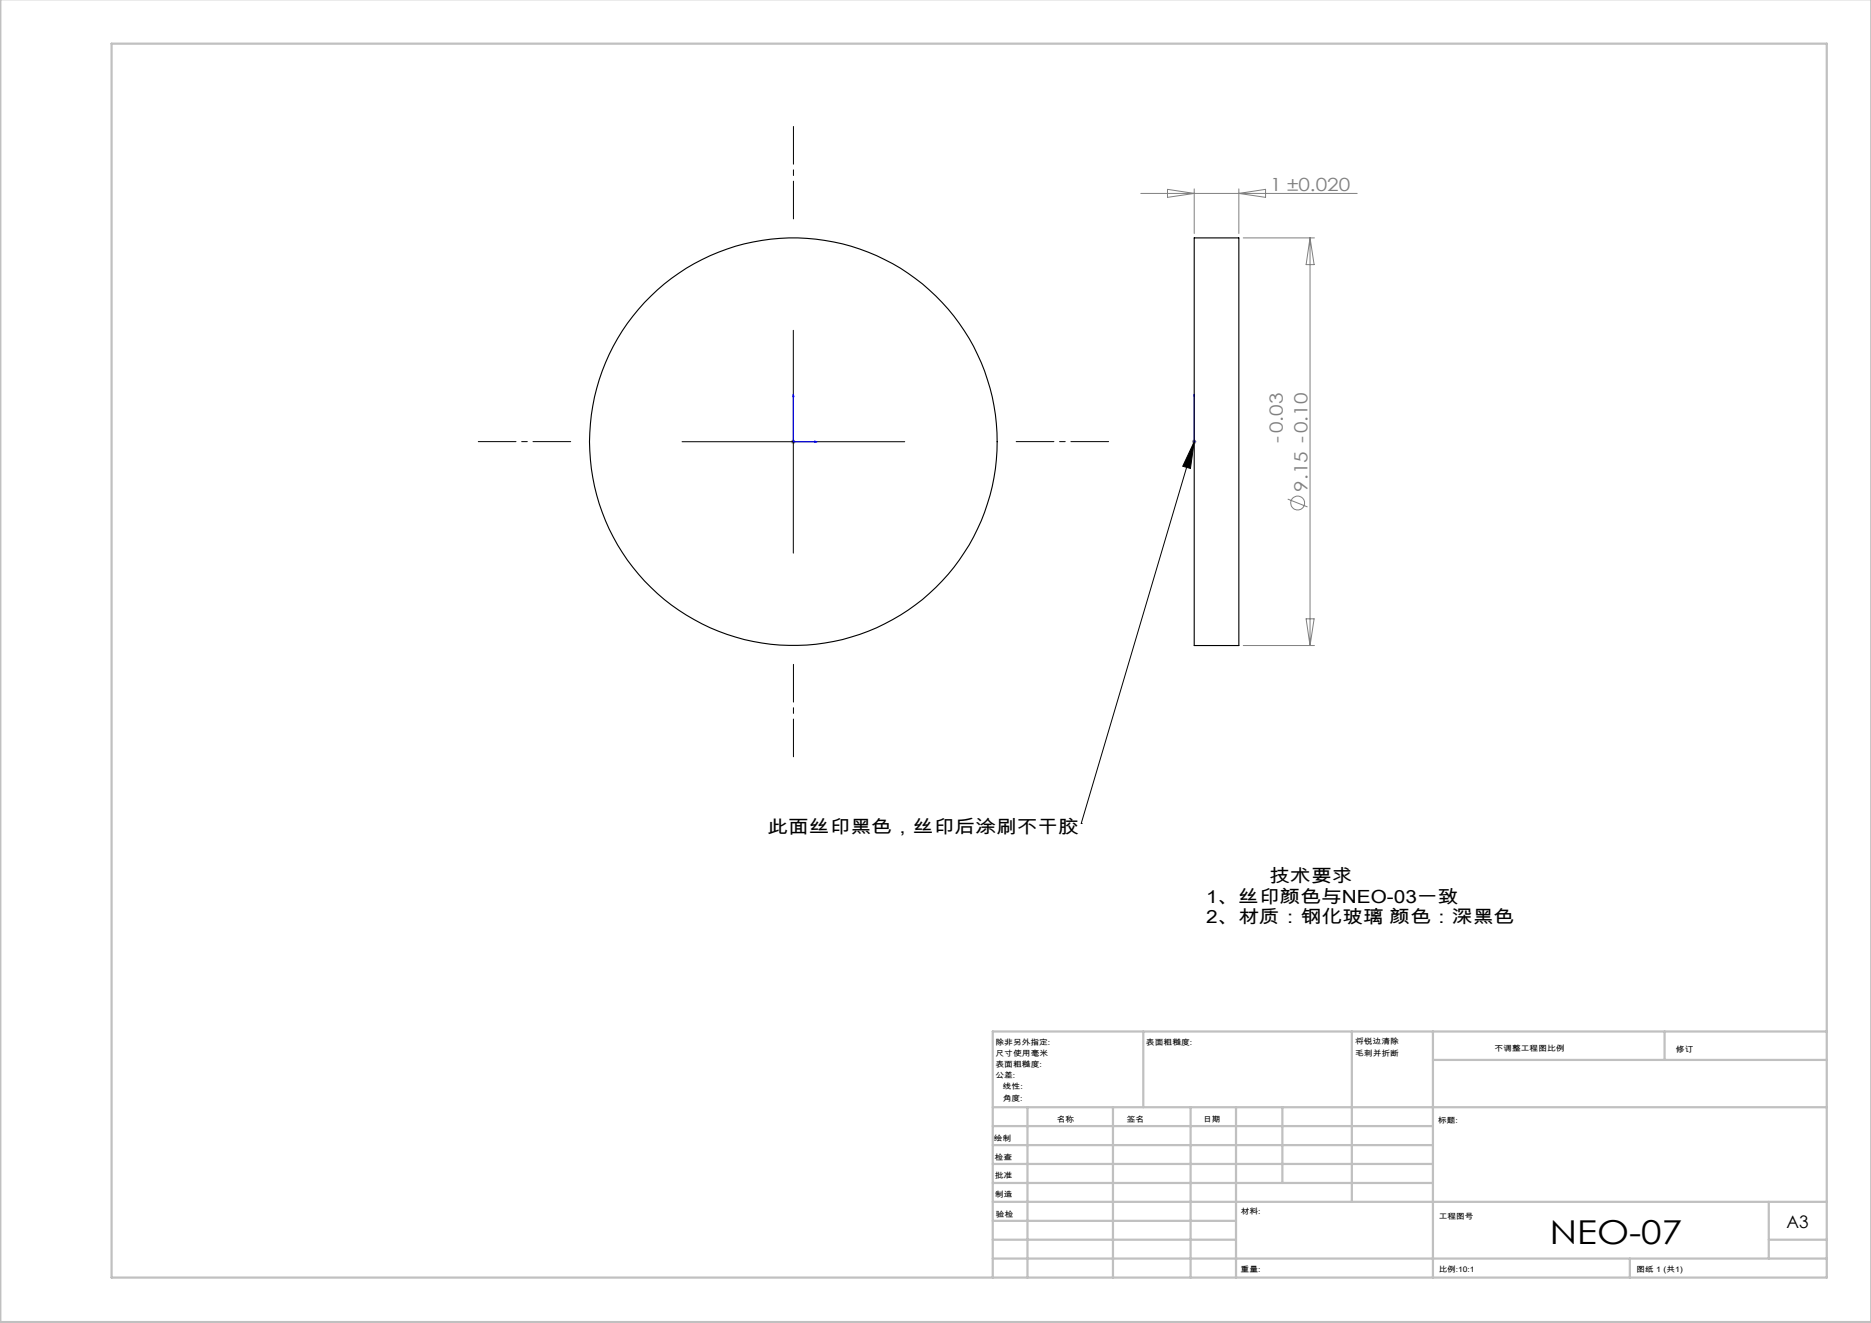
[picture p86: page 1]

技术要求
1、丝印颜色与NEO-03一致
2、材质：钢化玻璃 颜色：深黑色

绘制
检查
批准
制造
验检 | | | | 材料: | 工程图号 NEO-07 重量: | A3
