NewEconoLab/NeoDun/硬件设计/NEODUN结构/NEO-03.PDF

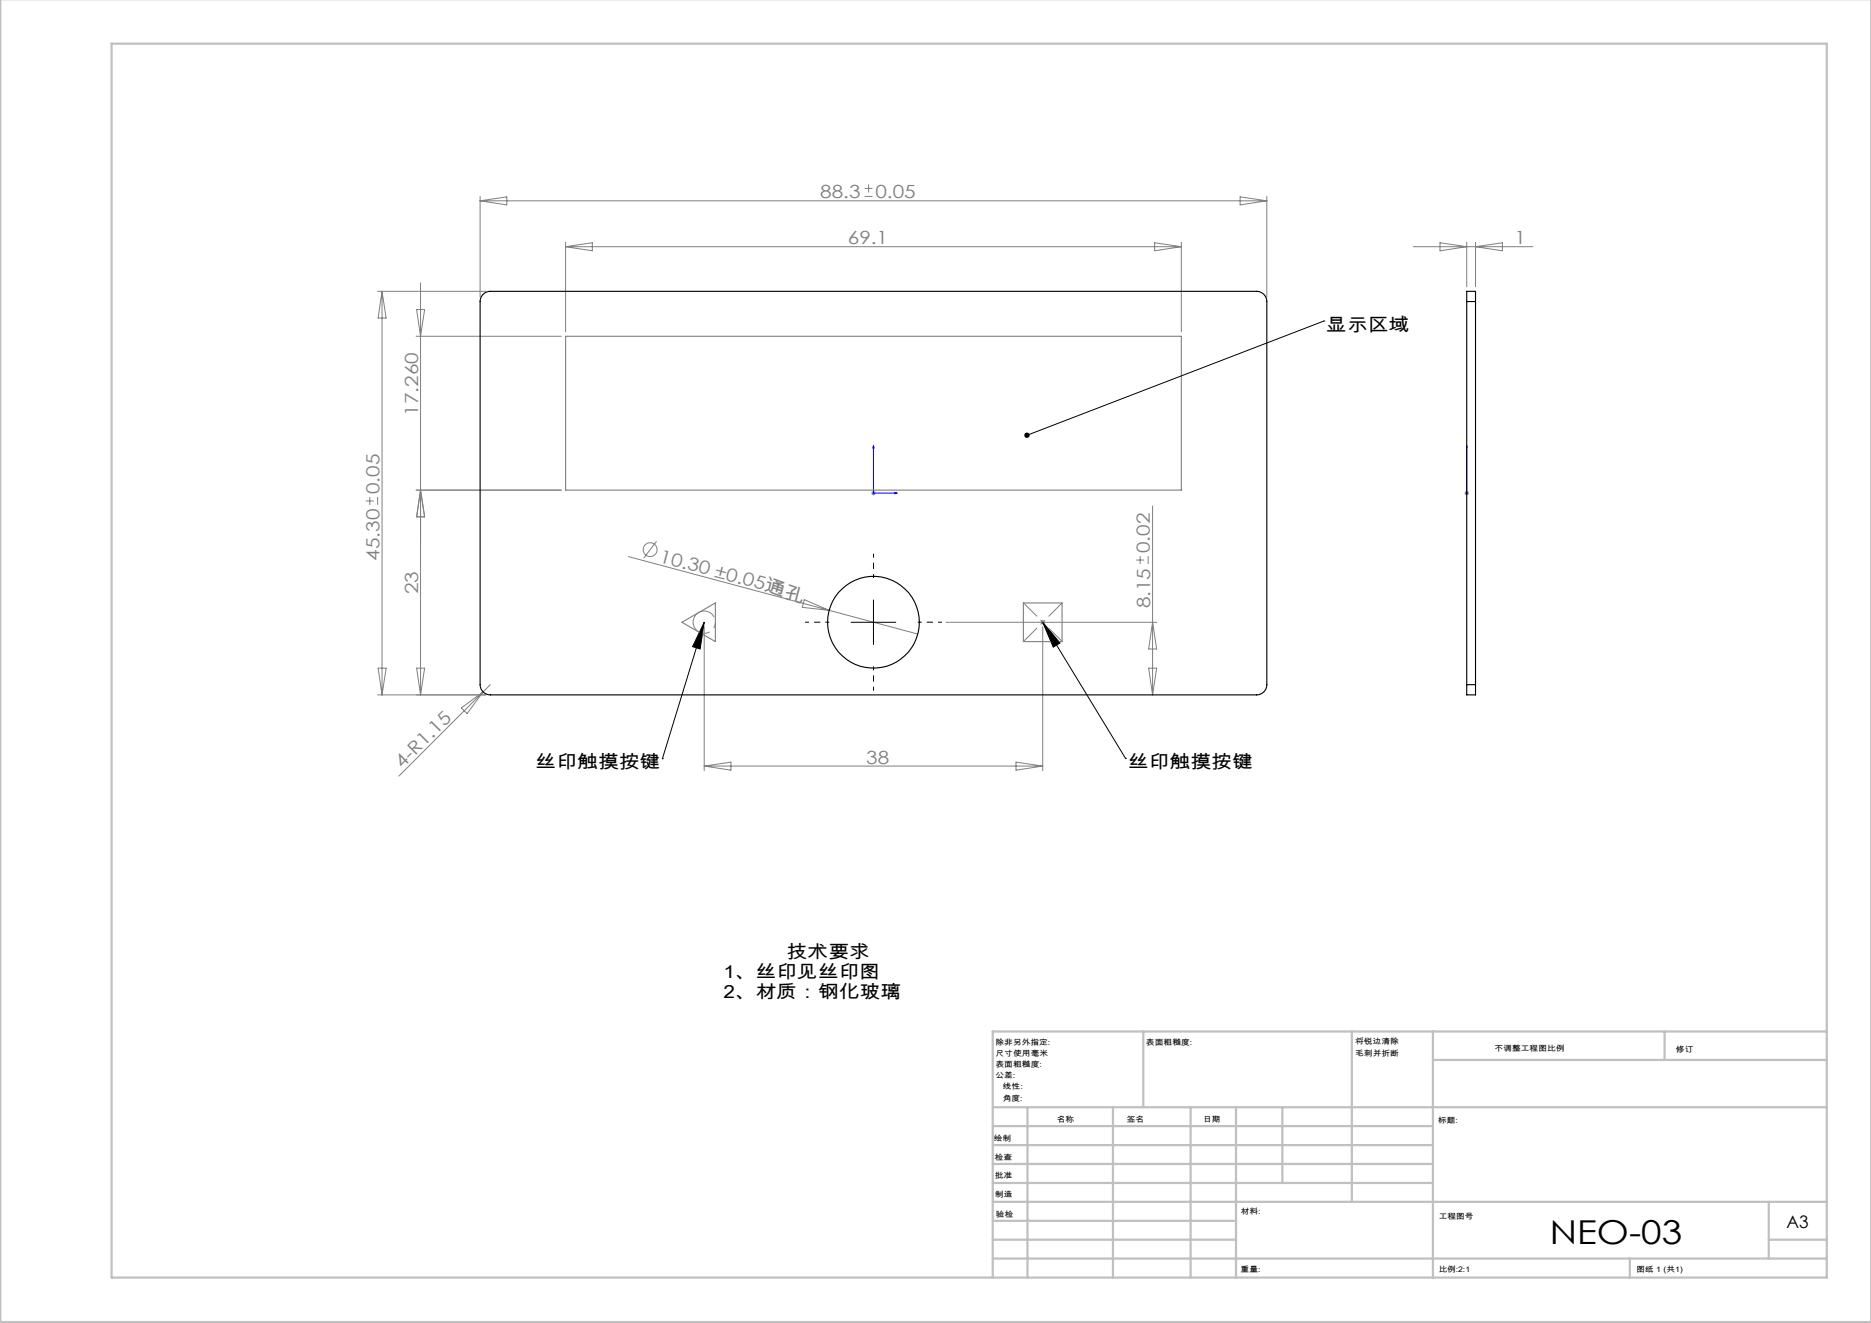
[picture p89: page 1]

绘制
检查
批准
制造
验检 | | | | 材料: | 工程图号 NEO-03 重量: | A3
