NewEconoLab/NeoDun/硬件设计/NEODUN结构/NEO-04.PDF

绘制
检查
批准
制造
验检 | | | | 材料: | 工程图号 NEO-04 重量: | A3
