NewEconoLab/NeoDun/(list of files, drawings)

Other design files:
硬件设计/NEO_MB_V1.0_0915.pcb
