NewEconoLab/NeoDun/单片机程序/NEODUN/APP/app_command.c

#include "app_command.h"
#include <string.h>
#include "CMD.h"
#include "app_utils.h"
#include "app_hal.h"
#include "app_interface.h"
#include "atsha204a.h"
#include "OledMenu.h"
#include "Algorithm.h"
#include "app_oled.h"
#include "OLED281/oled281.h"
#include "stmflash.h"
#include "encrypt.h"
#include "app_aes.h"
#include "aw9136.h"

#define PC_SEND_PER_PACK_SIZE		50*1024

extern uint8_t gImage_wait[128];
static uint8_t dataSave[HID_MAX_DATA_LEN];
static uint8_t packIndexRecord[(HID_MAX_DATA_LEN+DATA_PACK_SIZE-1)/DATA_PACK_SIZE ];
static uint8_t plugin_flag = 0;
static uint8_t public_key[64] =
{
		219, 99, 59,165,230,179,151,144,224,107, 35, 64,150,138,212,145,
		124, 11,103,174,170,120,154,194,184,167,110,  8,132,154,190,229,
		151, 60,140,173, 71, 95, 23,215,148,128, 60,202,162, 27,205,214,
		207,161, 33,103,143, 62,232, 68,114, 49, 10,111, 24,242,187,216
};

//// my public key
//static uint8_t public_key[64] =
//{
//		220,114,233,198,133,184, 81,202,202, 10, 23,234, 25,144, 45,196,
//		 80, 41,188,166, 57,158,131,237,241,  7,175, 52, 57,203,166, 48,
//		 77,129,140,102, 91, 55,100, 75, 22,199,102,163,254, 39,208,  8,
//		242,115,116, 26,250, 72,  8,254, 61,123,213,224,137,112,238, 69
//};

static uint8_t haveThisCoin(uint16_t coin)
{
		if((coin == coinrecord.coin1)||(coin == coinrecord.coin2)||
			 (coin == coinrecord.coin3)||(coin == coinrecord.coin4)||
			 (coin == coinrecord.coin5))
			return 1;
		else
			return 0;
}

static uint8_t isAllPackGot(void)
{
		for (int i = 0; i < HidData.packCount; i++) 
		{
				if (!packIndexRecord[i]) 
				{
						return 0;
				}
		}
		return 1;
}

static void HID_NOTIFY_DATA_REP(uint8_t state,uint16_t serialID)
{
		uint32_t crc = 0;
		HidData.reqSerial = RandomInteger();
		uint8_t data_rp[64];
		memset(data_rp,0,64);
		
		data_rp[0] = 0x01;
		if(state)
		{			
				data_rp[1] = 0x10;
				data_rp[2] = HidData.reqSerial & 0xff;
				data_rp[3] = (HidData.reqSerial >> 8) & 0xff;
				data_rp[4] = 0;
				data_rp[5] = 0;
				data_rp[6] = (HidData.packCount - 1)&0xff;
				data_rp[7] = ((HidData.packCount - 1)>>8) & 0xff;
				memmove(data_rp+8,HidData.hashRecord,32);
		}
		else
		{
				data_rp[1] = 0xe0;
				data_rp[2] = serialID & 0xff;
				data_rp[3] = (serialID >> 8) & 0xff;
		}
		crc = Utils_crc32(0,data_rp,62);
		data_rp[62] = crc & 0xff;
		data_rp[63] = (crc >> 8) & 0xff;
		SendUSBData(data_rp,64);		
}

static void HID_PULL_DATA_REP(uint16_t blockbegin,uint16_t blockend,uint16_t serialID)
{
		uint32_t	crc = 0;
		uint8_t 	data_rp[64];
		uint16_t 	i = 0;
		memset(data_rp,0,64);
		
		for(i=blockbegin;i<(blockend+1);i++)
		{
				data_rp[0] = 0x01;
				data_rp[1] = 0xa2;
				data_rp[2] = serialID & 0xff;
				data_rp[3] = (serialID >> 8) & 0xff;
				data_rp[4] = (uint8_t)(i&0xff); 
				data_rp[5] = (uint8_t)((i>>8)&0xff);
				memmove(data_rp+6,dataSave+i*DATA_PACK_SIZE,50);
				crc = Utils_crc32(0,data_rp,62);
				data_rp[62] = crc & 0xff;
				data_rp[63] = (crc >> 8) & 0xff;
				SendUSBData(data_rp,64);
				memset(data_rp,0,64);
#ifdef HID_Delay
				HAL_Delay(HID_SEND_DELAY);
#endif			
		}
		
		data_rp[0] = 0x01;
		data_rp[1] = 0xa3;
		data_rp[2] = serialID & 0xff;
		data_rp[3] = (serialID >> 8) & 0xff;
		crc = Utils_crc32(0,data_rp,62);
		data_rp[62] = crc & 0xff;
		data_rp[63] = (crc >> 8) & 0xff;
		SendUSBData(data_rp,64);
}

static void HID_PULL_DATA_REEQ_OVER_REP(uint8_t state,uint16_t packIndex,uint8_t *data)
{
		uint32_t crc = 0;
		uint8_t data_rp[64];
		memset(data_rp,0,64);
		
		data_rp[0] = 0x01;
		if(state)
				data_rp[1] = 0x11;
		else
				data_rp[1] = 0x12;
		data_rp[2] = HidData.notifySerial & 0xff;
		data_rp[3] = (HidData.notifySerial >> 8) & 0xff;
		
		data_rp[4] = (uint8_t)(packIndex & 0xff);
		data_rp[5] = (uint8_t)((packIndex >> 8) & 0xff);
		data_rp[6] = (uint8_t)(system_base_time&0xff);
		data_rp[7] = (uint8_t)((system_base_time>>8)&0xff);
		memmove(data_rp+8,data,32);
		
		crc = Utils_crc32(0,data_rp,62);
		data_rp[62] = crc & 0xff;
		data_rp[63] = (crc >> 8) & 0xff;
		SendUSBData(data_rp,64);			
}

static void HID_PULL_LOST_DATA(uint16_t blockbegin,uint16_t blockend,uint16_t serialID)
{
		uint32_t	crc = 0;
		uint8_t 	data_rp[64];
		memset(data_rp,0,64);
		
		data_rp[0] = 0x01;
		data_rp[1] = 0x10;
		data_rp[2] = serialID & 0xff;
		data_rp[3] = (serialID >> 8) & 0xff;
		data_rp[4] = (uint8_t)(blockbegin&0xff); 
		data_rp[5] = (uint8_t)((blockbegin>>8)&0xff);
		data_rp[6] = (uint8_t)(blockend&0xff); 
		data_rp[7] = (uint8_t)((blockend>>8)&0xff);
		memmove(data_rp+8,HidData.hashRecord,32);
		crc = Utils_crc32(0,data_rp,62);
		data_rp[62] = crc & 0xff;
		data_rp[63] = (crc >> 8) & 0xff;
		SendUSBData(data_rp,64);
}

static void HID_QUERY_ADDRESS_ALL_REP(uint16_t serialID)
{
		uint32_t crc = 0;
		uint8_t data_rp[64];
				
		for(uint8_t i = 0;i < 5;i++)
		{
				if(showaddress[i].content[0] == 0)
						continue;
				if(showaddress[i].hide)
						continue;
				memset(data_rp,0,64);
				data_rp[0] = 0x02;
				data_rp[1] = 0xa0;
				data_rp[2] = serialID & 0xff;
				data_rp[3] = (serialID >> 8) & 0xff;
				data_rp[4] = i;
				data_rp[5] = 0;
				data_rp[6] = 0;
				data_rp[7] = Neo_System.count;
				data_rp[8] = (uint8_t)(ADDR_XiaoYi & 0xff);
				data_rp[9] = (uint8_t)((ADDR_XiaoYi >> 8) & 0xff);
				memmove(data_rp+10,showaddress[i].content,25);
				memmove(data_rp+36,showaddress[i].name,showaddress[i].len_name);
				
				crc = Utils_crc32(0,data_rp,62);
				data_rp[62] = crc & 0xff;
				data_rp[63] = (crc >> 8) & 0xff;
				SendUSBData(data_rp,64);
#ifdef HID_Delay
				HAL_Delay(HID_SEND_DELAY);
#endif				
		}
}

static void HID_QUERY_ADDRESS_REP(uint16_t serialID)
{
		uint32_t crc = 0;
		uint8_t data_rp[64];
		memset(data_rp,0,64);
		
		data_rp[0] = 0x02;
		data_rp[1] = 0xa1;
		data_rp[2] = serialID & 0xff;
		data_rp[3] = (serialID >> 8) & 0xff;
		data_rp[4] = Neo_System.count;
	
		crc = Utils_crc32(0,data_rp,62);
		data_rp[62] = crc & 0xff;
		data_rp[63] = (crc >> 8) & 0xff;
		SendUSBData(data_rp,64);
}

static void HID_SET_ADDRESS_NAME_REP(uint8_t state,uint16_t serialID,uint16_t errCode)
{
		uint32_t crc = 0;
		uint8_t data_rp[64];
		memset(data_rp,0,64);
		
		data_rp[0] = 0x02;
		if(state)
				data_rp[1] = 0xa2;
		else
				data_rp[1] = 0xe2;
		data_rp[2] = serialID & 0xff;
		data_rp[3] = (serialID >> 8) & 0xff;
		data_rp[4] = errCode & 0xff;
		data_rp[5] = (errCode >> 8) & 0xff;	
		
		crc = Utils_crc32(0,data_rp,62);
		data_rp[62] = crc & 0xff;
		data_rp[63] = (crc >> 8) & 0xff;
		SendUSBData(data_rp,64);
}

static void HID_DEL_ADDRESS_REP(uint16_t state,uint16_t serialID,uint16_t addressType)
{
		uint32_t crc = 0;
		uint8_t data_rp[64];
		memset(data_rp,0,64);
		
		data_rp[0] = 0x02;
		if(state == 0)
				data_rp[1] = 0xa3;
		else
		{
				data_rp[1] = 0xe3;				
				data_rp[4] = state & 0xff;	
				data_rp[5] = (state >> 8)& 0xff;
		}
		data_rp[2] = serialID & 0xff;
		data_rp[3] = (serialID >> 8) & 0xff;
		
		crc = Utils_crc32(0,data_rp,62);
		data_rp[62] = crc & 0xff;
		data_rp[63] = (crc >> 8) & 0xff;
		SendUSBData(data_rp,64);			
}

static void HID_ADD_ADDRESS_REP(uint16_t state,uint16_t serialID,uint16_t addressType,uint8_t *data)
{
		uint32_t crc = 0;
		uint8_t data_rp[64];
		memset(data_rp,0,64);
		
		data_rp[0] = 0x02;
		if(state == 1)
		{
				data_rp[1] = 0xa4;
		}
		else
		{
				data_rp[1] = 0xe4;
				data_rp[4] = state & 0xff;
				data_rp[5] = (state >> 8)& 0xff;
		}
		data_rp[2] = serialID & 0xff;
		data_rp[3] = (serialID >> 8) & 0xff;
		
		crc = Utils_crc32(0,data_rp,62);
		data_rp[62] = crc & 0xff;
		data_rp[63] = (crc >> 8) & 0xff;
		SendUSBData(data_rp,64);		
}

static void HID_SIGN_DATA_FAILED_REP(uint16_t state,uint16_t serialID)
{
		//失败,擦除数据暂存扇区
		STMFLASH_Erase_Sectors(FLASH_DATA_SECTOR);
		uint32_t crc = 0;
		uint8_t data_rp[64];
		memset(data_rp,0,64);

		data_rp[0] = 0x02;
		data_rp[1] = 0xe5;
		data_rp[2] = serialID & 0xff;
		data_rp[3] = (serialID >> 8) & 0xff;
		data_rp[4] = state & 0xff;
		data_rp[5] = (state >> 8) & 0xff;	

		crc = Utils_crc32(0,data_rp,62);
		data_rp[62] = crc & 0xff;
		data_rp[63] = (crc >> 8) & 0xff;
		SendUSBData(data_rp,64);
}

static void HID_SIGN_DATA_REP(uint16_t cmd,uint16_t serialID,uint32_t len_data,uint8_t *hash,uint8_t len_hash)
{
		uint32_t crc = 0;
		uint8_t data_rp[64];
		memset(data_rp,0,64);
		
		data_rp[0] = (cmd >> 8) & 0xff;;
		data_rp[1] = cmd & 0xff;;
		data_rp[2] = serialID & 0xff;
		data_rp[3] = (serialID >> 8) & 0xff;
		data_rp[4] = len_data & 0xff;
		data_rp[5] = (len_data >> 8) & 0xff;
		data_rp[7] = (len_data >> 16) & 0xff;	
		data_rp[7] = (len_data >> 24) & 0xff;
		memmove(data_rp+8,hash,len_hash);

		crc = Utils_crc32(0,data_rp,62);
		data_rp[62] = crc & 0xff;
		data_rp[63] = (crc >> 8) & 0xff;
		SendUSBData(data_rp,64);
}

static void HID_CRC_ERROR_REP(uint16_t serialID)
{
		uint32_t crc = 0;
		uint8_t data_rp[64];
		memset(data_rp,0,64);
		
		data_rp[0] = 0x00;
		data_rp[1] = 0x10;
		data_rp[2] = serialID & 0xff;
		data_rp[3] = (serialID >> 8) & 0xff;
		
		crc = Utils_crc32(0,data_rp,62);
		data_rp[62] = crc & 0xff;
		data_rp[63] = (crc >> 8) & 0xff;
		SendUSBData(data_rp,64);
}

static void HID_INSTALL_PACK_REP(uint16_t state,uint16_t serialID,uint16_t install_type,uint16_t install_cont,uint16_t version)
{
		uint32_t crc = 0;
		uint8_t data_rp[64];
		memset(data_rp,0,64);
		
		data_rp[0] = 0x03;
		if(state == 0)
		{			
				data_rp[1] = 0xa1;
		}
		else
		{
				data_rp[1] = 0xe1;
				data_rp[4] = state & 0xff;
				data_rp[5] = (state >> 8) & 0xff;
		}

		data_rp[2] = serialID & 0xff;
		data_rp[3] = (serialID >> 8) & 0xff;
		
		crc = Utils_crc32(0,data_rp,62);
		data_rp[62] = crc & 0xff;
		data_rp[63] = (crc >> 8) & 0xff;
		SendUSBData(data_rp,64);
}	

static void HID_INSTALL_REQUEST_REP(uint8_t state,uint16_t serialID)
{
		uint32_t crc = 0;
		uint8_t data_rp[64];
		memset(data_rp,0,64);
		
		data_rp[0] = 0x03;
		if(state)	
				data_rp[1] = 0xa2;
		else
				data_rp[1] = 0xe2;

		data_rp[2] = serialID & 0xff;
		data_rp[3] = (serialID >> 8) & 0xff;

		crc = Utils_crc32(0,data_rp,62);
		data_rp[62] = crc & 0xff;
		data_rp[63] = (crc >> 8) & 0xff;
		SendUSBData(data_rp,64);
}

static void HID_QUERY_PACK_INFO_REP(uint16_t serialID)
{
		uint32_t crc = 0;
		uint8_t data_rp[64];
		memset(data_rp,0,64);
		
		data_rp[0] = 0x03;	
		data_rp[1] = 0xa4;
		data_rp[2] = serialID & 0xff;
		data_rp[3] = (serialID >> 8) & 0xff;
		data_rp[4] = VERSION_NEODUN & 0xff;
		data_rp[5] = (VERSION_NEODUN >> 8) & 0xff;	
		
		if(coinrecord.coin1 == 0xFFFF)
		{
				data_rp[6] = 0;
				data_rp[7] = 0;
		}
		else
		{
				data_rp[6] = coinrecord.coin1&0xff;			
				data_rp[7] = (coinrecord.coin1 >> 8)&0xff;
		}
		if(coinrecord.version1 == 0xFFFF)
		{
				data_rp[8] = 0;
				data_rp[9] = 0;
		}
		else
		{		
				data_rp[8] = coinrecord.version1&0xff;			
				data_rp[9] = (coinrecord.version1>>8)&0xff;
		}
		if(coinrecord.coin2 == 0xFFFF)
		{
				data_rp[10] = 0;
				data_rp[11] = 0;
		}
		else
		{
				data_rp[10] = coinrecord.coin2&0xff;
				data_rp[11] = (coinrecord.coin2 >> 8)&0xff;
		}
		if(coinrecord.version2 == 0xFFFF)
		{		
				data_rp[12] = 0;
				data_rp[13] = 0;
		}
		else
		{		
				data_rp[12] = coinrecord.version2&0xff;
				data_rp[13] = (coinrecord.version2>>8)&0xff;				
		}
		if(coinrecord.coin3 == 0xFFFF)
		{		
				data_rp[14] = 0;
				data_rp[15] = 0;
		}
		else
		{		
				data_rp[14] = coinrecord.coin3&0xff;
				data_rp[15] = (coinrecord.coin3 >> 8)&0xff;					
		}
		if(coinrecord.version3 == 0xFFFF)
		{		
				data_rp[16] = 0;
				data_rp[17] = 0;
		}
		else
		{		
				data_rp[16] = coinrecord.version3&0xff;
				data_rp[17] = (coinrecord.version3>>8)&0xff;					
		}
		if(coinrecord.coin4 == 0xFFFF)
		{		
				data_rp[18] = 0;
				data_rp[19] = 0;
		}
		else
		{		
				data_rp[18] = coinrecord.coin4&0xff;
				data_rp[19] = (coinrecord.coin4 >> 8)&0xff;
		}
		if(coinrecord.version4 == 0xFFFF)
		{		
				data_rp[20] = 0;
				data_rp[21] = 0;
		}
		else
		{		
				data_rp[20] = coinrecord.version4&0xff;
				data_rp[21] = (coinrecord.version4>>8)&0xff;
		}
		if(coinrecord.coin5 == 0xFFFF)
		{		
				data_rp[22] = 0;
				data_rp[23] = 0;
		}
		else
		{		
				data_rp[22] = coinrecord.coin5&0xff;
				data_rp[23] = (coinrecord.coin5 >> 8)&0xff;
		}
		if(coinrecord.version5 == 0xFFFF)
		{		
				data_rp[24] = 0;
				data_rp[25] = 0;
		}
		else
		{		
				data_rp[24] = coinrecord.version5&0xff;
				data_rp[25] = (coinrecord.version5>>8)&0xff;
				
		}
		crc = Utils_crc32(0,data_rp,62);
		data_rp[62] = crc & 0xff;
		data_rp[63] = (crc >> 8) & 0xff;
		SendUSBData(data_rp,64);
}

static void HID_UNINSTALL_PACK_REP(uint16_t state,uint16_t serialID,uint16_t install_type)
{
		uint32_t crc = 0;
		uint8_t data_rp[64];
		memset(data_rp,0,64);
		
		data_rp[0] = 0x03;
		if(state == 0)
				data_rp[1] = 0xa3;
		else
		{
				data_rp[1] = 0xe3;
				data_rp[4] = state & 0xff;
				data_rp[5] = (state >> 8) & 0xff;	
		}
		data_rp[2] = serialID & 0xff;
		data_rp[3] = (serialID >> 8) & 0xff;
	
		crc = Utils_crc32(0,data_rp,62);
		data_rp[62] = crc & 0xff;
		data_rp[63] = (crc >> 8) & 0xff;
		SendUSBData(data_rp,64);			
}

static void HID_SECU_GET_PUBKEY_REP(uint16_t serialID,uint8_t hash[32])
{
		uint32_t crc = 0;
		uint8_t data_rp[64];
	
		memset(data_rp,0,64);
		data_rp[0] = 0x04;
		data_rp[1] = 0xa2;
		data_rp[2] = serialID & 0xff;
		data_rp[3] = (serialID >> 8) & 0xff;
		memmove(data_rp+4,HidData.hashRecord,32);
		crc = Utils_crc32(0,data_rp,62);
		data_rp[62] = crc & 0xff;
		data_rp[63] = (crc >> 8) & 0xff;
		SendUSBData(data_rp,64);
}

/****************************************************
函数说明:处理插件回跳时，签名数据的处理
分两种情况：
			1、解析完数据，请求用户的回跳
			2、数字签名，数据上传的回跳
****************************************************/
static void Sign_Data_User_Request_proc(void)
{
		uint8_t return_value = 0;
		uint16_t serialId = 0;
		uint8_t AddressID = 0;
		uint8_t	sign_cmd_data[32];
		uint8_t	SIGN_Out_Para_data[136];
		SIGN_Out_Para Sign;
		memset(&Sign,0,sizeof(Sign));

		//回收系统需要的信息
		serialId = (uint16_t)STMFLASH_ReadWord(FLASH_ADDRESS_SCENE);
		AddressID = (uint8_t)STMFLASH_ReadWord(FLASH_ADDRESS_SCENE+4);
		STMFLASH_Read_ByteArray(FLASH_ADDRESS_SCENE+8,sign_cmd_data,32);
		//组合数据
		STMFLASH_Read_ByteArray(FLASH_ADDRESS_SIGN_DATA,SIGN_Out_Para_data,136);	
		{
				Sign.type							= SIGN_Out_Para_data[0];
				Sign.version 					= SIGN_Out_Para_data[1];
				Sign.coin							= SIGN_Out_Para_data[2];
				Sign.countAttributes  = SIGN_Out_Para_data[3];
				Sign.countInputs			= SIGN_Out_Para_data[4];
				Sign.countOutputs			= SIGN_Out_Para_data[5];
				memmove(Sign.address[0],SIGN_Out_Para_data+6,25);
				memmove(Sign.address[1],SIGN_Out_Para_data+31,25);
				memmove(Sign.assetid[0],SIGN_Out_Para_data+56,32);
				memmove(Sign.assetid[1],SIGN_Out_Para_data+88,32);
				Sign.money[0] = (uint64_t)SIGN_Out_Para_data[120]|((uint64_t)SIGN_Out_Para_data[121]<<8)
												|((uint64_t)SIGN_Out_Para_data[122]<<16)|((uint64_t)SIGN_Out_Para_data[123]<<24)
												|((uint64_t)SIGN_Out_Para_data[124]<<32)|((uint64_t)SIGN_Out_Para_data[125]<<40)
												|((uint64_t)SIGN_Out_Para_data[126]<<48)|((uint64_t)SIGN_Out_Para_data[127]<<56);
				Sign.money[1] = (uint64_t)SIGN_Out_Para_data[128]|((uint64_t)SIGN_Out_Para_data[129]<<8)
												|((uint64_t)SIGN_Out_Para_data[130]<<16)|((uint64_t)SIGN_Out_Para_data[131]<<24)
												|((uint64_t)SIGN_Out_Para_data[132]<<32)|((uint64_t)SIGN_Out_Para_data[133]<<40)
												|((uint64_t)SIGN_Out_Para_data[134]<<48)|((uint64_t)SIGN_Out_Para_data[135]<<56);
		}

		if((Sign.type != ContractTransaction)&&(Sign.type != InvocationTransaction))//不是合约交易和nep5交易
		{
				return_value = Display_Sign_Data_Type_Identify();
				if(return_value == NEO_USER_REFUSE)//用户拒绝签名
				{
						HID_SIGN_DATA_FAILED_REP(ERR_USER_REFUSE,serialId);
						return ;
				}
				if(return_value == NEO_TIME_OUT)//操作超时
				{
						HID_SIGN_DATA_FAILED_REP(ERR_TIME_OUT,serialId);
						return;
				}
		}
		else if(Sign.type == ContractTransaction)//合约交易
		{
				uint8_t index_add;
				char Sign_dst_address[40] = "";
				int len_add = 0;

				if(Sign.countOutputs == 0)		 //输出端地址为0个
				{
						HID_SIGN_DATA_FAILED_REP(ERR_DATA_PACK,serialId);
						return;
				}
				else if(Sign.countOutputs == 1)//输出端地址为1个
				{
						index_add = 0;
				}
				else if(Sign.countOutputs == 2)//输出端地址为2个
				{
						if(ArrayCompare(sign_cmd_data,Sign.address[0],25))
								index_add = 1;
						else if(ArrayCompare(sign_cmd_data,Sign.address[1],25))
								index_add = 0;
						else											 //本机没有存有该地址
						{
								HID_SIGN_DATA_FAILED_REP(ERR_UNKNOW_KEY,serialId);
								return;
						}
				}
				else//多个签名的情况
				{
						HID_SIGN_DATA_FAILED_REP(ERR_MULTI_SIGN,serialId);
						return;
				}

				Alg_Base58Encode(Sign.address[index_add] , 25 ,Sign_dst_address,&len_add);
				return_value = Display_Sign_ContractTran(&Sign,&showaddress[AddressID-1],index_add,Sign_dst_address);
		}
		else if(Sign.type == InvocationTransaction)//nep5交易
		{
				char Sign_dst_address[40] = "";
				int len_add = 0;
				Alg_Base58Encode(Sign.address[1] , 25 ,Sign_dst_address,&len_add);
				return_value = Display_Sign_Nep5(&Sign,&showaddress[AddressID-1],Sign_dst_address);
		}
			
		if(return_value == NEO_SUCCESS)
		{
				//显示等待图标
				Fill_RAM(0x00);
				Show_Pattern(&gImage_wait[0],30,33,24,40);
				clearArea(120,40,16,1);
				jump_to_app(FLASH_ADDRESS_APP1);
		}
		else if(return_value == NEO_USER_REFUSE)
		{
				HID_SIGN_DATA_FAILED_REP(ERR_USER_REFUSE,serialId);
		}
		else if(return_value == NEO_TIME_OUT)
		{
				HID_SIGN_DATA_FAILED_REP(ERR_TIME_OUT,serialId);
		}
}

static void Sign_Date_Upload_Data_proc(void)
{
		uint8_t hash_sign[32];
		uint8_t resultsignRecord[98];	
		uint16_t serialId = (uint16_t)STMFLASH_ReadWord(FLASH_ADDRESS_SCENE);	
		STMFLASH_Read_ByteArray(FLASH_ADDRESS_SIGN_DATA+0x800,resultsignRecord,98);
		SHA256_Data(resultsignRecord,98,hash_sign,32);
		
		STMFLASH_Erase_Sectors(FLASH_DATA_SECTOR);
		memset(dataSave,0,sizeof(dataSave));
		memmove(dataSave,resultsignRecord,98);
		HidData.reqSerial = RandomInteger();
		HID_SIGN_DATA_REP(CMD_NOTIFY_DATA,HidData.reqSerial,98,hash_sign,32);
#ifdef HID_Delay
		HAL_Delay(HID_SEND_DELAY);
#endif
		HID_SIGN_DATA_REP(CMD_SIGN_OK,serialId,98,hash_sign,32);
		SysFlagType = 0xFF;

		Fill_RAM(0x00);
		Display_Triangle(0);
		#ifdef Chinese		
				Show_HZ12_12(96,16,101,101);//签
				Show_HZ12_12(112,16,57,57);//名
				Show_HZ12_12(128,16,27,27);//成
				Show_HZ12_12(144,16,115,115);//功
		#endif
		#ifdef English
				Show_AscII_Picture(64,16,TransactionBitmapDot,sizeof(TransactionBitmapDot));//80
				Show_AscII_Picture(148,16,signedBitmapDot,sizeof(signedBitmapDot));//48
		#endif	
		Key_Control(1);
}

static void Sign_Data_Error_proc(uint32_t flag)
{
		uint16_t serialId = (uint16_t)STMFLASH_ReadWord(FLASH_ADDRESS_SCENE);
		STMFLASH_Erase_Sectors(FLASH_DATA_SECTOR);
		switch (flag)
		{
			case 1:
					HID_SIGN_DATA_FAILED_REP(ERR_PLUGS_DATALEN,serialId);
			break;
			case 2:
					HID_SIGN_DATA_FAILED_REP(ERR_PLUGS_PACKERR,serialId);
			break;
			case 3:
					HID_SIGN_DATA_FAILED_REP(ERR_PLUGS_PRIKEY,serialId);
			break;
			case 4:
					HID_SIGN_DATA_FAILED_REP(ERR_PLUGS_SIGN,serialId);
			break;
			default:
					HID_SIGN_DATA_FAILED_REP(ERR_DATA_PACK,serialId);
			break;
		}
}

void Deal_Sign_Data_Restart(void)
{
		uint32_t errflag  = STMFLASH_ReadWord(FLASH_ADDRESS_FLAG_JUMP);
		uint32_t dataflag = STMFLASH_ReadWord(FLASH_ADDRESS_FLAG_JUMP+4);
		uint32_t signflag = STMFLASH_ReadWord(FLASH_ADDRESS_FLAG_JUMP+8);
		STMFLASH_Read_ByteArray(FLASH_ADDRESS_PACK+4,Neo_System.pin,8);
		if(dataflag == 0x80000000)
		{
				if(signflag == 0x80000000)//数据签名OK
				{
						Sign_Date_Upload_Data_proc();
				}
				else//数据解析OK
				{
						Sign_Data_User_Request_proc();
				}
		}
		else//出错处理
		{
				Sign_Data_Error_proc(errflag);
		}
}
/******************************************************************************************************/
void Hid_Data_Analysis(uint8_t data[],int len)
{
		uint16_t cmd 			= (data[0] << 8) | data[1];
		uint16_t serialId = data[2] | (data[3] << 8);
		if(Utils_verifycrc(data,len))
		{
				if(Passport_Flag.flag.poweron)
				{
						switch(cmd)
						{
								case CMD_NOTIFY_DATA:					//0x0101
								{
										if(plugin_flag == 0)
												memset(dataSave,0,sizeof(dataSave));
										memset(packIndexRecord,0,sizeof(packIndexRecord));
										HidData.dataLen = data[4] | (data[5]<<8) | (data[6]<<16) | (data[7]<<24);
										HidData.notifySerial = serialId;
										if(plugin_flag == 2)
												plugin_flag = 0;
										if(plugin_flag == 1)
												plugin_flag = 2;
										if(HidData.dataLen == PC_SEND_PER_PACK_SIZE)
										{
												plugin_flag = 1;
										}
										if(HidData.dataLen < HID_MAX_DATA_LEN)
										{
												HidData.packCount = (HidData.dataLen + DATA_PACK_SIZE - 1) / DATA_PACK_SIZE;
												HidData.packIndex = 0;
												memmove(HidData.hashRecord, data+8, 32);
												HID_NOTIFY_DATA_REP(1,serialId);
										}
										else
										{
												HID_NOTIFY_DATA_REP(0,serialId);
										}
										break;
								}
								case CMD_PULL_DATA:						//0x0110
								{
										uint16_t blockbegin = data[4] | (data[5]<<8);
										uint16_t blockend   = data[6] | (data[7]<<8);
										HID_PULL_DATA_REP(blockbegin,blockend,serialId);
										break;
								}
								case CMD_PULL_DATA_REQ:				//0x01a2
								{
										if(serialId == HidData.reqSerial)
										{
												if(plugin_flag)
														memmove(dataSave + HidData.packIndex * DATA_PACK_SIZE+(plugin_flag-1)*PC_SEND_PER_PACK_SIZE, data + 6,DATA_PACK_SIZE);
												else
														memmove(dataSave + HidData.packIndex * DATA_PACK_SIZE, data + 6,DATA_PACK_SIZE);
												packIndexRecord[HidData.packIndex] = 1;
												HidData.packIndex++;
										}
										break;
								}
								case CMD_PULL_DATA_REQ_OVER:	//0x01a3
								{
										if(isAllPackGot())
										{
												uint8_t res[32];
												if(plugin_flag==2)
														SHA256_Data(dataSave+PC_SEND_PER_PACK_SIZE, HidData.dataLen , res, 32);			
												else
														SHA256_Data(dataSave, HidData.dataLen , res, 32);
												if(ArrayCompare(res,HidData.hashRecord,32))
												{
														HID_PULL_DATA_REEQ_OVER_REP(1,HidData.packIndex,res);
												}
												else
												{
														HID_PULL_DATA_REEQ_OVER_REP(0,HidData.packIndex,res);
												}
										}
										else
										{
												for (int i = 0; i < HidData.packCount; i++) 
												{
														if (packIndexRecord[i] == 0)//把这一包拉下来
														{
																HID_PULL_LOST_DATA(i,i,HidData.reqSerial);
														}
												}
										}
										break;
								}
								case CMD_QUERY_ADDRESS:				//0x0201
								{
										HID_QUERY_ADDRESS_ALL_REP(serialId);
										HID_QUERY_ADDRESS_REP(serialId);
										break;
								}
								case CMD_SET_ADDRESS_NAME:		//0x0202
								{
										uint8_t i = 0;
										uint8_t slot_data[32];
										uint8_t	temp_name[6];
										uint8_t  AddressID = Get_Address_ID(data+4);
										uint16_t len_name  = data[30] | (data[31] << 8);
										memset(temp_name,0,6);
										if((AddressID == 0)||(len_name > 6)||(len_name == 0))
										{
												HID_SET_ADDRESS_NAME_REP(0,serialId,0x0206);
												break;
										}
										//地址重名判断
										for(i = 0; i<5; i++)
										{
												if(showaddress[i].len_name == 0)
														continue;
												if(showaddress[i].len_name != len_name)
														continue;
												if(ArrayCompare(data+32,(uint8_t*)showaddress[i].name,showaddress[i].len_name))
												{
														HID_SET_ADDRESS_NAME_REP(0,serialId,0x0203);
														return;
												}
										}
										//更新内存中的地址属性
										memmove(temp_name,data+32,len_name);
										memmove(showaddress[AddressID-1].name,temp_name,6);
										showaddress[AddressID-1].len_name = len_name;
										//更新到加密芯片中
										ATSHA_read_data_slot(AddressID+7,slot_data);
										memmove(slot_data+25,temp_name,6);
										slot_data[31] |= (len_name<<4);
										ATSHA_write_data_slot(AddressID+7,0,slot_data,32);
										HID_SET_ADDRESS_NAME_REP(1,serialId,0);
										break;
								}
								case CMD_DEL_ADDRESS:					//0x0203
								{
										uint16_t addressType = data[4] | (data[5] << 8);
										if(addressType == ADDR_XiaoYi)
										{
												uint8_t addressID = Get_Address_ID(data+6);
												uint8_t data_write[32];
												memset(data_write,0,32);
#ifdef printf_debug
												printf("addressID: %d\r\n",addressID);
#endif
												if(addressID)
												{
														uint8_t return_value = Display_DelAdd(addressID-1);
														if(return_value == NEO_USER_REFUSE)
														{
																HID_DEL_ADDRESS_REP(ERR_USER_REFUSE,serialId,addressType);
																Display_Usb();
																break;
														}
														else if(return_value == NEO_TIME_OUT)
														{
																HID_DEL_ADDRESS_REP(ERR_TIME_OUT,serialId,addressType);
																Display_Usb();
																break;
														}
														
														if(Display_VerifyCode() == 0)
														{
																Passport_Flag.flag.del_address = 1;
														}
														if(Passport_Flag.flag.del_address)
														{
																Passport_Flag.flag.del_address = 0;
																//将该地址ID对应的私钥和地址槽，都写入0
																ATSHA_write_data_slot(addressID+2,0,data_write,32);
																ATSHA_write_data_slot(addressID+7,0,data_write,32);
																Neo_System.count--;
																Updata_SYS_Count(Neo_System.count);				//更新计数的值
																memset(&showaddress[addressID-1],0,sizeof(ADDRESS));									
																HID_DEL_ADDRESS_REP(0,serialId,addressType);
															
																{
																		Fill_RAM(0x00);
																#ifdef Chinese		
																		Show_HZ12_12(80,16,61,61);//私
																		Show_HZ12_12(96,16,22,22);//钥
																		Show_HZ12_12(112,16,55,56);//删除
																		Show_HZ12_12(144,16,27,27);//成
																		Show_HZ12_12(160,16,115,115);//功
																#endif
																#ifdef English
																		Show_AscII_Picture(18,16,WalletBitmapDot,sizeof(WalletBitmapDot));//40
																		Show_AscII_Picture(62,16,andBitmapDot,sizeof(andBitmapDot));//24
																		Show_AscII_Picture(90,16,keyBitmapDot,sizeof(keyBitmapDot));//24
																		Show_AscII_Picture(118,16,haveBitmapDot,sizeof(haveBitmapDot));//32
																		Show_AscII_Picture(154,16,beenBitmapDot,sizeof(beenBitmapDot));//32
																		Show_AscII_Picture(190,16,erasedBitmapDot,sizeof(erasedBitmapDot));//48
																#endif																
																}
														}
														else//密码错误
														{													
																Display_Usb();
																HID_DEL_ADDRESS_REP(ERR_USER_REFUSE,serialId,addressType);
																break;
														}
												}
												else//没有存储此地址
												{	
														Display_Usb();
														HID_DEL_ADDRESS_REP(ERR_UNKONW_ADD,serialId,addressType);
														break;
												}
										}
										else
										{
												Display_Usb();
												HID_DEL_ADDRESS_REP(ERR_UNKNOW_COIN,serialId,addressType);
												break;
										}
										break;
								}
								case CMD_ADD_ADDRESS:					//0x0204
								{
										uint16_t addressType = data[4] | (data[5] << 8);
										uint8_t add_decrypt[32];
										uint32_t len_aes;
										if(Neo_System.count == 5) //地址已满
										{
												Display_Usb();
												HID_ADD_ADDRESS_REP(ERR_KEY_MAX_COUNT,serialId,addressType,data+6);
												break;
										}
										if(addressType == ADDR_XiaoYi)
										{
												if(Get_Address_ID(data+6))//已经存在了这个地址
												{
														Display_Usb();
														HID_ADD_ADDRESS_REP(ERR_EXIST_KEY,serialId,addressType,data+6);
														break;
												}
												uint8_t	PrivateKey[32];
												uint8_t PublicKey[65];
												uint8_t	PubKey[33];
												int tempLen = 0;
												char temp[40] = "";
												char addrCacl[40] = "";
												
												//1 计算地址
												Alg_Base58Encode(data+6 , 25 ,temp,&tempLen);												
												//2 aes解密得到私钥
												STM32_AES_ECB_Decrypt(dataSave,32,secure_pipe.keyM,add_decrypt,&len_aes);
												if(len_aes != 32)
												{
														Display_Usb();
														HID_ADD_ADDRESS_REP(ERR_UNKONW_ADD,serialId,addressType,data+6);
														break;														
												}
												memmove(PrivateKey,add_decrypt,32);
												//3 私钥推出公钥										
												Alg_GetPublicFromPrivate(PrivateKey,PublicKey,1);
												memmove(PubKey,PublicKey,33);
												//4 公钥计算地址
												Alg_GetAddressFromPublic(PubKey,addrCacl,33);
#ifdef printf_debug
												printf("Address Prikey:%s\r\n",addrCacl);
#endif
												//5 比较地址
												if(ArrayCompare((uint8_t*)temp,(uint8_t*)addrCacl,tempLen))
												{
														uint8_t return_value = Display_AddAdd(addrCacl);
														if(return_value == NEO_USER_REFUSE)
														{
																Display_Usb();
																HID_ADD_ADDRESS_REP(ERR_USER_REFUSE,serialId,addressType,data+6);
																break;														
														}
														else if(return_value == NEO_TIME_OUT)
														{
																Display_Usb();
																HID_ADD_ADDRESS_REP(ERR_TIME_OUT,serialId,addressType,data+6);
																break;															
														}
														
														if(Display_VerifyCode() == 0)
														{
																Passport_Flag.flag.add_address = 1;
														}
														if(Passport_Flag.flag.add_address)
														{
																Passport_Flag.flag.add_address = 0;
																uint8_t slotID = Get_Empty_SlotID();
																uint8_t slot_data[32];
#ifdef printf_debug
																printf("slotID: %d\r\n",slotID);
#endif
																if(Neo_System.count == 0)
																		EncryptDataNew(PrivateKey,32,slotID+2,Neo_System.pin);
																else
																		EncryptData(PrivateKey,32,slotID+2,Neo_System.pin);
																memset(slot_data,0,32);
																memmove(slot_data,data+6,25);
																ATSHA_write_data_slot(slotID+7,0,slot_data,32);
																Neo_System.count++;
																Updata_SYS_Count(Neo_System.count);			 //更新计数的值
																memmove(showaddress[slotID-1].content,data+6,25);
																memmove(showaddress[slotID-1].address,addrCacl,tempLen);
																														
																Display_Usb();
																HID_ADD_ADDRESS_REP(1,serialId,addressType,data+6);
														}
														else
														{															
																Display_Usb();
																HID_ADD_ADDRESS_REP(ERR_SAME_ADD_NAME,serialId,addressType,data+6);															
														}
												}
												else//地址匹配失败
												{														
														Display_Usb();
														HID_ADD_ADDRESS_REP(ERR_KEY_FORMAT,serialId,addressType,data+6);
														break;
												}
										}
										else
										{
												Display_Usb();
												HID_ADD_ADDRESS_REP(ERR_KEY_FORMAT,serialId,addressType,data+6);
												break;
										}
										Display_Usb();
										break;
								}
								case CMD_SIGN_DATA:						//0x0205
								{
										uint8_t  AddressID = Get_Address_ID(data+6);
										uint16_t coin_type = data[4] | (data[5] << 8);
										if(!haveThisCoin(coin_type))
										{
												Display_Usb();
												HID_SIGN_DATA_FAILED_REP(ERR_UNKNOW_COIN,serialId);
												break;												
										}
 										if(AddressID)
										{
												STMFLASH_Erase_Sectors(FLASH_DATA_SECTOR);
												//写入现场数据
												STMFLASH_WriteWord(FLASH_ADDRESS_SCENE,(uint32_t)serialId);
												STMFLASH_WriteWord(FLASH_ADDRESS_SCENE+4,(uint32_t)AddressID);
												STMFLASH_Write_ByteArray(FLASH_ADDRESS_SCENE+8,data+6,32);
												//写入数据包及相关数据
												STMFLASH_WriteWord(FLASH_ADDRESS_PACK,HidData.dataLen);
												STMFLASH_Write_ByteArray(FLASH_ADDRESS_PACK+4,Neo_System.pin,8);
												STMFLASH_Write_ByteArray(FLASH_ADDRESS_PACK+12,dataSave,HidData.dataLen);
												//显示等待图标
												Fill_RAM(0x00);
												Show_Pattern(&gImage_wait[0],30,33,24,40);
												clearArea(120,40,16,1);
												jump_to_app(FLASH_ADDRESS_APP1);
										}
										else
										{
												Display_Usb();
												HID_SIGN_DATA_FAILED_REP(ERR_UNKNOW_KEY,serialId);
												break;
										}
								}
								case CMD_SET_INFO:						//0x021a
								{
										break;
								}
								case CMD_INSTALL_PACK:				//0x0301
								{
										uint16_t install_type = data[4] | (data[5] << 8);
										uint16_t install_cont = data[6] | (data[7] << 8);
										uint16_t version_coin = data[40] | (data[41] << 8);
										
										if(install_type != 0x0001)
												HID_INSTALL_PACK_REP(ERR_COIN_TYPE,serialId,install_type,install_cont,version_coin);
										if(coinrecord.count>=5)
												HID_INSTALL_PACK_REP(ERR_NO_SPACE_INSTALL,serialId,install_type,install_cont,version_coin);

										uint8_t hash_file[32];
										uint32_t Flash_Sector_Address = Get_Plugin_Write_Flash_Sector(install_cont);								
										if(plugin_flag == 2)
										{
												SHA256_Data(dataSave,HidData.dataLen+PC_SEND_PER_PACK_SIZE,hash_file,32);
										}
										else
										{		
												SHA256_Data(dataSave,HidData.dataLen,hash_file,32);
										}
										//hash对比
										if(ArrayCompare(data+8,hash_file,32) == 0)
										{
												HID_INSTALL_PACK_REP(ERR_DATA_HASH,serialId,install_type,install_cont,version_coin);
												plugin_flag = 0;
												break;
										}
										//ECDSA验证
										uint8_t signature[64];
										uint8_t input_hash[32];
										SHA256_Data(dataSave+65,HidData.dataLen+PC_SEND_PER_PACK_SIZE-65,input_hash,32);
										memmove(signature,dataSave+1,64);					
										if(Alg_ECDSASignVerify(public_key,signature,input_hash) == 0)
										{
												HID_INSTALL_PACK_REP(ERR_VERIFY_FAIED,serialId,install_type,install_cont,version_coin);
												plugin_flag = 0;
												break;												
										}
										//认证成功，开始处理数据
										if(Flash_Sector_Address == FLASH_ADDRESS_APP1)
										{
												coinrecord.coin1 = install_cont;
												coinrecord.version1 = version_coin;
												STMFLASH_Erase_Sectors(FLASH_SECTOR_APP1);
										}
										else if(Flash_Sector_Address == FLASH_ADDRESS_APP2)
										{
												coinrecord.coin2 = install_cont;
												coinrecord.version2 = version_coin;						
												STMFLASH_Erase_Sectors(FLASH_SECTOR_APP2);
										}
										else if(Flash_Sector_Address == FLASH_ADDRESS_APP3)
										{
												coinrecord.coin3 = install_cont;
												coinrecord.version3 = version_coin;		
												STMFLASH_Erase_Sectors(FLASH_SECTOR_APP3);
										}
										else if(Flash_Sector_Address == FLASH_ADDRESS_APP4)
										{
												coinrecord.coin4 = install_cont;
												coinrecord.version4 = version_coin;				
												STMFLASH_Erase_Sectors(FLASH_SECTOR_APP4);
										}
										else if(Flash_Sector_Address == FLASH_ADDRESS_APP5)
										{
												coinrecord.coin5 = install_cont;
												coinrecord.version5 = version_coin;		
												STMFLASH_Erase_Sectors(FLASH_SECTOR_APP5);
										}
										else
										{
												HID_INSTALL_PACK_REP(ERR_NO_SPACE_INSTALL,serialId,install_type,install_cont,version_coin);
												plugin_flag = 0;
												break;
										}
										STMFLASH_WriteHalfWord(Flash_Sector_Address+COIN_TYPE_OFFSET,install_cont);
										STMFLASH_WriteHalfWord(Flash_Sector_Address+COIN_VERSION_OFFSET,version_coin);
										STMFLASH_Write_ByteArray(Flash_Sector_Address,dataSave+65,HidData.dataLen+PC_SEND_PER_PACK_SIZE-65);
										PowerOn_PACKInfo_To_Ram();
										HID_INSTALL_PACK_REP(0,serialId,install_type,install_cont,version_coin);										
										
										plugin_flag = 0;
										break;
								}
								case CMD_INSTALL_REQUEST:			//0x0302
								{
										if(Display_Updata_Wallet())
										{
												//更改更新标识
												uint8_t slot_data[32];
												ATSHA_read_data_slot(14,slot_data);
												slot_data[1] = 1;
												ATSHA_write_data_slot(14,0,slot_data,32);
												HID_INSTALL_REQUEST_REP(1,serialId);
												HAL_Delay(500);
//												Deal_USB_ERROR();//重新配置下USB
												//重启回跳到BootLoader
												System_Reset();
										}
										else
										{
												HID_INSTALL_REQUEST_REP(0,serialId);
										}
										Display_Usb();
										break;
								}
								case CMD_UNINSTALL_PACK:			//0x0303
								{
										uint16_t install_type = data[4] | (data[5] << 8);
										if(install_type == coinrecord.coin1)
										{
												coinrecord.count--;
												coinrecord.coin1 = 0xFFFF;
												coinrecord.version1 = 0xFFFF;
												STMFLASH_Erase_Sectors(FLASH_SECTOR_APP1);
										}
										else if(install_type == coinrecord.coin2)
										{
												coinrecord.count--;
												coinrecord.coin2 = 0xFFFF;
												coinrecord.version2 = 0xFFFF;											
												STMFLASH_Erase_Sectors(FLASH_SECTOR_APP2);
										}
										else if(install_type == coinrecord.coin3)
										{
												coinrecord.count--;
												coinrecord.coin3 = 0xFFFF;
												coinrecord.version3 = 0xFFFF;											
												STMFLASH_Erase_Sectors(FLASH_SECTOR_APP3);
										}
										else if(install_type == coinrecord.coin4)
										{
												coinrecord.count--;
												coinrecord.coin4 = 0xFFFF;
												coinrecord.version4 = 0xFFFF;											
												STMFLASH_Erase_Sectors(FLASH_SECTOR_APP4);
										}
										else if(install_type == coinrecord.coin5)
										{
												coinrecord.count--;
												coinrecord.coin5 = 0xFFFF;
												coinrecord.version5 = 0xFFFF;
												STMFLASH_Erase_Sectors(FLASH_SECTOR_APP5);
										}
										else
										{
												HID_UNINSTALL_PACK_REP(ERR_COIN_TYPE,serialId,install_type);
										}
										HID_UNINSTALL_PACK_REP(0,serialId,install_type);
										break;
								}
								case CMD_SECU_PIPE:						//0x0401
								{
										uint8_t num[2] = {'0','\0'};
										uint8_t key_M_pub[64];
										char temp[40];
										int len;
										memset(temp,0,40);
										memset(&secure_pipe,0,sizeof(SECURE_PIPE));
										//1、生成随机数
										RandomArray(secure_pipe.randoma,32);
										//2、生成公钥
										Alg_ECCscalarMul(secure_pipe.randoma,NULL,secure_pipe.pubkeyA+1,0);
										secure_pipe.pubkeyA[0] = 4;
										//3、计算公钥hash
										SHA256_Data(secure_pipe.pubkeyA,65,secure_pipe.hashA,32);
										//4、Base58编码
										Alg_Base58Encode(secure_pipe.hashA,25,temp,&len);
										//5、显示前4位
										Fill_RAM(0x00);
										#ifdef Chinese										
												Show_HZ12_12(104,16,95,96);//安全
												Show_HZ12_12(136,16,5,5);//码
										#endif
										#ifdef English
												Show_AscII_Picture(82,16,SecurityBitmapDot,sizeof(SecurityBitmapDot));//56
												Show_AscII_Picture(142,16,codeBitmapDot,sizeof(codeBitmapDot));//32
										#endif
										num[0] = temp[0];
										Asc8_16(98,32,num);
										num[0] = temp[1];
										Asc8_16(114,32,num);
										num[0] = temp[2];
										Asc8_16(130,32,num);
										num[0] = temp[3];
										Asc8_16(146,32,num);
										//6、获取上位机的公钥
										memmove(secure_pipe.pubkeyB,dataSave+1,64);
										//7、计算对称加密aes256的key
										Alg_ECCscalarMul(secure_pipe.randoma,secure_pipe.pubkeyB,key_M_pub,1);
										memmove(secure_pipe.keyM+1,key_M_pub,31);
										secure_pipe.keyM[0] = 0x04;
										//8、通知上位机来要数据
										memset(dataSave,0,sizeof(dataSave));
										memmove(dataSave,secure_pipe.pubkeyA,65);
										HidData.reqSerial = RandomInteger();
										HID_SIGN_DATA_REP(CMD_NOTIFY_DATA,HidData.reqSerial,65,secure_pipe.hashA,32);
#ifdef HID_Delay
										HAL_Delay(HID_SEND_DELAY);
#endif										
										HID_SIGN_DATA_REP(CMD_SECU_PIPE_REP,serialId,65,secure_pipe.hashA,32);
										break;
								}
								case CMD_SECU_GET_PUBKEY:			//0x0402
								{
										uint8_t hash_pub[32];
										uint8_t key_M_pub[64];								
										Fill_RAM(0x00);
										Display_Usb();
										//1、获取上位机的公钥
										memmove(secure_pipe.pubkeyB,dataSave,64);
										//2、计算对称加密key
										Alg_ECCscalarMul(secure_pipe.randoma,secure_pipe.pubkeyB,key_M_pub,1);
										memmove(secure_pipe.keyM,key_M_pub,32);
										//3、回复上位机公钥的hash
										SHA256_Data(secure_pipe.pubkeyB,64,hash_pub,32);
										HID_SECU_GET_PUBKEY_REP(serialId,hash_pub);
										break;
								}
								case CMD_POWERON_BLE:
								{
										Power_ON_BLE();
										break;
								}
								case CMD_POWEROFF_BLE:
								{
										Power_OFF_BLE();
										break;
								}
								default:
								break;
						}
				}
				if(cmd == CMD_QUERY_PACK_INFO)								//0x0304
				{
						HID_QUERY_PACK_INFO_REP(serialId);
				}
		}
		else
		{
				HID_CRC_ERROR_REP(serialId);
#ifdef printf_debug				
				printf("crc error\r\n");
#endif			
		}
}


	
