NewEconoLab/NeoDun/单片机程序/NEODUN/Hardware/OLED281/Eng_pic.h

#ifndef ENG_PIC_H
#define ENG_PIC_H

/*************************************************************************************************************
图片检索：	xx*16
		a	8							A	8								About	40				Address	56			address	56	
		again	40				All	16						all	16					Allow	40				and	24
		any	24					APP	24						apps	32				Are	24					attempts	64	
		available	56		Back	32					be	16					been	32				below	40				Cancle	48
		cancel	48			changepin	64			change_pin	72	check	40				code	32
		confirm	48			Confirm	48				contain	48			data	32				did	24		
		Do 16						does	32					erase	40				erased	48			Erasing	48			ERROR		40
		firmware	56		Firmware	56			for	24					From	32				from 32					
		has	24					have	32					Help	32				help	32				Hide	32	
		hide空格	32		import	40				Importing	64		incorrect()	64	Incorrect 64
		in空格	16			irreversible	72	Isolate	48			is空格	16			It空格	16	
		key	24					keys	32					left	24				Manager	56			many空格 40			None		32		NoName		48
		match	40				NEODUN	48				new	24					not	24					official	48		OK			16
		only空格	32		our	24						PIN	24					PINs	24				Please 48				please	48
		procced	56			reimport	56			required	56		Reset	40				reset	40	
		Resetall	64		Security	56			seen	32				Send	32				set()	24
		Set	24					Settings	56			signed	48			successful	72	sure空格	32	
		the	24					this空格	32			to	16					Too	24					Transaction	80
		try	24					unhide空格	48		Unhide	48			update	48			using空格	40		uname		48
		Version	48			Visit	32					wallet	40			Wallet	40			want	32	
		website空格	56	welcome	64				will	24				www.neodun.com	112							You	24
		you	24					Your	32
*************************************************************************************************************/

//8 * 16
unsigned char aBitmapDot[] =
{
      0x00,0x00,0x00,0x00,0x3C,0x42,0x1E,0x22,
      0x42,0x42,0x46,0x3A,0x00,0x00,0x00,0x00
};

//8 * 16
unsigned char ABitmapDot[] =                  // 数据表
{
      0x00,0x00,0x10,0x10,0x28,0x28,0x44,0x44,
      0x7C,0x82,0x82,0x82,0x00,0x00,0x00,0x00
};

//40 * 16  
unsigned char AboutBitmapDot[] =                  // 数据表
{
      0x00,0x00,0x00,0x00,0x00,0x00,0x20,0x00,
      0x00,0x10,0x08,0x20,0x00,0x00,0x10,0x08,
      0x20,0x00,0x00,0x10,0x14,0x2C,0x0C,0x21,
      0x7E,0x14,0x32,0x12,0x21,0x10,0x22,0x21,
      0x21,0x21,0x10,0x22,0x21,0x21,0x21,0x10,
      0x3E,0x21,0x21,0x21,0x10,0x41,0x21,0x21,
      0x23,0x10,0x41,0x32,0x12,0x25,0x10,0x41,
      0x2C,0x0C,0x19,0x0E,0x00,0x00,0x00,0x00,
      0x00,0x00,0x00,0x00,0x00,0x00,0x00,0x00,
      0x00,0x00,0x00,0x00,0x00,0x00,0x00,0x00
};

//56 * 16 
unsigned char AddressBitmapDot[] =                  // 数据表
{
      0x00,0x00,0x00,0x00,0x00,0x00,0x00,0x00,
      0x01,0x01,0x00,0x00,0x00,0x00,0x08,0x01,
      0x01,0x00,0x00,0x00,0x00,0x08,0x01,0x01,
      0x00,0x00,0x00,0x00,0x14,0x0D,0x0D,0x2C,
      0xF0,0xF0,0xF0,0x14,0x13,0x13,0x31,0x09,
      0x09,0x08,0x22,0x21,0x21,0x21,0x08,0x80,
      0x80,0x22,0x21,0x21,0x21,0xF8,0x60,0x60,
      0x3E,0x21,0x21,0x21,0x00,0x10,0x10,0x41,
      0x21,0x21,0x21,0x00,0x08,0x08,0x41,0x13,
      0x13,0x21,0x09,0x09,0x08,0x41,0x0D,0x0D,
      0x20,0xF0,0xF0,0xF0,0x00,0x00,0x00,0x00,
      0x00,0x00,0x00,0x00,0x00,0x00,0x00,0x00,
      0x00,0x00,0x00,0x00,0x00,0x00,0x00,0x00,
      0x00,0x00,0x00,0x00,0x00,0x00,0x00,0x00
};

//56 * 16   
unsigned char addressBitmapDot[] =                  // 数据表
{
      0x00,0x00,0x00,0x00,0x00,0x00,0x00,0x00,
      0x02,0x02,0x00,0x00,0x00,0x00,0x00,0x02,
      0x02,0x00,0x00,0x00,0x00,0x00,0x02,0x02,
      0x00,0x00,0x00,0x00,0x3C,0x1A,0x1A,0x59,
      0xE1,0xE1,0xE0,0x42,0x26,0x26,0x62,0x12,
      0x12,0x10,0x1E,0x42,0x42,0x42,0x11,0x01,
      0x00,0x22,0x42,0x42,0x43,0xF0,0xC0,0xC0,
      0x42,0x42,0x42,0x42,0x00,0x20,0x20,0x42,
      0x42,0x42,0x42,0x00,0x10,0x10,0x46,0x26,
      0x26,0x42,0x12,0x12,0x10,0x3A,0x1A,0x1A,
      0x41,0xE1,0xE1,0xE0,0x00,0x00,0x00,0x00,
      0x00,0x00,0x00,0x00,0x00,0x00,0x00,0x00,
      0x00,0x00,0x00,0x00,0x00,0x00,0x00,0x00,
      0x00,0x00,0x00,0x00,0x00,0x00,0x00,0x00
};

//40 * 16
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
      0x22,0x18,0x42,0x58,0x22,0x24,0x42,0x60,
      0x14,0x42,0x42,0x40,0x08,0x42,0x42,0x40,
      0x08,0x42,0x42,0x40,0x08,0x42,0x46,0x40,
      0x08,0x24,0x4A,0x40,0x08,0x18,0x32,0x40,
      0x00,0x00,0x00,0x00,0x00,0x00,0x00,0x00,
      0x00,0x00,0x00,0x00,0x00,0x00,0x00,0x00
};


#endif
