NewEconoLab/NeoDun/单片机程序/NEODUN/Hardware/OLED281/Asc8X16.h

// ------------------  ASCII字模的数据表 ------------------------ //
// 码表从0x20~0x7e                                                //
// 字库:  实际点阵 8*16，字左对 8列 24行
// 取模：SSD1322控制器 横向取模左高位 
//开发者：www/lcdsoc.com
// -------------------------------------------------------------- //
unsigned char AscillIndexLen[] = {
		4,8,8,8,8,8,8,4,4,4,
		8,8,8,8,8,4,8,8,8,8,
		8,8,8,8,8,8,8,8,8,8,
		8,8,8,8,8,8,8,8,8,8,
		8,8,8,8,8,8,8,8,8,8,
		8,8,8,8,8,8,8,8,8,4,
		8,4,8,4,4,8,8,8,8,8,
		8,8,8,4,4,8,4,8,8,8,
		8,8,8,8,8,8,8,8,8,8,
		8,4,8,4,8,8
};

int AscillIndexNum[] = {
    0,			8,	24,	 40,	56,	 72,	88,	104, 112, 120,
		128,	144, 160, 176, 192, 208, 216, 232, 248, 264,
		280,	296, 312, 328, 344, 360, 376, 392, 408, 424,
		440,	456, 472, 488, 504, 520, 536, 552, 568, 584,
		600,	616, 632, 648, 664, 680, 696, 712, 728, 744,
		760,	776, 792, 808, 824, 840, 856, 872, 888, 904,
		912,	928, 936, 952, 960, 968, 984,1000,1016,1032,
		1048,1064,1080,1096,1104,1112,1128,1136,1152,1168,
		1184,1200,1216,1232,1248,1264,1280,1296,1312,1328,
		1344,1360,1368,1384,1392,1408
};

unsigned char  ASC8X16[] =
{
	0x00,0x00,0x00,0x00,0x00,0x00,0x00,0x00,  // - -
	
	0x00,0x00,0x20,0x20,0x20,0x20,0x20,0x20,  // -!-
	0x20,0x00,0x20,0x20,0x00,0x00,0x00,0x00,

	0x00,0x24,0x24,0x24,0x00,0x00,0x00,0x00,  // -"-
	0x00,0x00,0x00,0x00,0x00,0x00,0x00,0x00,

	0x00,0x00,0x00,0x6C,0x6C,0xFE,0x6C,0x6C,  // -#-
	0x6C,0xFE,0x6C,0x6C,0x00,0x00,0x00,0x00,

	0x08,0x08,0x3C,0x4A,0x4A,0x48,0x3C,0x0A,  // -$-
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

	0x00,0x00,0x00,0x00,0x42,0x42,0x42,0x24,  // -v-
	0x24,0x24,0x18,0x18,0x00,0x00,0x00,0x00,

	0x00,0x00,0x00,0x00,0x41,0x49,0x49,0x49,  // -w-
	0x55,0x55,0x22,0x22,0x00,0x00,0x00,0x00,

	0x00,0x00,0x00,0x00,0x42,0x24,0x24,0x18,  // -x-
	0x18,0x24,0x24,0x42,0x00,0x00,0x00,0x00,

	0x00,0x00,0x00,0x00,0x42,0x24,0x24,0x24,  // -y-
	0x18,0x18,0x18,0x10,0x10,0x10,0x60,0x00,

	0x00,0x00,0x00,0x00,0x7E,0x02,0x04,0x08,  // -z-
	0x10,0x20,0x40,0x7E,0x00,0x00,0x00,0x00,

	0x00,0x24,0x44,0x84,0x44,0x42,0x00,0x00,  // -{-

	0x00,0x00,0x18,0x18,0x18,0x18,0x00,0x18,  // -|-
	0x18,0x18,0x18,0x18,0x00,0x00,0x00,0x00,

	0x00,0x42,0x22,0x12,0x22,0x24,0x00,0x00,  // -}-

	0x00,0x00,0x28,0x50,0x00,0x00,0x00,0x00,  // -~-
	0x00,0x00,0x00,0x00,0x00,0x00,0x00,0x00,

	0x00,0x00,0x00,0x00,0x10,0x38,0x6C,0xC6,  // --
	0xC6,0xC6,0xFE,0x00,0x00,0x00,0x00,0x00
};
