NewEconoLab/NeoDun/单片机程序/NEODUN/Hardware/OLED281/bmp.h

//////////////////////////////////////////////////////////////////////////////////	 
// M31S1322_STM32_01 DEMO ͼƬ
//********************************************************************************

#ifndef __BMP_H
#define __BMP_H

//32*32像素  设置图标
unsigned char gImage_Set[512] = { /* 0X00,0X04,0X20,0X00,0X20,0X00, */
0X00,0X00,0X00,0X00,0X00,0X00,0X00,0X00,0X00,0X00,0X00,0X00,0X00,0X00,0X00,0X00,
0X00,0X00,0X00,0X00,0X00,0X00,0X00,0X00,0X00,0X00,0X00,0X00,0X00,0X00,0X00,0X00,
0X00,0X00,0X00,0X00,0X00,0X00,0X00,0X00,0X00,0X00,0X00,0X00,0X00,0X00,0X00,0X00,
0X00,0X00,0X00,0X00,0X00,0X00,0X00,0X00,0X00,0X00,0X00,0X00,0X00,0X00,0X00,0X00,
0X00,0X00,0X00,0X00,0X00,0X00,0X00,0X00,0X00,0X00,0X00,0X00,0X00,0X00,0X00,0X00,
0X00,0X00,0X00,0X00,0X00,0X00,0X00,0X00,0X00,0X00,0X00,0X00,0X00,0X00,0X00,0X00,
0X00,0X00,0X00,0X00,0X00,0X00,0X00,0X00,0X00,0X00,0X00,0X00,0X00,0X00,0X00,0X00,
0X00,0X00,0X00,0X00,0X00,0X00,0X08,0XFF,0XFF,0X80,0X00,0X00,0X00,0X00,0X00,0X00,
0X00,0X00,0X00,0X00,0X00,0X00,0X0C,0XFF,0XFF,0XC0,0X00,0X00,0X00,0X00,0X00,0X00,
0X00,0X00,0X00,0X00,0X07,0X50,0X0B,0XFF,0XFF,0XB0,0X05,0X70,0X00,0X00,0X00,0X00,
0X00,0X00,0X00,0X00,0X5F,0XFA,0X6E,0XFF,0XFF,0XE6,0XAF,0XF5,0X00,0X00,0X00,0X00,
0X00,0X00,0X00,0X00,0XEF,0XFF,0XFF,0XFF,0XFF,0XFF,0XFF,0XFE,0X00,0X00,0X00,0X00,
0X00,0X00,0X00,0X08,0XFF,0XFF,0XFF,0XFF,0XFF,0XFF,0XFF,0XFF,0X80,0X00,0X00,0X00,
0X00,0X00,0X00,0X0F,0XFF,0XFF,0XFF,0XC6,0X6C,0XFF,0XFF,0XFF,0XF0,0X00,0X00,0X00,
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
0X00,0X00,0X00,0X00,0X00,0X00,0X00,0X00,0X00,0XFF,0XFF,0XFF,0X0F,0XFF,0X0F,0X0F,
0XFF,0XFF,0XF0,0XFF,0X0F,0XFF,0X0F,0X0F,0X00,0XFF,0XFF,0XFF,0X00,0X00,0X00,0X00,
0X00,0X00,0X00,0X00,0X00,0X00,0X00,0X00,0X00,0X00,0X00,0X00,0X00,0X00,0X00,0X00,
};


#endif
