NewEconoLab/NeoDun/单片机程序/NEODUN/Hardware/OLED281/Asc6X12.h

// ------------------  ASCII字模的数据表 ------------------------ //
// 码表从0x20~0x7e                                                //
// 字库:  实际点阵 6*12，字左对齐共6列，右空2列，合计8列 12行
// 取模：SSD1322控制器 横向取模左高位 
// 开发者：www/lcdsoc.com
// -------------------------------------------------------------- //
unsigned char ASC6X12[] =              // ASCII
{
	0x00,0x00,0x00,0x00,0x00,0x00,0x00,0x00,  // - -
	0x00,0x00,0x00,0x00,

	0x00,0x10,0x10,0x10,0x10,0x10,0x00,0x00,  // -!-
	0x10,0x00,0x00,0x00,

	0x00,0x6C,0x48,0x48,0x00,0x00,0x00,0x00,  // -"-
	0x00,0x00,0x00,0x00,

	0x00,0x14,0x14,0x28,0x7C,0x28,0x7C,0x28,  // -#-
	0x50,0x50,0x00,0x00,

	0x00,0x10,0x38,0x40,0x40,0x38,0x48,0x70,  // -$-
	0x10,0x10,0x00,0x00,

	0x00,0x20,0x50,0x20,0x0C,0x70,0x08,0x14,  // -%-
	0x08,0x00,0x00,0x00,

	0x00,0x00,0x00,0x18,0x20,0x20,0x54,0x48,  // -&-
	0x34,0x00,0x00,0x00,

	0x00,0x10,0x10,0x10,0x10,0x00,0x00,0x00,  // -'-
	0x00,0x00,0x00,0x00,

	0x00,0x08,0x08,0x10,0x10,0x10,0x10,0x10,  // -(-
	0x10,0x08,0x08,0x00,

	0x00,0x20,0x20,0x10,0x10,0x10,0x10,0x10,  // -)-
	0x10,0x20,0x20,0x00,

	0x00,0x10,0x7C,0x10,0x28,0x28,0x00,0x00,  // -*-
	0x00,0x00,0x00,0x00,

	0x00,0x00,0x10,0x10,0x10,0xFC,0x10,0x10,  // -+-
	0x10,0x00,0x00,0x00,

	0x00,0x00,0x00,0x00,0x00,0x00,0x00,0x18,  // -,-
	0x10,0x30,0x20,0x00,

	0x00,0x00,0x00,0x00,0x00,0x7C,0x00,0x00,  // ---
	0x00,0x00,0x00,0x00,

	0x00,0x00,0x00,0x00,0x00,0x00,0x00,0x30,  // -.-
	0x30,0x00,0x00,0x00,

	0x00,0x04,0x04,0x08,0x08,0x10,0x10,0x20,  // -/-
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

	0x00,0x10,0x10,0x10,0x10,0x10,0x10,0x10,  // -|-
	0x10,0x10,0x00,0x00,

	0x00,0x20,0x10,0x10,0x10,0x10,0x08,0x10,  // -}-
	0x10,0x10,0x20,0x00,

	0x00,0x00,0x00,0x00,0x00,0x24,0x58,0x00,  // -~-
	0x00,0x00,0x00,0x00,

	0x00,0x00,0x00,0x00,0x00,0x24,0x58,0x00,  // --
	0x00,0x00,0x00,0x00,
};
