NewEconoLab/NeoDun/(commit log)

2017-12-01 NEO盾内测1.0
    各部分测试通过，待联调
    [223242-300_1.sldprt, FH19C-30S-0.5SH_1.sldprt, IO引脚表_20170915.xlsx, MB-PCB_1.sldasm, MB-PCB_1.sldprt, NEO-01.SLDDRW, NEO-01.SLDPRT, NEO-02.SLDPRT]
2017-12-13 说明文档更新
    各部分说明文档与元器件规格书
    [NEO_FPC_V1.0_0925.xls, NEO_MB_V1.0_0915.pcb, NEO_MB_V1.0_0925.xls]
2018-04-08 删除密码验证和获取密钥的功能
2018-04-09 传输bin
2018-04-09 发送对称加密的密码
2018-04-10 传输改成非对称加密
2018-04-11 通讯协议更新
    更新通讯协议V1.1
2018-04-16 fix error length for signature
    [app_command.c, app_ecdsa.h, main_define.h]
2018-04-20 change publickey and fix usb bug
    [app_command.c, app_interface.c, app_interface.h, main.c]
2018-04-28 rebuild stm32 app
2018-04-28 暂存更新
2018-05-02 更新通讯协议
    更新通讯协议
    [NEO-01.STEP, NEO-02.STEP, NEO-03.STEP, NEO-04.STEP, NEO-05.STEP, NEO-06.STEP, NEO12.26外发加工件.xls]
2018-05-02 查询地址名称
    查询地址的协议增加名称，地址名称限制在12个字节
2018-05-04 添加一些依赖库
2018-05-07 增加错误码
    各种报错协议增加错误码
2018-05-07 增加协议号
    流程上增加协议号
2018-05-07 界面
    界面流程改动
2018-05-07 导入钱包流程及页面
2018-05-08 更新通讯协议
    精简回复类协议内容
2018-05-08 分包
    增加分包传输数据信息
2018-05-08 修改导入钱包先出画面再刷数据 修复删除地址后地址列表显示不正确的bug
2018-05-10 修改固件更新
2018-05-10 取消bootloader的串口监听
2018-05-10 继续添加功能
2018-05-15 修复背景框白边的问题
2018-05-15 基本完成插件的安装跟新卸载流程
2018-05-16 排版
    增加标题导航
2018-05-16 等待过程不能点击
2018-05-17 错误码
    错误码
    [统一错误码.xlsx]
2018-05-19 增加安装固件之后的事件回调
2018-05-20 api层完成
2018-05-20 添加一些异常流程的处理
2018-05-22 修复诺干bug
2018-05-23 增加名字修改功能 以及优化页面显示
2018-05-30 更改FPC和按键设计
    更改FPC和拨动按键设计
    [NEO-05.STEP, NEO触摸按键.dxf]
2018-06-04 超时时间改成60s
2018-06-06 fix bug
    [统一错误码.xlsx]
2018-06-10 24助记词功能添加
2018-06-12 修改锁的默认状态为false
2018-06-14 fix sign data bug
    [OledMenu.c, OledMenu.h, app_command.c, app_interface.c, app_oled.c, aw9136.h, bmp.h]
2018-06-25 增加0303
    增加0303错误
    [统一错误码.xlsx]
2018-07-02 修复app更新时版本号在协议中位置不正确的问题；将remoteid改成uint32
2018-07-09 卸载插件时指定卸载什么插件
2018-07-09 修复再没有打开相关页面时，调用错误弹框会异常的问题
2018-07-12 版本信息和bin文件上服务器
2018-07-12 更改从服务器获取到的文件的解析方式
2018-07-13 签名时会返回地址的昵称
2018-07-19 fix bug and improve stability
    [CMD.h, OledMenu.c, OledMenu.h, app_command.c, app_ecdsa.c, app_hal.c, app_hal.h]
2018-07-27 修改签名时的数据错误
2018-08-07 安全通道相关通讯增加；验证公钥页面
2018-08-07 更改更新固件现成不同步问题
2018-08-09 升级插件时增加版本信息
2018-08-10 升级插件时版本号下发bug修复
2018-08-10 安全通道的功能增加
2018-08-13 更改安全通道
    更改安全通道
2018-08-14 增加安全通道的关闭按钮
2018-08-21 中英文的功能增加，页面上已经替换完成
2018-08-28 中英文切换
2018-09-05 默认下载对应语言的bin文件
2018-09-05 根据系统语言进行中英文切换
2018-09-29 固件安装的指令无视锁
2018-10-08 Revert "固件安装的指令无视锁"
    This reverts commit 34ab15f5abc3bd62a29fdb025b1f6a345dbb631f.
